feihong9487/WRO2026/簡報/簡報圖片/DSC02916-scaled-e1593505494115.jpg

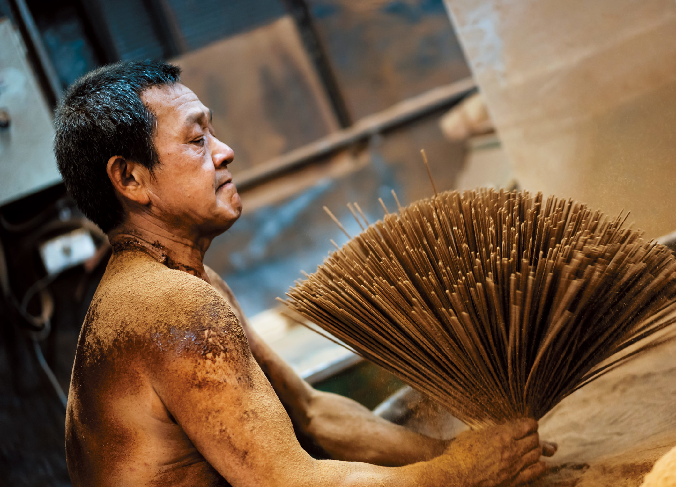
簡報/簡報圖片/DSC02916-scaled-e1593505494115.jpg
