feihong9487/WRO2026/簡報/Manus包_三張A1海報/圖表_情境照/86CD72FB487520FEE5B68408F628E1033E8C307C_size99_w1080_h721.jpeg

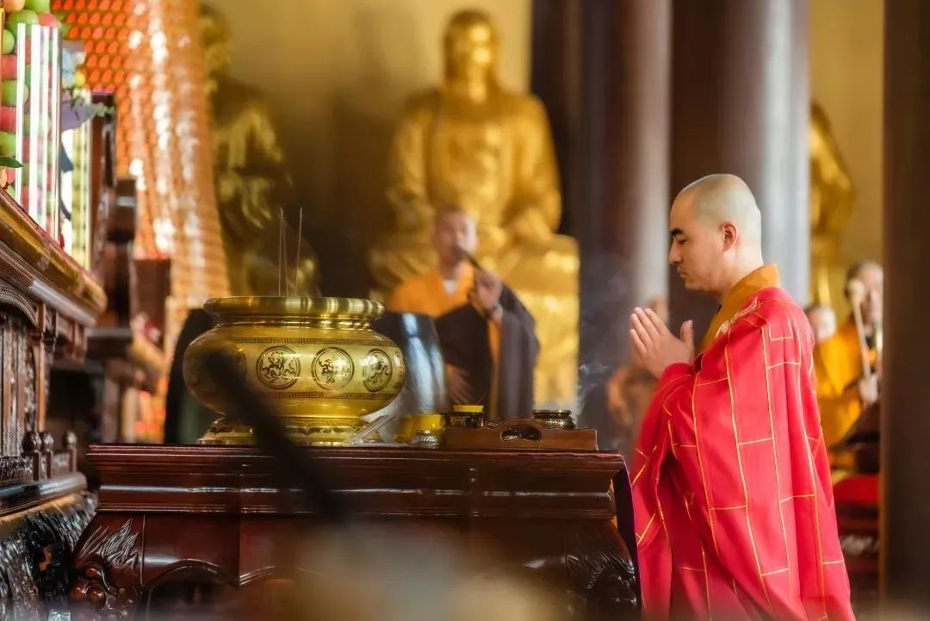
簡報/Manus包_三張A1海報/圖表_情境照/86CD72FB487520FEE5B68408F628E1033E8C307C_size99_w1080_h721.jpeg
