feihong9487/WRO2026/AI訓練/README.md

# AI訓練 — 模擬反應環境

> ★本目錄所有輸出皆為**模擬**，依 CLAUDE.md §7 誠實一致性，任何數字
> 不得寫成實測結果，展示與報告必須標示「模擬環境」。★

實作研究日誌第 17 週「四層解耦」架構的 **L3（0-D 質量平衡＋煙羽擴散）
＋ L4（訓練介面）**。CFD 屬 L1、離線做罩體幾何比選，**不進訓練迴路**
（D15：CFD-in-the-loop 需 913 年；F7：BFS 環境梯度為零已被否決）。

## 檔案

| 檔案 | 內容 |
|---|---|
| `sim_config.py` | 全部參數（單一真相來源；EST＝未實測估計，附域隨機化範圍） |
| `plume.py` | **線香煙霧擴散模型**：煙羽上升 w∝N^⅓（第 17 週 Zukoski）、擴張錐 db/dz=0.14（第 20 週）、橫流偏移＋側裙衰減（B8）→ 幾何×速度推導捕集率 η |
| `visitors.py` | 日曆驅動香客負載（初一/十五、週末、節慶、進香團；近似農曆） |
| `plant.py` | 近場/遠場雙區質量平衡＋CO2＋爐溫＋安全聯鎖（同 R4 韌體行為） |
| `incense_env.py` | gym 風格 `reset()/step()`＋感測器模型＋第 15 週損失函數＋`DualAscent` 對偶上升 |
| `baselines.py` | 基線：定速／實機 FSM 忠實移植／PID（**無基線則無法宣稱 AI 有貢獻**，§5.2 第 8 項） |
| `run_demo.py` | 四種基線跑 7 天的對照表 |
| `驗證環境.py` | 自檢：解析錨點、煙羽對表、跨層常數一致、F7 梯度檢驗、資源限制、誠實檢查 |
| `文獻參數.md` | **文獻校正對照表**（Jetter 2002 排放因子、Persily 2017 CO₂、沉降率、MTT 擴張率、PMS 偏差——各附出處與證據等級） |
| `模型方案.md` | 三案模型方案＋**凍結評估協定**（2026-08-16） |
| `policies.py` | 部署級推論（純 stdlib）：A 線性、C MLP、B 預測+DP、強基線日曆規則 |
| `訓練A.py` / `訓練B.py` / `訓練C.py` | 三案訓練器（筆電端可用 numpy；產物一律 JSON 到 `models/`） |
| `評比.py` | 凍結協定的執行檔（10 驗證 seed × 3 天 × 域隨機化） |
| `驗證線上學習.py` | 線上學習服務自檢：特徵同構（vs Pi 端 ShadowAdvisor）、守門條款、異常偵測單元檢查 |
| `外部資料驗證.py` | UCI 864 公開資料集對兩 AI 核心機制之獨立驗證（V1 pass／V2 inconclusive／V3 pass） |
| `加速實驗.py` | 真實資料模型擴充四實驗：E2 部署版 ridge 勝挑戰者、E3 模擬先驗幫倒忙、E4 故障注入靈敏度、粒度 A/B（30 分鐘粒度 −7.7% MAE，已升級進服務） |
| `ACH反演.py` | 真實 CO₂ 衰減段反演換氣率：8 段中位 1.21/h（居家資料推估非實測；同數學已進線上服務 v5 的通風追蹤） |
| `訓練C_v4.py` / `訓練C_v4b.py` | C 案算力實驗：×24 算力塌縮（v4）→ 熱啟動修正僅雜訊級改善（v4b）→ 維持 v3；結論見《優化實驗_C案算力.md》 |

## 快速開始

```bash
python 驗證環境.py     # 先自檢（任何修改後都要重跑）
python run_demo.py     # 基線對照
python run_demo.py --dr  # 域隨機化版
```

訓練迴圈骨架（純介面示意；RL 套件自選，環境本身零相依）：

```python
from incense_env import IncenseEnv, DualAscent

env = IncenseEnv(randomize=True)          # 域隨機化＝第 19 週 sim-to-real 對策
dual = DualAscent(["noise", "h_vis"], alpha=0.5)
for episode in range(n_episodes):
    obs, done = env.reset(seed=episode), False
    g_sum = {"noise": 0.0, "h_vis": 0.0}; steps = 0
    while not done:
        a = policy(env.obs_vector(obs))          # 只准看 obs（感測值）
        obs, r, done, info = env.step(a)
        loss = -r + dual.penalty(info["g"])      # 硬約束走對偶罰項
        for k in g_sum: g_sum[k] += info["g"][k]
        steps += 1
        # ...存 (obs, a, -loss) 進 replay buffer...
    dual.update({k: v / steps for k, v in g_sum.items()})   # λ ← max(0, λ+αḡ)
```

## 風扇規格（2026-08-16 使用者指定）

訓練調控風扇＝**建準 SUNON 4020**（40×40×20 mm、DC12V、PWM、磁浮軸承），
**安裝於罩口**。未指定型號檔位——`sim_config.py` 以家族典型中值建模
（工作點風量 12 m³/h、全速約 30 dBA、約 1 W、最低啟轉 duty ≈10%），
全部標 EST，拿到 datasheet 與 P–Q 實測（§5.2 實驗 1）後回填。
4 線 PWM 直控順帶解掉兩個舊待辦：490 Hz 嘯叫（PWM 走控制線非電源線）
與轉速回授（FG/tach 線）。

**此規格帶來的政權變更**（模擬已反映）：磁浮扇全速 ~30 dBA « 45 dBA 上限、
最大面風速 0.13 m/s < 單支煙羽速度 0.40 m/s → **噪音與文化兩條硬約束
天然滿足、不再是主動約束**；「有香就全速」成為合法邊界解，
學習的價值轉移到**時間軸排程**：沒香該關（能耗/濾材/平滑）、
香要來該先開（初一十五與 CO2 前饋的預測性啟動）。

### ★設計張力（誠實記錄，非本目錄能解，需人決策）★

1. **風量缺口**：4020 工作點約 6–22 m³/h，D26 規格為 43.3 m³/h——
   模擬顯示單顆全速常開僅將超標時率 54.6%→48.7%（模擬值）。
   選項：接受較低 η／多顆並聯／保留 5015 鼓風機於濾箱、4020 只做罩口助抽。
2. **靜壓不足**：濾鏈初始壓損約 165 Pa（紗網 5＋HEPA 120＋活性碳 40），
   4020 軸流靜壓僅數十 Pa——**單靠 4020 推不動濾鏈**，若它是唯一風扇，
   過濾段需另行驅動或重新設計。
3. **D13 被推翻**：原決策「風扇置於過濾鏈之後（扇葉不吃香灰油煙）」；
   罩口安裝＝扇葉直接暴露於煙流與火星。磁浮軸承耐汙較佳但扇葉積垢
   仍在，且**金屬紗網（火星前濾）應前移到風扇之前**——FILTER_CHAIN
   順序紅線不動，但「紗網相對風扇的位置」需要重新拍板。
4. **面風速均勻性**：40 mm 扇盤對 180 mm 罩口，流場集中於中心——
   本模型的均勻面風速假設對此配置不確定度最大（§5.2 實驗 7 的量測項）。

## 設計要點（皆有日誌出處）

1. **損失函數＝第 15 週定義**：暴露線性（扣 C_bg、無閾值）＋超標二次；
   能耗 u³（風扇相似定律）；濾材 u（壽命∝總風量）；平滑 Δu²（變動噪音
   比穩定噪音更干擾）。
2. **文化與噪音是硬約束**（D11）：h_vis ≥ h_spec 與 SPL ≤ 45 不進權重，
   違反量走 `info["g"]`，由 `DualAscent` 處理——把它們改成固定權重
   ＝重犯日誌已否決的錯誤。
3. **策略只看感測值**：`obs` 含雜訊、5 s 更新、延遲與失聯；真值在 `info`
   只准診斷。近場濃度**沒有感測器**——跟實機一樣。
4. **安全聯鎖屬於環境**：CO2>1500→全速、超溫→停機（同韌體），策略蓋不過；
   訓練出的策略必須在聯鎖存在下仍表現好。
5. **域隨機化**（第 19 週）：η、排放因子（7–100 log-uniform）、ACH、C_bg、
   感測延遲，加上煙羽（db/dz、源徑）與橫流／側裙（SKIRT_ATTEN 下探 1.0
   ＝側裙完全失效的 B8 惡夢情境）。**策略不得依賴任一估計值的精確度。**

## 有限資源訓練（2026-08-16 使用者裁示）

AI 在**有限電量與算力**下訓練反應策略：

- **電量**：`ENERGY_WH_DAY`（預設 4 Wh/日）——4020 全速 1 W，預算只夠
  全速 4 小時；耗盡則風扇物理斷電（CO₂ 警報也吹不動），午夜重置。
  電量剩餘比例在 obs（`battery`）。這使「有香就全速」不再可行，
  策略必須把 Wh 分配到暴露削減報酬最高的時段（尖峰排程問題）。
  市電情境設 `ENERGY_WH_DAY = None` 即回到無限電量。
- **算力**：屬訓練紀律而非物理模型——策略必須能在 Pi 5 以 1 Hz 推論
  （查表／線性／小型網路，參數量 <10⁴），obs 維持 11 維精簡向量；
  R4 本地 FSM 的降級路線不受 AI 影響（Pi 失聯照樣接手）。

## 誠實承諾（第 19 週，預先寫下）

> 若 RL 未優於 PID／FSM 基線，**接受此結果並如實報告**。
> 「證明簡單方法已足夠」是有效的工程結論，勝於勉強宣稱。

## 實測後要回填的參數（對照 §5.2 實驗清單）

| 實驗（§5.2） | 回填 `sim_config.py` |
|---|---|
| 0 側裙橫流衰減 | `SKIRT_ATTEN`、`U_CROSS_MEAN` |
| 1 風扇 P–Q（4020 實測） | `Q_MAX_M3H`、`FAN_MIN_DUTY`、`FAN_P_MAX_W`（現為家族典型值） |
| 2 煙羽擴張率 | `DB_DZ` |
| 3 爐盆有效源徑 | `DS_M` |
| 4 特性曲線 η/h/SPL | `ETA_GEO`、`ETA_A`、`SPL_*`、`plume.h_visible` |
| 6 排放因子 | `EF_MG_PER_STICK` |

回填實測值時同步收窄 `RAND_RANGES`（量過的參數不確定度變小），
並在本 README 記錄日期與出處——這是 `*_MEASURED` 紀律在模擬端的對應。
