feihong9487/WRO2026/待辦_DS18B20部署.md

# DS18B20 上線進度與待辦（2026-08-12）

> DS18B20 接在 R4 的 **A2 埠**，正式韌體已燒錄、實機確認有值。
> 剩下 Pi 端與雲端兩步沒做完，資料還上不了儀表板。

---

## 背景：08-12 的 R4 卡死事件

- telemetry 自 **08-11 21:40** 中斷，Pi 的 `pi_fsm.py` 之後每秒回報 `SENSOR_STALE`
- USB 枚舉還活著（`/dev/ttyACM0` 仍在），所以 `usb-watchdog` 沒觸發——
  它只檢查裝置存在，判不出「枚舉在但主迴圈死了」
- OLED 凍結＝整個主迴圈卡死（顯示、感測、telemetry 同一個 loop）
- 已由使用者手動修復並重燒韌體

## 已完成

| 項目 | 狀態 |
|---|---|
| 韌體 `R4/matrix_mini_r4/matrix_mini_r4.ino` 加 DS18B20（A2 埠、1 Hz 非同步、JSON 欄位 `t_ds`、OLED 顯示） | ✅ 已燒錄、實機有值 |
| 筆電端 `PI5/pi_fsm.py` 轉發白名單加 `t_ds` | ✅ 改好（僅筆電副本） |
| `cloud_dash/dashboard_aroma01_public.json`＋`grafana_dashboard_fleet.json`：爐面溫度 stat＋timeseries 改查 `sensor`/`t_ds`，標題改「爐面溫度（DS18B20）」 | ✅ 改好（僅本機檔案） |
| `驗證韌體.py`／`驗證資料流.py`／arduino-cli 編譯 | ✅ 全過 |

接線註記：DS18B20 **不能插 D1**——D1 左（腳 3）是風扇 PWM、右（腳 2）是
MAX6675 CS；函式庫 `MXOnewireDT` 用埠的左腳。A1/A2 是僅存空埠。
aroma02 是模擬機、沒有 `t_ds`，儀表板未動。

## ★待辦（照順序）★

### 1. ✅ 更新 Pi 上的 `pi_fsm.py`（2026-08-18 確認完成）

- 筆電公鑰已裝進 Pi，`ssh root@100.88.179.95` 金鑰登入可用
  （feihong@＋密碼其實也通，之前寫的「denied」已過時）
- Pi 上 `/opt/incense/pi_fsm.py` 與筆電版 MD5 一致（`92e42269…`），
  不需再 scp——先前某次已部署過
- 實測 MQTT `incense/sensor` 每秒有 `t_ds`（約 31°C），InfluxDB 查得到

### 2. 雲端 Grafana 重新匯入兩份 JSON（**未完成：家裡 PC 連不上**）

- 位置：家裡 PC 的 Grafana `http://100.73.36.75:3000`（WSL 容器）
- 2026-08-18 嘗試時整台逾時——PC 沒開機或 Tailscale 掉了，開機後再做
- `admin` 登入 → Dashboards → Import → 上傳
  `cloud_dash/dashboard_aroma01_public.json` 與 `grafana_dashboard_fleet.json`
  → 勾「覆蓋既有」（uid 相同，公開連結不會失效）
- 密碼由使用者保管

### 3. ✅ Pi 本地 Grafana（2026-08-18 完成）

- `PI5/grafana_dashboard_incense.json` 已把「爐面溫度」stat＋timeseries
  改查 `sensor`/`t_ds`（比照雲端版），經 API 匯入 Pi Grafana 覆蓋 `incense-main`
- 用面板同款 Flux 查詢驗證：`t_ds` 最新值 31.12°C ✓
- 面板實際顯示畫面需由人開 `100.88.179.95:3000` 目視確認

---

_只剩待辦 2：家裡 PC 開機後匯入兩份雲端 JSON，公開面板的「爐面溫度（DS18B20）」就會有資料。_
