feihong9487/WRO2026/軟硬體優化報告書.md

# 軟硬體優化報告書

> 2026-08-16。與《後續研究與優化方向建議書》分工：那一本管**研究與量測**
> （做什麼實驗、怎麼發表），本書管**工程優化**——現有軟硬體哪裡可以改、
> 怎麼改、代價與效益。每項標註出處（B 編號＝日誌 §5.1 阻塞表）。
> 標【拍板】者屬設計取捨，需人決定，本書只列選項。

---

## 第一章｜硬體優化

### 1.1 抽排與風扇（最高優先，對應 B10）

**現況**：SUNON 4020 磁浮 PWM 已定為罩口調控風扇；但工作點約 12 m³/h
對規格 43.3 m³/h 有缺口、靜壓推不動 165 Pa 濾鏈、且與 D13「風扇置濾後」
矛盾（扇葉暴露於煙流火星）。

| 優化項 | 做法 | 效益 | 代價 |
|---|---|---|---|
| **雙級抽排架構**【拍板】 | 4020 於罩口做「捕集助抽」＋既有 5015 鼓風機於濾箱做「主抽過濾」——4020 負責把煙送進罩、5015 負責推過濾鏈 | 同時解決風量缺口與靜壓不足；AI 控 4020、5015 隨動或定速 | BOM +1 風扇、兩路控制（韌體現僅 1 路 PWM，見 2.1） |
| 金屬紗網前移至 4020 之前 | 罩口即裝紗網（FILTER_CHAIN 順序不變，僅位置前移） | 火星不進扇葉；4020 積垢減緩 | 罩口開口阻力略增；紗網清潔頻率提高 |
| 4020 型號檔位選定 | 取 datasheet 的 P–Q 曲線與啟轉 duty，回填 `sim_config.py` 並收窄隨機化 | 模擬與訓練精度直接提升 | 零成本，只差型號資訊 |
| 面風速均勻化導流 | 40 mm 扇盤對 180 mm 罩口，於罩內加十字導流肋或擴壓錐（3D 列印件） | 提高有效捕集面積（目前模型最大不確定處） | 需一輪列印迭代＋發煙目視 |

### 1.2 罩體與側裙

- **罩口 200→215 mm**【拍板，B9】：橫流餘裕 +23%＋ACGIH 合規；
  代價整機 +15 mm、阻力 +38 Pa。建議等側裙 mockup 數據一起定。
- **側裙迭代**（B8，全案最高風險）：紙板 mockup 先行；若衰減不足依序
  試（a）加高／改角（b）罩口放大（c）可拆擋風簾。
- **可製造性**：34° 自撐倒錐已驗證；下一步把側裙也收斂到免支撐角度。

### 1.3 濾鏈

- 壓損實測（初期／壽末）→ 定換濾週期與雙級架構的 5015 工作點。
- 活性碳突破曲線實驗 → 「按狀態換」訂閱的科學依據（詳建議書第 2 項）。
- 濾箱氣密檢查制度化（D13 抽拉式的前提）。

### 1.4 感測

- **Grove 2.0 mm 轉接線**（B1）：到貨即解 SCD41——所有真實資料的閘門。
- **PMS5003 到貨後**：與重量法共檢建立校正斜率（模擬已依文獻改為
  雙向 0.5–1.5×，實測後收窄）。
- **近場感測缺口**：獎勵主項（爐邊暴露）目前不可觀測。可評估在罩緣
  加第二顆低成本 PM 感測器——sim-to-real 最脆的一環直接補上。
- **電流計量（INA219 一顆 ~50 元）**：讓「電量預算」從軟體推估變實測
  ——AI 的 battery 觀測落地成真值，且順帶得到風扇健康監測（堵轉電流）。

### 1.5 電源與能源

- 官方 27W 電源採購（F18 根治）。
- **能源預算的情境定義**【拍板】：4 Wh/日是訓練用假設。實務是
  （a）市電＋自主節能目標，或（b）電池/太陽能離網（遶境場景）？
  決定後回填 `ENERGY_WH_DAY` 並重訓。

### 1.6 電控

- **PCF8574 → 方案 B**（B4）：2 顆 D4184 接 Analog 1/2，少一塊板、
  少一條 I²C 匯流排風險。拍板前不採購。
- **4020 的 4 線 PWM 直控**：PWM 走控制線（25 kHz 規格內建）——
  嘯叫問題自然消失；FG 轉速線接回 R4 得真實轉速回授（風扇失效偵測
  從電流推斷升級為直接量測）。若採雙級架構，5015 仍走 D4184。
- 警報線維持主動低態開集極（D14）不動。

### 1.7 熱與安全

- 熱電偶實測近爐溫度 → 回填 `T_LOCK/T_RELEASE`（現為臨時值 150/130）。
- DS18B20 已上線：加入「感測器艙過溫告警」門檻（現況只記錄不判斷）。

---

## 第二章｜軟體優化

### 2.1 韌體（R4）

| 優化項 | 內容 | 出處 |
|---|---|---|
| **門檻重調** | 模擬證實殿堂尺度 CO₂ 斜率上限約 18 ppm/min，θ_ff=120 永不觸發、T1=+300 也偏鈍——桌面展示值與實場脫節。依燃燒艙／實場資料重定（θ_ff 量級應降至 5–15） | AI訓練 模擬發現 |
| 第二路 PWM | 雙級架構需要（4020＋5015 分控）；腳位盤點注意 D2/D3 不可用 | 1.1 |
| S1 啟轉下限 | 4020 啟轉 duty 實測後定 S1 值（模擬取 ~10%，家族規格 0–20%） | §5.5 |
| MQTT 帳密參數位 | `pi_fsm.py` 與韌體補上參數化位置（值由人保管不入檔） | §5.5 |
| 燒錄 | 板上仍是舊韌體（B3）——一切軟體優化的前提 | B3 |

### 2.2 Pi 軟體（pi_fsm.py）

- **模型載入接口**：讀 `models/*.json` 做推論（純 Python 前向已備於
  `AI訓練/policies.py`），三層安全鏈不動：模型異常→退 FSM 規則→
  Pi 失聯→R4 本地 FSM。
- **能源預算管理器**：battery 狀態（軟體推估或 INA219 實測）納入
  上報 JSON 與決策輸入。
- **版本上報**：韌體/模型版本進每秒 JSON → 儀表板可見機隊版本分布。
- **夜間重訓排程**：Pi 5（16GB）離峰時段以當日真實資料重訓 B 案
  預測器——資料飛輪的第一個實作。

### 2.3 AI 堆疊（本輪訓練的直接教訓）

1. **B 案特徵工程還有空間**：峰形基底＋交互項已把 MAE 從 9.71 降到
   6.38 支（常數基線 12.17）；下一步是「前一小時實際 CO₂」的
   自迴歸特徵（滾動修正從 heuristic 變成模型的一部分）。
2. **真實資料重訓管線**：aroma01 CO₂ 歷史 → 小時負載代理值 →
   重訓 predictor 並回報真實 MAE（合成→真實的遷移是宣稱的必要條件）。
3. **C 案（DQN）已知弱點**：γ=0.9995 信用視野 ~2 小時，對跨日預算
   規劃吃虧。若要補強：n-step return（n=64+）或把「今日已耗電量」
   直接做成 reward shaping。投入前先看評比——若 B 已贏，照第 19 週
   承諾收手。
4. **A 案（CEM）方法學修正已落地**：各代配置難度不同，分數跨代不可比
   ——已改存分布中心並以獨立 seed 評分；後續若擴參數量，改用固定
   配置集評分（common random numbers 全程共用）。
5. **評估協定維持凍結**：任何演算法改動都回到同一份 `評比.py` 對打，
   不得為結果調協定。

### 2.4 模擬環境

- **香客模型隨機化補洞**：日形狀（雙峰時刻/寬度）與初一十五倍率
  目前寫死——加入域隨機化，防策略學到模擬器怪癖。
- **真實 CO₂ 校正**：以 aroma01 歷史反推負載曲線形狀取代合成假設。
- **面風速非均勻模型**：導流設計（1.1）定案後，把「扇盤/罩口面積比」
  引入捕集模型。

### 2.5 雲端

- 儀表板明確標註模擬/實測分段（2026-08-08 01:15 分界寫進面板說明）。
- 新增欄位：battery/能耗、模型版本、濾材累積負載估計。
- 公開面板維持免登入唯讀（評審可掃 QR）。

---

## 第三章｜優先序（投入 × 效益）

| # | 項目 | 投入 | 解鎖 |
|---|---|---|---|
| 1 | Grove 轉接線＋重燒韌體＋部署 pi_fsm（B1/B2/B3） | <1 天 | 所有真實資料 |
| 2 | 4020 datasheet＋P–Q 實測 | 1 晚 | 模擬精度、雙級拍板依據 |
| 3 | 側裙紙板 mockup（B8） | 1 週末 | 罩口 200/215、整機外形 |
| 4 | 門檻重調（θ_ff、T1） | 半天（需 1 的資料） | FSM 從展示值變實用值 |
| 5 | 雙級抽排架構拍板＋第二路 PWM | 2–3 天 | 風量缺口＋靜壓問題一次解 |
| 6 | INA219 電流計量 | 半天 | 電量真值＋風扇健康監測 |
| 7 | B 案自迴歸特徵＋真實資料重訓 | 1–2 天（需 1） | AI 貢獻的實證敘事 |
| 8 | 近場第二顆 PM 感測 | 1 天（待採購） | sim-to-real 最脆環節 |

**依賴關係**：1 → 4 → 7；2 → 5；3 → 罩體定案。第 1 項仍是一切的閘門。

---

## 附錄｜與其他文件的對照

| 主題 | 本書 | 其他文件 |
|---|---|---|
| 量測實驗清單 | 只引用 | 《後續研究與優化方向建議書》第一章、日誌 §5.2 |
| 4020 四張力 | 1.1 展開為方案 | 日誌 B10、`AI訓練/README.md` |
| AI 模型三案與評比 | 2.3 引用結論 | `AI訓練/模型方案.md`（含凍結協定） |
| 拍板清單 | 標【拍板】處 | 建議書第九章（D-1〜D-7）＋本書新增雙級架構、能源情境 |

> 本書所有「模擬顯示」的數字皆為模擬值；所有效益描述在實測前
> 均為設計預期，不得寫成已驗證成效。
