feihong9487/WRO2026/P0接線與驗證指南.md

# 智慧香爐 P0 桌面點亮 — 接線與驗證指南

對應《實作交接文件》§7 里程碑 P0（三板通訊打通）＋ 半個 P1（FSM 雛形在真實 CO₂ 數據下閉環）。

本次元件：SCD41、GY-SHT31-D、MAX6675＋K 型熱電偶、5015 渦輪風扇 12V 0.2A（2P XH2.54）、MATRIX Mini R4、Raspberry Pi 5。

> ## 🔄 2026-08-02 架構變更：三板 → 兩板
>
> 控制器實際為 **MATRIX Mini R4**（基於 Arduino UNO R4 WiFi，內建 I²C 埠）。
> 感測改由控制器直接讀取，**取消獨立的 ESP32-S3 開發板與整條警報線**。
>
> | 項目 | 三板版（本文多數章節） | 兩板版（現行） |
> |---|---|---|
> | 感測器 | 接 ESP32-S3 的 GPIO8/9，3.3 V | Grove 線直插 I²C1／I²C2 埠，**5 V** |
> | 警報線 | S3 GPIO4 → R4 A0（類比判位） | **取消**——感測與安全同在一顆 MCU |
> | 熱電偶 | R4 D7/D5/D6 | **D4 埠(13,10) ＋ D1 埠(2)** |
> | 風扇 PWM | R4 D9 | **D1 埠(3)** |
> | 麵包板 | 需要 | **不需要**（只剩兩個模組跳線） |
> | 韌體 | `ESP32/s3_sensor_node/` ＋ `R4/r4_actuator_node/`（2026-08-07 已刪，見 git 歷史） | `R4/matrix_mini_r4/` |
>
> **★ 不可使用 D2、D3 埠 ★**：`MiniR4.begin()` 內執行
> `PS2.config_gamepad(11, 4, 12, 5)`，把腳 11／4／12／5 配給手把介面。
>
> **現行接線請看**《電路設計/接線圖.html》與《電路設計/麵包板接線圖.html》。
> 本文以下章節的 §2 接線、§5 第 1／3 關屬三板版，保留作為設計歷程；
> §5 第 2／4／5／6 關的驗證邏輯兩版通用。

---

## 0. 今天要達成什麼

1. 三條通訊全通：S3 →(WiFi/MQTT)→ Pi →(USB 序列)→ R4，外加 S3 →(GPIO 警報線)→ R4 的直達旁路。
2. 所有感測器讀值正常（CO₂、雙溫濕度、爐溫）。
3. FSM（S0 待機 / S1 常態 / S2 高峰 / S3 異常）用真實 CO₂ 數據跑起來，風扇隨狀態變速。
4. 降級階梯實測：Pi 失效 → S3 維持基本抽排；S3 失效 → R4 聯鎖仍保安全。
5. 每秒一筆可重演的 JSON Lines 決策紀錄。

## 1. 備料檢查（先看這裡）

| 項目 | 狀態 | 說明 |
|---|---|---|
| D4184 MOSFET 模組 | ⚠️ 你的清單沒列 | 2P 風扇必須經它做 PWM，BOM 有編列。沒有 → 跳過 §2.3 與驗證第 2 關的風扇部分 |
| 12V 電源（12V2A） | ⚠️ 你的清單沒列 | 只給 MOSFET/風扇用，BOM 有編列 |
| ~~10kΩ 電阻 ×1~~ | 兩板版不需要 | 警報線取消，下拉電阻一併取消 |
| Grove 線 ×2 | 隨 MATRIX 套件 | 接 I²C1／I²C2 埠，一條含 5V/GND/SDA/SCL |
| SCD41 取代 MH-Z19B | ✅ 可行且更好 | I²C 介面、±(40ppm+5%)、附送溫濕度。依「誠實一致性」原則，記得更新報告 BOM 與 3-10 |

> 🔴 **2026-07-31 設計更正（三板版歷史紀錄）**：原設計把警報線接到 R4 的**數位腳 D2**，經規格書驗證**行不通**。
> UNO **R4** Minima 用 Renesas RA4M1，數位輸入高位門檻 V<sub>IH</sub> = 0.8 × V<sub>CC</sub> = **4.0V**，
> S3 只輸出 3.3V，不足 0.7V。（舊款 UNO **R3** 的 ATmega328P 門檻是 3.0V，所以網路上
> 「3.3V 直接接 Arduino 沒問題」的經驗不適用於 R4。）
>
> **當時的解法：改接類比腳 A0**——類比輸入量測範圍 0–5V，3.3V ≈ 675/1023，可靠分辨。
>
> **2026-08-02 後此問題已不存在**：兩板架構取消了整條警報線。
> 但 **RA4M1 數位輸入 V<sub>IH</sub> = 4.0V** 這個結論仍然重要——
> 日後若有任何 3.3V 訊號要接進這塊板子的數位腳，都會遇到同樣問題。

SCD41 更新週期是 **5 秒一筆**（硬體特性），所以「感測取樣 1 Hz」在 CO₂ 這一路實際是 0.2 Hz；SHT31 與系統心跳仍為 1 Hz。這點寫報告時照實標註即可（PM 感測到貨後 1 Hz 沒問題）。

## 2. 接線

### 2.0 拓撲

```
          WiFi / MQTT                USB 序列
ESP32-S3 ─────────────→  Pi 5  ─────────────→  R4 Minima
   │                                              ↑
   └── GPIO4 ─────────────────► A0 ────────────────┘
       3.3V  警報線（直達，不經 Pi）  類比判位
 (SCD41 + SHT31)                        (MAX6675 + 風扇MOSFET)
```

### 2.1 ESP32-S3（感測層）

SCD41 與 SHT31 掛同一條 I²C 匯流排。位址 SCD41=0x62、SHT31=0x44，不衝突。GY 系列模組板上已有上拉電阻，不必外加。

| 模組腳位 | ESP32-S3 |
|---|---|
| SCD41 VDD | 3V3 |
| SCD41 GND | GND |
| SCD41 SDA | GPIO 8 |
| SCD41 SCL | GPIO 9 |
| SHT31 VIN | 3V3 |
| SHT31 GND | GND |
| SHT31 SDA | GPIO 8（與 SCD41 並聯） |
| SHT31 SCL | GPIO 9（與 SCD41 並聯） |
| GPIO 4 | 警報線 → **R4 的 A0**（類比腳，不是 D2；原因見 §2.2） |

兩顆感測器都吃 3V3，不要接 5V。

### 2.2 Arduino R4 Minima（機構／安全層）

| 模組腳位 | R4 |
|---|---|
| MAX6675 VCC | 5V |
| MAX6675 GND | GND |
| MAX6675 SCK | D7 |
| MAX6675 CS | D5 |
| MAX6675 SO | D6 |
| MAX6675 K+ / K− | 熱電偶兩線鎖進端子 |
| **A0** | ← S3 GPIO4（警報輸入，**類比判位**） |
| **A0** | 另接 10kΩ 電阻到 GND（下拉） |
| D9 | → D4184 PWM/TRIG |
| USB | → Pi 5 的 USB 埠 |

**為什麼警報線接類比腳 A0 而不是數位腳 D2**

R4（RA4M1）數位輸入判定 HIGH 需要 V<sub>IH</sub> = 0.8 × V<sub>CC</sub> = **4.0V**，
S3 只輸出 3.3V，規格上讀不到。改用類比腳就沒有這個門檻問題：

```
S3 拉高 3.3V  →  analogRead(A0) ≈ 675 / 1023
S3 放開 0V    →  analogRead(A0) = 0
韌體門檻       →  > 500 判警報、< 300 才解除（軟體遲滯，防雜訊抖動）
```

兩側餘量都很大，而且**不需要買任何額外元件**。

**S3 斷電時**：GPIO4 高阻抗 → 10kΩ 下拉把 A0 拉到 0V → 判定無警報 → R4 回 FALLBACK，
與 §5 第 6 關要求的降級行為一致。

**重要：絕不可對 A0 啟用內部上拉（`INPUT_PULLUP`）。** 5V 會經上拉倒灌進不耐 5V 的 S3 腳位，
且讀值完全失真。韌體用 `pinMode(A0, INPUT)`。

熱電偶極性：加熱時讀值反而「下降」＝ K+/K− 接反，兩線對調即可。

### 2.3 12V／風扇（有 D4184 才接）

| 連線 | 說明 |
|---|---|
| 12V 變壓器 + / − | → D4184 VIN+ / VIN− |
| 風扇紅線（XH2.54） | → D4184 OUT+ |
| 風扇黑線 | → D4184 OUT− |
| D4184 訊號排針 PWM(TRIG) | ← R4 D9 |
| D4184 訊號排針 GND | ← R4 GND |

風扇是無刷含內部電路，直接功率端 PWM 可行；低轉速有嘯叫聲屬正常（見疑難排解）。保險起見可在風扇兩端反向並一顆 1N4007/1N5819（負極環朝 +）。

### 2.4 電源與共地（最常翻車的一條）

- S3、R4 各用一條 USB 供電；正式跑時 R4 的 USB 插 Pi（燒錄時插電腦即可）。
- Pi 5 用官方 27W 供電器，餵 S3＋R4 綽綽有餘。
- 12V 只進 MOSFET 模組，**不可**碰到 3V3/5V 排。
- 麵包板拉一條「地線母排」：12V 負極、R4 GND、S3 GND 全部接上（Pi 經 USB 已共地）。**警報線沒共地就完全不會動作。**

上電順序：① 目視確認 12V 排沒短到低壓排 → ② 先只上 USB 測感測與通訊 → ③ 最後上 12V 測風扇。

## 3. 軟體安裝

### 3.1 Arduino IDE（電腦端）

開發板管理員安裝兩個板包：

- `esp32` by Espressif Systems → 板子選 **ESP32S3 Dev Module**，Tools → **USB CDC On Boot: Enabled**（沒開就看不到序列輸出）
- `Arduino UNO R4 Boards` → 板子選 **Arduino UNO R4 Minima**

程式庫管理員安裝四個：

| 程式庫 | 用於 |
|---|---|
| SparkFun SCD4x Arduino Library | SCD41 |
| Adafruit SHT31 Library（會自動帶 Adafruit BusIO） | SHT31 |
| PubSubClient（Nick O'Leary） | MQTT |
| MAX6675 library（Adafruit） | 熱電偶 |

### 3.2 Raspberry Pi 5

```bash
sudo apt update
sudo apt install -y mosquitto mosquitto-clients python3-paho-mqtt python3-serial
# mosquitto 2.x 預設只聽 localhost，必須開區網監聽，否則 S3 連不上：
sudo tee /etc/mosquitto/conf.d/local.conf >/dev/null <<'EOF'
listener 1883 0.0.0.0
allow_anonymous true
EOF
sudo systemctl enable --now mosquitto
sudo systemctl restart mosquitto
hostname -I    # 記下第一個 IP，填進 S3 程式的 MQTT_HOST
```

（`allow_anonymous true` 僅限自家區網實驗；到廟裡實測前再加帳密。）

### 3.3 要改的參數

| 檔案 | 參數 | 改成 |
|---|---|---|
| s3_sensor_node.ino | WIFI_SSID / WIFI_PASS | 你的 WiFi（Pi 同一網段） |
| s3_sensor_node.ino | MQTT_HOST | Pi 的 IP |
| pi_fsm.py | SERIAL_PORT | 通常 `/dev/ttyACM0`，用 `ls /dev/ttyACM*` 確認 |

門檻類參數（CO2_ALARM_PPM、T1、SLOPE_TH、T_LOCK…）都集中在各檔案開頭，之後燃燒艙實驗再調。

## 4. 啟動順序

1. Pi：mosquitto 已在跑（§3.2）。
2. 燒錄 S3 → 開序列監控確認有輸出 → 之後隨便找個 USB 電源供電即可。
3. 燒錄 R4 → 先在電腦上做單板驗證（第 2 關）→ USB 改插 Pi。
4. 接好警報線與共地。
5. Pi 上執行 `python3 pi_fsm.py`。

注意：Arduino IDE 的序列監控和 pi_fsm.py 不能同時佔用同一個埠。

## 5. 驗證關卡（一切正常應該長這樣）

### 第 1 關：S3 單板

序列監控 115200，每秒一行 JSON：

```json
{"ts":123456,"co2":815,"slope":3.2,"t_scd":26.1,"rh_scd":58.2,"t_sht":25.6,"rh_sht":57.9,"conf":1.0,"alarm":0}
```

| 操作 | 預期 |
|---|---|
| 靜置 1 分鐘 | co2 = 室內基線 500–1200 ppm（戶外約 420）；co2 每 ~5 秒才更新一次是正常的 |
| 對 SCD41 呼一口氣 | 5–15 秒內 co2 飆到 2000+，slope 轉為大正值 |
| 比對 t_scd vs t_sht | 差 <2°C → conf=1.0（雙感測交叉驗證雛形）；兩者都可能比真室溫略高 0.5–1.5°C（自熱），屬正常 |
| 用手包住 SHT31 | t_sht 緩升、rh_sht 上升 |
| 沒接 Pi 的狀態下 | 開機約 10 秒後 alarm 變 1（判定 Pi 失效）— 這是設計行為，不是 bug |

### 第 2 關：R4 單板（USB 接電腦）

每秒一行狀態：

```json
{"t_furnace":26.50,"fan":80,"alarm":0,"interlock":0,"tc_fault":0,"mode":"FALLBACK"}
```

| 操作 | 預期 |
|---|---|
| 靜置 | t_furnace ≈ 室溫 ±3°C（MAX6675 冷端補償誤差），解析度 0.25°C |
| 指尖捏住熱電偶尖端 | 升 2–5°C |
| 熱電偶尖端加熱到 >150°C | interlock:1、fan 強制 0、板上 LED 快閃 |
| 自然冷卻到 <130°C | interlock 自動解除（遲滯正確） |

> ⚠️ **2026-08-02 起熱水測試法失效**：門檻由 80/60 提高為 150/130（見下方說明），
> 沸水只有 100°C 已無法觸發。改用下列任一方式：
> - **熱風槍**低溫檔對著熱電偶尖端（最方便，溫度好控制）
> - **烙鐵**尖端輕觸（升溫快，注意別燙壞熱電偶接點）
> - **暫時把 `T_LOCK` 改回 90°C 燒錄一次**做遲滯邏輯驗證，測完改回——
>   這只驗證「邏輯對不對」，不驗證「門檻值對不對」

**為什麼門檻從 80/60 改成 150/130**

交接文件 §7 把熱電偶懸於爐面上方 2–3 cm，該處**預估** 120°C。原本 80°C 的聯鎖門檻
低於正常工作溫度，一點香就會持續觸發聯鎖、風扇被鎖死在 0（聯鎖優先權高於一切）。

**這 150/130 是臨時值，沒有實測依據**——只是「先讓系統跑起來」。
`mech_params.py` 的 `T_LOCK_PROVISIONAL = True` 追蹤這件事，
實測熱電偶位置的真實溫度後必須重定，報告在那之前不得將此門檻描述為已驗證的安全設定。
| 鬆開端子拔掉熱電偶 | tc_fault:1、fan 強制 0（感測失效 → 安全態） |
| 序列監控手動輸入 `FAN 200` | mode 變 PI、風扇轉快；`FAN 60` 慢轉或不轉（記下最低啟動 duty）；`FAN 0` 停 |
| 停止輸入 5 秒 | mode 回 FALLBACK、duty 80（看門狗正確） |

### 第 3 關：警報線（不經 Pi 的直達旁路）〔三板版・兩板版不適用〕

> ⚠️ **兩板版請跳過本關**——警報線已取消，CO₂ 硬警報改由控制器內部直接處理
> （韌體 `co2Alarm` 旗標，優先權高於 Pi 指令）。驗證方式：對 SCD41 呼氣把 co2 吹破 1500，
> 序列輸出的 `alarm` 應變 1 且風扇跳 255，全程不需要第二塊板子。

以下為三板版做法：S3、R4 都上電、共地接好。對 SCD41 呼氣把 co2 吹破 1500：

- S3 端 alarm 變 1（GPIO4 輸出 3.3V）
- 用三用電表量 R4 的 A0 對地應約 3.3V
- **1 秒內** R4 端 alarm:1、fan 跳 255 全速——即使 Pi 完全不在場

> 🔴 **本關的接法已更正**：舊版寫「S3 GPIO4 直接接 R4 **D2**，3.3V 是邊界值但實務上幾乎都過」，
> 該說法源自 UNO **R3**（ATmega328P，V<sub>IH</sub> = 3.0V）。UNO **R4** 的 RA4M1 門檻是 **4.0V**，
> 3.3V 規格上就不夠，**數位腳讀不到**。現改接**類比腳 A0**，零元件解決
> （詳見《電路設計/電氣驗證計算.md》§1）。
>
> ⚠️ 也**不要**改用 BSS138 雙向電平模組：它的 HV 側 10kΩ 上拉會讓「S3 斷電」時 R4 誤讀成
> 警報中、風扇鎖在 255，直接破壞第 6 關要驗證的降級行為。原因分析見同份文件 §1.4。

### 第 4 關：Pi 通訊

```bash
mosquitto_sub -t 'incense/#' -v    # 應每秒跳出 S3 的 JSON
ls /dev/ttyACM*                    # 應看到 R4（通常 ttyACM0）
python3 pi_fsm.py
```

終端每秒一行：

```
[S1] CO2= 812ppm 斜率=  +3.2/min 爐溫=26.5°C fan= 70 R4=PI
```

同目錄出現 `incense_log_YYYYMMDD_HHMMSS.jsonl` 且持續長大。

### 第 5 關：閉環演練（S0/S1/S2 + 前饋 + 遲滯）

| 操作 | 預期 |
|---|---|
| 靜置 | [S1]、fan 70 |
| 對 SCD41 連續呼氣 | slope > 120 ppm/min 或 co2 > 900 → [S2]、fan 220（CO₂ 前饋削峰雛形；因 SCD41 5 秒更新，反應約 ≤7 秒） |
| 通風靜置 | co2 < 800 且斜率回落 → 退回 [S1]（遲滯 T1'=800 < T1=900，不會抖動） |
| co2 < 600 持續 60 秒 | [S0]、fan 0（待機低耗） |
| 熱水觸發 R4 聯鎖 | Pi 顯示 [S3] 異常，聯鎖解除後自動回 [S1] |

用 log 時間戳可以直接量兩條規格：決策週期 1 s（相鄰紀錄間隔）、風扇響應 <2 s（狀態改變那筆 → fan_actual 跟上的那筆）。

### 第 6 關：降級階梯實兵演練（答詢招牌）

| 操作 | 預期 | 對應文件 |
|---|---|---|
| Pi 上 `sudo systemctl stop mosquitto`（或直接 kill pi_fsm.py＋斷 R4 序列） | ≤5 秒 R4 進 FALLBACK（duty 80）；≤10 秒 S3 判定 Pi 失效拉警報 → R4 fan 255 | 「Pi 失效 → S3 維持基本抽排」 |
| `sudo systemctl start mosquitto` 恢復 | S3 警報解除、R4 回 PI 模式 | 系統可自癒 |
| 直接拔掉 S3 電源 | 警報線被 10k 下拉歸零 → R4 回 FALLBACK，聯鎖與熱電偶保護照常運作 | 「S3 失效 → R4 聯鎖仍保安全」 |

六關全過 ＝ P0 完成、P1 過半。

## 6. 疑難排解

| 症狀 | 原因與解法 |
|---|---|
| S3 開機顯示 SCD41 或 SHT31 FAIL | 接線／位址問題。跑 Arduino 內建 I²C 掃描（File→Examples→Wire→WireScan，記得先 `Wire.begin(8,9)`），應同時看到 0x62 與 0x44 |
| 序列監控一片空白（S3） | Tools → USB CDC On Boot 沒設 Enabled |
| t_furnace 顯示 -99.9 / tc_fault:1 | 熱電偶沒鎖緊或斷線（-99.9 是 NaN 哨兵值） |
| 加熱時爐溫反而下降 | 熱電偶極性反了，K+/K− 對調 |
| 警報線吹不動 R4 | 依序查：① 沒共地（最常見）② **警報線接到 D2 而不是 A0**（數位腳門檻 4.0V，讀不到 3.3V）③ 下拉電阻沒接 ④ 韌體 `PIN_ALARM_IN` 沒改成 `A0`。可在序列監控印 `analogRead(A0)` 值：拉高應約 675、放開應為 0 |
| 拔掉 S3 電源後 R4 反而全速不停 | 你八成用了 BSS138 模組——它的 HV 側上拉會讓斷電時 A0 讀到 5V。本設計不需要任何電平轉換模組，直接接 A0 即可（見 §2.2） |
| mosquitto_sub 看得到、S3 卻連不上 | §3.2 的 listener 設定沒做，或 S3 與 Pi 不同網段 |
| 風扇低速嘯叫 | analogWrite 預設 PWM 頻率在可聽範圍，屬正常；介意再改用 R4 核心的 `pwm.h`（PwmOut）拉到 25 kHz |
| 風扇低 duty 不轉 | 無刷風扇有最低啟動占空比（常見 ~30–40%）；量產程式可先 255 kickstart 150 ms 再降速 |
| pi_fsm.py 開埠失敗 | 埠名不對（ls /dev/ttyACM*）、IDE 序列監控還開著、或權限：`sudo usermod -aG dialout $USER` 後重新登入 |
| CO₂ 基線怪異（如 400 以下） | SCD41 自動校正（ASC）需要每週見到新鮮空氣；燃燒艙實驗前依 §6「每輪前後校正」做強制校正（FRC，戶外 420 ppm 基準） |

## 7. 決策紀錄格式（可重演）

`pi_fsm.py` 每秒寫一筆，對齊交接文件 §3 的欄位精神：

```json
{"ts":"2026-07-30T14:03:21","co2":1420,"slope":260.0,"t_sht":26.2,"rh_sht":61.0,"conf":1.0,"s3_alarm":0,"t_furnace":27.25,"fan_actual":220,"r4_mode":"PI","interlock":0,"state":"S2","fan_duty":220,"action":"S1->S2"}
```

PMS5003 到貨後在同一筆追加 `pm_in / pm_out / pm_breath / co` 欄位即與 §3 完全一致（`post_readings` 原本預留給理香處置紀錄，該機構已於 2026-08-16 自設計移除，不再需要）。

## 8. 今天就能拍的證據（回饋報告 Technical +0.75）

1. 麵包板全景＋三板接線特寫（補 3-9／3-10 原型照）
2. S3 序列監控：呼氣後 co2 飆升那幾行（實機程式截圖）
3. R4 熱水觸發 interlock:1 的截圖（安全聯鎖證據）
4. pi_fsm.py 終端 [S1]→[S2] 切換畫面 ＋ jsonl 檔案內容截圖（3-12 可用實機截圖換掉虛擬碼圖七）
5. 有 12V 時：呼氣 → 風扇全速的短影片（前饋閉環動態證據）

依 §8 原則：這些是 P0/P1 通訊與控制鏈證據；H1–H3 的成效數字仍須等燃燒艙實測，之前一律稱「設計目標」。
