feihong9487/WRO2026/交接任務_筆電接手.md

# 交接任務:筆電接手(2026-08-11)

設備(Pi5+Pironman+R4)已關機帶往外地,桌機留在家。本檔給筆電上的下一個
工作階段,快速接上現況。細節都在《部署紀錄.md》的三個附錄(08-09〜10),
本檔只列「接手要知道的」和「還沒做完的」。

---

## 1. 設備現況(一句話版)

aroma01 已從壞掉的 SD 卡遷到 NVMe(Pironman 5 + WD SN750 SE 500G),
冷開機全自動就緒實測通過,比賽現場模式(手機熱點上雲)演練通過。

## 2. 外地開機 SOP

1. 插電(有官方 27W 最好;沒有就先湊合,但別跑重載)
2. 開手機熱點「我叫小phone今年9歲」——Pi 每 60 秒巡檢,看到熱點就自動跳上去
3. 等約 90 秒
4. **按 R4 的電源鍵**(內建電池設計,斷電後不會自己開——這是唯一手動步驟)

## 3. 筆電怎麼連上 Pi

筆電**還沒有** Pi 的 SSH 金鑰。兩條路:

- **A(建議)**:瀏覽器開 Raspberry Pi Connect(connect.raspberrypi.com,
  裝置名 `feihongPi5`)→ 開終端機 → 把筆電的公鑰塞進
  `/root/.ssh/authorized_keys`(桌機當時就是這樣做的)
- **B**:筆電裝 Tailscale(帳號 feihong9487)後 `ssh root@100.88.179.95`
  ——前提是金鑰已用 A 加好

Pi 的位址:Tailscale `100.88.179.95`(不隨網路變);熱點下區網 IP 是
`172.20.10.x`(會變,別依賴)。

## 4. 儀表板

| 用途 | 網址 |
|---|---|
| 評審看的雲端公開版(不用裝任何東西) | 見《部署紀錄.md》§2 的 Funnel 連結 |
| Pi 本地版(斷網備援) | `http://100.88.179.95:3000`,帳號 `admin`,密碼由使用者保管 |

**雲端版的前提:家裡桌機要開著**(WSL 容器+Tailscale)。桌機關機 → 雲端
儀表板停更,只剩本地版。橋接有 QoS1 佇列,斷線期間資料不丟,回線自動補傳
(補傳資料的時間戳是到達時間,見部署紀錄 N6 註記)。

## 5. ★未決事項:PCF8574 存廢(等使用者拍板)★

**2026-08-16 情勢更新:理香機構已整組自設計移除**(電磁鐵 ×4 連同插孔板、
套筒全拆,見 專案進度.md §3C)。PCF8574 上只剩 2 路負載(OUT5 霧化、
OUT6 罩內 LED),八路板過度設計的問題比 2026-08-10 分析時更明顯:

- **方案 B**(建議,理由更強了):改用 2 顆 D4184 接 Analog 1/2 孔,
  驅動霧化+罩內LED——零新零件種類(D4184 已在 BOM)、韌體更簡單、
  省掉 I2C3 一整條匯流排。
- **方案 A**:維持 PCF8574(現行電路圖/韌體照此畫,但只用 2/8 路)。

拍板後要動的檔案:`R4/matrix_mini_r4/matrix_mini_r4.ino`(致動段)、
`電路設計/kicad/佈線定義.py` + 重跑產生器、`電路設計/接線圖.html`。
**在拍板前,不要採購 PCF8574 板。**

## 6. 待辦(依優先序)

1. **官方 27W 電源**(採購)——低壓重置是 SD 卡的死因,根治靠這顆
2. §5 的方案拍板
3. 感測器接線(SCD41/SHT31/MAX6675)——照 `電路設計/接線圖.html` rev F
   的「無腦對照表」;接完 `-99.9` 會變真實讀值
   **▶ 2026-08-11 進行中,卡住:** SCD41 用杜邦線跳 I²C1 後,I²C 掃描
   在所有匯流排(Wire、Wire1 直通、mux ch0-7)都掃不到 0x62——電氣層
   根本沒接通。頭號嫌疑:**R4 的 Grove 座是 2.0mm 間距,杜邦頭是
   2.54mm,直插插不緊**。待使用者確認模組型式與逐腳對絲印,建議改用
   Grove 轉杜邦轉接線。掃描器結果:多工器 0x70 與板載 OLED 0x3D 正常,
   板子本身沒問題。
   **★注意:R4 上現在跑的是 `R4/i2c_scanner_temp/` 臨時掃描器★**
   (每 3 秒掃一輪,接對線立刻能驗)——接線解決後必須重燒
   `R4/matrix_mini_r4/`,別忘了。
4. ~~**R4 韌體重燒**~~ ✅ 2026-08-11 筆電完成(COM12 燒錄+序列實測通過)。
   筆電環境與桌機不同:草稿本在 `Documents\Arduino`(非 OneDrive)、
   BusIO 讓位補丁已重加在該副本、arduino-cli 在
   `C:\Users\feihong\Arduino IDE\resources\app\lib\backend\resources\`
5. R4 換一條 USB 線+帶備用(CDC 軟卡死兩次,線材頭號嫌疑;
   就算不換,Pi 端看門狗 v2 也會在一分鐘內自動救)

## 7. 驗證指令(筆電 clone 後就能跑,不用硬體)

```bash
python3 run_tests.py                      # 機構全部規則
python3 R4/matrix_mini_r4/驗證韌體.py      # 韌體靜態檢查
python3 PI5/驗證資料流.py                  # 欄位契約
cd 電路設計/kicad && python3 產生電路圖.py && python3 驗證電路圖.py
```
