feihong9487/WRO2026/專案進度.md

# 智慧香爐 — 專案進度紀錄

**最後更新**：2026-08-16
**用途**：跨會話的進度存檔。新會話接手時先讀這份，再看各章指向的細節文件。

---

## 0. 一句話現況

雲端中心站**已部署完成並上線**（12 項驗收全過、公開連結可用）；
**真爐 aroma01 已上線**（2026-08-08：R4 韌體燒錄完成、Pi5 佈建完成、
R4→Pi→雲端資料鏈全通，每秒 telemetry 入庫；感測器未接線故值為故障值；
aroma02 仍為模擬爐）。兩板合併架構已實機驗證。
下一步：感測器接線讓 `sensor_fault` 歸零，人工確認 Grafana 面板。

---

## 1. 資料夾結構

```
D:\WRO2026\
├─ cloud_dash\          雲端中心站（原名「雲端平台」）
│    cloud-docker-compose.yml / cloud-mosquitto.conf / cloud-telegraf.conf
│    grafana_dashboard_fleet.json / dashboard_aroma01_public.json / dashboard_aroma02_public.json
│    sim_burner.py / 多爐平台指南.md
├─ PI5\                 Raspberry Pi 5：決策層程式 ＋ Pi 本機監測層
│    pi_fsm.py / 驗證資料流.py / incense-fsm.service / provision.sh
│    docker-compose.yml / telegraf.conf / grafana_dashboard_incense.json
│    雲端監測平台指南.md
├─ R4\                  控制器韌體（Arduino 要求資料夾名 = .ino 檔名）
│    matrix_mini_r4\      ★現行★ 合併版：感測＋安全＋致動
│        matrix_mini_r4.ino / 驗證韌體.py
├─ 電路設計\            通電前驗證（2026-07-31 新增）
│    電氣驗證計算.md / 接線圖.html / 麵包板接線圖.html / README.md
│    kicad\            KiCad 電路圖＋產生器＋驗證腳本
├─ P0接線與驗證指南.md   跨三板通用文件
├─ 任務書_雲端中心站部署.md（原始委派紀錄，不修改）
├─ 部署紀錄.md          雲端部署的完整紀錄與 SOP
└─ 專案進度.md（本檔）
```

---

## 2. 已完成 ✅

### 2.1 雲端中心站（Windows 11 / WSL2）

12 項驗收（C1–C12）全數通過，詳見《部署紀錄.md》。

| 項目 | 狀態 |
|---|---|
| WSL2 Ubuntu 24.04 + systemd | ✅ |
| Docker Engine 29.6.2 / Compose v5.3.1 | ✅ |
| mosquitto + InfluxDB 2.7 + Telegraf 1.30 + Grafana 11.2 | ✅ 四容器 running |
| MQTT 帳號 `burner` / `telegraf`，認證生效 | ✅ |
| Grafana 資料來源 `InfluxDB-incense`（uid `dftmtpkivyadcb`） | ✅ |
| 儀表板 `incense-fleet` ＋ 兩份單爐版 | ✅ |
| 模擬爐 aroma01 / aroma02 資料入庫 | ✅ |
| Tailscale IP `100.73.36.75`、Funnel 公開網址 | ✅ |
| 3 個免帳密公開唯讀連結 | ✅ |

**存取網址**（完整清單見《部署紀錄.md》§2）：
- 本機 `http://localhost:3000`
- 內網 `http://100.73.36.75:3000`
- 公開總覽 `https://desktop-c8l8ri6-1.tail7920c6.ts.net/public-dashboards/cc49db3ec819404e84744cfd416cb043`

> ⚠️ 儀表板 JSON **正本在 `cloud_dash/`**，WSL 的 `~/incense-cloud/` 是工作副本。
> 在 Grafana 改了面板要記得匯出存回，否則 WSL 重灌就遺失。

### 2.2 Grafana 面板調校

踩到兩個 Public Dashboard 的平台限制並繞過：

1. **模板變數不生效** — `$device` 不會被代入，查詢直接失敗。
   解法：改用 `|> group(columns:["device"])` 依 tag 分組，或把爐號寫死進 Flux。
2. **文字型欄位在 stat 卡片顯示不出來** — `state`、`r4_mode` 永遠 No data。
   解法：Flux 用 `map()` 把文字轉數字（S0~S3 → 0~3、PI/FALLBACK → 1/0），
   再用數字鍵的 value mapping 顯示文字；`action` 改用 table 面板。

另依使用者要求：移除「目前狀態」卡片、拿掉「艦隊」用詞、圖例改繁體中文、
新增「R4 模式」與「事件/動作紀錄」面板。

### 2.3 檔案稽核修正（3 個真 bug）

| # | 檔案 | 問題 | 修正 |
|---|---|---|---|
| 1 | `cloud_dash/*.json` | 昨日所有儀表板修復只存在 WSL 家目錄，repo 內是壞的舊版 | 複製 3 份修復版回 repo |
| 2 | `R4/r4_actuator_node.ino` | `lastPiCmd=0` 導致開機頭 5 秒誤報 `mode:"PI"`、fan 0 | 新增 `piSeen` 旗標 |
| 3 | `PI5/雲端監測平台指南.md` §2 | 叫使用者手動加的 publish 行已內建，照做會產生重複資料 | 改寫為「已內建，勿重複加」 |

### 2.4 pi_fsm.py 補上 decision 發布

原本每秒的決策紀錄**只寫本機 JSONL，沒有發布到 MQTT**，導致真爐接上後
雲端只會收到 `sensor` 資料，`decision` 那整批（爐溫、聯鎖、風扇、狀態機、事件）
永遠不會出現。已補上：

```python
logf.write(json.dumps(rec, ensure_ascii=False) + "\n")
client.publish("incense/decision", json.dumps(rec, ensure_ascii=False))
```

（此行與《雲端監測平台指南》§2 原本要求的一字不差，證實修法正確。）

### 2.5 電路設計與電氣驗證

**發現並修正一個會讓安全旁路完全失效的設計缺陷**：

```
原設計：S3 GPIO4 (3.3V) ──直接接──> R4 D2（數位腳）
R4 (RA4M1) 數位輸入 VIH = 0.8 × VCC = 4.0V
餘量 = 3.3 − 4.0 = −0.7V   ✗ 規格上讀不到 HIGH
```

原指南寫「3.3V 是邊界值、實務上幾乎都過」——那是 UNO **R3**（ATmega328P，VIH = 3.0V）
的經驗，UNO **R4** 換 RA4M1 後門檻升到 4.0V，同一條線不再成立。
**這條線正是「Pi 當機時保命」的硬體旁路，平常完全測不出來。**

**採用解法：改接類比腳 A0**（零元件）

```
S3 拉高 3.3V → ADC ≈ 675/1023 ；放開 0V → ADC = 0
韌體門檻 > 500 判警報、< 300 才解除（軟體遲滯，取代數位腳的施密特輸入）
兩側餘量 175 / 500 counts
```

也擋掉一個陷阱：**不可用 BSS138 雙向模組**——S3 斷電時其 HV 側 10kΩ 上拉會讓
R4 誤讀成警報中、風扇鎖死全速，反而破壞降級行為。

**產出**（皆在 `電路設計/`）：

| 檔案 | 內容 |
|---|---|
| `電氣驗證計算.md` | 9 項介面逐項「規格值 → 計算 → 餘量 → 判定」，8 項合格、1 項需調參 |
| `kicad/incense_p0.kicad_sch` | KiCad 電路圖，訊號實際畫導線（非網路標籤）+ 接點 + 網路標籤 |
| `kicad/電路圖.pdf` / `.svg` | 報告可直接用 |
| `kicad/產生電路圖.py` 等 3 支 | 產生器 / 結構驗證 / 網表輸出，皆可重跑 |
| `接線圖.html` | 視覺化拓撲與驗算總表 |
| `麵包板接線圖.html` | Fritzing 風格寫實圖 |

**KiCad 驗證結果（KiCad 10.0.5 實機跑過）**：

```
ERC       0 errors 0 warnings
網表      17 條網路，自動命名 0 條
ALARM     3 點 → U1.GPIO4、A1.A0、R1（10k 下拉）
```

過程中 ERC 抓出 44 項再修到 0，兩類問題值得記住：
- `power_pin_not_driven` — 所有電源腳都標 `power_in`，等於沒有元件在供電。
  解法：真正的供電端改 `power_out`，GND 放 `PWR_FLAG`。
- `lib_symbol_issues` — 符號雖內嵌可顯示但沒註冊符號庫。
  解法：另存 `incense.kicad_sym` ＋ `sym-lib-table`。

後續改成實際導線後又抓出 `endpoint_off_grid`（座標沒對齊 1.27mm 格點），
已把格點檢查寫進產生器的 `self_check()`，連同「不出圖紙／不重疊／不穿過元件／
每支腳都有連上」一起，日後改版面會直接擋下。

---

## 3. ✅ 已拍板：改採合併架構（兩板）

### 3.1 觸發原因

使用者的控制器**不是 Arduino UNO R4 Minima，而是 MATRIX Mini R4 Controller**
（matrixrobotics.com），基於 **Arduino UNO R4 WiFi**，腳位全部包裝成專用埠。

### 3.2 已查證的硬體事實

從官方函式庫 `Matrix-Robotics/MatrixMiniR4` 原始碼確認：

| 埠 | Arduino 腳位 | 備註 |
|---|---|---|
| D1 | 3, 2 | 3 支援 PWM |
| D2 | 5, 4 | 5 支援 PWM |
| D3 | 12, 11 | 11 支援 PWM |
| D4 | 13, 10 | 10 支援 PWM |
| A1 | A1, A0 | A0 支援 DAC |
| A2 | A3, A2 | |
| A3 | A4, A5 | 同時是 I2C0（走 `Wire`） |
| I2C1–I2C4 | `Wire1` ＋ PCA9548A 多工器（位址 `0x70`） | 切換 = 寫 `(1 << 通道)` |
| M1–M4 | DC 馬達，**5V** | API 為 `SetDCMotorPower(id, 0-100)` 百分比制 |
| RC1–RC4 | 伺服，5V | |

**使用者已確認：I²C 埠供電為 5V。**

感測器 5V 相容性查證結果：

| 感測器 | 供電範圍 | 5V 直接接 |
|---|---|---|
| SCD41 | 2.4 – 5.5 V | ✅ |
| GY-SHT31-D | 2.4 – 5.5 V，SDA/SCL 有 10kΩ 上拉到 VIN | ✅ 不需電平轉換 |

> 《P0接線與驗證指南》寫的「感測器不要接 5V」**是為了保護 ESP32-S3**
> （其 GPIO 不耐 5V），感測器本身不怕。拿掉 S3 後此限制自動消失。

### 3.3 合併方案接線（★實作後的最終版★）

| 元件 | MATRIX 埠 | Arduino 腳 |
|---|---|---|
| SCD41 | I²C1 埠（Grove，5V 直插） | `Wire1` mux ch0 |
| SHT31 | I²C2 埠（Grove，5V 直插） | `Wire1` mux ch1 |
| MAX6675 SCK | D4 埠左 | 13 |
| MAX6675 SO | D4 埠右 | 10 |
| MAX6675 CS | D1 埠右 | 2 |
| 風扇 PWM | D1 埠左 | 3（PWM）→ D4184 → 12V |
| Pi ↔ MATRIX | USB-C | 序列 115200 |
| 警報線 | **不需要**（感測與安全同板） | — |

> ⚠️ **不可用 D2、D3 埠**——`MiniR4.begin()` 把腳 11/4/12/5 配給 PS2 手把介面。
> 詳見 §3.6。

麵包板可整個拿掉，只剩 MAX6675 與 D4184 兩條跳線。
未用資源：D2、D3、A1、A2、A3、I²C3、I²C4、4 馬達、4 伺服、1 組 UART
（PMS5003 到貨後直接插 UART 埠）。

**⚠️ 修正先前的錯誤建議**：馬達埠是 **5V**（`Port M1 DC 5V Motor`），
推不動 12V 風扇，**D4184 ＋ 獨立 12V 電源仍須保留**。

### 3.4 取捨分析

**會失去**
1. **感測器擺位自由**（最實際的問題）——I²C 線長受限：
   ```
   單顆上拉 10kΩ → 可容忍 118 pF → 約 1 公尺
   雙上拉並聯 5kΩ → 可容忍 235 pF → 約 2 公尺
   ```
   超過 1–2 公尺就得回頭用 WiFi。原設計讓感測頭可裝在排煙口/呼吸帶。
2. **「S3 失效 → R4 仍保安全」這層降級消失**——單板故障即感測與安全同時陣亡。
   （但要誠實：R4 本來就已是致動的單點故障，風扇由它驅動。）
3. 報告的「三層獨立」論述要重寫。

**不會失去、甚至更好**
1. **降級階梯不消失，只是換形狀**，且 Pi 失效那層**變強**：
   原本 R4 只能吐固定 `FALLBACK duty 80`（不知 CO₂ 多少）；
   合併後 MATRIX 有 CO₂ 讀值，可在本地跑簡化 FSM 做真正的回饋控制。
2. 少掉整類失效模式（S3↔Pi 的 WiFi 連線、「MQTT 斷線判定」的誤判風險）。
3. 反應變快（少三跳）。

### 3.5 決策結果（2026-08-02 拍板）

**採用合併架構**：Pi 5（決策＋審計＋雲端）＋ MATRIX Mini R4（感測＋安全＋致動）。

> 前提：感測頭離控制盒在 1–2 公尺內（I²C 線長限制）。
> 2026-08-07 使用者確認只走兩板：三板原型（`ESP32/s3_sensor_node/`、
> `R4/r4_actuator_node/`、兩個 wokwi 模擬、pi_fsm 的 SENSOR_SOURCE 開關）
> 已全部刪除。若日後佈置超出線長限制要回頭用三板，從 git 歷史取回
> （刪除前最後版本：commit 2f5ab86 之後的工作區）。

### 3.6 ⚠️ 實作時查到的關鍵事實（差點踩雷）

**1. MiniR4.begin() 會佔用 D2、D3 埠**

`MatrixMiniR4.cpp` 的 `begin()` 內有：

```cpp
/* CLK: D3R(11) , CMD: D2R(4) , SET: D3L(12) , DAT: D2L(5) */
PS2.config_gamepad(11, 4, 12, 5, false, false);
```

原本規劃 MAX6675 走 D3 埠（腳 12、11）會直接衝突。**已改用 D1 ＋ D4**。

**2. UNO R4 的 snprintf 不保證支援 %f**

原 `r4_actuator_node.ino` 刻意用 `Serial.print(x, 2)` 而非 snprintf 組 JSON，
就是為了迴避這點。合併版韌體沿用同樣做法。

**3. 馬達埠是 5V，推不動 12V 風扇**

`MatrixMiniR4.h` 寫明 `Port M1 DC 5V Motor`。**D4184 ＋ 12V 電源必須保留**，
但 MATRIX 板子本身吃 6–24V，所以一顆 12V 2A 可同時餵板子與風扇，共地自動成立。

**4. UNO R4 WiFi 內建的 ESP32-S3 不能替代獨立開發板**

它是**網路協處理器**，GPIO 一支都沒拉到排針，不能讀感測器、不能控風扇
（PWM 屬於 RA4M1）。所以它不提供安全層冗餘，只能做網路。

**5. 風扇為何不走馬達埠（2026-08-02 確認維持 D4184）**

官方電氣規格：`DC Motor Output Voltage 典型 5V`、電流 1.5–2A，是**穩壓輸出**
而非 6–24V 直通，因此推不動 12V 風扇。

曾考慮是否有 MATRIX 的「12V 馬達轉接板」可代替 D4184，但查遍官網產品頁、
Mini 系列頁、全產品列表與 KKITC 中文資料都找不到此產品
（找到的 Modern Robotics MATRIX 12VDC Motor 屬**舊 FTC 世代系統**，非 Mini R4 生態）。

**即使該板存在，仍決定維持 D4184**，理由是安全性：

| | D4184（採用） | 馬達埠＋轉接板 |
|---|---|---|
| 控制路徑 | RA4M1 → PWM 腳 → MOSFET | RA4M1 → **STM32 副處理器** → 馬達驅動 → 轉接板 |
| 聯鎖停機方式 | 直接拉低 PWM 腳，無軟體介入 | 需 STM32 正確執行命令 |

風扇是**安全致動器**，超溫聯鎖必須能確實停機。控制鏈多一顆 MCU 就多一個
「它當掉時風扇維持原轉速」的失效模式。另外馬達驅動是 H 橋（雙向），
2 線無刷風扇只需單向，H 橋高側自舉常做不到 100% duty，反向驅動還可能
傷及風扇內部換相電路。四個馬達埠目前全部空著，也不缺資源。

---

## 3B. ✅ 已拍板：產品定位（2026-08-07；2026-08-16 更新）

**商業主打＝既有香爐的空品監測＋抽排過濾改裝模組（retrofit）**——不換爐、
不要求信眾改變行為，買方是廟方管委會。

**2026-08-16 使用者決定：理香機構整組自設計移除**（原本 2026-08-07 是降為
競賽 PoC）。插孔板／導正套筒／磁力矩陣（電磁鐵 ×4）／磁座全數拆除，
香直接插進爐盆。原始理由不變且更徹底：插孔板與「隨手插進香灰」的真實
信眾行為不相容，尖峰香量遠超任何可行格數。閉環展示改由
「CO2 分級 → 風扇抽排 ＋ 霧化煙源」承擔。舊設計見 git 歷史。

---

## 3C. ✅ 2026-08-16：理香機構移除 ＋ 集煙罩漏斗化

同日兩項設計變更，全鏈路已落地並驗證全綠：

- **理香機構移除**（使用者決定）：
  - `CAD自檢/mech_params.py`：套筒／插孔板／磁力矩陣三段參數、電磁鐵
    電源預算與互鎖約束全部移除；`PARTS` 只剩感測器外殼。
  - 規則面：L1 相關測試移除，另新增兩條「殘留守門」規則——
    電路圖不得再有 MAGn 網路、韌體不得再有電磁鐵控制碼。
  - `外觀CAD`：`socket_plate.scad`／`magnet_deck.scad`／`tidy_parts.scad`
    刪檔；列印件回到 5 件。
  - 電路：`佈線定義.py` 刪 MAG1-4 與 Solenoid-Array，PCF8574 只剩
    OUT5 霧化＋OUT6 罩內 LED（實體接線不動）；電路圖／網表重產，
    結構與連通性檢查通過（12 元件、20 網路）。
  - 韌體：`matrix_mini_r4.ino` 移除電磁鐵互鎖與脈衝控制，`ioWrite()`
    保留給霧化／LED。★板上還是舊韌體，需重新燒錄★
- **集煙罩漏斗化**（使用者需求：上窄下寬不好插香）：
  - 改為「下段直筒 44mm（煙道開口與風扇座法蘭靠垂直後壁）＋
    上段外擴喇叭口」，罩頂開口外寬 96 → 180mm（內開口 ≈175）。
  - 喇叭斜面 34°，倒印自支撐；`驗證CAD.py` 的 F 檢查改驗
    「煙道開口整個落在直筒段」與喇叭角度。
  - 外觀 CAD 全套驗證通過（含 OpenSCAD 實際算繪、干涉、貫通探針）。

---

## 4. 待辦事項

### 4.1 合併架構實作進度

- [x] `R4/matrix_mini_r4/matrix_mini_r4.ino` — 合併版韌體（I²C 感測 ＋ 本地簡化 FSM）
- [x] `PI5/pi_fsm.py` — 感測來源改讀序列，並轉發 `incense/sensor` 上雲；
      加 `SENSOR_SOURCE` 開關，可切回 `"MQTT"` 用原三板架構
- [x] 舊韌體加註「原型階段方案」，並修正 Arduino 資料夾命名慣例
- [x] 靜態驗證：`R4/matrix_mini_r4/驗證韌體.py`、`PI5/驗證資料流.py`
- [x] **實機編譯燒錄**（2026-08-11 筆電完成：arduino-cli 1.4.1 編譯過
      （flash 36%／RAM 44%）、COM12 燒錄成功、序列 115200 實測每秒 telemetry
      正常，`-99.9` 誠實故障值與 FALLBACK S1 fan 80 皆符合預期。
      注意：MAX6675 模組整個未接時 SPI 讀全零，`tc_fault=0`、`t_furnace=0.00`
      ——韌體只能偵測熱電偶開路，判不出模組缺席，接線日勿誤判）
- [x] KiCad 電路圖重畫為兩板版（rev E，ERC 0 違規，9 元件／16 網路）
- [x] `接線圖.html`、`麵包板接線圖.html` 重畫為兩板版
- [x] `P0接線與驗證指南.md`、`電路設計/電氣驗證計算.md` 加註架構變更與新章節
- [ ] Phase 2：MATRIX 經內建 WiFi 直送雲端（Pi 失效時的備援路徑，
      韌體末尾已標好掛載點）

### 4.1.1 合併版的兩支驗證腳本

```bash
python3 R4/matrix_mini_r4/驗證韌體.py    # 門檻與 pi_fsm.py 一致性、腳位衝突、JSON 合法性
python3 PI5/驗證資料流.py                # 韌體→pi_fsm→Grafana 的欄位契約
```

前者會抓「本地 FSM 門檻與 pi_fsm.py 不一致」——降級瞬間風扇轉速跳變，實機極難察覺。
後者會抓「欄位名對不上」——畫面 No data，同樣極難查。兩支都做過負面測試，確認抓得到錯。

### 4.1.2 外觀 CAD（2026-08-02）

桌上型展示機，180×180×196 mm，FDM 分件列印（5 件）。
`外觀CAD/incense_burner.scad` 為參數化原始碼，開頭是完整參數區。

**核心設計約束是熱**：熱電偶聯鎖 150/130°C（2026-08-02 由 80/60 調高，臨時值），
而 PLA 的 HDT 只有 55–60°C。設計對策：

1. 燃燒由**金屬爐盆**（自備不鏽鋼碗 ⌀110×45）承接，塑膠不碰火源
2. 爐盆與塑膠之間留 **8mm 空氣間隙**（最好的絕熱材）
3. 燃燒艙↔電子艙之間 **14mm 隔熱層 ＋ 對流通風縫**
4. **燃燒艙與集煙罩必須用 ABS/ASA/PETG，不可用 PLA**

感測器艙裝在**前方朝外**而非煙道內，理由有二：FSM 用 CO₂ 斜率偵測人潮，
要量的是「參拜者呼吸到的空氣」；且 SCD41 工作溫度上限約 60°C，放煙道會壞。

**待實測後修改的參數**（都在檔案頂端）：
`MATRIX_W/D`（官方未公佈尺寸，現為估值 90×70）、`SCD41_*`、`SHT31_*`、
`D4184_*`、`BOWL_D/H`、`FAN_SCREW_S`。

**尚未驗證**：本機無 OpenSCAD，只做了參數化檢查（元件裝得下、
零件放得進列印床、熱間隙存在、煙道三處一致），**幾何未實際算繪**。

- [ ] 開 OpenSCAD 按 F6 算繪，確認布林運算與無破面
- [ ] 實測元件尺寸後更新參數
- [ ] 匯出 STL 試印

### 4.2 不論如何都要處理

- [ ] **MQTT 帳密缺口（真爐上線前必處理）**
  `P0接線與驗證指南.md` §3.2 把 Pi 本機 mosquitto 設為 `allow_anonymous true`，
  註明「到廟裡實測前再加帳密」。但 `pi_fsm.py`（`client.connect()`）與
  `s3_sensor_node.ino`（`mqtt.connect(cid)`）**都沒有帳密參數的位置**——
  屆時只改 broker 設定，這兩支會直接連不上。
- [ ] **風扇 PWM 頻率**：預設 490 Hz 會嘯叫，建議改用 R4 核心 `pwm.h` 拉到 25 kHz
- [ ] **S1 duty = 70 可能低於無刷風扇最低啟動占空比**（常見 30–40%，即 77–102）。
  照《P0接線與驗證指南》§5 第 2 關用 `FAN 60/70/80` 逐級實測記下真實門檻
- [ ] **燒錄前填佔位值**：`s3_sensor_node.ino` 的 `WIFI_SSID`、`WIFI_PASS`、`MQTT_HOST`
- [ ] **補購**：D4184 MOSFET 模組、12V 2A 電源（BOM 有編列但清單漏了）
- [ ] 真爐 `provision.sh` 銜接：`CLOUD_MQTT=100.73.36.75`、`MQTT_USER=burner`，
  該 Pi 也需 `tailscale up` 加入同一 tailnet（`feihong9487.github`）

---

## 5. 環境與工具

| 項目 | 值 |
|---|---|
| 雲端部署目錄 | `~/incense-cloud`（WSL2 Ubuntu 24.04 家目錄） |
| KiCad | 10.0.5，安裝於 Windows `C:\Program Files\KiCad\10.0\bin\kicad-cli.exe` |
| WSL 呼叫 KiCad | 可直接執行該 .exe，參數用 Windows 路徑（`D:\WRO2026\...`） |
| Tailscale IP | `100.73.36.75`，tailnet `feihong9487.github` |
| 密碼 | 一律由使用者保管，**任何文件都不記明文** |

**重跑電路圖全套驗證**：

```bash
cd /mnt/d/WRO2026/電路設計/kicad
python3 產生電路圖.py      # 含版面/佈線/格點自我檢查
python3 驗證電路圖.py      # 結構與連通性
python3 輸出網表.py        # 人可讀網表
KC="/mnt/c/Program Files/KiCad/10.0/bin/kicad-cli.exe"
"$KC" sch erc --severity-all 'D:\WRO2026\電路設計\kicad\incense_p0.kicad_sch'
"$KC" sch export pdf --output 'D:\WRO2026\電路設計\kicad\電路圖.pdf' 'D:\WRO2026\電路設計\kicad\incense_p0.kicad_sch'
```

> KiCad 開著檔案時重跑產生器，KiCad 不會自動重載且會留下 `.lck`，請關閉專案再重開。

---

## 6. 給下一個會話的提醒

1. **先確認架構決策**（§3）有沒有拍板，再動任何硬體端的檔案。
2. 模擬爐 `aroma01`／`aroma02` **是模擬機**，任何展示、報告、簡報都必須標明。
3. 《任務書_雲端中心站部署.md》是**原始委派紀錄，不修改**；檔名/路徑變更已在其頂部加補註對照表。
4. 電路圖改版面只要動 `kicad/佈線定義.py`，產生邏輯不用碰。
5. 驗證分兩層且互補：`驗證電路圖.py` 驗「檔案結構與座標連通性」（沒 KiCad 也能跑），
   KiCad ERC 驗「電氣語意」（非得有真工具）。兩層都要跑。
