feihong9487/WRO2026/智慧香爐_硬體設計交接.md

# 智慧香爐・硬體設計交接文件（Hardware Design Handoff）

> 用途：新對話進行硬體實作時上傳此檔。本檔聚焦硬體：腳位、供電、通訊、機構、安全。
> 軟體/實驗/報告整合請搭配《智慧香爐_實作交接文件.md》。標注【建議】者＝實接時依板面絲印確認。
> 日期：2026-07-15（§0 定位定案：2026-08-07）

---

## 0. 產品定位（2026-08-07 拍板）

**商業主打：既有香爐的空品監測＋抽排過濾改裝模組（retrofit）。**
集煙罩、過濾鏈、感測陣列、雲端儀表板加裝在任何現役香爐上就開始工作——
不換爐、不要求信眾改變任何行為。買方是廟方管委會（B2B 單一決策者），
買點是工安、環保陳情壓力與廟方公關（空品即時公開本身就是文宣）。

> **★2026-08-16 設計變更★ 理香機構已整組自設計移除**（使用者決定）：
> 插孔板／導正套筒／磁力矩陣（電磁鐵）／磁座全數拆除，香直接插進爐盆，
> 集煙罩改為漏斗大口。本檔所有理香相關段落（§0 定位、零件說明、
> 腳位表 D7/D8、機構規格 §7 等）自此僅為歷史紀錄，勿再據以採購或實作。
> 現況以 `專案進度.md` §3C 與 `CAD自檢/mech_params.py` 為準。

**理香機構定位為競賽 PoC 展示與未來選配，不是商業主打。**
理由（2026-08-07 檢討定案）：

- 插孔板要求信眾「對準孔、把香放進套筒」，與真實香爐「隨手插進香灰」
  的行為不相容——人不會為機構改變行為，孔滿之後香只會插在孔外。
- 尖峰時段一人三炷、一小時數百炷，遠超任何可行的格數；理香只作用於
  套筒內的香，套筒外的一根也管不了。
- 在插孔板真正成立的減香情境（一人一炷、定格插香），悶燒擠香問題
  本身大幅消失——機構解決的問題被自己的前提消滅。

競賽展示不受影響：理香仍是「偵測→分類→主動致動」完整閉環的主秀，
誠實定位為主動控制的 PoC 示範即可。

本檔其餘章節多寫於定位定案前，個別段落以獨創性/商模視角描述理香機構
——其工程內容仍然有效，但**商業敘事一律以本節為準**。

---

## 1. 系統架構總覽（方案 A：三控制器一層一顆）

```
┌─ 感測層 ESP32-S3 ──────────────┐   WiFi/MQTT（主）
│ PMS5003×2・MH-Z19B・ZE07-CO    │ ─────────────────► ┌─ 決策層 Pi 5 16GB ─┐
│ (SHT31)・microSD               │   USB-CDC（備援）   │ FSM・前饋・紀錄     │
│ 融合估測＋TFLite悶燒推論       │                     │ Grafana/Flask・訓練 │
└───────┬────────────────────────┘                     └─────────┬──────────┘
        │ 警報線（主動低態，經電晶體）                            │ USB 序列 115200
        ▼                                                        ▼
┌─ 機構層 Arduino R4 Mini（5V 邏輯）────────────────────────────────────────┐
│ MAX6675 熱電偶・MOSFET 風扇×2(PWM)・WS2812・電磁鐵×2・IR 近接（聯鎖）      │
│ 安全聯鎖優先於一切；Pi 指令逾時 5s → 自主安全模式                          │
└──────────────────────────────────────────────────────────────────────────┘
```

故障安全階梯：雲斷→Pi 本地續跑｜Pi 失效→S3 經警報線維持基本抽排｜S3 失效→R4 聯鎖保爐，香爐回復傳統使用。

---

## 1A. 元件功能、用處與設計原因（詳解版）

> 原則：本系統沒有「順便加的零件」——每個元件都對應一項系統能力、一個 KPI 或一條報告主張。以下每項皆分「功能／用處／設計原因」三段，答詢與交接皆可直接引用。

### A. 控制器

**ESP32-S3｜感測中樞＋邊緣 AI**
- 功能：讀取全部感測器→中值濾波→溫濕度補償→互補濾波融合→TFLite Micro 悶燒推論→WiFi/MQTT 上傳＋microSD 落地。
- 用處：系統一切環境感知的匯集點。它輸出的不是單一數字，而是「濃度＋信賴度」配對——兩顆 PMS 讀值一致時信賴度高、分歧時信賴度降，下游決策自動轉保守（提早增強抽排、提早告警）。這讓低成本感測器的不確定性被系統「知道並回應」，而不是被假裝不存在。悶燒推論在感測端毫秒級完成，只把結論與特徵送出，不需把原始資料流灌向 Pi；斷網時資料寫 microSD，恢復後補傳——「邊緣優先、斷網續跑」因此不是口號而是電路。
- 設計原因：三個候選被比較過。純 ESP32：跑不動 TFLite Micro 的向量運算，S3 是 MCU 級裡唯一能做邊緣推論的。全交給 Pi：感測取樣是硬即時工作，放在跑完整 OS 的 Pi 上會受排程抖動影響取樣節奏；且 Pi 一當機感知全滅。S3 的 3.3V 原生邏輯讓 PMS/MH-Z19B/ZE07 的 TTL 全部直連，省掉每顆感測器一片電平轉換板——省錢，更少三個潛在故障點。

**Raspberry Pi 5 16GB｜可解釋的決策大腦**
- 功能：FSM 狀態機、CO₂ 前饋、每秒一筆決策全紀錄、Grafana/Flask 三方面板、悶燒模型就地訓練、機隊 OTA。
- 用處：報告 3-3 歸納的最大信任缺口是「裝了沒用」，Pi 就是解方的實體——每筆決策記錄「讀值→判斷→動作→事後讀值」，任何人可重演系統為什麼那樣做；面板讓香客看空品、廟方看狀態、主管機關看紀錄。16GB 的意義在訓練：燃燒艙白天蒐的悶燒資料，晚上就地訓練、隔天部署回 S3——資料飛輪在邊緣端就轉得起來，不依賴雲端算力，這在答詢是罕見亮點。
- 設計原因：FSM 本身很輕，S3 也跑得動，為何仍分層？因為決策紀錄、資料庫、Web 服務、訓練是 OS 級工作；更關鍵的是解耦——把「複雜但非即時」的決策層與「簡單但攸關安全」的即時層分開，Pi 的任何 bug 都不可能波及聯鎖。全塞一顆板子省的是錢，賠的是整個故障安全論述。

**Arduino R4 Mini｜安全底線＋致動執行**
- 功能：安全聯鎖（MAX6675 溫度＋IR 近接）、風扇 PWM、WS2812 圖樣、電磁鐵時序、對 Pi 的 5 秒看門狗。
- 用處：它是「香爐永遠安全」的結構性保證——聯鎖只依賴它自己直讀的兩個感測器，不依賴任何上游板子的健康。Pi 掛了、S3 掛了、網路全斷，R4 仍然：過熱即停、有人即停、逾時進自主安全模式。所有物理動作也由它出手，因為致動時序需要 MCU 級的穩定。
- 設計原因：為什麼把最重要的安全交給最「弱」的板子？正因為它最簡單——沒有 OS、沒有網路協定棧、沒有動態記憶體的複雜性，當機面最小、行為最可預測。安全工程的鐵律是「安全功能放在最不會壞的地方」。附帶紅利：R4 是 5V 邏輯，WS2812 的 5V 訊號直推免轉換。

### B. 感測器（每顆綁定一個假說或安全功能）

**PMS5003 ×2｜可驗證性的硬體基礎（H1）**
- 功能：雷射散射式 PM2.5，秒級輸出。A 顆＝呼吸高度、B 顆＝出風口。
- 用處：A 顆量的是「人實際吸進去什麼」——健康保護的最終指標，H1 檢定的主角。B 顆與環境值相減得濃度差、乘風量＝即時淨化量，這個數字上面板後，系統好壞一翻兩瞪眼——「可驗證」從形容詞變成一條算式。兩顆同型還兼冗餘：讀值長期偏離即發「需維護」告警，杜絕「感測器壞了還顯示乾淨」。
- 設計原因：雷射散射式是唯一同時滿足秒級、低價（標準儀器 1/100）、可陣列化的選項；絕對精度不足以「相對量測」策略化解——控制與驗證看變化量與差值，不看絕對值，報告已誠實聲明。不放爐口正上方：>1000 µg/m³ 會飽和爆表，爐口交給熱電偶＋趨勢。

**MH-Z19B CO₂｜前饋的眼睛（本案招牌）**
- 功能：NDIR 紅外量 CO₂，讀取走 UART 指令。
- 用處：人呼出 CO₂——人潮聚集時 CO₂ 斜率比插香高峰早數分鐘上升，是免費、可靠、零隱私疑慮的人流先行指標。斜率越過 θ_ff，系統預先升速抽排、提前點亮 LED 分流，污染尖峰被「削」而非事後追趕。前饋＋回饋雙迴路是本系統相對固定運轉設備最本質的智慧差異，也是方法專利的主張核心。
- 設計原因：為何不用便宜十倍的 MQ 系半導體式？半導體式會被酒精與煙氣嚴重干擾，在香煙環境形同失明；NDIR 量的是 CO₂ 分子的真實紅外吸收，穩定、不中毒、壽命長。為何不用攝影機數人頭？廟宇場域隱私敏感＋光線多變＋算力成本，一顆 490 元的 CO₂ 感測器優雅得多。

**ZE07-CO｜悶燒的化學指紋（H3 關鍵）**
- 功能：電化學式 CO，本設計走 DAC 類比輸出。
- 用處：悶燒＝低溫缺氧的不完全燃燒→CO 產率暴增而 CO₂ 大致持平，因此「CO/CO₂ 比異常上升＋爐面溫度偏低」＝悶燒特徵成立→分類器標記→觸發 S3 理香疏通。H3（60 秒偵測）的成敗一半押在這顆。
- 設計原因：電化學式對低濃度靈敏且選擇性好；更重要的是報告寫明「電化學式」——原型與宣稱一致是誠實問題，不是規格問題。改走 DAC 是為了解 S3 的 UART 短缺（§2），犧牲些許解析度換架構簡潔；CO 在此是「特徵訊號」而非精密計量，足夠。

**MAX6675＋K 型熱電偶｜一顆兩職**
- 功能：爐面溫度，耐上千度，SPI 唯讀。
- 用處：職一＝悶燒特徵的溫度端；職二＝安全聯鎖的直接輸入（過熱→R4 即刻斷致動）。它接在 R4 而非 S3，正是因為**聯鎖不能依賴跨板通訊**——安全訊號的路徑越短越好。
- 設計原因：K 型熱電偶是唯一能懸在爐面上方存活的溫度感測；220ms 轉換限制輪詢 ≤4Hz，對付分鐘級的悶燒現象綽綽有餘。

**IR 近接模組｜「人優先於機器」的實體化**
- 功能：偵測人手接近爐面，數位輸出直入 R4 中斷腳。
- 用處：信眾伸手插香的瞬間，一切機構動作立即中止。這不只是安全規格，更是文化規格——儀式中的人永遠優先於機器，這句報告裡的話由這顆 40 元的模組兌現。
- 設計原因：聯鎖必須毫秒級且不依賴 Pi，攝影機方案（慢、需算力、依賴上游）直接出局；IR 模組→R4 中斷腳是最短路徑。

**USB 攝影機｜研究儀器，不是控制元件**
- 功能：拍攝爐面插香分布。
- 用處：H2 檢定的量測工具（LED 引導開/關的均勻度對照）＋悶燒影像資料集的起點。
- 設計原因：影像僅拍爐面（研究倫理承諾）；刻意不進控制迴路——視覺的不可靠因素多，安全與控制決策不依賴它。

**SHT31（升級 U2）｜讓數據從「參考」變「可信」**
- 用處：雷射散射式 PM 在高濕下因顆粒吸濕而系統性高估；溫濕度補償是校正故事（報告 3-10）的必要一環，沒有它，H1 的數字會被質疑。

### C. 致動與機構

**5015 風扇 ×2＋MOSFET｜削峰的手**
- 用處：變頻承載雙重權衡——平時低速＝省電且安靜（殿內莊嚴是寫進控制目標的文化規格），高峰全速＝捕集效率。兩顆並聯提供冗餘與風量彈性。
- 設計原因：鼓風式（5015）靜壓遠高於同價軸流扇，推得動 HEPA 的壓損；軸流扇會在濾網前「空轉」。

**WS2812 燈條｜整套系統的人機介面**
- 用處：綠＝建議孔位、紅＝已滿/高溫區——把「請分散插香」從沒人聽的廣播變成一眼看懂的燈號，高峰時把人流導向低密度區，直接服務 H2。柔和、不閃爍、不出聲＝文化敏感設計的三原則。
- 設計原因：可定址＝一條訊號線控整排、逐孔獨立；亮度 ≤25%＋同亮 ≤20 顆是 5V 軌供電預算（§5）反推出來的紀律。

**電磁鐵 ×2＋鐵墊圈鋁套筒｜全案最獨創的機構（源頭治理的實體）**
- 用處：悶燒的根因是插香過密與傾倒交疊遮蔽氣流。這組機構直接「管理燃燒的幾何」：電磁鐵吸引套筒底部鐵墊圈，傾斜的套筒連同香枝就地回正，通風通道恢復——污染在生成之前被抑制。「磁作用於套筒、不作用於香枝」一句話有三層意義：信眾可用任何市售香（可普及性前提）、無需特殊耗材（商模前提）、結構專利主張核心。
- 設計原因：機械手臂夾香被否決——爐面高溫、香灰侵蝕、成本、視覺突兀且嚇人；磁力隔著陣列板作用，無外露移動件，故障模式天然安全（斷電＝不動＝香爐照常用）。最終備援＝純機械錐形套筒（無磁、靠重力自回正）。
- **定位註記（2026-08-07）**：本機構定位為**競賽 PoC 展示與未來選配**——插孔板與傳統香灰爐的自由插香行為不相容（詳見 §0），上兩行的可普及性/商模/專利主張僅在減香定格插香的情境成立，商業敘事以 §0 為準。

**鋁套筒｜一個材質解兩個需求**
- 設計原因：近火區 PLA 必軟、PETG 勉強、鋁最穩；同時它就是磁力的受力載體——耐熱與受力由同一根 8mm 鋁管解決，這是省錢也是減少零件數。

**PVC 集煙罩｜點源捕集的流體力學**
- 設計原因：污染物在源頭濃度最高、佔據體積最小——罩口越貼近爐口，同樣風量的捕集效率越高。全室換氣要處理整座殿的空氣體積，是數十倍的風量需求；點源捕集讓兩顆 70 元的風扇做出大型空調做不到的局部效果。

**過濾鏈：金屬紗網 → HEPA → 活性碳（順序不可對調）**
- 設計原因：風扇抽香煙＝把未熄火星往濾網吸，而 HEPA 是可燃物——紗網是安全件，必在最前。HEPA 攔顆粒（主力）、活性碳吸 VOCs（苯、甲醛）；若活性碳在前會先被灰堵死。風扇置於最末＝抽拉式，理由見設計決策 2。

**大整理箱燃燒艙｜H1 數據的產地**
- 用處：受控＝可重複＝科學。固定艙體、香枝數、擺位，跑「系統開/關 × 密集/引導插香」的 2×2 對照——報告 3-11 全部假說的實驗場。

### D. 電氣安全與可靠性小件（十幾塊錢，缺一出事）

- **1N4007 飛輪二極體**：電磁鐵斷電瞬間線圈反電動勢可達數十伏，無二極體第一次斷磁就可能擊穿 MOSFET——十元保六十元，還保實驗當天不中斷。
- **2A 保險絲**：這是要放在香火旁的裝置，12V 軌短路時斷電不起火是底線，不是選配。
- **2N2222 警報線電路**：跨 3.3V/5V 板的可靠傳訊＋斷線方向天然 failsafe（詳見設計決策 3）。
- **microSD 模組**：斷網不丟數據；「邊緣優先」四個字的最後一塊拼圖。

### E. 設計決策詳解（含被否決的替代方案）

1. **三顆控制器一層一顆，而不是一顆 Pi 全包。** 被否決方案：「Pi 5 什麼都跑得動，一顆就好」。否決理由有三：單點故障——Pi 一當機，感知、決策、安全同時消失；即時性——OS 排程抖動影響取樣節奏與致動時序；安全隔離——聯鎖和複雜軟體同居一板，等於把保險絲焊在炸藥上。三顆的真正回報是「逐級降級」有實體：每降一級都有一顆活著的晶片接手（雲斷→Pi、Pi 斷→S3、S3 斷→R4）。答詢口袋：「原型以三顆分別驗證三種角色，量產會整合精簡」。
2. **風扇置於過濾鏈之後（抽拉式），而不是之前（推吹式）。** 推吹式讓扇葉first吃滿香灰油煙——葉形改變、動平衡跑掉、風量衰減、清潔困難；抽拉式扇葉只碰濾後乾淨空氣，壽命與維護性大勝。代價：濾箱必須氣密（負壓下漏氣＝髒空氣旁通繞過濾網），組裝時接縫打膠。
3. **警報線採主動低態開集極，而不是主動高態。** 關鍵在「壞的方向」：線材脫落、接觸不良、S3 斷電時，線路被 R4 的上拉電阻拉高＝讀到「正常」——不會半夜誤觸發安全停機嚇壞廟方。反過來設計成主動高態，斷線＝永久誤報警，系統喊狼來了三次就沒人信了。這裡敢選「不誤報」是因為 R4 自己還有本地聯鎖（溫度＋IR）兜底——雙保險下，對外的警報線可以優先顧「不誤報」。
4. **電磁鐵脈衝驅動（單次 ≤2 秒、佔空比 ≤30%），而不是持續通電。** 線圈連續通電的 I²R 發熱會讓 20N 小磁鐵幾分鐘內燙手、線圈壽命驟減；而理香本質是「事件驅動的偶發矯正」不是連續運轉——需求型態與熱限制指向同一答案。限制同時做在軟體（R4 韌體計時）與使用規範兩層。
5. **三點佈點，每一點刪掉都失去一種能力。** 刪爐口（溫度/趨勢）→控制迴路對源頭失明；刪呼吸高度→「保護人的健康」失去量測依據，H1 無從檢定；刪出風口→濃度差算不出來，「可驗證性」整條論述歸零。三點不是冗餘堆疊，是三條獨立的功能線。
6. **Pi 5 必須用官方 27W 電源，嚴禁掛 LM2596 的 5V。** Pi 5 峰值電流大，5V 掉到 4.6V 就觸發降頻或無預警重啟——決策層一消失：面板中斷、決策紀錄斷檔、「每筆可重演」的可解釋性承諾直接毀約。LM2596 標稱 3A、實際穩定輸出約 2A 且紋波大，物理上就不夠。省一顆電源的錢，賠的是全系統最貴的論述。

---

## 2. ESP32-S3 腳位分配【建議，DevKitC-1 為例】

**關鍵解法：UART 只有 3 組，但 UART 感測器有 4 顆** → ZE07-CO 改用其 **DAC 類比輸出模式**（0.4–2.0 V），釋出一組 UART。

| 裝置 | 介面 | 腳位【建議】 | 備註 |
|---|---|---|---|
| PMS5003 A（呼吸高度） | UART1 RX | GPIO4 ← 感測器TX | 主動模式 9600，僅收；感測器 RX 腳懸空(NC) |
| PMS5003 B（出風口） | UART2 RX | GPIO5 ← 感測器TX | 同上；兩顆分開 UART 避免資料互撞 |
| MH-Z19B CO₂ | UART0 | TX=GPIO6→感測器RX、RX=GPIO7 | 需雙向（0x86 讀值指令）；**console 改走原生 USB-CDC，UART0 因此空出** |
| ZE07-CO | ADC | GPIO1（ADC1_CH0） | DAC 模式：ppm = (V−0.4)/1.6×500；勿用 ADC2（與 WiFi 衝突） |
| SHT31（升級 U2） | I²C | SDA=GPIO8、SCL=GPIO9 | 位址 0x44 |
| microSD | SPI(FSPI) | CS=10、MOSI=11、SCK=12、MISO=13 | 斷網續存 |
| 警報輸出 → R4 | GPIO | GPIO38 → 電晶體 | 見 §4 電平轉換 |
| 避免使用 | — | GPIO0/3/45/46（strapping）、GPIO19/20（USB） | 開機腳位，接了會開不了機 |

供電：S3 由 USB 5V 或 5V 軌供電；**感測器 VCC 一律 5V、邏輯腳 3.3V 直連 S3**（PMS5003/MH-Z19B/ZE07 皆 5V 供電・3.3V TTL，免電平轉換——此為 S3 掌感測層的核心理由）。

---

## 3. Arduino R4 Mini 腳位分配【建議】

| 裝置 | 介面 | 腳位 | 備註 |
|---|---|---|---|
| MAX6675 | SPI | CS=D10、SCK=D13、SO=D12 | 唯讀；轉換 ~220ms → 輪詢 ≤4Hz 即可 |
| 風扇 MOSFET A/B | PWM | D5、D6 | D4184 模組；PWM 25kHz 內建頻率即可 |
| WS2812B | 單線 | D4 | R4 為 5V 邏輯，直推無壓差問題 |
| 電磁鐵 MOSFET ×2 | 數位 | D7、D8 | **每顆電磁鐵並聯 1N4007 飛輪二極體（陰極接+12V）**——感性負載必備，D4184 模組未必內建 |
| IR 近接模組（聯鎖） | 數位 | D3 | 人手接近偵測；約 NT$40，零件包內補購 |
| S3 警報輸入 | 數位 | D2（INPUT_PULLUP，中斷腳） | 主動低態，見 §4 |
| Pi 通訊 | USB | — | 115200；**看門狗：5 秒無有效指令 → 進自主安全模式（風扇中速、磁鐵斷電）** |

---

## 4. 跨板電平與警報線設計（實接必讀）

R4（RA4M1）為 5V 邏輯，S3 的 3.3V HIGH 對 R4 的 VIH **不保證**可靠判 HIGH。警報線採**主動低態開集極**：

```
S3 GPIO38 ──1kΩ── 2N2222 基極；集極 → R4 D2（INPUT_PULLUP 到 5V）；射極 → GND
```
- 平時 S3 輸出 LOW → 電晶體截止 → D2 被拉高＝正常
- 警報時 S3 輸出 HIGH → 電晶體導通 → D2 拉低＝觸發（斷線/S3 當機時線路浮高＝不誤觸發，failsafe 正確方向）
- **三板共地（GND 全部連通）為一切通訊前提**，最常見的「怎麼都收不到資料」九成是沒共地。

---

## 5. 供電樹

```
市電 → 12V 2A 變壓器 ──┬─ 保險絲 2A（+20 元，必加）
                        ├─ 12V 軌：風扇×2（~0.4A）＋電磁鐵×2（峰值 0.6–1A，脈衝驅動）
                        └─ LM2596 → 5V 軌：R4（VIN 或 5V 腳）、WS2812、感測器 VCC、S3
Pi 5 → 專用官方 5V/5A USB-C 電源（27W）——**不可**吃 LM2596 的 5V，會欠壓重啟
```
- 電磁鐵採**脈衝驅動**（單次 ≤2 秒、佔空比 ≤30%）防過熱，軟體端限制。
- WS2812 60 顆全白 ≈ 3.6A——引導用途限亮度 ≤25% 且同亮 ≤20 顆，5V 軌才撐得住。

---

## 6. 通訊協定規格

**S3 → Pi（MQTT，主通道；Pi 跑 mosquitto broker）**
- Topic：`incense/telemetry`，1 Hz，JSON：
  `{"ts":..,"pm_a":..,"pm_b":..,"co2":..,"co":..,"rh":..,"conc":..,"conf":..,"smolder_p":..}`
- 備援：USB-CDC 序列同格式（斷網自動切換，microSD 同步落地）。

**Pi → R4（USB 序列 115200，行協定，`\n` 結尾，R4 回 `ACK` / `NAK`）**
```
CMD,STATE,S2        # 設定狀態（R4 據此套用預設致動組合）
CMD,FAN,0-255       # 風扇 PWM
CMD,LED,GUIDE,r,c   # 點亮建議孔位（列,行）
CMD,MAG,PULSE,n     # 觸發第 n 格電磁鐵單脈衝
TLM 回報：TLM,temp,63.2,intlk,0,fan,180
```

---

## 7. 機構設計規格【建議起點，依實際借得的香爐調整】

- **插孔陣列板**：5×5 起步；孔徑 9 mm（容 8 mm 鋁套筒＋餘隙）；孔距 35–40 mm（通風通道）；材質 **PETG**（列印 240°C/床 80°C）或木板；以金屬柱**墊高於爐口 ≥40 mm** 隔熱。**爐口 80 mm 半徑內禁 PLA。**
- **導正套筒**：鋁管外徑 8 mm、長 35 mm；底部套**鐵墊圈**（鐵磁受力件——磁力作用於套筒非香枝，市售任何香可用）；套筒在孔內留 0.5 mm 徑向餘隙供回正擺動。
- **磁力單元**：電磁鐵置於陣列板下方、對準孔位正下方 5–8 mm；吸引鐵墊圈使傾斜套筒回正。
- **集煙與過濾鏈（抽拉式，風扇在最後）**：爐口上方 PVC 集煙罩 → 軟管 → 濾箱依序【金屬紗網（火星前濾）→ HEPA → 活性碳】→ 5015 風扇×2 → 排出。風扇置後端＝濾後氣流，扇葉不積灰油。
- **燃燒艙**：大整理箱；開孔：集煙管、線纜（矽膠塞）、觀察窗；PMS_A 置呼吸高度模擬點、PMS_B 置出風口、熱電偶懸於爐面上方 2–3 cm。**PMS 勿置爐口正上方（>1000 µg/m³ 飽和）。**

---

## 8. 硬體版 BOM 增補（相對主料表）

| 增項 | 價 | 理由 |
|---|---|---|
| IR 近接模組 | 40 | 聯鎖「人手接近」的實體輸入（原料表缺漏，本檔補上） |
| 1N4007 ×4 | 10 | 電磁鐵/風扇飛輪二極體 |
| 保險絲座＋2A 保險絲 | 20 | 12V 軌保護 |
| 2N2222＋1kΩ | 10 | 警報線電平轉換 |
| microSD 模組 | 60 | S3 斷網續存 |

（主料表 NT$3,980 與升級選單 U1–U11 見《實作交接文件》§4；以上增補約 +140，總計仍 <4,200。）

---

## 9. 組裝與點亮順序（P0 檢核表）

1. 三板共地 → S3 USB-CDC console 確認開機
2. 逐顆感測器單獨接上驗證讀值（PMS 主動模式幀頭 0x42 0x4D；MH-Z19B 先預熱 3 分鐘；ZE07 DAC 以萬用表對 ADC 讀值互驗）
3. R4：MAX6675 讀室溫 → PWM 吹風扇 → WS2812 點燈 → 電磁鐵脈衝（先接飛輪二極體再上電）
4. 警報線：S3 手動拉 HIGH → R4 D2 讀 LOW → 觸發安全模式
5. Pi：mosquitto 起服務 → 收到 S3 telemetry → 對 R4 下 `CMD,FAN,120` 收 `ACK`
6. 看門狗測試：拔 Pi–R4 線 5 秒 → R4 進自主安全模式

---

## 10. 已知風險與備援

| 風險 | 備援 |
|---|---|
| ZE07 缺貨/超價 | 退 MQ-7（半導體式），報告誠實標註「原型暫代，量產採電化學」 |
| 磁力回正力不足 | 加大鐵墊圈/縮短磁隙；最終備援＝純機械錐形套筒（無磁） |
| PMS 兩顆個體差 | 佈署前同位共置 24h，記錄偏移量作軟體校正 |
| 電磁鐵過熱 | 脈衝驅動＋佔空比限制已內建；殼體留散熱孔 |
| 學校只有 PLA | U3 買 PETG；或插孔板改木板、僅套筒用鋁 |

---

## 11. 留給下一個對話的開放問題

1. 借到的香爐實際口徑/深度 → 定案集煙罩尺寸（理香陣列格數僅競賽 PoC，見 §0）
2. 5015 風扇實測風量 vs 艙體換氣需求 → 是否需第三顆
3. TFLite 悶燒模型輸入特徵定案（溫度、PM 斜率、CO/CO₂ 比的視窗長度）
4. 慈祐宮若回覆 → 實地佈點方案（Phase 2）
