feihong9487/WRO2026/簡報/Manus指令包_三張A1海報.md

# Manus 指令包 — 三張 A1 海報生成

> **使用方式**：把「═══ 以下全部貼給 Manus ═══」之後整段複製貼給 Manus，
> 並依 §D 的清單一併上傳現有圖檔。產出拿回來放進 `簡報/`，交給 Claude 做事實校對。

## ⚠ 貼之前你要先拍板三件事

1. **信眾人數用 17 億還是 22 億**——與《Manus指令包_3分鐘簡報.md》同一個問題。
   事實庫只敢寫「印度教＋佛教 逾 17 億」；22 億需備妥道教／華人民間信仰來源。
   本包內標為〔待確認〕，Manus 會照你填的用。**兩份文件必須用同一個數字。**
2. **實機照片有沒有拍**——現行三張海報**一張照片都沒有**（已逐張目視確認）。
   Demonstration 15 分＋Team Spirit 15 分共 30 分靠這個。沒拍就先拍。
3. **要不要放 AI 三案對照**——素材齊全（`AI訓練/圖表/`），但全部是模擬。
   放了要標★模擬★，不放則表 14 那格要改寫。

## 為什麼要重做（給你自己看的，不用貼給 Manus）

實測 `學術海報_三張A1_3.pdf`：

| 指標 | 你們規劃書 §3.7／§3.3 的自訂標準 | v3 實際 | v2 實際 |
|---|---|---|---|
| 每張中文字 | 正文 700–900 | 3,005／2,817／**4,023** | 3,005／2,602／2,911 |
| 三張合計 | ≈2,400 | **9,845** | 8,361 |
| 最小內文字級 | 24 pt（可讀 1.7 m） | **12.5 pt**（可讀 0.9 m） | 15.3 pt |
| 圖表數量 | — | **15 圖＋17 表** | 12 圖＋14 表 |

v3 比 v2 **又多了 18% 的字**，字級再降一階。這份指令包的核心目標就是把它壓回可讀範圍。

---

═══════════════════ 以下全部貼給 Manus ═══════════════════

# 任務

為台灣高中生團隊製作 **三張 A1 直式學術海報**（594 × 841 mm，一組三張並排展示）。
賽事：WRO 2026 Future Innovators — Robots Meet Culture（主題：機器人與文化）
與「未來新創家」高中職組。團隊：有拜有包庇（曾翊軒、李承鴻；指導教練 倪瑞鴻、高若瑋）。
專案：**智慧香爐——爐口點源捕集，不改變焚香行為的廟宇空品介入**。

交付：可編輯原始檔（Figma／Illustrator／InDesign 或 HTML+CSS 印刷版）＋ PDF（出血 3 mm、CMYK）。

---

# A. 硬性規格（★違反即需重做★）

現行版本的失敗原因是「內容超載後往字級要空間」，以下限制是為了防止重蹈覆轍。

## A-1 字數上限（不可協商）

| 範圍 | 上限 |
|---|---|
| 每張海報正文總字數 | **≤ 800 個中文字**（不含標題、圖說、表格內文字） |
| 每個模組（一個小節） | **≤ 90 字** |
| 連續段落 | **≤ 4 行** |
| 三張合計正文 | **≤ 2,400 字** |

> 若某個模組寫超過 90 字，代表那件事應該變成一張圖或一個表，不是一段文字。

## A-2 字級下限（不可協商）

| 層級 | 字級 | 字高 | 用途 |
|---|---|---|---|
| 主張句 | 100 pt | 35 mm | **每張只有一句** |
| 海報大標 | 66 pt | 23 mm | I／II／III ＋ 中英文標題 |
| 重點數字 hero | 72 pt | 25 mm | 每張 3–4 個 |
| 區段標題 | 40 pt | 14 mm | 模組標題 |
| 內文 | **24 pt** | 8.5 mm | 段落與條列 |
| 圖說／表格 | 20 pt | 7 mm | |
| 註腳／出處 | **16 pt（絕對下限）** | 5.6 mm | |

**禁止使用上表以外的字級。** 不得為了塞字而使用 22.7 / 20.7 / 19.3 / 16.7 / 15.3 / 12.5 pt
這類中間值——現行版本正是這樣壞掉的。塞不下就刪內容，不准縮字。

## A-3 版面

- 完成尺寸 594 × 841 mm，出血各邊 +3 mm，安全邊界內縮 10 mm，版心 534 × 761 mm
- 6 欄網格：欄寬 79 mm、欄間距 12 mm
- **圖表佔版面 55–65%**（現行版本文字過多，必須反轉比例）
- 每張最多 **6 個模組**、**5 張圖表**（現行 15 圖 17 表必須大幅刪減）
- 三張左上角放三格導引條（●○○／○●○／○○●）

## A-4 字體與配色

- 字體：思源黑體／Noto Sans TC（Regular / Medium / Bold）。公式用 STIX Two Math。
- **禁止楷體、隸書、書法體**——文化題材最容易踩的坑，會讓海報像廟會文宣而非研究成果。
  文化性由內容與配色承擔，不由字體。
- 資料色（最多三系列）：主系列 `#2a78d6` 藍｜對照組 `#eb6834` 橘｜第三對照 `#1baf7a` 綠松
- 狀態色：達標 `#0ca30c`｜⚠ 設計目標 `#fab219`｜不通過／已否決 `#d03b3b`
- 版面色：主文字 `#0b0b0b`｜次文字 `#52514e`｜註腳 `#898781`｜格線 `#e1e0d9`｜紙面 `#ffffff`
- **文化強調色深香色 `#7a3b2e` 只能用在標題帶底線、區段標題前短色條、頁尾細線；
  嚴禁用在任何資料圖表裡。**

## A-5 圖表規範

1. 每張圖最多 3 個系列
2. **絕不使用雙 Y 軸**
3. **直接標註取代圖例**（不要色塊圖例，讀者不必來回對照）
4. 格線 0.25 pt `#e1e0d9`，資料線 2 pt
5. **每張圖的標題是一句結論，不是一個名詞**
   ✗「捕集效率 vs 轉速」→ ✓「轉速已被文化與噪音約束封頂，效率只能靠幾何」
6. 每張圖右下角標資料來源（文獻編號或腳本檔名）
7. **禁止 3D 圖表、圓餅圖、雷達圖、陰影漸層、圖片背景**

---

# B. 三張的敘事分工

一條紅線貫穿三張，**與團隊 3 分鐘口頭簡報同一骨架**：

> 問題嚴重且過去無解 →（I）→ 我們用工程把它解掉 →（II）→ 而且它已經在跑、可以被賣 →（III）

| | I 問題 | II 解法 | III 證據與影響 |
|---|---|---|---|
| 英文標 | THE PROBLEM | THE SOLUTION | EVIDENCE & IMPACT |
| 中文標 | 問題與代價 | 解法與工程 | 證據與影響 |
| 對應口頭簡報 | 第 2–4 頁 | 第 5–8 頁 | 第 9–10 頁 |
| 要讓評審相信 | 有讀文獻、會算、知道哪些不算數 | 東西真的做出來了、每層都有驗證 | 不是科展作品，是有買方、有下一步的產品 |

## 每張的主張句（100 pt 置頂，每張只有一句）

- **I**：`焚香不是「空氣髒」，而是一個邊界可界定的室內點源——因此它可以被工程解掉。`
- **II**：`捕集是「接」的問題，不是「吸」的問題——所以我們先改罩體幾何，才改控制演算法。`
- **III**：`抗議減香政策的同一群人，自願為技術方案付費——需求是被揭示的，不是假設的。`

每張主張句下方放一行英文，給國際評審：

- I: *Incense is not "dirty air" — it is a bounded indoor point source, and therefore an engineering problem.*
- II: *Capture is a matter of interception, not suction; hood geometry outranks airflow rate.*
- III: *The same actors who protested incense-reduction policy voluntarily paid for a technological remedy.*

---

# C. 逐張模組規劃

**格式說明**：`模組名（欄寬 × 高度）｜字數上限｜圖表`

## 第 I 張 — 問題與代價

| # | 模組 | 佔位 | 字數 | 圖表 |
|---|---|---|---|---|
| 1.1 | 文化命題：保存的是**活的儀式** | 6 欄 × 60 mm | 80 | — |
| 1.2 | 問題的量級 | 3 欄 × 150 mm | 70 | 圖 A（新增） |
| 1.3 | ★決定性對照：爐位差三倍 | 3 欄 × 150 mm | 70 | 圖 B（新增） |
| 1.4 | 誰在承受 | 6 欄 × 140 mm | 90 | 圖 C（新增） |
| 1.5 | ★禁香的代價：三個口徑 | 6 欄 × 150 mm | 100 | 圖 D（新增） |
| 1.6 | 誠實邊界 | 6 欄 × 50 mm | 60 | — |
| 1.F | 頁尾（含誠實標示圖例、QR） | 6 欄 × 40 mm | — | — |

**正文合計 ≤ 470 字。** 1.1 必須寫進賽題扣合句：
> 本案保存的不是一件文物，而是一個仍在被數億人每天執行的儀式。
> 技術目標不是減少焚香，而是讓焚香得以在都市化與環保法規下繼續存在。

## 第 II 張 — 解法與工程

| # | 模組 | 佔位 | 字數 | 圖表 |
|---|---|---|---|---|
| 2.1 | 第一性原理：濃度 = 產生 − 移除 | 6 欄 × 70 mm | 60 | — |
| 2.2 | retrofit 定位：不換爐，加裝模組 | 3 欄 × 130 mm | 80 | 已有：`圖_5_retrofit組裝.png` |
| 2.3 | ★反直覺結論：捕集是「接」不是「吸」 | 3 欄 × 130 mm | 90 | 圖 E（新增） |
| 2.4 | ★自我否證：175 → 215 mm | 6 欄 × 130 mm | 90 | 圖 F（新增）＋`_view_集煙罩剖面.png` |
| 2.5 | 系統架構：雙控制器 | 3 欄 × 130 mm | 80 | 已有：`圖_7_系統架構.png` |
| 2.6 | 故障安全階梯（五級） | 3 欄 × 130 mm | 80 | 已有：`圖_8_故障安全階梯.png` |
| 2.F | 頁尾 | 6 欄 × 40 mm | — | — |

**正文合計 ≤ 480 字。**

2.4 是全案最稀有的內容，**必須顯眼**：三項獨立判準同時否證了團隊自己原訂的罩口尺寸。
一般海報只寫成功，這張寫「我們被自己的判準推翻過」——這是最像 IEEE 的地方。

## 第 III 張 — 證據與影響

| # | 模組 | 佔位 | 字數 | 圖表 |
|---|---|---|---|---|
| 3.1 | ★已在真實場域跑起來 | 6 欄 × 150 mm | 90 | 已有：`圖_資料鏈實測_aroma01_CO2.svg`＋`圖_9_儀表板.png`＋`圖_9_QR.png` |
| 3.2 | 驗證體系 L1–L6 | 3 欄 × 120 mm | 70 | 表 G（新增） |
| 3.3 | 單位風量效益：37 倍 | 3 欄 × 120 mm | 80 | 圖 H（新增） |
| 3.4 | 已揭示的付費意願 | 6 欄 × 120 mm | 90 | 圖 I（新增） |
| 3.5 | 商業模式與可複製性 | 6 欄 × 130 mm | 80 | 已有：`圖_商業模式九宮格.svg` |
| 3.6 | 下一步：三件事會讓 ⚠ 變成 ✓ | 6 欄 × 90 mm | 70 | 表 J（新增） |
| 3.F | 頁尾＋團隊照 | 6 欄 × 60 mm | — | 照片（待補） |

**正文合計 ≤ 480 字。**

---

# D. 圖表清單

## D-1 ✅ 已有素材（會一併提供檔案，請直接使用或重繪為印刷向量版）

| 檔案 | 內容 | 用於 | 備註 |
|---|---|---|---|
| `簡報/圖_5_retrofit組裝.png` | retrofit 加裝示意 | 2.2 | |
| `簡報/圖_6_集煙罩剖面.png` | 集煙罩剖面 | 2.4 輔助 | |
| `簡報/圖_7_系統架構.png` | 雙控制器架構 | 2.5 | 另有向量版 `fig_arch.html` |
| `簡報/圖_8_故障安全階梯.png` | 五級故障安全 | 2.6 | 另有向量版 `fig_failsafe.html` |
| `簡報/圖_9_儀表板.png` | Grafana 即時儀表板截圖 | 3.1 | |
| `簡報/圖_9_QR.png` | 公開儀表板 QR | 3.1／頁尾 | |
| `簡報/圖_資料鏈實測_aroma01_CO2.svg` | 真機 CO₂ 實測曲線 | 3.1 | ★圖內「居家環境，非廟宇負載」標示不得移除★ |
| `簡報/圖_商業模式九宮格.svg` | 商業模式九宮格 | 3.5 | ⚠ 標記為未驗證假設的欄位不得移除 |
| `外觀CAD/_view_組裝.png` | CAD 組裝算繪 | 2.2／2.4 | |
| `外觀CAD/_view_剖面.png` | CAD 剖面 | 2.4 | |
| `外觀CAD/_view_集煙罩剖面.png` | 集煙罩剖面算繪 | 2.4 | |
| `簡報/簡報圖片/*.jpg` | 廟宇焚香情境照 9 張 | 1.1 背景 | 僅可當低透明度背景，不得壓過文字 |
| `AI訓練/圖表/B_*.png` | AI B 案訓練圖 | 選用 | ★全部為模擬，用了必須標示★ |

## D-2 🆕 需新增的圖表（資料在 §E，請依 A-5 規範製作）

| 代號 | 標題（用結論句，不用名詞） | 型式 | 資料 |
|---|---|---|---|
| **圖 A** | 殿內常態濃度已超標，峰值只是極端 | 水平長條＋標準線（對數） | E-1 |
| **圖 B** | 爐位差異造成 2.66 倍濃度差——被動關係已如此，主動控制空間更大 | 兩組帶誤差長條 | E-2 |
| **圖 C** | 傷害集中在少數人身上，差距達三個數量級 | 對數水平長條 | E-3 |
| **圖 D** | 禁香的帳單，由最沒有能力付的人承擔 | 三欄圖示統計 | E-4 |
| **圖 E** | ★煙羽不是被「吸」進罩內，是靠自身浮力上升到罩口被「承接」 | 折線（兩條速度曲線） | E-5 |
| **圖 F** | ★三項獨立判準同時否證了我們自己原訂的罩口 | 折線＋門檻線＋前後對照 | E-6 |
| **圖 G** | 四層靜態驗證全綠，兩層待實測 | 檢查表卡片（表格） | E-7 |
| **圖 H** | 以 1/11.5 的風量達成 3.22 倍減量 | 三情境長條 | E-8 |
| **圖 I** | 抗議減香的同一群人，自費五百萬買碳權 | 時間軸＋對比數字 | E-9 |
| **圖 J** | 下一步：三件事會讓所有 ⚠ 變成 ✓ | 里程碑表 | E-10 |

## D-3 ❌ 現行版本中請「不要」搬過來的內容

以下在 v3 存在，但為了達成字數目標必須刪除或大幅壓縮：

- 燃燒化學計量式 (1)–(3)（海報自己說「不描述實際發生的事」）
- 主要反應物與產物之莫耳質量表（教科書數據）
- PAH 生成路徑的詳細機制段落（壓成一句結論）
- 線香質量組成表＋成分化學組成（壓成一張圖或直接刪）
- 文獻報告之線香燃燒產物類別表
- 損失函數完整式與對偶上升前後對照表（壓成一句：文化約束寫成硬約束）
- 單因子敏感度圖（改成一句話：橫流是全案最脆弱單點）
- 四維雷達圖（與四維比較表重複，且四軸單位不可加、面積無意義）
- 治理拓撲對照表、感測器選型與化學依據表（壓成 2.5 模組的一行）

---

# E. 數據庫（★所有數字必須照這裡，不得自行推算或美化★）

**誠實標示分類**（每個數字都要屬於其中一類，並在海報上以圖示標明）：

| 圖示 | 類別 | 定義 | 顏色 |
|---|---|---|---|
| ◆ | **文獻** | 同儕審查研究或官方統計，附編號 | `#0b0b0b` |
| ✓ | **實測** | 本團隊實機量測所得 | `#0ca30c` |
| ⚠ | **設計目標** | 由未實測參數推算，**不得表述為實測結果或已達成成效** | `#fab219` |
| ○ | **示範性估算** | 以假設情境說明量級，非預測 | `#898781` |

## E-1 問題的量級（圖 A）

| 項目 | 數值 | 標示 |
|---|---|---|
| 廟宇殿內 PM₂.₅ 常態均值 | 97.0 ± 65.4 µg/m³ | ◆ |
| 我國年平均標準 | 35 µg/m³ | ◆ |
| WHO 指引值 | 15 µg/m³ | ◆ |
| 插香近場瞬時峰值 | 1,360 µg/m³ | ◆ **必須標註「單日攜帶式觀測，非同儕審查，僅取量級指示意義」** |
| 全台年焚香量 | 約 2.1 萬公噸 | ◆ |
| 超標倍率 | 常態即為我國標準 2.8 倍、WHO 指引 6.5 倍 | ◆ |

## E-2 決定性對照（圖 B）

同一研究同時量測香品與焚香行為相近、僅爐位不同的兩座廟宇：

| 爐位 | 殿內 PM₂.₅ | 標示 |
|---|---|---|
| 爐設於室外 | 36.5 µg/m³ | ◆ |
| 爐設於室內 | 97.0 µg/m³ | ◆ |
| 差異 | **× 2.66** | ◆ |

結論句：被動的空間關係已造成 2.66 倍差異——主動氣流控制的效益空間因而確立。

## E-3 誰在承受（圖 C）

年累積暴露量 E（µg·h·m⁻³，對數縱軸）。**工時與參拜頻率為示範性假設，非實地調查值。**

| 族群 | 年累積暴露量 | 標示 |
|---|---|---|
| 偶訪香客 | 2.1 × 10² | ○ |
| 常態信眾 | 7.4 × 10³ | ○ |
| 駐廟人員 | 1.9 × 10⁵ | ○ |

雙區模型：`E = C_NF · t_NF + C_FF · t_FF`
兩類保護對象暴露來自不同機制：香客承受插香瞬間之近場尖峰，駐廟人員承受長時間之遠場累積。

## E-4 禁香的代價（圖 D）

| 口徑 | 承受者 | 可追溯之量級 | 標示 |
|---|---|---|---|
| 需求端轉型損失 | 宮廟營運 | 龍山寺推動減香期間，香客一度減少約 **三成**，歷時約 **4 年**才回升 | ◆ |
| 供給端合規成本 | 廟方資本支出 | 北港武德宮環保金爐歷時 **6 年**建成；另斥資約 **NT$5,000,000** 購入碳權 | ◆ |
| 產業端生計衝擊 | 手工捲香從業者 | 印度 agarbatti 產業從業人數各方估計 **40–200 萬人**，各來源一致指出其中約 **八成為女性** | ◆ |
| 健康外部性 | 全社會 | **本研究未予貨幣化**（見下方說明） | — |

**必須寫上的誠實聲明**（≤ 45 字）：
> 本研究不將健康成本貨幣化——需要大型世代研究確立劑量–反應關係並套用在地統計生命價值，
> 兩者皆超出本團隊能力，勉強估算只會產生看似精確、實則無法辯護的數字。

## E-5 捕集是「接」不是「吸」（圖 E）

依吸氣點源之勢流解，罩口前距離 x 處之誘導風速：`v(x) = Q / [4π x² + A_hood]`，隨 x⁻² 衰減。

| 距罩口 | 誘導風速 : 煙羽上升速度 | 標示 |
|---|---|---|
| 100 mm | **1 : 8** | ⚠ |
| 200 mm | **1 : 22** | ⚠ |

熱浮力煙羽上升速度 ≈ **1.04 m/s**（⚠）。罩口內徑 **215 mm**、半徑 107 mm。

結論句：煙羽並非被「吸」入罩內，而是靠自身浮力上升至罩口被「承接」。
既然誘導風速在 100 mm 外已不足以改變煙羽軌跡，提高風量對捕集率的邊際效益極低；
決定成敗的是罩口是否座落在煙羽必經之路上。**此判準把工程資源的第一優先指向罩體幾何。**

## E-6 自我否證（圖 F）

三項獨立判準——煙羽幾何、橫流漂移、ACGIH 面風速建議——**同時指出原訂 175 mm 罩口無法承接煙羽**。

| 項目 | 原設計 | 定案 | 標示 |
|---|---|---|---|
| 罩口內徑 | 175 mm ✗ | **215 mm** ✓ | ⚠ |
| 規格攔截高度 | — | h_spec = 0.18 m | ⚠ |
| 側裙 | 選配 | **升格為必要件（三面）** | ⚠ |

橫流 0.25 m/s 下煙羽於攔截高度處之橫向漂移（⚠ 設計值）：

| 同時燃燒支數 N | 1 | 2 | 5 | 9 | 20 |
|---|---|---|---|---|---|
| 橫向漂移（mm） | **169** | 134 | 119 | 108 | 82 |

**最不利工況為 N = 1 而非尖峰負載**：單支香之煙羽動量最小，漂移達 169 mm，接近罩口半徑
（107 mm）之兩倍。此與「以尖峰負載為設計點」之直覺相反。

**必須併寫的一句話**（避免與下段矛盾）：
> N = 1 是**幾何失效**（接不到），N = 20 是**容量失效**（接到了但效率不足）——
> 側裙解前者，罩口尺寸與風道解後者。

**這一節的核心訊息**：此否證由本研究自身的判準產生，而非由外部審查指出。

## E-7 驗證體系（表 G）

| 層級 | 項目 | 狀態 | 標示 |
|---|---|---|---|
| L1 | 韌體靜態檢查 | 通過（flash 36%／RAM 44%） | ✓ |
| L2 | 資料流欄位契約 | 通過 | ✓ |
| L3 | 電路 ERC（17 網路） | 0 錯誤 | ✓ |
| L4 | 雲端驗收 C1–C12 | 12／12 | ✓ |
| L5 | 氣流特性曲線 η(u)、h(u)、SPL(u) 實測 | **未執行** | ⚠ |
| L6 | ASHRAE 110 示蹤圍阻測試 | **未執行** | ⚠ |

**必須寫上**：L5–L6 尚未執行，因此所有以 η、h、SPL 為輸入之數值均為**設計值**，
不得表述為實測結果。

## E-8 單位風量效益（圖 H）

穩態質量平衡：`dC/dt = [N·g·(1−η(u)) − (Q + CADR(u))·(C − C_bg)] / V`
令 dC/dt = 0 並代入 C = 35 µg/m³，得所需捕集效率 **η ≈ 0.80**，
對應系統風量僅 **56.5 m³/h**——不足家用空氣清淨機典型 CADR 的 1/8。

| 情境 | 殿內 PM₂.₅ 穩態濃度 | 標示 |
|---|---|---|
| 無系統 | 97.0 µg/m³ | ◆ |
| 商用清淨機 CADR 500 | 77.8 µg/m³ | ⚠ |
| **本系統 56.5 m³/h** | **35.0 µg/m³** | ⚠ |

風量比 **1/11.5**、減量倍率 **3.22×**、單位風量效益比約 **37 倍**。

**★圖說必須標註 N 值，並加上這句★**（否則與下段自相矛盾）：
> 本系統情境對應 η = 0.80；依約束分析，該效率在 N ≥ 9 時已超出轉速上限 η_max = 0.597，
> 缺口須由罩體幾何補足。

**約束封頂（可放在同一模組的小字）**：在儀式與噪音約束下，最大可用轉速 u_max = 0.58
對應 η = 0.597；反推尖峰負載達標所需效率 N=9 需 0.756、N=14 需 0.843、N=20 需 0.890，
**缺口最大 +0.293**。提升轉速之路徑已被約束封頂，唯一出路是提升罩體幾何。

## E-9 已揭示的付費意願（圖 I）

| 時間 | 事件 | 標示 |
|---|---|---|
| 2017-01 | 環保署長受訪呼籲「減香」，經媒體誤植為「滅香」後擴散 | ◆ |
| 2017-07-23 | 北港武德宮發起、上百間宮廟組成「捍衛信仰守護香火大聯盟」上凱達格蘭大道遊行 | ◆ |
| — | 該聯盟訴求內容：接受「一爐一香」為環保底線，主張政府應**「鼓勵並輔導寺廟添購設備」** | ◆ |
| 2024-09 | **同一個北港武德宮**自費啟用歷時六年建成之環保金爐，並斥資約 **五百萬元**購入國際碳權 | ◆ |

結論句：**信仰社群反對的不是環保本身，而是強制與剝奪**；他們主動要求的，
正是可安裝於廟宇現場的減污設備。抗議減香政策的同一群人，自願為技術方案付費。

## E-10 下一步（表 J）

| 階段 | 工作 | 完成判準 | 標示 |
|---|---|---|---|
| M1 | 實測 η(u)、h(u)、SPL(u) 三條特性曲線；以廟方人員與香客訪談取得可接受之煙柱高度下限 h_min | L5 通過；損失函數三個函數改為量測值，**h_min 由使用者認定而非團隊自訂** | ⚠ |
| M2 | ASHRAE 110 示蹤圍阻測試（2×2 因子設計）；殿內橫流速度實測 | L6 通過；側裙設計所依賴的橫流假設轉為實測值 | ⚠ |
| M3 | 廟宇實地佈點與長期資料蒐集；定價三項假設之訪談驗證 | 取得外部效度；商業模式三項可檢驗命題獲得訪談支持或修正 | ⚠ |

**必須寫上**：M2 完成後，海報中所有標示「設計值」之數字即可改列為實測值；
在此之前一律維持標示，不表述為成果。

## E-11 系統規格（散落於 II、III 兩張）

| 項目 | 內容 | 標示 |
|---|---|---|
| 架構 | 雙控制器：Raspberry Pi 5（決策層）＋ MATRIX Mini R4（即時／安全層），I²C，1 Hz 上雲 | ✓ |
| 感測 | CO₂ NDIR 紅外吸收（SCD41）／溫濕度 SHT31／爐面溫度 K 型熱電偶 MAX6675 | ✓ |
| 感測選型理由 | 半導體式氣體感測器對酒精與煙氣干擾嚴重，在線香環境近乎失明；NDIR 量測 CO₂ 分子真實紅外吸收，穩定、不中毒、壽命長。**選型是化學推導的結果，不是價格比較的結果。** | — |
| 過濾鏈 | 金屬紗網（火星前濾）→ HEPA → 活性碳，風扇置於濾鏈之後（抽拉式） | ✓ |
| 致動 | 5015 鼓風機 × 2，PWM 經 D4184 | ✓ |
| 資料鏈 | MQTT → Telegraf → InfluxDB → Grafana，3 個公開唯讀儀表板（免帳密） | ✓ |
| 原型成本 | BOM < NT$4,200（**單機物料成本，非量產售價**） | ✓ |
| 對照 | 現行最佳方案（碳中和金爐）資本支出約 NT$5,000,000（僅碳權），建置週期 6 年；本案數週 | ◆ |
| 上線時間 | 2026 年 8 月原型於真實場域上線，資料每秒進雲端 | ✓ |

## E-12 〔待你確認〕市場規模

信眾人數：**〔填 17 億 或 22 億〕**
- 17 億＝印度教＋佛教，有可靠統計
- 22 億＝含道教與華人民間信仰，**需備妥來源才能用**

跨國效度：東亞與南亞季風帶——越南、中國東南沿海、印度、東南亞諸國——
同時具備高密度焚香實踐與相同的季風擴散機制；印度十座廟宇實測 PM₂.₅ 達 658.3 µg/m³（◆）。

---

# F. 誠實標示規範（★這是本團隊的簽名，不可省略★）

1. 三張海報**頁尾帶必須有一致的誠實標示圖例**（見 §E 的四類）。
2. 三張頁首必須有橫幅：`數值分三類：文獻值附參考編號｜實測值文中明示｜設計值未經實測，不得表述為成果`
3. **η ≈ 0.80、減量 3.22×、效益比 37 倍、35.0 µg/m³ 一律標 ⚠ 設計目標，
   絕不可寫成「達成」「實現」「已降低」。**
4. 峰值 1,360 µg/m³ 必須標「單日攜帶式觀測，非同儕審查，僅取量級指示意義」。
5. 不宣稱焚香為一級致癌物，只陳述其成分含已被 IARC 分級之物質。
6. 任何模擬資料（AI 訓練圖、模擬爐 aroma02）必須標「模擬」。
7. `圖_資料鏈實測_aroma01_CO2.svg` 內的「居家環境 CO₂，非廟宇負載」標示**不得移除**。

> 這一節不是自我設限，是**得分項**。評分表的 Research 項裡「知道自己不知道什麼」
> 是最難假裝的一項；多數隊伍會把設計目標寫成成果，而我們在海報上就把界線畫出來。

---

# G. 交付檢查表（請 Manus 自行核對後再交付）

- [ ] 每張正文 ≤ 800 中文字，三張合計 ≤ 2,400
- [ ] 沒有任何文字小於 16 pt，內文一律 24 pt
- [ ] 只使用 §A-2 表列的 7 種字級，無中間值
- [ ] 每張 ≤ 6 模組、≤ 5 圖表
- [ ] 圖表佔版面 55–65%
- [ ] 每張圖標題是結論句，右下角有資料來源
- [ ] 無 3D／圓餅／雷達／漸層／書法體
- [ ] 深香色未出現在任何資料圖表中
- [ ] 所有 ⚠ 設計目標數字皆已標示，無一被寫成已達成
- [ ] 頁尾有誠實標示圖例與 QR

═══════════════════ 貼給 Manus 的內容到此結束 ═══════════════════

---

## 附：要一併上傳給 Manus 的檔案清單

```
簡報/圖_5_retrofit組裝.png
簡報/圖_6_集煙罩剖面.png
簡報/圖_7_系統架構.png
簡報/圖_8_故障安全階梯.png
簡報/圖_9_儀表板.png
簡報/圖_9_QR.png
簡報/圖_資料鏈實測_aroma01_CO2.svg
簡報/圖_商業模式九宮格.svg
外觀CAD/_view_組裝.png
外觀CAD/_view_剖面.png
外觀CAD/_view_集煙罩剖面.png
簡報/簡報圖片/（挑 2–3 張廟宇焚香情境照即可，不用全上）
＋ 實機照片與團隊照（★待你補拍★）
```

## 拿回產出後的 QA 重點

1. 跑字數與字級量測，確認真的壓到 ≤ 800 字／張、無小於 16 pt 的字。
2. 逐一核對 §E 的每個數字，特別是 ⚠ 類有沒有被寫成成果。
3. 確認圖 H 的圖說有標 N 值——這是 v2／v3 都存在的內部矛盾。
4. 確認實機照片與團隊照有放進去。
