feihong9487/WRO2026/簡報/海報規劃書_三張A1.md

# WRO 2026 智慧香爐｜三張 A1 直式海報 規劃書

**版本** v1.0（2026-08-16）　**組別** Future Innovators – Senior　**語言** 全繁體中文
**賽事** WRO 2026 European Open Championship（Robots Meet Culture）
**產出定位** 版面規劃書＋低保真版型預覽；本書定稿後才進排版

> **狀態（2026-08-18）**：實際海報 `學術海報_三張A1_2.pdf` 已改採 I–XVII 章節結構與
> SENIOR I/II/III 命名，圖表 12 張——與本書 §4 的 1.1–3.8 模組編號、§5 的 21 張圖表清單
> 已不對應。**§4、§5 僅供追溯**；**§1.3 展位方案、§3 版面系統（印刷規格／字級–觀看距離
> 驗算／配色驗證）、§6 誠實標示規範仍為現行有效規範。**
> 對現行 PDF 的逐條修正見《海報修正清單_v2.md》。

---

## 0. 三句話總結

1. **三張海報＝三種專業身分**：P1 你是研究者、P2 你是工程師、P3 你是創業者。裁判在 10 分鐘內要能從任一張切入，都看到「這隊有能力，而且誠實」。
2. **學術專業性不靠字多，靠三件事**：**可重現的數字**（每個關鍵值都指得出來源腳本或文獻）、**顯式的誠實邊界**（哪些是實測、哪些是設計目標）、**被自己推翻過的結論**（3-8 推翻了自己的罩體尺寸）。第三項最稀有，也最像 IEEE。
3. **每張海報只有一個主張句**，其餘所有圖表都是它的證據。主張句用 100 pt 印在最上面，站在 3 公尺外就能讀完三張海報的論證鏈。

---

## 1. 對齊依據（已查證規則）

### 1.1 賽題落點：Robots Meet Culture — Area 1

WRO 2026 Future Innovators 的三個方向中，本案精準落在 **Area 1「保護與保存文化資產」**，且是其中少見的「保存**活的**文化實踐」而非「保存文物」。

> **必須寫上海報的一句話**：本案保存的不是一件文物，而是一個**仍在被數百萬人每天執行的儀式**。技術目標不是減少焚香，而是讓焚香得以在都市化與環保法規下**繼續存在**。

賽題文件同時要求「尊重文化真實性、與社群及專家共同工作」——這正好對應本專案已有的兩項設計決定，**必須顯眼呈現**：

- **$h_{min}$ 由廟方認定，不由團隊設定**（3-8.13 的術語拆分）。
- **文化約束寫成硬約束（拉格朗日乘子），不是可加權交易項**（3-7 §3）。

這兩點是本案對「文化真實性」最強的技術性回應，且是其他隊伍幾乎不可能有的東西。

### 1.2 Senior 評分表（200 分）與三張海報的覆蓋

| 大項 | 子項 | 分數 | 主要承載海報 |
|---|---|---:|---|
| Project & Innovation (75) | Idea / Creativity | 20 | **P1** ＋ P3 |
| | Research | 15 | **P1** |
| | Social Impact | 10 | P1 ＋ **P3** |
| | Innovation | 10 | **P2** ＋ P1 |
| | Entrepreneurship | 10 | **P3** |
| | Next Steps | 10 | **P3** |
| Robotic Solution (70) | Engineering | 15 | **P2** |
| | Code | 10 | **P2** |
| | Demonstration | 15 | **P2**（＋實機） |
| Presentation & Team (55) | Technical Understanding | 15 | 三張皆是提詞卡 |
| | Team Spirit | 15 | P3 頁尾 |

評分方式為每項 0–10 分後按比例換算。**推論：沒有任何一項超過 20 分，所以海報不能把 80% 版面給最喜歡的技術細節。** 版面配額應大致對齊分數配額——這是本規劃書分區字數的依據。

### 1.3 展位規範與 A1 的尺寸警訊 ⚠

規則載明展位為 **2m × 2m × 2m，含三個垂直展示面**；資訊以海報、顯示器或其他材料呈現；桌子 120×60 cm 選配。

**問題**：A1 直式為 594 × 841 mm。一張 A1 掛在 2000 mm 寬的立面上，**只覆蓋 30% 寬度、42% 高度**，遠看會顯得單薄，且三面之間缺乏連續感。

**三個處理方案（請擇一）**：

| 方案 | 做法 | 成本 | 建議 |
|---|---|---|---|
| **A**（建議） | 維持 A1×3，每面上方加一條 **1900×250 mm 橫幅**（隊名／專案名／一句主張），A1 置中掛於橫幅下方，左右留白處貼 **A3 補充卡**（實機照、QR、獎狀／訪談紀錄） | 低 | 保留 A1 的可攜性與印刷成本，同時填滿立面 |
| **B** | 改印 A0 直式（841×1189）×3 | 中 | 視覺最完整，但單張資訊量易失控、運輸不便 |
| **C** | 維持 A1×3 不動 | 最低 | 內容仍完整，但展位氣勢弱於同級隊伍 |

**本規劃書以方案 A 撰寫**，橫幅內容已列入 §3.6。若你選 B 或 C 告訴我，分區配額我再調。

---

## 2. 三張海報的敘事分工

一條紅線貫穿三張：**問題是可界定的物理問題 →（P1）→ 我們用工程把它解掉 →（P2）→ 而且它可以被賣、被複製、被延續 →（P3）。**

每張海報**左上角**印一個小小的三格導引條（●○○／○●○／○○●），讓裁判無論從哪張切入都知道自己在論證鏈的哪一段。

### P1 — SCIENCE｜科學：問題界定與物理路線

**主張句（100 pt，置頂）**
> 焚香不是「空氣髒」，而是一個**邊界可界定的室內點源**——因此它可以被工程解掉。

**這張要讓裁判相信**：這隊有讀文獻、會算、而且知道自己算的哪些不算數。
**承載分數**：Research 15、Idea/Creativity 20（前半）、Social Impact 10（前半）。

### P2 — ENGINEERING｜工程：系統實作與驗證

**主張句**
> 捕集是「**接**」的問題，不是「吸」的問題——所以我們先改罩體幾何，才改控制演算法。

**這張要讓裁判相信**：東西真的做出來了、真的通電了、而且每一層都有驗證腳本。
**承載分數**：Engineering 15、Code 10、Demonstration 15、Innovation 10、Technical Understanding 15。

### P3 — ENTERPRISE｜企業：影響力、商業模式與下一步

**主張句**
> 我們賣的不是乾淨的空氣，而是**可被證明的乾淨**。

**這張要讓裁判相信**：這不是科展作品，是有買方、有單位經濟、有下一步的產品。
**承載分數**：Entrepreneurship 10、Next Steps 10、Social Impact 10（後半）、Team Spirit 15。

---

## 3. 版面系統（三張共用）

### 3.1 印刷規格

| 項目 | 值 |
|---|---|
| 完成尺寸 | 594 × 841 mm（A1 直式） |
| 出血 | 各邊 +3 mm → 工作檔 600 × 847 mm |
| 安全邊界 | 距裁切線內縮 10 mm，**所有文字與關鍵圖形不得越界** |
| 版心（可用範圍） | 534 × 761 mm（上下左右各 30 mm 邊界） |
| 解析度 | 點陣圖 ≥ 150 dpi＠原尺寸；**圖表一律向量**（SVG／PDF） |
| 色彩模式 | 送印前轉 CMYK；本規劃書色票為 sRGB，需請印廠做 profile 轉換 |
| 紙材建議 | 200 g 霧面合成紙或霧面相紙（**避免亮面**——展場燈光反光會讓裁判讀不到內文） |

### 3.2 網格

**6 欄 × 模組列**：欄寬 79 mm、欄間距 12 mm（6×79 + 5×12 = 534 ✓）。
垂直方向以 12 mm 為基準單位，所有區塊高度取其整數倍。

固定的垂直分區（三張一致，這是「一整套」的視覺基礎）：

| 帶 | 高度 | 內容 |
|---|---:|---|
| 標題帶 | 120 mm | 導引條、海報編號、大標題、主張句 |
| 內容帶 | 601 mm | 8–9 個模組（見 §4 逐張分區） |
| 頁尾帶 | 40 mm | 隊名／學校、QR、誠實標示圖例、頁碼 |

### 3.3 字級階層（含 A1 觀看距離驗算）

裁判閱讀距離：主張句約 3 m、內文約 0.8–1.2 m。經驗判準為**字高 ≥ 觀看距離 / 200**。

| 層級 | 字級 | 字高 | 可讀距離 | 用途 |
|---|---:|---:|---:|---|
| 主張句 | 100 pt | 35 mm | 7.0 m ✓ | 每張一句，只有一句 |
| 海報大標 | 66 pt | 23 mm | 4.6 m | SCIENCE／ENGINEERING／ENTERPRISE ＋中文 |
| 區段標題 | 40 pt | 14 mm | 2.8 m | 各模組標題 |
| 重點數字（hero） | 72 pt | 25 mm | 5.0 m | 每張 3–4 個關鍵數字 |
| 內文 | 24 pt | 8.5 mm | 1.7 m ✓ | 段落與條列 |
| 圖說／表格 | 20 pt | 7 mm | 1.4 m | 圖表標題與軸標 |
| 註腳／出處 | 16 pt | 5.6 mm | 1.1 m | 文獻編號、⚠ 標示、腳本檔名 |

**字體**：思源黑體／Noto Sans TC（Regular / Medium / Bold 三重量足夠）。
公式用 Latin Modern Math 或 STIX Two Math（**不要用 Word 的 Cambria Math 轉圖**，會糊）。
**禁止**：楷體、隸書、書法體。文化題材最容易踩的坑就是用書法體標題——那會讓海報看起來像廟會文宣而不是研究成果。文化性由**內容與配色**承擔，不由字體。

**行長控制**：內文單行不超過 **32 個中文字**（≈ 兩欄寬 170 mm）。超過就分欄。

### 3.4 配色（已跑過驗證）

**資料色（三系列上限，已通過全對驗證）**

| 角色 | 色票 | 用途 |
|---|---|---|
| 系列 1 | `#2a78d6` 藍 | 主系列／本系統 |
| 系列 2 | `#eb6834` 橘 | 對照組／無系統 |
| 系列 3 | `#1baf7a` 綠松 | 第三對照（如商用清淨機） |

> 驗證結果（`validate_palette.js`，light 模式、白紙面）：色盲分離度最差對 ΔE 9.2、正常視覺最差對 ΔE 24.0，**全數通過**。綠松色對白紙對比 2.82:1 未達 3:1 → **強制規定：所有圖表使用直接標註（direct label），不使用需來回對照的圖例色塊。** 這在海報上本來就是正確做法。

**狀態色（保留，不得當第四系列用）**

| 角色 | 色票 | 用途 |
|---|---|---|
| 達標／通過 | `#0ca30c` | ✓ 驗收通過、達標 |
| 警示 | `#fab219` | ⚠ 設計目標（未實測） |
| 不通過 | `#d03b3b` | ✗ 溢流、未達標、已被推翻的設計 |

**版面色（非資料）**

| 角色 | 色票 |
|---|---|
| 主文字 | `#0b0b0b` |
| 次文字 | `#52514e` |
| 註腳／軸標 | `#898781` |
| 格線 | `#e1e0d9` |
| 紙面 | `#ffffff` |
| **文化強調色（僅用於標題帶與分隔線，嚴禁用於資料）** | 深香色 `#7a3b2e` |

> 深香色是全案唯一的「文化訊號」，只出現在標題帶底線、區段標題前的短色條、頁尾細線。**一旦它出現在長條圖裡，整張海報的資訊層級就崩了。**

### 3.5 圖表規範（不可違反）

1. **每張圖最多 3 個系列。** 第 4 個一律併為「其他」或改做小倍數圖。
2. **絕不使用雙 Y 軸。** 兩個尺度不同的量→兩張圖或指數化到同一基準。
3. **直接標註取代圖例**（見 §3.4）。
4. **格線與座標軸是背景**：格線 0.25 pt `#e1e0d9`，資料線 2 pt。
5. **每張圖的標題是一句結論，不是一個名詞。** ✗「捕集效率 vs 轉速」→ ✓「轉速已被文化與噪音約束封頂，效率只能靠幾何」。
6. **每張圖右下角標資料來源**：`flow_analysis.py §4` 或 `Hien et al. 2022`。這是本海報學術感的最大來源。
7. 3D 圖表、圓餅圖、陰影漸層、圖片背景 — **全部禁止**。

### 3.6 共用元素

**頁首橫幅（方案 A，1900 × 250 mm ×3，每面立面一條）**
左：隊名／學校／國家旗　中：**智慧香爐 Intelligent Incense Censer**　右：WRO 2026 Robots Meet Culture 標記與組別。三條橫幅底色使用深香色，是三面立面的視覺縫合線。

**頁尾帶（每張 A1 底部 40 mm）**
- 左：隊名、學校、指導老師
- 中：**誠實標示圖例**（見 §6）——這一小塊圖例是本案的簽名
- 右：QR（① 完整報告 PDF ② 即時空品公開儀表板 ③ GitHub）

> QR 一定要放**即時儀表板的公開連結**（Grafana Public Dashboard）。裁判當場掃出一個活的、每秒更新的資料看板，比任何一張截圖都有說服力。**掃描前務必確認 Tailscale Funnel 在賽場網路可達，並準備離線截圖備援。**

### 3.7 圖文比與字數配額

| 指標 | 目標 |
|---|---|
| 圖表／示意圖佔版面 | **55–65%** |
| 內文（正文段落）總字數 | **每張 700–900 個中文字**（含條列，不含標題與圖說） |
| 每個模組內文 | ≤ 120 字 |
| 連續段落最長 | 4 行 |

> 若某模組寫超過 120 字，代表那件事應該變成一張圖。

---

## 4. 逐張分區規劃

「佔位」＝欄數 × 模組高度（mm）。模組間垂直間距 12 mm。**三張的模組高度總和已核算，皆落在內容帶 601 mm 之內**（P1 592、P2 600、P3 592，含間距與上緣留白），可直接照抄進排版軟體。

> **全寬（6 欄）模組的文字必須分兩欄排。** 6 欄寬 534 mm ÷ 24 pt 字寬 ≈ 62 字／行，遠超 §3.3 的 32 字上限，單欄滿版排會讓眼睛跳行。半寬（3 欄，261 mm）模組約 30 字／行，可單欄。

### P1 — SCIENCE｜科學

| # | 模組 | 佔位 | 內容要點 | 字數 | 圖 |
|---|---|---|---|---:|---|
| 1.0 | 標題帶 | 6 欄 × 120 mm | 導引條 ●○○／`SCIENCE 科學`／主張句 | — | — |
| 1.1 | 文化命題 | 6 欄 × 48 mm | 賽題扣合：保存的是**活的儀式**；不禁香、不封爐是設計前提，不是妥協 | 90 | — |
| 1.2 | 問題的量級 | 3 欄 × 88 mm | 三個 hero 數字：殿內均值 **97 µg/m³**、我國標準 **35**、峰值 **1,360**（標註非同儕審查）；全台年焚香 2.1 萬公噸 | 60 | 圖 1-1 |
| 1.3 | 決定性對照 | 3 欄 × 88 mm | Hien 2022 同時量測室內外爐：**36.5 vs 97.0**——同樣的香、同樣的行為，只因爐位差三倍 → **主動氣流控制的效益空間存在** | 80 | 圖 1-2 |
| 1.4 | 治理拓撲 | 6 欄 × 76 mm | 線香 vs 二手菸 vs 車輛廢氣的六維對照表；洞見：線香是**固定點源**，適合源頭捕集而非稀釋 | 60 | 表 1-3 |
| 1.5 | 誰在受害 | 3 欄 × 96 mm | 雙區暴露模型 $E = C_{NF}t_{NF} + C_{FF}t_{FF}$；三類人群年累積暴露量差 **兩個數量級**（209 / 7,401 / 194,000） | 90 | 圖 1-4 |
| 1.6 | 時空耦合 | 3 欄 × 96 mm | 農曆尖峰（事件日 ×2 倍）×東北季風擴散低谷 → **被動策略在最需要時失效** | 90 | 圖 1-5 |
| 1.7 | ★ 反直覺結論 | 6 欄 × 100 mm | **捕集是「接」不是「吸」**：罩前誘導風速隨 $x^{-2}$ 衰減，100 mm 處僅 0.13 m/s，是煙羽速度的 1/8。煙羽靠**自身浮力**送到罩口 → 罩口幾何 ≫ 風量 | 110 | 圖 1-6 |
| 1.8 | 量化目標 | 6 欄 × 60 mm | 穩態質量平衡 → $\eta \approx 80\%$ 可將 97 降至 35；系統風量僅 **56.5 m³/h**（不到家用清淨機 1/8） | 70 | 圖 1-7 |
| 1.9 | 誠實邊界 | 6 欄 × 40 mm | 本研究**不宣稱因果**，採預防原則；⚠ 標示之參數為設計目標 | 70 | — |
| 1.F | 頁尾 | 6 欄 × 40 mm | 見 §3.6 ／文獻清單 6–8 筆 | — | — |

**P1 內文合計 ≈ 720 字。**

### P2 — ENGINEERING｜工程

| # | 模組 | 佔位 | 內容要點 | 字數 | 圖 |
|---|---|---|---|---:|---|
| 2.0 | 標題帶 | 6 欄 × 120 mm | ○●○／`ENGINEERING 工程`／主張句 | — | — |
| 2.1 | 系統架構 | 6 欄 × 108 mm | 兩板架構方塊圖：**Pi 5**（決策＋審計＋雲端）↔ **MATRIX Mini R4**（感測＋安全＋致動）；感測 SCD41／SHT31／MAX6675；致動 5015 鼓風機×2 → D4184；雲端 MQTT→Telegraf→InfluxDB→Grafana | 100 | 圖 2-1 |
| 2.2 | 故障安全階梯 | 3 欄 × 92 mm | 雲斷 → Pi 本地續跑｜Pi 失效 → R4 本地簡化 FSM（**仍有 CO₂ 讀值，可做真回饋控制**）｜R4 溫度聯鎖為最後底線 | 90 | 圖 2-2 |
| 2.3 | ★ 自我推翻 | 3 欄 × 92 mm | 三項獨立判準（煙羽幾何／橫流漂移／ACGIH）**同時指出原罩口 175 mm 接不住煙羽** → 175 → 215 mm、$h_{spec}$ 定 0.18 m、新增三面側裙 | 100 | 圖 2-3 |
| 2.4 | 最脆弱工況 | 3 欄 × 80 mm | $w \propto N^{1/3}$ → **最惡劣是 1 支香，不是尖峰**；橫流 0.25 m/s 下漂移 169 mm ≈ 罩口半徑兩倍 → 側裙自「選配」升格「必要件」 | 90 | 圖 2-4 |
| 2.5 | 控制策略 | 3 欄 × 80 mm | 時間尺度分離 **7,013 倍**（罩內 0.17 s／殿堂 19.4 min）→ 串級控制；CO₂ 斜率先行數分鐘 → **前饋是必要件不是加分項** | 90 | 圖 2-5 |
| 2.6 | ★ 損失函數 | 6 欄 × 92 mm | $\mathcal{L}$ 四項＋拉格朗日約束；**文化約束寫成硬約束而非加權項**：固定權重下四種負載全數違反噪音／煙柱；對偶上升後 $u^*$ 收斂 0.58–0.59，**約束全數滿足** | 110 | 表 2-6 |
| 2.7 | 驗證體系 | 6 欄 × 54 mm | 四層驗證全綠：韌體靜態檢查／資料流欄位契約／KiCad ERC **0 錯誤 17 網路**／雲端 12 項驗收 C1–C12；燒錄實測 flash 36%・RAM 44% | 90 | 圖 2-7 |
| 2.8 | 實機證據 | 6 欄 × 50 mm | 實機照片 ×3（控制盒內部／集煙罩＋爐盆／Grafana 螢幕）＋ 每秒 telemetry 截圖 | 40 | 照片 |
| 2.9 | 誠實邊界 | 6 欄 × 40 mm | ⚠ 感測器尚未接線故 `sensor_fault` 未歸零；aroma02 為**模擬爐**；風扇 $P$–$Q$ 曲線未實測 | 70 | — |
| 2.F | 頁尾 | 6 欄 × 40 mm | 見 §3.6 | — | — |

**P2 內文合計 ≈ 780 字。**

### P3 — ENTERPRISE｜企業

| # | 模組 | 佔位 | 內容要點 | 字數 | 圖 |
|---|---|---|---|---:|---|
| 3.0 | 標題帶 | 6 欄 × 120 mm | ○○●／`ENTERPRISE 企業`／主張句 | — | — |
| 3.1 | 禁香的社會總成本 | 3 欄 × 96 mm | 心理慰藉不可替代（2017 上凱道）＋產業鏈崩塌（印度手工捲香 **70 萬人、8 成女性**）→ 全面禁香是**社會總成本最高**的選項 | 100 | 圖 3-1 |
| 3.2 | 四維競品定位 | 3 欄 × 96 mm | 儀式完整性／成本可負擔性／減污有效性／運作可驗證性；封爐犧牲儀式、碳權犧牲成本、清淨機犧牲有效性、IoT 監測犧牲致動 → **第四象限無人進入** | 90 | 圖 3-2 |
| 3.3 | ★ 單位風量效益 | 6 欄 × 96 mm | 以 **1/11.5 的風量達成 3.22 倍減量 → 效益比 37 倍**。這是「為什麼不直接買空氣清淨機」的量化回答 | 80 | 圖 3-3 |
| 3.4 | 買方與商業模式 | 3 欄 × 100 mm | B2B 單一決策者＝廟方管委會；三層營收：**設備銷售＋濾材訂閱＋空品數據服務**；濾材更換週期與**農曆**天然耦合 | 100 | 圖 3-4 |
| 3.5 | 可複製性即市場區隔 | 3 欄 × 100 mm | 對標北港武德宮碳中和廟宇約 **500 萬元**資本支出；本案目標壓進中小型廟宇價格帶（原型 BOM < NT$4,200）→ **95% 以上廟宇被現行最佳方案排除在外** | 100 | 圖 3-5 |
| 3.6 | 護城河＝數據 | 6 欄 × 70 mm | 歸一化 KPI 產出**可歸因**的減量數據 → 支援 ESG 揭露／碳盤查／地方補助核銷，形成轉換成本 | 70 | — |
| 3.7 | Next Steps | 6 欄 × 96 mm | 三階段：① 實測三條特性曲線（$\eta(u)$、$h(u)$、SPL$(u)$）＋廟方訪談定 $h_{min}$ ② ASHRAE 110 示蹤圍阻測試 2×2 因子設計 ③ 慈祐宮實地佈點；**風險登錄**：側裙橫流假設為全案最脆弱單點 | 110 | 圖 3-6 |
| 3.8 | 團隊與分工 | 6 欄 × 62 mm | 成員照片＋各自負責模組＋研究日誌節錄（顯示迭代痕跡） | 50 | 照片 |
| 3.F | 頁尾 | 6 欄 × 40 mm | 見 §3.6 | — | — |

**P3 內文合計 ≈ 700 字。**

---

## 5. 圖表清單（總表）

| 編號 | 標題（一句結論） | 型式 | 資料來源 | 狀態 |
|---|---|---|---|---|
| 1-1 | 殿內常態濃度已超標，峰值只是極端 | 水平長條＋標準線 | Hien 2022；蘇大成 2015 | 需製作 |
| 1-2 | 爐位差異造成三倍濃度差——被動空間關係已如此，主動控制的空間更大 | 兩組帶誤差長條 | Hien 2022 | 需製作 |
| 1-3 | 線香更像二手菸，而不像車輛廢氣 | 六維對照表 | 問題報告 3-2 | 需製作 |
| 1-4 | 傷害集中在少數人身上，差距達兩個數量級 | 對數水平長條（堆疊近／遠場） | 問題報告 3-3 | 需製作 |
| 1-5 | 排放最強時，環境自淨最弱 | 雙折線（同軸，指數化） | 問題報告 3-4 | 需製作 |
| 1-6 | ★ 捕集是「接」的問題，不是「吸」的問題 | 折線（誘導風速 vs 煙羽速度） | `flow_analysis.py` §3 | **已有 HTML 圖，需轉印刷版** |
| 1-7 | 以 1/11.5 的風量達成 3.22 倍減量 | 四情境長條 | 3-8.10 表 3-8-7 | 需製作 |
| 2-1 | 兩板架構：決策與安全物理隔離 | 方塊圖 | 專案進度 §3.3 | 需製作 |
| 2-2 | 每降一級，都有一顆活著的晶片接手 | 階梯圖 | 硬體交接 §1 | 需製作 |
| 2-3 | ★ 三項獨立判準同時指出：原罩口接不住煙羽 | 折線＋門檻線 | `flow_analysis.py` §5 | **已有 HTML 圖，需轉印刷版** |
| 2-4 | 最脆弱的不是尖峰，是一支香 | 折線（漂移 vs N） | 3-8.5 表 3-8-4 | 需製作 |
| 2-5 | 前饋買到的提前量，回饋在物理上給不了 | 時間軸示意 | 3-8.9 | 需製作 |
| 2-6 | 把文化約束寫成硬約束，四種負載才全數合規 | 前後對照表 | 損失函數 §3 | 需製作 |
| 2-7 | 四層驗證，全綠 | 檢查表卡片 | 專案進度 §2、§4.1 | 需製作 |
| 3-1 | 禁香的帳單由最沒有能力付的人承擔 | 圖示統計 | 3-6 | 需製作 |
| 3-2 | 四維座標上，第四象限無人進入 | 四維雷達或矩陣 | 表 3-1 | 需製作 |
| 3-3 | 效益比 37 倍 | Hero 數字＋小長條 | 3-8.10 | 需製作 |
| 3-4 | 三層營收，且與農曆天然耦合 | 分層示意 | 3-5 | 需製作 |
| 3-5 | 500 萬 vs 我們的目標價格帶 | 對數尺長條 | 3-7 | 需製作 |
| 3-6 | 下一步：三件事會讓現在的 ⚠ 變成 ✓ | 甘特／里程碑 | 3-8.12 待測清單 | 需製作 |

> **★ 標記者為三張海報的視覺主圖**，各佔該張最大版面。圖 1-6 與 2-3 已有互動 HTML 版（`氣流分析圖表.html`），轉印刷版時**移除互動元素、加上直接標註**。

---

## 6. 誠實標示規範（本案的簽名）

海報上每一個數字都必須屬於下列四類之一，並以圖示標明。**頁尾圖例三張一致。**

| 圖示 | 類別 | 定義 | 顏色 |
|---|---|---|---|
| ✓ | **實測** | 本團隊實機量測所得 | `#0ca30c` |
| ◆ | **文獻** | 同儕審查研究或官方統計，附編號 | `#0b0b0b` |
| ⚠ | **設計目標** | 由未實測參數推算，**不得表述為實測結果** | `#fab219` |
| ○ | **示範性估算** | 以假設情境說明量級，非預測 | `#898781` |

**強制規則**

1. 模擬爐 `aroma01` / `aroma02` 的任何畫面**必須標「模擬資料」**。
2. 峰值 1,360 µg/m³ 必須標「單日攜帶式觀測，非同儕審查，僅取量級指示」。
3. $\eta \approx 80\%$ 一律寫「**設計目標**」，不寫「達成」。
4. 不宣稱焚香為一級致癌物，只陳述其成分含已被 IARC 分級之物質。

> 這一節不是自我設限，是**得分項**。Senior 評分表的 Research 15 分裡，「知道自己不知道什麼」是最難假裝的一項；多數隊伍會把設計目標寫成成果，而你們在海報上就把界線畫出來。

---

## 7. 待決事項

| # | 事項 | 為何要現在決 | 建議 |
|---|---|---|---|
| 1 | 展位方案 A／B／C（§1.3） | 決定橫幅與 A3 補充卡是否要做 | **A** |
| 2 | 罩口 200 vs 215 mm | 圖 2-3 與 CAD 圖都要標定案值 | **215**（3-8.13 已建議） |
| 3 | 3-8.13 定案值與 §3C 的 CAD 現況尚未同步 | 海報不能同時出現 175／180／200／215 四個數字 | 排版前先統一，以 3-8.13 為準 |
| 4 | 實機照片是否已拍 | 圖 2-8 是 Demonstration 15 分的憑據 | 儘早拍白底照 |
| 5 | Grafana 公開連結在賽場網路可達性 | QR 掃不出來比沒放更糟 | 備離線截圖 |
| 6 | 團隊照與分工（3-8） | Team Spirit 15 分 | — |
| 7 | 隊名英文與學校英文全名 | 三條橫幅要用 | — |

---

## 8. 製作流程與建議時程

| 階段 | 產出 | 誰做 | 建議工期 |
|---|---|---|---|
| ① 規劃定稿 | 本規劃書 ＋ 版型預覽（**本次已完成**） | — | ✓ |
| ② 文案定稿 | 三張各 700–900 字的最終文案（逐模組） | 我可代擬 | 2 天 |
| ③ 圖表製作 | 21 張向量圖（Python/matplotlib → SVG，或 D3 → PDF） | 我可代做 | 3 天 |
| ④ 排版 | Affinity Publisher／Illustrator／InDesign；或全 HTML+CSS 印刷排版 | 你或我 | 3 天 |
| ⑤ 校對 | 數字對帳（每個數字回溯來源）＋誠實標示稽核＋錯字 | 雙人 | 1 天 |
| ⑥ 打樣 | 先印 **A4 縮圖**檢查字級與對比，再印 A1 | 你 | 1 天 |
| ⑦ 送印 | 出血、CMYK、字型外框化 | 印廠 | 依廠商 |

> ⑥ 的 A4 縮圖打樣**不可省**。A1 上看起來剛好的 24 pt，在螢幕上永遠是「太大了吧」——所以每個人都會忍不住縮小，然後在展場上沒人讀得到。

---

## 附錄：三張海報的口頭提詞（5 分鐘簡報骨架）

| 時間 | 講什麼 | 指哪張 |
|---|---|---|
| 0:00–0:40 | 我們保存的是一個活的儀式，不是一件文物 | P1 標題 |
| 0:40–1:30 | 爐位差三倍——所以這是可被氣流控制解掉的問題 | P1 圖 1-2 |
| 1:30–2:10 | 傷害集中在駐廟人員，差兩個數量級 | P1 圖 1-4 |
| 2:10–3:00 | 我們算出來「捕集是接不是吸」，於是推翻了自己的罩體 | P2 圖 2-3 |
| 3:00–3:40 | 文化約束是硬約束——這是數學上的一致表達 | P2 表 2-6 |
| 3:40–4:20 | 效益比 37 倍，這就是為什麼不能只買清淨機 | P3 圖 3-3 |
| 4:20–5:00 | 下一步：三件事會讓所有 ⚠ 變成 ✓ | P3 圖 3-6 |

**預期提問與備答**：① 為什麼不封爐？→ P3 §3.1 ② 你們的 80% 測到了嗎？→ 誠實回答「是設計目標，量測協定已設計為 2×2 因子」 ③ 這跟空氣清淨機差在哪？→ 圖 3-3 ④ AI 在哪裡？→ 損失函數＋三階段導入（規則式基線 → MPC → 模擬環境 RL），且**已有基線對照組**。
