feihong9487/WRO2026/簡報/FGC工程筆記精讀.md

# FGC 2024 中國隊工程筆記精讀（2026-08-16）

> 來源：`簡報/Team People's Republic of China Engineering Notebook 2024.pdf`（18 頁）。
> 供我方 WRO 工程文件／構想書取經。逐頁 PNG 已由代理渲染備查。

## A. 章節結構（18 頁）

封面（酒紅漸層＋CAD 線稿浮水印＋中國結）→ Team Summary（合照＋生活照拼貼）→
目錄 → Season Analysis（白板決策樹照片佐證）→ Planning（白板草圖紅線連到 CAD 成品）→
Robot Overview（全機渲染＋四子系統標籤，當視覺目錄）→ Chassis（2 頁：兩個否決方案＋定案）→
Superstructure（3 頁：四個 Iteration 逐版演進）→ Intake（2 頁：三個 Iteration）→
Programming（2 頁：狀態機／Rate Limiter／AprilTag+Kalman，坦承精度不足）→
Publicity & Outreach → 贊助牆 → 封底。

## B. 版面語言（可模仿規格）

- **配色只有三色**：深酒紅（#A61C2B–#C0242F，只用於章標／節標色塊／頁碼／裝飾線）＋黑＋白＋照片。
- **四級字階嚴格一致**：章標題 40pt 紅（跨頁也每頁重複）→ 節標題白字壓「紅→白漸層橫幅」→
  小節黑粗體 → 內文 12pt 行距 1.5，關鍵詞粗體。
- 頁首：全大寫隊名（左）＋大號紅色頁碼（右）；頁尾：紅細線＋三圓點裝飾，固定重複成節奏。
- 圖文比 55:45，無純文字頁；CAD 渲染＋現場照＋白板照＋截圖刻意混搭；
  紅圈紅箭頭直接壓在照片上指認零件（含放大特寫框）。

## C. 內容手法亮點

1. **失敗方案給正式版面**：否決理由精確到可觀測物理現象與零件層級（「上坡道兩輪懸空打轉」「塑膠齒輪跳齒」）。
2. **Iteration 三問格式**：改了什麼→為什麼→實測又暴露什麼（下一版動機）——因果鏈完整。
3. **白板照片當一手證據**：證明分析真的發生過，不是賽後補寫。
4. **草圖→CAD 紅線連結**：潦草想法連到成品，一眼看懂（全書最聰明的版面動作）。
5. **Robot Overview 當視覺目錄**：全機圖＋子系統標籤，各章一一對應。
6. **定量細節錨定可信度**：數字不多但都出現在決策點（15:1 減速比、420mm 鋁擠…）。
7. **坦承未解問題**：定位精度不足仍在優化——主動揭露反而加分。
8. **開源與交流當工程成果寫**：全部附截圖／地圖佐證，不是口號。

它沒做好的（引以為戒）：無時程表、無分工表、無測試數據表格、無 BOM／預算。

## D. 對我方的取捨

**抄這 5 件**：
1. Iteration 敘事——CLAUDE.md §4 的坑（D2/D3 埠、BusIO 衝突、D4184 保留理由）＋理香移除＋漏斗迭代就是現成素材。
2. 系統總覽頁：香爐全圖＋標籤（投香口／集煙罩／過濾鏈／感測／雲端），兼當各章目錄。★構想書 v4 候選改動★
3. 三色紀律＋章標每頁重複＋大號頁碼（v3 已採用同精神）。
4. 白板／手繪當證據（例：FILTER_CHAIN 火星防護的決策樹手繪）。
5. 坦承未完成：`*_MEASURED` 待實測清單、模擬機標示——我們有更制度化的版本，直接展示。

**不抄這 3 件**：
1. 零表格純敘事的測試紀錄——我們有 InfluxDB 連續實測，用表格與曲線遠更有力。
2. 「賽季拆解→得分策略」開篇——我們是解決方案題，開篇應為問題場景→使用者→需求推導＋文化適切性。
3. 國家隊級 Publicity（奧運選手、大廠贊助牆）——寫我們真的做過的：廟方訪談、開源 repo、社群分享，一小節即可。
