feihong9487/WRO2026/簡報/專案總交接_WRO2026智慧香爐.md

# WRO 2026 智慧香爐 — 專案總交接文件（Master Handover）

> **用途**：把整個專案打包成一份可獨立閱讀的交接文件，供**另一個帳號／另一個對話**從零接手。
> **產出日期**：2026-08-16（台北）
> **對應 repo**：`https://github.com/feihong9487/WRO2026.git`（本機 `C:\Users\feihong\Downloads\WRO2026-master\WRO2026-master\`，桌機歷史路徑為 `D:\WRO2026\`）
> **最後 commit**：`f553ca4 auto-sync 2026-08-16 13:09`
> **賽事**：WRO 2026 Future Innovators（European Open Championship）
>
> ⚠️ 本檔為**彙整摘要 ＋ 索引**。任何細節以 repo 內各原始文件為準（每節都標明對應檔案）。
> 若彙整內容與原始檔衝突，**以原始檔為準**，並回頭修正本檔。

---

## 目錄

1. [三十秒版現況](#1-三十秒版現況)
2. [專案定位與商業敘事](#2-專案定位與商業敘事)
3. [系統架構（現行兩板架構）](#3-系統架構現行兩板架構)
4. [硬體：腳位、供電、接線](#4-硬體腳位供電接線)
5. [韌體與決策層軟體](#5-韌體與決策層軟體)
6. [雲端與監測平台](#6-雲端與監測平台)
7. [機構與外觀 CAD](#7-機構與外觀-cad)
8. [電路設計與電氣驗證](#8-電路設計與電氣驗證)
9. [自動化驗證體系（三層迴路）](#9-自動化驗證體系三層迴路)
10. [工作規則與★紅線★](#10-工作規則與紅線)
11. [誠實邊界（對外可以說什麼、不可以說什麼）](#11-誠實邊界對外可以說什麼不可以說什麼)
12. [簡報／構想書現況](#12-簡報構想書現況)
13. [重大決策時間軸](#13-重大決策時間軸)
14. [★專案特有的坑★（踩過的，不要再踩）](#14-專案特有的坑踩過的不要再踩)
15. [待辦清單（依優先序）](#15-待辦清單依優先序)
16. [環境、帳號、網址、金鑰](#16-環境帳號網址金鑰)
17. [檔案索引（repo 全貌）](#17-檔案索引repo-全貌)
18. [接手第一天怎麼做](#18-接手第一天怎麼做)

---

## 1. 三十秒版現況

**做什麼**：智慧香爐 —— 在既有香爐上加裝「空品監測＋主動抽排過濾」模組。
偵測 CO₂（人潮先行指標）→ 前饋升速抽排 → 濾除 PM2.5 與 VOCs → 全程資料上雲可公開查核。

**現在跑到哪**：

| 子系統 | 狀態 |
|---|---|
| 雲端中心站（WSL2 Docker：mosquitto／InfluxDB／Telegraf／Grafana） | ✅ **已上線**，12 項驗收（C1–C12）全過，3 個免帳密公開連結可用 |
| 真爐節點 aroma01（Pi 5 + MATRIX Mini R4） | ✅ **已上線**（2026-08-08 起真實資料），NVMe 遷移完成，比賽現場模式（手機熱點上雲）演練通過 |
| R4 韌體 | ✅ 已燒錄並實機驗證（含 DS18B20）；★理香移除後的新版尚未重燒★ |
| 感測器接線（SCD41／SHT31／MAX6675） | ⚠️ **未完成** — I²C 掃不到 0x62，卡在 Grove 2.0mm vs 杜邦 2.54mm 的機械接觸 |
| 電路設計（KiCad） | ✅ ERC 0 錯 0 警，12 元件／20 網路，PDF/SVG/網表齊備 |
| 外觀 CAD（OpenSCAD → STEP） | ✅ 全套驗證綠（A–M 13 類），5 件列印件；⚠️ `STEP/` 需重匯 |
| 構想書／簡報 | ✅ v2（完整論述）＋ v3（視覺重排 25 頁）＋ 現場簡報 3 分鐘 ＋ 一分鐘講稿定稿 |
| 燃燒艙實驗（H1–H3 效能數據） | ❌ **完全未做** — 所有成效數字目前只能稱「設計目標」 |

**下一步三件事**：① 感測器接線讓 `-99.9` 變真值 → ② PCF8574 存廢拍板 → ③ 外部訪談 ≥3 人（評分硬性要求）。

---

## 2. 專案定位與商業敘事

> 對應檔案：`智慧香爐_硬體設計交接.md` §0、`專案進度.md` §3B、`簡報/一分鐘講稿.md`

### 2.1 商業主打（2026-08-07 拍板）

**既有香爐的空品監測＋抽排過濾「改裝模組」（retrofit）。**

- 不換爐、不要求信眾改變任何行為
- 買方＝**廟方管委會**（B2B 單一決策者）
- 買點＝工安、環保陳情壓力、廟方公關（空品即時公開本身就是文宣）
- 商模＝硬體進場 ＋ 雲端多爐監測訂閱（**報表比風扇值錢**）
- 出海順序：新加坡／馬來西亞（法規推力）→ 香港（付費意願已證實）→ 日本／泰越 → 印度（最大量級）→ 歐洲教堂乳香

### 2.2 核心論述（第一性原理）

```
空汙濃度 = 產生速率 − 移除速率
產生端是信仰，動不得  →  所以只放大「移除端」
```

一句話結論：**「我們讓香繼續燒，但煙不再害人。」**

### 2.3 ★理香機構已整組移除★（2026-08-16 使用者決定）

原本最獨創的機構（插孔板／導正套筒／磁力矩陣電磁鐵 ×4／磁座）**全數自設計移除**。

**移除理由**（這是答詢時「你們遇過什麼挫折」的最佳答案，務必保留敘事）：

1. 插孔板要求信眾「對準孔、把香放進套筒」，與真實香爐「隨手插進香灰」的行為不相容 —— 人不會為機構改變行為，孔滿之後香只會插在孔外。
2. 尖峰時段一人三炷、一小時數百炷，遠超任何可行格數；理香只作用於套筒內的香。
3. 在插孔板真正成立的減香情境（一人一炷、定格插香），悶燒擠香問題本身大幅消失 —— **機構解決的問題被自己的前提消滅**。

閉環展示改由「**CO₂ 分級 → 風扇抽排 ＋ 超音波霧化煙源**」承擔。
舊設計見 git 歷史（`e8171aa`、`54eb8fe` 等）。

**⚠️ 交接注意**：`智慧香爐_硬體設計交接.md` 中所有理香相關段落（§0 部分、§1A-C 電磁鐵、腳位表 D7/D8、§7 機構規格）**僅為歷史紀錄，勿再據以採購或實作**。

### 2.4 另一個「敢改」的故事：集煙罩漏斗化（2026-08-16）

原設計上窄下寬縮口（罩頂 96mm）→ 使用者反映不好插香 → 改為
**下段直筒 44mm（煙道開口與風扇座法蘭靠垂直後壁）＋ 上段外擴喇叭口至 180mm**（內開口 ≈175）。
喇叭斜面 34°，倒印自支撐。「為使用者行為改設計」是加分敘事。

---

## 3. 系統架構（現行兩板架構）

> 對應檔案：`專案進度.md` §3、`P0接線與驗證指南.md`（頂部架構變更框）

### 3.1 現行架構

```
┌─ MATRIX Mini R4（感測 ＋ 安全 ＋ 致動）────────────────┐
│ SCD41(I²C1) · SHT31(I²C2) · MAX6675 K型熱電偶(SPI)     │
│ DS18B20(A2) · OLED · 本地簡化 FSM · 超溫聯鎖           │
│ 風扇 PWM → D4184 → 12V 5015 鼓風機                     │
└──────────────┬─────────────────────────────────────────┘
               │ USB-C 序列 115200（udev 固定名 /dev/r4）
               ▼
┌─ Raspberry Pi 5 16GB（決策 ＋ 審計 ＋ 上雲）───────────┐
│ pi_fsm.py：S0/S1/S2/S3 狀態機、CO₂ 前饋、每秒 JSONL    │
│ 本機 mosquitto → 橋接（QoS1 佇列）→ 雲端               │
│ 本機 Docker 監測棧（InfluxDB:8087 / Telegraf / Grafana）│
└──────────────┬─────────────────────────────────────────┘
               │ MQTT（Tailscale）
               ▼
┌─ 雲端中心站（家裡桌機 WSL2 Ubuntu 24.04）──────────────┐
│ mosquitto + InfluxDB 2.7 + Telegraf 1.30 + Grafana 11.2│
│ Tailscale Funnel → 3 個免帳密公開唯讀儀表板             │
└─────────────────────────────────────────────────────────┘
```

### 3.2 為什麼是兩板（2026-08-02 拍板，2026-08-07 三板殘留全刪）

原設計是三板（ESP32-S3 感測 ／ R4 安全致動 ／ Pi 5 決策）。
發現使用者的控制器是 **MATRIX Mini R4**（基於 Arduino UNO R4 WiFi，內建 I²C 埠、5V 供電）後改為兩板。

**失去**：
1. **感測器擺位自由**（最實際）— I²C 線長受限：單顆上拉 10kΩ → 約 1m；雙上拉並聯 5kΩ → 約 2m。超過就得回頭用 WiFi。
2. 「S3 失效 → R4 仍保安全」這層降級消失（但誠實地說：R4 本來就已是致動的單點故障）。
3. 報告的「三層獨立」論述要重寫。

**得到**：
1. **降級階梯不消失，只是換形狀，且 Pi 失效那層變強** —— 原本 R4 只能吐固定 `FALLBACK duty 80`（不知 CO₂ 多少）；合併後 MATRIX 有 CO₂ 讀值，可在本地跑簡化 FSM 做真正的回饋控制。
2. 少掉整類失效模式（S3↔Pi 的 WiFi、MQTT 斷線誤判）。
3. 反應變快（少三跳）。

**前提**：感測頭離控制盒在 1–2 公尺內。若日後佈置超出線長限制要回頭用三板，從 git 歷史取回（刪除前最後版本：commit `2f5ab86` 之後的工作區）。

### 3.3 故障安全階梯（現行）

| 失效點 | 系統行為 |
|---|---|
| 雲端／網路斷 | Pi 本地續跑，本地 Grafana 照常；橋接 QoS1 佇列積壓，回線自動補傳 |
| Pi 失效／序列逾時 5s | R4 進 **FALLBACK**，用自己的 CO₂ 讀值跑本地簡化 FSM |
| 感測失效 | 回傳 `-99.9` 誠實故障值，`sensor_fault` 旗標；安全態優先 |
| 超溫 / 熱電偶開路 | R4 就地聯鎖，**直接拉低 PWM 腳**，風扇強制 0，無軟體介入路徑 |
| 全系統斷電 | 香爐回復傳統使用（無任何機構阻礙插香） |

---

## 4. 硬體：腳位、供電、接線

> 對應檔案：`電路設計/接線圖.html`（rev F，★實接時看這份★）、`電路設計/麵包板接線圖.html`、`電路設計/kicad/網表.md`

### 4.1 MATRIX Mini R4 埠位對照（官方函式庫原始碼查證）

| 埠 | Arduino 腳位 | 備註 |
|---|---|---|
| D1 | 3, 2 | 3 支援 PWM |
| D2 | 5, 4 | ★**不可用**★ |
| D3 | 12, 11 | ★**不可用**★ |
| D4 | 13, 10 | 10 支援 PWM |
| A1 | A1, A0 | A0 支援 DAC |
| A2 | A3, A2 | |
| A3 | A4, A5 | 同時是 I2C0（走 `Wire`） |
| I2C1–I2C4 | `Wire1` ＋ PCA9548A 多工器（位址 `0x70`），切換＝寫 `(1 << 通道)` | |
| M1–M4 | DC 馬達，**5V**（不是 12V！） | |
| RC1–RC4 | 伺服，5V | |

> ★**不可使用 D2、D3 埠**★：`MiniR4.begin()` 內執行 `PS2.config_gamepad(11, 4, 12, 5, false, false)`，把腳 11／4／12／5 佔為 PS2 手把介面。

### 4.2 現行接線表（★最終版★）

| 元件 | MATRIX 埠 | Arduino 腳 | 備註 |
|---|---|---|---|
| SCD41 CO₂ (0x62) | I²C1（Grove，5V 直插） | `Wire1` mux ch0 | 5s 更新一次（硬體特性） |
| GY-SHT31-D (0x44) | I²C2（Grove，5V 直插） | `Wire1` mux ch1 | 板載 10kΩ 上拉到 VIN |
| MAX6675 SCK | D4 埠左 | 13 | |
| MAX6675 SO | D4 埠右 | 10 | |
| MAX6675 CS | D1 埠右 | 2 | |
| 風扇 PWM | D1 埠左 | 3（PWM） | → D4184 → 12V 5015 |
| DS18B20 | **A2 埠** | — | 1 Hz 非同步，JSON 欄位 `t_ds`；函式庫 `MXOnewireDT` 用埠左腳 |
| PCF8574 I²C 8路 MOSFET 板 | I²C3 | — | ★存廢未拍板★（只用 OUT5 霧化、OUT6 罩內 LED） |
| Pi ↔ MATRIX | USB-C | — | 序列 115200 |
| 警報線 | **不需要** | — | 感測與安全同板 |

**未用資源**：D2、D3、A1、I²C4、4 馬達、4 伺服、1 組 UART（PMS5003 到貨後直插 UART 埠）。

### 4.3 感測器 5V 相容性（已查證）

| 感測器 | 供電範圍 | 5V 直接接 |
|---|---|---|
| SCD41 | 2.4 – 5.5 V | ✅ |
| GY-SHT31-D | 2.4 – 5.5 V | ✅ 不需電平轉換 |

> 舊文件寫「感測器不要接 5V」**是為了保護 ESP32-S3**（其 GPIO 不耐 5V），感測器本身不怕。拿掉 S3 後此限制自動消失。

### 4.4 供電樹

```
市電 → 12V 3A 變壓器 ──┬─ 保險絲 2A（必加）
                        ├─ A1 MATRIX VIN（板子吃 6–24V）
                        ├─ U6 D4184 → M1 5015 風扇（0.2A）
                        └─ U7 PCF8574板 → M2 霧化模組 ＋ LED1 罩內LED
Pi 5 → ★官方 27W USB-C 專用電源★（不可共用；低壓重置正是 SD 卡的死因）
```

- **一顆 12V 同時餵板子與風扇，共地自動成立。**
- **12V 絕不可碰到 3V3／5V 排。**
- **★馬達埠推不動 12V 風扇★**：`MatrixMiniR4.h` 寫明 `Port M1 DC 5V Motor`，是穩壓 5V 輸出不是 6–24V 直通。**D4184 ＋ 獨立 12V 必須保留。**

### 4.5 為什麼風扇不走馬達埠（即使有 12V 轉接板也不走）

風扇是**安全致動器**，超溫聯鎖必須能確實停機：

| | D4184（採用） | 馬達埠＋轉接板 |
|---|---|---|
| 控制路徑 | RA4M1 → PWM 腳 → MOSFET | RA4M1 → **STM32 副處理器** → 馬達驅動 → 轉接板 |
| 聯鎖停機方式 | **直接拉低 PWM 腳，無軟體介入** | 需 STM32 正確執行命令 |

控制鏈多一顆 MCU 就多一個「它當掉時風扇維持原轉速」的失效模式。另外馬達驅動是 H 橋（雙向），2 線無刷風扇只需單向，H 橋高側自舉常做不到 100% duty，反向驅動還可能傷及風扇內部換相電路。

### 4.6 元件清單（KiCad 網表，12 元件／20 網路）

| 參考 | 品名 |
|---|---|
| `A1` | MATRIX Mini R4 控制器 |
| `A2` | Raspberry Pi 5 決策層 |
| `J1` | K 型熱電偶 |
| `J2` | 12V 3A 變壓器 |
| `LED1` | 罩內 LED 側光 12V |
| `M1` | 5015 渦輪風扇 12V 0.2A |
| `M2` | 超音波霧化模組 12V（冷霧，無明火） |
| `U2` | SCD41 CO₂ (0x62) — I2C1 埠 |
| `U3` | GY-SHT31-D (0x44) — I2C2 埠 |
| `U5` | MAX6675 熱電偶介面 |
| `U6` | D4184 MOSFET 模組 |
| `U7` | I²C 8 路 MOSFET 驅動板（PCF8574，★存廢未拍板★） |

---

## 5. 韌體與決策層軟體

> 對應檔案：`R4/matrix_mini_r4/matrix_mini_r4.ino`、`PI5/pi_fsm.py`

### 5.1 R4 韌體（合併版）

- 感測：SCD41（I²C1／mux ch0）、SHT31（I²C2／mux ch1）、MAX6675（SPI）、DS18B20（A2）
- 安全：超溫聯鎖 `T_LOCK 150 / T_RELEASE 130`（**★臨時值★**，見 §11）、熱電偶開路偵測、CO₂ 硬警報
- 致動：風扇 PWM（D1 左）、`ioWrite()` 保留給霧化／LED
- 通訊：每秒一行 JSON telemetry 到序列 115200
- 降級：Pi 指令逾時 5 秒 → FALLBACK，用本地簡化 FSM
- **已移除**：電磁鐵互鎖與脈衝控制（2026-08-16）

**JSON telemetry 範例**：
```json
{"t_furnace":26.50,"fan":80,"alarm":0,"interlock":0,"tc_fault":0,"mode":"FALLBACK"}
```

> ★**板上還是舊韌體，理香移除後的新版需重新燒錄**★

**編譯燒錄實績（2026-08-11 筆電）**：arduino-cli 1.4.1 編譯過（flash 36%／RAM 44%）、COM12 燒錄成功、序列 115200 實測每秒 telemetry 正常。

### 5.2 Pi 決策層 FSM（`pi_fsm.py`）

**狀態**：S0 待機 ／ S1 常態 ／ S2 高峰 ／ S3 異常

**★門檻相對於背景基線，不是絕對值★**（2026-08-07 改，與 R4 韌體同步）：

```python
CO2_IDLE_DELTA = 50      # 高於基線 <50 且持續 → S0
T1_DELTA       = 300     # 高於基線 300 → 進 S2（呼氣即可達到）
T1_EXIT_DELTA  = 200     # 退 S2（遲滯）
BASELINE_WINDOW_MIN = 10
CO2_BASELINE_INIT   = 450
SLOPE_TH       = 120.0   # ppm/min，CO2 前饋門檻 θ_ff
IDLE_HOLD_S    = 60
SENSOR_STALE_S = 10
DUTY = {"S0": 0, "S1": 70, "S2": 220, "S3": 0}   # 0-255
```

**為什麼改成相對基線**：絕對門檻只在背景穩定時成立。安靜的廟宇清晨約 450ppm，人多的展場大廳 1000–2000ppm —— **用絕對值在展場會永遠卡在 S2、S0 永遠到不了，分級響應完全看不出來**。

**基線演算法**：過去 10 分鐘內「每分鐘最小值」的最小值。
★取最小不取平均★ —— 要的是「沒人時的底」；用平均會被人潮拉高，變成「人越多門檻越高」的正回饋，方向剛好相反。

**其他**：
- `SERIAL_PORT = "/dev/r4"`（udev 固定名 `99-r4.rules`，重列舉不再跳 ACM0/ACM1）
- 每秒寫一筆 JSON Lines 決策紀錄（可重演）＋ publish 到 `incense/decision`
- 轉發白名單已加 `t_ds`（★僅筆電副本，Pi 上尚未更新★）

**決策紀錄格式**：
```json
{"ts":"2026-07-30T14:03:21","co2":1420,"slope":260.0,"t_sht":26.2,"rh_sht":61.0,
 "conf":1.0,"s3_alarm":0,"t_furnace":27.25,"fan_actual":220,"r4_mode":"PI",
 "interlock":0,"state":"S2","fan_duty":220,"action":"S1->S2"}
```

### 5.3 兩支靜態驗證腳本（不需硬體）

```bash
python3 R4/matrix_mini_r4/驗證韌體.py   # 門檻與 pi_fsm.py 一致性、腳位衝突、JSON 合法性
python3 PI5/驗證資料流.py               # 韌體→pi_fsm→Grafana 的欄位契約
```

- 前者抓「本地 FSM 門檻與 pi_fsm.py 不一致」—— 降級瞬間風扇轉速跳變，實機極難察覺
- 後者抓「欄位名對不上」—— 畫面 No data，同樣極難查
- **兩支都做過負面測試，確認抓得到錯**

---

## 6. 雲端與監測平台

> 對應檔案：`部署紀錄.md`（含三個附錄）、`cloud_dash/多爐平台指南.md`、`PI5/雲端監測平台指南.md`、`任務書_雲端中心站部署.md`（原始委派紀錄，**不修改**）

### 6.1 雲端中心站（家裡桌機 Windows 11 / WSL2）

| 項目 | 值 |
|---|---|
| 部署目錄 | `~/incense-cloud`（WSL2 Ubuntu 24.04 家目錄，ext4，非 `/mnt/d`） |
| Docker Engine | 29.6.2（WSL 內原生，非 Docker Desktop） |
| Compose | v5.3.1（plugin） |
| 容器 | `eclipse-mosquitto:2` / `influxdb:2.7` / `telegraf:1.30` / `grafana/grafana-oss:11.2.0` |
| restart policy | `unless-stopped`，WSL 開機後 systemd 帶起 docker 即自動復活 |
| Tailscale | IP `100.73.36.75`，tailnet `feihong9487.github`，Funnel 已啟用 |

**★單點依賴★：雲端儀表板的前提是家裡桌機開著**（WSL 容器 ＋ Tailscale）。桌機關機 → 雲端儀表板停更，只剩 Pi 本地版。

### 6.2 網址

| 用途 | 網址 |
|---|---|
| 本機 | `http://localhost:3000` |
| Tailscale 內網 | `http://100.73.36.75:3000` |
| 公開 HTTPS | `https://desktop-c8l8ri6-1.tail7920c6.ts.net` |
| **公開唯讀・總覽** | `.../public-dashboards/cc49db3ec819404e84744cfd416cb043` |
| **公開唯讀・aroma01** | `.../public-dashboards/cc9acc908b144cc98e9563b09e089e34` |
| **公開唯讀・aroma02** | `.../public-dashboards/99d887ecab2641e0b0ebbc47a6f9f273` |
| Pi 本地 Grafana（斷網備援） | `http://100.88.179.95:3000` |
| InfluxDB API（雲端） | `http://localhost:8086` |
| MQTT broker（雲端） | `localhost:1883` |

> 公開連結等同於「免密碼的檢視權杖」，只給預期對象；外流需刪除後重建 public dashboard。

### 6.3 Grafana Public Dashboard 的兩個平台限制（★踩過的坑★）

1. **模板變數不生效** — `$device` 不會被代入，Flux 報 `undefined identifier device`。
   **解法**：改用 `|> group(columns:["device"])` 依 tag 分組（總覽），或把爐號寫死進 Flux 字串（單爐版）。
2. **文字型欄位在 stat 卡片顯示不出來** — `state`、`r4_mode` 永遠 No data，但換 `state-timeline` 或 `table` 面板就正常。
   **解法**：Flux 用 `map()` 把文字轉數字（S0~S3 → 0~3、PI/FALLBACK → 1/0），再用數字鍵的 value mapping 顯示文字；`action` 改用 table 面板。

> ⚠️ **儀表板 JSON 正本在 `cloud_dash/`**，WSL 的 `~/incense-cloud/` 只是工作副本。在 Grafana 改了面板要記得匯出存回，否則 WSL 重灌就遺失。

### 6.4 真爐節點 aroma01（Raspberry Pi 5 16GB，Debian 13 trixie）

| 項目 | 值 |
|---|---|
| 裝置代號 | `aroma01`（真實資料；模擬器已停） |
| 主機名 | `feihongPi5`（NVMe 遷移後）；Tailscale `100.88.179.95` |
| 開機媒體 | **NVMe**（Pironman 5 機殼 + WD_BLACK SN750 SE 500GB），EEPROM `BOOT_ORDER=0xf416` |
| PCIe | `dtparam=pciex1`（外接埠預設關閉，必須手動加；漏加症狀＝link down） |
| 程式 | `/opt/incense/pi_fsm.py` ＋ `incense-fsm.service`（開機自啟） |
| 單機監測棧 | `/opt/incense/docker-compose.yml`：InfluxDB(**8087**，8086 被原生 influxd 佔用)＋Telegraf＋Grafana(3000) |
| 本地 mosquitto | 僅綁 localhost ＋ 172.17.0.1（docker 橋），**不對區網開放** |
| 雲端橋接 | `/etc/mosquitto/conf.d/bridge.conf`（chmod 600），主題改寫 `incense/#` → `incense/aroma01/#`，QoS1、cleansession false、離線佇列 100k |
| 看門狗 | `usb-watchdog.timer` 每 60s：裝置消失 **＋** `incense/sensor` 15 秒無訊息（CDC 軟卡死）→ `uhubctl` 重置埠＋重啟 FSM |
| udev | `/dev/r4` 固定名（99-r4.rules） |
| 塔扇 | 35°C 滿轉曲線；GPIO 側風扇 Always On |
| 熱點 | NetworkManager `hotspot-phone`，autoconnect priority -10（在家讓位家用 WiFi，現場自動連熱點），每 60s 巡檢跳槽 |

### 6.5 比賽現場 SOP（實測通過）

```
1. 插電（官方 27W 最好）
2. 開手機熱點「我叫小phone今年9歲」（注意是數字 9）
3. 等約 90 秒（Pi 每 60 秒巡檢，看到熱點自動跳上去）
4. ★按 R4 的電源鍵★ ← 唯一手動步驟
```

> ★**關鍵發現**★：**MATRIX Mini R4 斷電後不會自動開機**（內建電池設計），必須手動按電源鍵。先前多次「R4 從 USB 消失」全是此因，不是線材或卡死。看門狗救不了這個。

**比賽日檢查表**：
1. 家裡 PC：開機、停用睡眠、WSL 起、四容器跑、Tailscale 在線
2. 手機：熱點開啟並保持喚醒（iPhone 熱點閒置數分鐘會休眠）；手機 Tailscale App 連線
3. 現場：Pi 上電即自動連熱點上雲
4. 評審看雲端公開 Funnel 連結（任何裝置免安裝）
5. 備援：手機開 `http://100.88.179.95:3000`（Pi 本地 Grafana，經 tailnet），**誠實標示為本地版**
6. 帶官方 27W 電源、備用 USB 線

### 6.6 已知環境陷阱

- 面板全空白 → 先查右上時間範圍，再查 `sudo docker compose logs telegraf --tail 20`（通常是 telegraf 密碼未改對）
- mosquitto 起不來 → 檢查 `passwd` 檔存在、conf 檔名對上 compose 掛載路徑
- 手機／其他裝置連不上 → WSL NAT 預期行為，一律走 Tailscale，**不要改 Windows 防火牆或 portproxy**
- Windows 睡眠 → 容器與 Tailscale 全部暫停
- 補傳資料的 InfluxDB 時間戳是**到達時間**非量測時間，雲端圖上呈現為補傳瞬間的密集帶

---

## 7. 機構與外觀 CAD

> 對應檔案：`外觀CAD/檔案結構與匯出.md`、`外觀CAD/params.scad`（★唯一真相來源★）、`外觀CAD/設計說明.html`、`CAD自檢/mech_params.py`

### 7.1 檔案結構

```
外觀CAD/
├─ params.scad              ★所有尺寸的唯一真相來源★（只有變數，沒有幾何）
├─ common.scad              共用輔助模組（圓角方柱、倒角、柵格、螺柱、定位榫）
├─ parts/                   列印件，一零件一檔（5 件）
│  ├─ base.scad             電子艙底座
│  ├─ chamber.scad          燃燒艙
│  ├─ hood.scad             集煙罩（漏斗：直筒段＋喇叭口）
│  ├─ fan_mount.scad        風扇座
│  └─ sensor_pod.scad       感測器艙
├─ components/              ★外購件★（非列印件，尺寸多為估值）
│  ├─ bowl / matrix_r4 / pi5 / d4184 / blower_5015
│  ├─ sensors（SCD41+SHT31）/ max6675 / mist_led
├─ incense_burner.scad      組裝定位 place()、組合件、驗證模組、輸出分派
├─ 驗證CAD.py               自檢（A–M 共 13 類，會實際呼叫 OpenSCAD 算繪，約 2 分鐘）
├─ export_step.py           STEP 匯出（給 Onshape）
└─ STEP/                    匯出結果（⚠️ 仍是 08-16 之前的舊版，需重跑）
```

**相依方向**：`params.scad ← common.scad ← parts/` ；`params.scad ← components/` ；兩者 → `incense_burner.scad`

零件檔用 **`use <>`** 而非 `include <>`：`use` 只帶模組不執行頂層敘述，零件檔可自帶預覽呼叫又不污染組合件。
**但 `use` 也不帶變數** —— 參數一律寫在 `params.scad`，零件檔裡不要定義數字，否則引用處算成 `undef`，幾何是空的時交集永遠 0，**檢查會靜默通過**（`驗證CAD.py` 現在會擋這種情況）。

### 7.2 關鍵尺寸（節錄自 `params.scad`）

```
整機         180 × 180 × 196 mm（桌上型展示機）
列印         NOZZLE 0.4 / WALL 2.4 / FLOOR 2.0 / FIT 0.3 / CHAMFER 1.2 / BED 220
電子艙底座   BASE 180×180×62
燃燒艙       CHMB 156×156×72（比底座小，階梯造型）
集煙罩       HOOD_H 62；HOOD_TOP_W 180（內開口≈175）；HOOD_COLLAR_H 44（直筒段）
外型圓角     CORNER_R 10
金屬爐盆     BOWL_D 110 × BOWL_H 45（外購，⌀110×45 為假設值）
★空氣間隙★  AIR_GAP 8（爐盆與塑膠之間，絕熱關鍵）
隔熱層       ISO_GAP 14 ＋ ISO_VENT_W 5 對流通風縫
煙道         DUCT_W 46 × DUCT_H 30
風扇         5015：FAN 51×51×16，FAN_SCREW_S 42（★請實測★）
熱電偶       TC_TIP_ABOVE_BOWL 25（爐面上方 2–3cm 懸空）
```

### 7.3 核心設計約束是「熱」

熱電偶聯鎖 150/130°C（臨時值），而 **PLA 的 HDT 只有 55–60°C**。四道設計對策：

1. 燃燒由**金屬爐盆**（外購不鏽鋼碗）承接，塑膠不碰火源
2. 爐盆與塑膠之間留 **8mm 空氣間隙**（最好的絕熱材）
3. 燃燒艙↔電子艙之間 **14mm 隔熱層 ＋ 對流通風縫**
4. **燃燒艙與集煙罩必須用 ABS/ASA/PETG，不可用 PLA**

**感測器艙裝在前方朝外而非煙道內**，理由有二：
- FSM 用 CO₂ 斜率偵測人潮，要量的是「參拜者呼吸到的空氣」
- SCD41 工作溫度上限約 60°C，放煙道會壞

### 7.4 過濾鏈（★順序即安全★）

```python
FILTER_CHAIN = ["金屬紗網", "HEPA", "活性碳濾棉"]   # 順序不可調換
FILTER_PRESSURE_DROP_PA = {"金屬紗網": 5.0, "HEPA": 120.0, "活性碳濾棉": 40.0}
FAN_STATIC_PRESSURE_PA  = 250.0   # ★估值，未實測★
```

- **金屬紗網必須在 HEPA 之前** —— 風扇抽香煙＝把未熄火星往濾網吸，而 HEPA 是可燃物。紗網是安全件，必在最前。
- 活性碳在 HEPA 之後，否則會先被灰堵死。
- **風扇置於最末＝抽拉式**：推吹式讓扇葉先吃滿香灰油煙（葉形改變、動平衡跑掉、風量衰減、清潔困難）；抽拉式扇葉只碰濾後乾淨空氣。代價：濾箱必須氣密（負壓下漏氣＝髒空氣旁通），組裝時接縫打膠。
- 鼓風式（5015）靜壓遠高於同價軸流扇，推得動 HEPA 壓損；軸流扇會在濾網前「空轉」。

### 7.5 無明火展示機（2026-08-07）

大會禁明火。關鍵事實：**整條決策鏈根本不靠煙** —— FSM 只看 CO₂ 濃度與斜率，而 CO₂ 來自人的呼吸。**會場圍在攤位前的評審與觀眾本身就是訊號源。**

| 原本靠火 | 無火替代 |
|---|---|
| 看得見的煙 | 超音波霧化（冷霧，不放 CO₂）＋ 罩內 LED 側光 |

**★乾冰不能用★**：它是 CO₂ 源，會頂穿 1500ppm 硬警報讓風扇整場全速、分級一次都展示不出來；論述會被自己汙染（量到的是乾冰不是人潮）；冷霧又下沉，集煙罩抓不到。

**兩種建置組態**（`mech_params.py` 的 `BUILD_CONFIGS`）：

| 組態 | open_flame | 近爐溫度 | 說明 |
|---|---|---|---|
| **展示機**（`CURRENT_BUILD`） | False | 35°C（＝感測器艙） | 香不點燃 → **根本沒有熱區** |
| 廟宇爐 | True | 120°C | 實地佈署，真的燒香 |

> ★廟宇爐的耐熱衝突沒有被藏起來★：它會進 `pending_build_conflicts()`，每次跑測試都印出來。

**兩個只有實體才知道的未知**：
- 冷霧不像熱煙會自然上升，靠鼓風機抽吸拉進集煙罩 —— 集煙罩對非浮升煙源抓不抓得到，**只有實體吹過才知道**
- **任何霧都可能觸發場地的煙霧偵測器**（水霧也不例外，光電式偵測器靠散射光判定）—— 只有問主辦單位才知道

### 7.6 STEP 匯出（給 Onshape）

OpenSCAD **匯不出 STEP**（網格／CSG，不是 B-rep），走 OCCT 轉檔。

```bash
cd 外觀CAD
python3 -m venv --without-pip .venv
curl -sS https://bootstrap.pypa.io/get-pip.py | .venv/bin/python
.venv/bin/python -m pip install cadquery-ocp     # 約 300MB
.venv/bin/python export_step.py                  # 零件＋元件＋組合件
```

流程：OpenSCAD 算繪 STL → 用共用頂點／邊建 B-rep 拓樸 → `ShapeFix_Shape` → `ShapeUpgrade_UnifySameDomain` 合併共面三角形 → `STEPCAFControl_Writer`（AP214，mm）→ ★讀回來驗一次★（體積、實體有效性、零件數）。
匯出時還用**散度定理直接從 STL 算一次體積**跟 OCCT 對照，差超過 0.01% 就不輸出。

**★界線★**：

| 能 | 不能 |
|---|---|
| 匯進 Onshape 組裝、量測、做工程圖 | **參數化編輯尺寸** |
| 平面是真正的平面（已合併） | 圓孔／圓柱是**多邊形近似** |
| 零件有中文名稱、組合件有 product 結構 | 沒有特徵樹、沒有草圖 |

**要改尺寸請回頭改 `params.scad` 再重匯。** 在 Onshape 改不會回流，而 `params.scad` 才是驗證讀的來源 —— 兩邊分岔的話，驗證仍會說「通過」。

### 7.7 ★外購元件的尺寸全部是估值★

`components/` 底下**沒有任何一個尺寸實測過**。用途是干涉檢查與目視確認「裝得下、鎖得到」，**不可當成實際尺寸寫進報告或簡報**。

| 元件 | 可信度 |
|---|---|
| Raspberry Pi 5 | 板外形 85×56 與孔位是官方公開值 |
| 金屬爐盆 | 使用者自備，⌀110×45 是假設值 |
| 5015 鼓風機 | 標稱值放餘量 |
| **MATRIX Mini R4** | **官方未公佈外形，整組推估**（現為 90×70） |
| D4184 / SCD41 / SHT31 / MAX6675 | 常見規格，未實測 |

### 7.8 機構已知待處理

- **熱電偶沒有支架** —— 交接文件要求探頭懸於爐面上方 2–3cm，但目前沒有任何零件提供這個固定方式。`components/max6675.scad` 的探頭只是把「應該在哪」畫出來讓缺少的支架顯眼（明確排除在檢查 M 之外）。
- **外殼層與層之間只有摩擦榫，沒有螺絲**。底座↔燃燒艙可加 M4；燃燒艙↔集煙罩改漏斗後起子可及性需重新確認。
- **近爐區實際溫度未實測**，聯鎖門檻 150/130 仍是臨時值。
- **`STEP/` 需重匯**（仍含已移除的理香零件與舊縮口罩）。

### 7.9 螺絲規格

鎖固一律 **M4**（`M4_SHANK_MM = 4.0`）。唯一例外類別是**板卡鎖到殼上** —— 孔徑是外購板自己的孔，M4 桿徑物理上穿不過去；擴孔會削掉板邊銅箔與接地層，不做。

```python
SCREW_BOARD_EXEMPT = {
    "Raspberry Pi 5":    ("M2.5", 2.7),   # 官方機構圖
    "MATRIX Mini R4":    ("M3",   3.2),   # UNO 相容孔位
    "D4184 MOSFET 模組": ("M3",   3.0),   # ★請實測★
}
```
`test_integration` 會逐一驗證「例外是被孔徑逼出來的」，而不是因為 M3 比較好買。

---

## 8. 電路設計與電氣驗證

> 對應檔案：`電路設計/README.md`、`電路設計/電氣驗證計算.md`、`電路設計/kicad/`

### 8.1 檔案

```
電路設計/kicad/
├─ incense_p0.kicad_sch   電路圖本體（訊號實際畫導線，非網路標籤）
├─ 佈線定義.py             元件位置與佈線通道（★改版面只動這個檔★）
├─ 產生電路圖.py           產生器（含版面/佈線/格點自我檢查）
├─ 驗證電路圖.py           結構與連通性檢查（沒 KiCad 也能跑）
├─ 輸出網表.py             人可讀網表
├─ 電路圖.pdf / incense_p0.svg   ★報告可直接用★
├─ incense.kicad_sym + sym-lib-table
└─ 網表.md                 人可讀網表，供與接線表交叉核對
電路設計/接線圖.html         視覺化拓撲＋逐腳位對照＋驗算總表（rev F）
電路設計/麵包板接線圖.html   Fritzing 風格寫實圖
電路設計/電氣驗證計算.md     9 項介面逐項「規格值→計算→餘量→判定」
```

### 8.2 驗證結果

```
KiCad 10.0.5 ERC   0 errors 0 warnings
網表               20 條網路、12 元件，自動命名 0 條
電氣驗證計算       9 項中 8 項合格、1 項需調參（PWM 頻率）
```

**重跑全套**：
```bash
cd 電路設計/kicad
python3 產生電路圖.py && python3 驗證電路圖.py && python3 輸出網表.py
KC="/mnt/c/Program Files/KiCad/10.0/bin/kicad-cli.exe"
"$KC" sch erc --severity-all 'D:\WRO2026\電路設計\kicad\incense_p0.kicad_sch'
"$KC" sch export pdf --output '...\電路圖.pdf' '...\incense_p0.kicad_sch'
```
> KiCad 開著檔案時重跑產生器，KiCad 不會自動重載且會留下 `.lck`，請關閉專案再重開。

### 8.3 ★最有價值的發現★：3.3V 訊號接不進 R4 的數位腳

（三板時期的歷史紀錄，但**結論仍然重要**）

```
原設計：S3 GPIO4 (3.3V) ──直接接──> R4 D2（數位腳）
R4 (RA4M1) 數位輸入 VIH = 0.8 × VCC = 4.0V
餘量 = 3.3 − 4.0 = −0.7V   ✗ 規格上讀不到 HIGH
```

原指南寫「3.3V 是邊界值、實務上幾乎都過」—— 那是 UNO **R3**（ATmega328P，VIH = 3.0V）的經驗。UNO **R4** 換 RA4M1 後門檻升到 4.0V，同一條線不再成立。

**這條線正是「Pi 當機時保命」的硬體旁路，平常完全測不出來。**

**採用解法：改接類比腳 A0（零元件）**
```
S3 拉高 3.3V → ADC ≈ 675/1023 ；放開 0V → ADC = 0
韌體門檻 > 500 判警報、< 300 才解除（軟體遲滯，取代數位腳的施密特輸入）
兩側餘量 175 / 500 counts
```

**★不可用 BSS138 雙向模組★**：S3 斷電時其 HV 側 10kΩ 上拉會讓 R4 誤讀成警報中、風扇鎖死全速，反而破壞降級行為。加下拉去壓制又會與上拉分壓成 2.5V，正常運作時反而失效 —— **兩種情況無法兼顧**。

**其他方案**：74**HCT**125／14 可行（HCT 是 TTL 準位 VIH=2.0V）；74**HC**125 與 CD4050B **不行**（VIH = 0.7×VCC = 3.5V，一樣不夠，而且 HC/HCT 外觀腳位相同極易買錯）。

> 兩板架構後警報線整條取消，但 **RA4M1 VIH = 4.0V 這個結論仍然重要** —— 日後任何 3.3V 訊號要接進這塊板子的數位腳都會遇到同樣問題。

### 8.4 其他電氣驗算重點

| 項目 | 結果 |
|---|---|
| R4 PWM → D4184 閘極 | ✅ 5V 推挽驅動綽綽有餘；模組通常已含閘極下拉（未初始化時風扇不誤啟動） |
| 風扇電流 vs D4184 | ✅ 0.2A vs 15A，約 75 倍餘量；啟動突波 ≈0.6A 仍在範圍內 |
| I²C 匯流排 | ✅ tr ≈ 210ns vs 上限 1000ns，約 4.7 倍餘量；`Wire.setClock(100000)` |
| MAX6675 ↔ R4 | ✅ 兩端同 5V 直接相接；轉換 220ms，輪詢 ≤4Hz |
| 12V 電源預算 | ✅ 3A 電源，展示機實際負載遠低 |
| **風扇 PWM 頻率** | ⚠️ **需調參** —— 預設 490 Hz 落在可聽範圍會嘯叫，建議用 R4 核心 `pwm.h`(PwmOut) 拉到 **25 kHz** |
| **S1 duty = 70** | ⚠️ 可能低於無刷風扇最低啟動占空比（常見 30–40%，即 77–102），需實測 |

**2 線無刷風扇的取捨**：只能低側斬波供電，內部換相電路跟著斷電。頻率太低（數百 Hz）→ 反覆重啟、轉速不穩；太高（25kHz）→ 內部電容濾波後接近直流，較穩且無嘯叫。若實測仍不穩，正規解法是換 **4 線 PWM 風扇**（獨立 PWM 腳，不斬斷主電源，資料中心標準做法）。

### 8.5 ERC 修正史（值得記住的兩類問題）

| 問題 | 原因 | 修法 |
|---|---|---|
| `power_pin_not_driven` | 所有電源腳都標 `power_in`，等於沒有元件在供電 | 真正供電端改 `power_out`；GND 放 `PWR_FLAG` |
| `lib_symbol_issues` | 符號雖內嵌可顯示但沒註冊符號庫 | 另存 `incense.kicad_sym` ＋ `sym-lib-table` |
| `endpoint_off_grid` | 座標沒對齊 1.27mm 格點 | 把格點檢查寫進產生器的 `self_check()` |

第一版 44 項違規 → 修到 0。**兩層驗證互補**：`驗證電路圖.py` 驗「檔案結構與座標連通性」（沒 KiCad 也能跑），KiCad ERC 驗「電氣語意」（非得有真工具）。**兩層都要跑。**

---

## 9. 自動化驗證體系（三層迴路）

> 對應檔案：`.claude/commands/verify.md`、`run_tests.py`、`CAD自檢/`

### 9.1 為什麼長這樣：★AI 看不到的東西★

這是整套流程的設計前提：

- **看不到 3D 模型** → 機構驗證拆成「參數規則」與「STL 幾何」兩層自動判定，外觀與人因只能靠人
- **看不到實體硬體** → 所有「量測值」在有人實際量過之前都是估計值
- **看不到 Grafana 畫面** → 面板是否正常必須由人確認

因此：**永遠不要宣稱需要實體或目視才能確認的事情「已驗證」。**

### 9.2 三層

| 層 | 驗證器 | 速度 | 抓得到 | 抓不到 |
|---|---|---|---|---|
| **L1 參數規則** | `run_tests.py` / `test_mech_design.py` | 毫秒 | 尺寸衝突、材料誤用、間隙不足、預算超支、過濾鏈順序 | 任何形狀相關的事 |
| **L2 幾何檢查** | `verify_stl.py` / `驗證CAD.py` | 秒～分 | 破面、外框超尺寸、通孔數不符、體積異常、法向量錯亂 | 是否好用、應力、外觀 |
| **L3 實體行為** | **人** | 天 | 熱變形、氣流、插香手感、耐久 | — |

> L1 是最被低估的一層：**多數機構錯誤其實是參數之間的算術**。「孔距 − 孔徑 ≥ 最小壁厚」不需要幾何就能驗證，而它正是最常出錯的地方。建模之前先把 L1 跑綠。

### 9.3 全部驗證指令

```bash
# 機構規則（純標準函式庫，不需 pytest）
python3 run_tests.py
python3 run_tests.py -k PLA           # 只跑名稱含 PLA 的規則
python3 run_tests.py --scope core     # 只跑核心里程碑範圍
python3 -m pytest -q                  # 若環境有 pytest，行為等價

# 外觀 CAD（會實際呼叫 OpenSCAD 算繪，約 2 分鐘）
python3 外觀CAD/驗證CAD.py

# 幾何層（CAD 匯出 STL 後）
python3 CAD自檢/verify_stl.py <檔案>.stl

# 電控韌體
python3 R4/matrix_mini_r4/驗證韌體.py
python3 PI5/驗證資料流.py

# 電路
cd 電路設計/kicad && python3 產生電路圖.py && python3 驗證電路圖.py

# 查看還有哪些數值沒實測
python3 -c "import sys; sys.path.insert(0,'CAD自檢'); import mech_params as P; print(P.unmeasured_items())"
```

> `run_tests.py` 是純標準函式庫實作。本機系統 Python 受 PEP 668 保護裝不了 pytest，**不要為了跑測試而用 `--break-system-packages` 動系統環境**（需要套件請開 venv）。

### 9.4 外觀 CAD 的 13 類檢查（A–M）

| 代號 | 檢查 |
|---|---|
| A | 語法、模組定義與呼叫 |
| B | 列印規則（壁厚為噴嘴徑整數倍等）＋ 必要參數缺漏 |
| C | 元件裝得下嗎（含感測器艙走線深度） |
| D | 零件放得進列印床 |
| E | 熱設計（空氣間隙、材料） |
| F | 煙道介面一致性（含「煙道開口整個落在直筒段」＋喇叭角度） |
| G | 實際算繪：manifold、浮空塊、算繪警告 |
| H | 組裝干涉 ＋ 落座檢查 |
| I | 列印性（懸空面積、橋接跨距） |
| J | 開口外側有沒有被別的零件擋住 |
| K | 與上次的幾何基準比對（`.baseline.json`） |
| L | 開口本身有沒有真的通（探針貫穿；含「探針自己不能是空的」的前置檢查） |
| M | 外購元件 vs 外殼干涉 |

### 9.5 跨層規則（`CAD自檢/test_integration.py`）

存在理由：機構、韌體、電控三者各有參數檔，**彼此矛盾時沒有任何單一領域的檢查抓得到**。核心範圍（`SCOPE_CORE`，21 條）包含：

- 熱電偶聯鎖門檻必須高於該位置的預估工作溫度
- 聯鎖解除門檻需低於觸發門檻且有足夠遲滯
- SCD41 安裝位置溫度不可超過其工作上限
- 感測器不可裝在煙道或近爐區
- 韌體驅動路數需涵蓋機構規劃的風扇數量
- S2 高峰 duty 需明顯高於 S1 常態
- 安全狀態必須停止致動
- CO₂ 硬警報必須維持絕對門檻
- 韌體聯鎖門檻需與參數檔同步
- 臨時安全門檻必須被標記
- 鎖固一律使用 M4 且例外必須有物理理由
- 現行配置的 12V 電流須在電源餘裕內／現行風扇數需與電路圖一致
- **★殘留守門★**：電路圖不得再有 `MAGn` 網路、韌體不得再有電磁鐵控制碼
- 列出尚未實測的項目／列出其他建置組態的已知衝突

`SCOPE_LATER`（P3 廟宇爐＋過濾鏈）：禁 PLA 區、金屬紗網在 HEPA 之前、活性碳在 HEPA 之後、風扇靜壓 > 過濾鏈壓損、完整設計 12V 峰值等。

### 9.6 唯一真相來源表（★改東西前先確認你改的是來源而不是副本★）

| 領域 | 唯一真相來源 |
|---|---|
| 機構尺寸 | `CAD自檢/mech_params.py` |
| 外觀尺寸 | `外觀CAD/params.scad`（零件檔不得寫死數字） |
| 外觀幾何 | `外觀CAD/parts/*.scad` ＋ `incense_burner.scad`（組裝定位） |
| 電路 | `電路設計/kicad/佈線定義.py` → 產生器產出 `.kicad_sch` |
| 韌體常數 | `R4/matrix_mini_r4/matrix_mini_r4.ino` |
| 雲端儀表板 | `cloud_dash/*.json`（WSL 的 `~/incense-cloud/` 只是工作副本） |

**產生器產出的檔案不要手改** —— 改來源再重跑產生器，否則下次重跑會被覆蓋。

### 9.7 無人值守迴圈

`auto_loop.sh` 會在無人看管時反覆「驗證 → 修正 → 再驗證」。
`.claude/stop_gate.sh` 有 3 次上限，用完會強制放行並要求回報卡關 —— 這個上限是防止無限迴圈燒額度用的，**不要移除**。

---

## 10. 工作規則與★紅線★

> 對應檔案：`CLAUDE.md`（每次工作前必讀）、`.claude/commands/verify.md`

### 10.1 ★紅線★（違反即視為任務失敗）

1. **修改測試斷言**或放寬驗證器容差，以讓輸出變綠
2. **放寬安全與可製造性下限**：壁厚、氣隙、耐熱溫度、列印最小特徵等下限
3. **規避禁 PLA 區**：把近爐零件改用 PLA，或把零件標成 `near_censer=False`
4. **調換 `FILTER_CHAIN` 順序** —— 金屬紗網必須在 HEPA 之前（火星防護）
5. **把 `*_MEASURED` 旗標改成 `True`** —— 只有人實際量過才能改
6. 用 `skip` / `try-except-pass` / 註解掉測試來消除失敗
7. **宣稱需要實體硬體或目視才能確認的事項「已驗證」**

參數之間衝突到無解時，正確反應是**回報衝突並提出取捨方案**，讓人決定 —— 那是設計決策，不是 agent 該自己選的。

### 10.2 一般原則

- 動任何設計參數前，先跑一次驗證看現況；改完再跑一次，比較差異
- 失敗時**修設計，不修測試**
- 不確定該怎麼取捨時，依 §10.4 回報卡關，不要猜

### 10.3 硬體邊界：永遠人在迴路

以下**無法**由任何自動檢查取代：
熱變形實測｜氣流與抽排效能｜插香手感與人因｜列印件強度與耐久｜外觀與文化適切性（廟方觀感）｜韌體實機燒錄行為

### 10.4 卡關回報格式

```
## 卡關：<一句話標題>

**現況**       <跑了什麼、得到什麼輸出>
**衝突點**     <哪兩個以上的要求互相矛盾，各自出處>
**為什麼我不自己決定**  <安全紅線／需實測／需採購／設計取捨>
**選項**       A. <做法> → <代價>  B. ...  C. ...
**我的建議**（可選）  <說明理由，並明確標示這是建議不是決定>
```
一次回報一個卡關點。多個卡關時依嚴重度排序，先講會讓系統完全失效的。

### 10.5 密碼與機密

- MQTT、Grafana、Tailscale 的密碼**一律不寫進任何檔案**，包含註解與文件
- 需要密碼時開口問人，用完不要留在腳本裡
- 文件只列帳號名，密碼欄一律寫「由使用者保管」

---

## 11. 誠實邊界（對外可以說什麼、不可以說什麼）

> 這是本專案的核心價值主張之一，也是評審加分項。**接手者務必嚴格遵守。**

### 11.1 「設計目標」vs「實測值」

`mech_params.py` 中所有 `*_MEASURED = False` 的項目都是**估計值**。基於它們的任何數字，在報告中**只能稱「設計目標」**，不能寫成實測結果。

**目前未實測清單**（`unmeasured_items()`）：
1. 香爐內徑／深度
2. 近爐區實際溫度
3. 風扇靜壓（含過濾壓損下的實際風量）
4. 風扇啟動突波倍率
5. 感測器艙實際溫度
6. 超音波霧化模組實際電流

**優先量測順序**（`.claude/commands/verify.md` §6）：
1. **香爐內徑與深度** —— retrofit 模組要架在真爐上，量錯整個外形重來
2. **近爐區實際溫度** —— 用 MAX6675 直接量，同時驗證禁 PLA 區範圍與聯鎖門檻
3. **風扇靜壓與啟動突波** —— 決定過濾鏈選型與電源餘裕的真實性
4. **霧化模組實際電流**
5. **感測器艙實際溫度** —— SCD41 上限 60°C 的安全餘裕

### 11.2 ★聯鎖門檻 150/130 是臨時值★

原本 80/60 低於熱電偶位置的預估工作溫度（120°C），正常燃燒就會鎖死風扇（聯鎖優先權高於一切）。2026-08-02 提高為 150/130，但這**沒有實測依據**，只是「先讓系統跑起來」。

`T_LOCK_PROVISIONAL = True` 追蹤這件事。**實測熱電偶位置的真實溫度後必須重定，報告在那之前不得將此門檻描述為已驗證的安全設定。**

### 11.3 ★資料真偽邊界★

- **`aroma02` 是 `sim_burner.py` 產生的模擬資料** —— 任何展示、報告、簡報都必須明確標示為模擬機
- **`aroma01`** 自 **2026-08-08 01:15（台北）** 起是真實 Pi5＋R4 的實測資料
  - 但 InfluxDB 裡該時間點**之前**的 aroma01 歷史（2026-07-30 起）是當時模擬器發的
  - aroma01 實測資料在兩處：雲端（08-08 01:15 ～ 08-09 Pi 斷線）與 Pi 本地新棧（08-10 起），**中間有斷層**（SD 故障停擺期）
  - 引用任何連續區間都必須註明
  - 補傳資料的 InfluxDB 時間戳是**到達時間**非量測時間

### 11.4 講稿可以說 / 不可以說

| 可以說 | 不可以說 |
|---|---|
| 「原型已實機上線，感測資料每秒進雲端面板」（指感測—決策—雲端**資料鏈**） | 抽排降污的**成效數字**（H1–H3 全未實測） |
| 「設計目標是…」 | 「實測改善 XX%」 |
| 「29 條自動化設計規則自檢通過」 | 「過濾效率 XX%」 |
| 「aroma02 為模擬機」 | 把模擬資料當實測展示 |

---

## 12. 簡報／構想書現況

> 對應資料夾：`簡報/`

| 檔案 | 內容 |
|---|---|
| `未來新創家＿高中職組.pptx` | 原稿（未動） |
| `未來新創家＿高中職組_v2.pptx` | 完整論述版（換圖 ×5、文字改寫 ×12 頁） |
| `未來新創家＿高中職組_v3.pptx` | **視覺重排 25 頁**：每頁蒸餾為重點條列＋大數字卡＋圖解 |
| `現場簡報_3分鐘.pptx` | 同套色票同步更新 |
| `一分鐘講稿.md` | 定稿 ＋ v2 建議稿（加 traction 句與買方視角） |
| `計畫書優化研究筆記.md` | 三路研究代理彙整（競賽／商業／大企業說服術）＋ v2/v3 改動清單 |
| `FGC工程筆記精讀.md` | FGC 2024 中國隊工程筆記 18 頁精讀，v4 候選改進 |
| `未來新創家＿高中職組範例版型 (1).pptx` | 主辦方範例版型 |
| `得獎計劃構想書照片.eml` | 參考資料 |
| `Team People's Republic of China Engineering Notebook 2024.pdf` | 標竿工程筆記（19MB） |

### 12.1 ★WRO 2026 Future Innovators 硬規格（照抄會出局）★

- 報告全文 **≤20 頁單面**、超頁 **0 分**、PDF **≤15MB**
- **AI 使用必須揭露**（用了什麼、用在哪、程度）—— 已寫在參考來源頁 ✅
- 攤位 2×2×2 m、**禁明火、不禁霧氣**（2026-08-16 使用者查證定案）
- 評分表（Senior 200 分）：
  - Project & Innovation **75**（Idea 20／Research 15／Social 10／Slogan 10／創業元素 10／Next Steps 10）
  - Robotic Solution **70**
  - Presentation **55**
- **要求訪談 ≥3 位非教練非家長的外部人士並寫進報告** —— ★目前缺★

### 12.2 六項驗收標準現況

| # | 標準 | 狀態 |
|---|---|---|
| 1 | 真實且可量化的痛點 | ✅（1,360 μg/m³、年 3 千件陳情、來源齊備） |
| 2 | 算得出來的市場（SOM 由下而上） | ✅ v2 已補（約 200 座 × 三年轉換 15% ≈ 30 座） |
| 3 | 已發生的 traction 而非預測 | ✅ v2 已補（實機上線、每秒入庫、29 條自檢規則） |
| 4 | 單位經濟與資金用途綁里程碑 | ⚠️ 部分 —— **缺單台 BOM→售價→毛利一頁表**（待 BOM 定價） |
| 5 | 團隊執行紀錄 | ✅（traction 句 + 機構迭代／敢刪故事） |
| 6 | 誠實揭露風險 | ✅（原稿即強項；v2 加 AI 揭露更新） |

### 12.3 視覺設計 tokens（v3 與現場簡報共用）

- 色票「**硃砂鎏金**」：硃砂 `#9E3B2F` ／鎏金 `#C9A227`（面積 <5%）／墨 `#33302B`（深底 `#2E2A26`）／宣紙米白 `#F8F4EC`
- 60-30-10 面積律，單頁最多兩種有彩色
- 版心邊距＝頁寬 8%；字級三層制（標題:內文 ≥2.5:1）
- 卡片圓角無框線米白底；大數字卡：數字 25pt+ 主色、說明 9.5pt 灰
- 結論框＝主色 tint 底 ＋ 左緣 3pt 粗線
- 頁腳固定「專案名（左）＋頁碼（右）」；內文一律左對齊
- QA 流程：PowerPoint COM 逐頁轉 PNG 目視檢查

### 12.4 ⚠️ 頁數提醒（需人決定）

範例版型規定「方案 ≤12 頁、社會創新 ≤6 頁」，本書沿用原稿結構為 **13**（含 3-3B）＋**7**（含 4-5B）。
**若主辦方嚴格執行頁限，需把 3-3B 併入 3-3、4-5B 併入 4-5。** v2/v3 結構相同，改起來都容易。

### 12.5 FGC 標竿：抄 5 件 / 不抄 3 件

**抄**：① Iteration 三問敘事（改了什麼→為什麼→實測又暴露什麼）② 系統總覽頁當視覺目錄 ③ 三色紀律＋章標每頁重複＋大號頁碼 ④ 白板／手繪當一手證據 ⑤ 坦承未完成（我們有更制度化的 `*_MEASURED` 清單）

**不抄**：① 零表格純敘事的測試紀錄（我們有 InfluxDB 連續實測，用表格與曲線更有力）② 「賽季拆解→得分策略」開篇（我們是解決方案題，開篇應為問題場景→使用者→需求推導＋文化適切性）③ 國家隊級 Publicity 贊助牆

---

## 13. 重大決策時間軸

| 日期 | 決策／事件 |
|---|---|
| 2026-07-15 | 硬體設計交接文件初版（三板架構：ESP32-S3／R4／Pi5） |
| 2026-07-30 | 雲端中心站部署完成，12 項驗收（C1–C12）全過 |
| 2026-07-31 | 電路設計與電氣驗證新增；**發現 RA4M1 VIH=4.0V 缺陷**，改接 A0 |
| 2026-08-02 | **拍板兩板架構**（Pi5 ＋ MATRIX Mini R4）；聯鎖門檻 80/60 → **150/130**（臨時值）；螺絲統一 M4；外觀 CAD 首版 |
| 2026-08-06 | 外觀 CAD 拆成一零件一檔，加入外購元件模型，新增 STEP 匯出 |
| 2026-08-07 | **產品定位拍板：retrofit 改裝模組**；三板殘留全部刪除；**無明火展示機**組態化；CO₂ 門檻改**相對背景基線** |
| 2026-08-08 | **真爐 aroma01 上線**（R4 燒錄、Pi5 佈建、資料鏈全通）；aroma03 清除 |
| 2026-08-09〜10 | SD 卡故障 → **NVMe 遷移**（Pironman 5 + WD SN750 SE）；單機監測棧；**比賽現場模式演練通過**；發現「R4 斷電不自動開機」 |
| 2026-08-11 | 筆電接手；R4 韌體重燒（COM12）；一分鐘講稿定稿；**設備帶往外地** |
| 2026-08-12 | DS18B20 上線（A2 埠）；R4 卡死事件（08-11 21:40 telemetry 中斷） |
| **2026-08-16** | **① 理香機構整組移除**（插孔板／套筒／磁力矩陣全拆）**② 集煙罩漏斗化**（96→180mm）**③ 構想書 v2/v3 ＋ 現場簡報產出** **④ 查證 WRO 不禁霧氣** |

---

## 14. ★專案特有的坑★（踩過的，不要再踩）

> 這是 `CLAUDE.md` §4 的完整清單，接手第一天就該讀。

1. **MATRIX Mini R4 的 D2、D3 埠不能用**。`MiniR4.begin()` 內執行 `PS2.config_gamepad(11, 4, 12, 5)`，把腳 11/4/12/5 佔為手把介面。**只用 D1、D4**。

2. **MatrixMiniR4 函式庫（≤1.2.5）與 Adafruit BusIO 連結衝突**。該庫把 `Adafruit_I2CDevice` 整個類別抄進 `src/Modules/MiniR4_I2CDevice.cpp`，與 Adafruit_SHT31 相依的正牌 BusIO **十個符號全數重複定義**（multiple definition）。
   已在使用者函式庫以 `#if !__has_include(<Adafruit_I2CDevice.h>)` 包住整檔讓位 ——
   ★**函式庫一更新補丁就消失**★，連結錯誤重現時照 2026-08-08 的做法重加。

3. **Arduino 草稿本位置因機而異**：
   - 桌機：`C:\Users\feihong\OneDrive\文件\Arduino`（**不是** `Documents\Arduino`）
   - 筆電：`C:\Users\feihong\Documents\Arduino`（BusIO 讓位補丁已重加在該副本）
   - arduino-cli 在 `C:\Users\feihong\Arduino IDE\resources\app\lib\backend\resources\`

4. **UNO R4 的 `snprintf` 不保證支援 `%f`**。組 JSON 用 `Serial.print(x, 2)`。

5. **馬達埠是 5V**（`Port M1 DC 5V Motor`），推不動 12V 風扇，**D4184 必須保留**。

6. **UNO R4 WiFi 內建的 ESP32-S3 不能替代獨立開發板** —— 它是網路協處理器，GPIO 一支都沒拉到排針，不能讀感測器、不能控風扇（PWM 屬於 RA4M1）。只能做網路。

7. **Grafana Public Dashboard 不代入模板變數**，且**文字型欄位在 stat 卡片顯示不出來**（解法見 §6.3）。

8. **KiCad 的 `power_pin_not_driven`**：每條電源網路要有 `power_out` 或 `PWR_FLAG`。

9. **OpenSCAD 的 `Volumes` 不是 2 代表有浮空塊** —— 參數檢查看不出來，只有算繪才知道。

10. **Windows 的 .exe 看不到 WSL 的 `/tmp`**，暫存檔要放在 `/mnt/` 底下。

11. **OpenSCAD 的 `include`／`use` 路徑不吃非 ASCII**。中文檔名或中文目錄一律回報 `Can't open include file`，錯誤訊息本身是 CP950，`text=True` 的 subprocess 會直接丟 `UnicodeDecodeError`。註解裡的中文沒問題，**只有路徑不行** —— 所以 `外觀CAD/` 底下被 include 的 `.scad` 與其目錄一律用 ASCII。

12. **`use <>` 不帶變數** —— 零件檔裡定義數字會讓 `incense_burner.scad` 算成 `undef`，幾何空掉時交集永遠 0，**檢查會靜默通過**。

13. **`part` 名稱打錯要 assert 失敗，不能靜默退回 `assembly()`** —— 否則匯出 STEP 時每個元件都在算整台機器，一個爐盆跑十幾分鐘才發現。

14. **爐面的條紋是 F5 預覽假影**（OpenCSG 對半透明物件不做深度排序），按 F6 就沒了。

15. **MAX6675 模組整個未接時 SPI 讀全零**，`tc_fault=0`、`t_furnace=0.00` —— 韌體只能偵測熱電偶開路，**判不出模組缺席**，接線日勿誤判。

16. **DS18B20 不能插 D1** —— D1 左（腳 3）是風扇 PWM、右（腳 2）是 MAX6675 CS；函式庫 `MXOnewireDT` 用埠的左腳。A1/A2 是僅存空埠。

17. **usb-watchdog v1 判不出「枚舉在但主迴圈死了」** —— 08-12 R4 卡死事件（OLED 凍結＝整個主迴圈卡死，顯示／感測／telemetry 同一個 loop）。v2 已加測「`incense/sensor` 15 秒無訊息」。

18. **Pi5 的 `uhubctl` 埠「斷電」實際上不切 VBUS**（R4 uptime 不歸零），只做重新協商 —— 可救 CDC 軟卡死，救不了完全消失。

19. **R4 斷電後不會自動開機**，必須手動按電源鍵（看門狗無法軟體代按）。

20. **KiCad 開著檔案時重跑產生器**：不會自動重載且會留下 `.lck`，請關閉專案再重開。

21. **系統 Python 受 PEP 668 保護** —— 不要用 `--break-system-packages`，需要套件請開 venv。

---

## 15. 待辦清單（依優先序）

### 15.1 🔴 P0 — 硬體上線關鍵路徑

- [ ] **感測器接線（SCD41／SHT31／MAX6675）** —— ★卡住★
      SCD41 用杜邦線跳 I²C1 後，I²C 掃描在所有匯流排（Wire、Wire1 直通、mux ch0-7）都掃不到 `0x62`，電氣層根本沒接通。
      **頭號嫌疑：R4 的 Grove 座是 2.0mm 間距，杜邦頭是 2.54mm，直插插不緊。**
      建議改用 **Grove 轉杜邦轉接線**。掃描器結果：多工器 `0x70` 與板載 OLED `0x3D` 正常，板子本身沒問題。
      照 `電路設計/接線圖.html` rev F 的「無腦對照表」接。接完 `-99.9` 會變真實讀值。
      ★**R4 上目前跑的是 `R4/i2c_scanner_temp/` 臨時掃描器**★（每 3 秒掃一輪）—— 接線解決後**必須重燒 `R4/matrix_mini_r4/`**。

- [ ] **R4 韌體重燒**（理香移除版）—— 板上仍是舊韌體

- [ ] **★PCF8574 存廢拍板★**（等使用者決定）
      理香移除後 PCF8574 上只剩 2 路負載（OUT5 霧化、OUT6 罩內 LED），八路板過度設計：
      - **方案 B（建議）**：改用 2 顆 D4184 接 Analog 1/2 孔 —— 零新零件種類（D4184 已在 BOM）、韌體更簡單、省掉 I²C3 一整條匯流排
      - **方案 A**：維持 PCF8574（現行電路圖／韌體照此畫，但只用 2/8 路）
      拍板後要動：`R4/matrix_mini_r4/matrix_mini_r4.ino`（致動段）、`電路設計/kicad/佈線定義.py`＋重跑產生器、`電路設計/接線圖.html`
      ★**在拍板前，不要採購 PCF8574 板**★

- [ ] **DS18B20 資料上雲（3 步）**
      1. 筆電 SSH 公鑰塞進 Pi（`connect.raspberrypi.com` → `feihongPi5` → Remote shell → 貼 `裝公鑰指令.txt` 那行）→ 之後 `ssh root@100.88.179.95`
      2. 把筆電版 `PI5/pi_fsm.py` scp 到 Pi，`systemctl restart incense-fsm`（不做這步 `t_ds` 會被白名單濾掉）
      3. 雲端 Grafana（`http://100.73.36.75:3000`）Import 覆蓋 `cloud_dash/dashboard_aroma01_public.json` 與 `grafana_dashboard_fleet.json`（uid 相同，公開連結不會失效）
      4.（選配）Pi 本地 Grafana 也匯入

- [ ] **採購官方 27W 電源** —— 低壓重置是 SD 卡的死因，根治靠這顆
- [ ] **補購**：D4184 MOSFET 模組、12V 電源（BOM 有編列但清單漏了）
- [ ] **R4 換一條 USB 線 ＋ 帶備用**（CDC 軟卡死兩次，線材頭號嫌疑）

### 15.2 🟡 P1 — 系統完善

- [ ] **MQTT 帳密缺口（真爐上線前必處理）**
      `P0接線與驗證指南.md` §3.2 把 Pi 本機 mosquitto 設 `allow_anonymous true`，但 `pi_fsm.py` 的 `client.connect()` **沒有帳密參數的位置** —— 屆時只改 broker 設定會直接連不上
- [ ] **風扇 PWM 頻率**：預設 490 Hz 會嘯叫，改用 R4 核心 `pwm.h` 拉到 25 kHz
- [ ] **S1 duty = 70 實測** —— 可能低於無刷風扇最低啟動占空比，用 `FAN 60/70/80` 逐級測記下真實門檻
- [ ] **Phase 2**：MATRIX 經內建 WiFi 直送雲端（Pi 失效時的備援路徑，韌體末尾已標好掛載點）
- [ ] 重跑 `export_step.py` 更新 `STEP/`
- [ ] 熱電偶支架設計（目前沒有任何零件提供固定方式）

### 15.3 🟢 P2 — 實測與資料

- [ ] **燃燒艙實驗**（H1–H3 假說檢定）—— 所有成效數字的來源，目前完全未做
- [ ] 依 §11.1 優先序把 6 項估值換成實測值
- [ ] 實測元件尺寸後更新 `params.scad`（MATRIX_W/D、SCD41_*、SHT31_*、D4184_*、BOWL_D/H、FAN_SCREW_S）
- [ ] 匯出 STL 試印

### 15.4 📄 競賽文件

- [ ] **外部訪談 ≥3 人**（廟方管理者、信眾、消防/環工）附紀錄 —— **評分硬性要求**
- [ ] **單位經濟一頁表**（BOM 成本→售價→毛利，等 BOM 定價）
- [ ] **產品名 ＋ slogan**（Key Innovation & Slogan 佔 10 分）
- [ ] **Grafana 面板實截圖**放進 3-12（需人截，AI 看不到畫面）
- [ ] v2/v3 逐頁目視：文字改寫處是否溢出文字框
- [ ] 頁數決定：3-3B 是否併入 3-3、4-5B 是否併入 4-5
- [ ] v4 候選：系統總覽頁（香爐全圖＋標籤，兼當各章目錄）、白板／手繪決策樹當證據

---

## 16. 環境、帳號、網址、金鑰

### 16.1 環境

| 項目 | 值 |
|---|---|
| repo | `https://github.com/feihong9487/WRO2026.git`（分支 `master`） |
| 本機路徑（筆電） | `C:\Users\feihong\Downloads\WRO2026-master\WRO2026-master\` |
| 桌機歷史路徑 | `D:\WRO2026\` |
| 雲端部署目錄 | `~/incense-cloud`（WSL2 Ubuntu 24.04 家目錄） |
| KiCad | 10.0.5，`C:\Program Files\KiCad\10.0\bin\kicad-cli.exe`（WSL 可直接執行，參數用 Windows 路徑） |
| arduino-cli | 1.4.1，筆電路徑見 §14.3 |
| Tailscale tailnet | `feihong9487.github`（帳號 `feihong9487`） |

### 16.2 網路位址

| 節點 | Tailscale IP | 備註 |
|---|---|---|
| 家裡桌機（雲端中心站） | `100.73.36.75` | Funnel 對外 |
| Pi 5 aroma01 | `100.88.179.95` | NVMe 遷移後的新 IP（舊：`100.113.207.110`） |
| 熱點下區網 IP | `172.20.10.x` | **會變，別依賴** |

### 16.3 帳號（★密碼一律由使用者保管，不記錄明文★）

| 系統 | 帳號 |
|---|---|
| Grafana 管理員（雲端 & Pi 本地） | `admin` |
| MQTT 橋接帳號（爐子用） | `burner` |
| MQTT Telegraf 帳號 | `telegraf` |
| Raspberry Pi SSH | **只認 `root`**（`feihong@`／`pi@` 都 denied） |
| Raspberry Pi Connect | 裝置名 `feihongPi5` |

InfluxDB 資料來源（Grafana 內）：`InfluxDB-incense`，org=`incense`，bucket=`incense`（本地固定 token，非帳密登入）。雲端 datasource uid `dftmtpkivyadcb`；Pi 本地 uid `incense-influx`。

### 16.4 SSH 公鑰安裝（`裝公鑰指令.txt`）

在 Raspberry Pi Connect（`connect.raspberrypi.com` → `feihongPi5` → Remote shell）貼：

```bash
sudo mkdir -p /root/.ssh && echo 'ssh-ed25519 AAAAC3NzaC1lZDI1NTE5AAAAIKTW78HuANYZFpGwx3kSD8dop3X7GM27BA90+MoXbu/J feihong-laptop' | sudo tee -a /root/.ssh/authorized_keys && sudo chmod 700 /root/.ssh && sudo chmod 600 /root/.ssh/authorized_keys
```

### 16.5 真爐 provision 參數

```
CLOUD_MQTT=100.73.36.75
MQTT_USER=burner
MQTT_PASSWORD=<向管理者索取>
```
該 Pi 也需 `tailscale up` 加入同一 tailnet 才能透過 100.x 位址連上雲端中心站。

### 16.6 模擬爐管理

```bash
cd ~/incense-cloud
nohup python3 sim_burner.py aroma02 --host localhost --user burner --password '<密碼>' > /tmp/sim_aroma02.log 2>&1 &
pkill -f sim_burner   # 停止
```
> `nohup` 背景程序**不會隨開機自動恢復**，展示前需手動重跑。

---

## 17. 檔案索引（repo 全貌）

```
WRO2026-master/
├─ CLAUDE.md                    ★每次工作前必讀的共同規則★
├─ .claude/
│   ├─ commands/verify.md       機構 Loop Engineering（三層迴路）
│   ├─ settings.json
│   └─ stop_gate.sh             無人值守迴圈的 3 次上限（不要移除）
├─ auto_loop.sh                 無人值守「驗證→修正→再驗證」
├─ run_tests.py                 L1 機構規則 ＋ L1b 跨層（純標準函式庫）
│
├─ 專案進度.md                  ★跨會話進度存檔，新會話先讀這份★
├─ 交接任務_筆電接手.md          2026-08-11 筆電接手指引
├─ 智慧香爐_硬體設計交接.md      硬體詳解（★理香段落已成歷史紀錄★）
├─ P0接線與驗證指南.md           六關驗證關卡（部分為三板版歷史）
├─ 部署紀錄.md                  雲端部署完整紀錄與 SOP ＋ 三個附錄
├─ 任務書_雲端中心站部署.md      原始委派紀錄（★不修改★）
├─ 待辦_DS18B20部署.md           DS18B20 上線的 3 步待辦
├─ 裝公鑰指令.txt                Pi SSH 公鑰安裝指令
│
├─ R4/
│   ├─ matrix_mini_r4/          ★現行★ 合併版韌體（感測＋安全＋致動）
│   │   ├─ matrix_mini_r4.ino
│   │   └─ 驗證韌體.py
│   └─ i2c_scanner_temp/        臨時 I²C 掃描器（★目前燒在板上★）
│
├─ PI5/
│   ├─ pi_fsm.py                決策層 FSM（S0/S1/S2/S3）
│   ├─ 驗證資料流.py             欄位契約檢查
│   ├─ incense-fsm.service      systemd 服務
│   ├─ provision.sh             真爐佈建腳本
│   ├─ docker-compose.yml / telegraf.conf / grafana_dashboard_incense.json
│   └─ 雲端監測平台指南.md
│
├─ cloud_dash/                  ★雲端儀表板 JSON 正本★
│   ├─ cloud-docker-compose.yml / cloud-mosquitto.conf / cloud-telegraf.conf
│   ├─ grafana_dashboard_fleet.json
│   ├─ dashboard_aroma01_public.json / dashboard_aroma02_public.json
│   ├─ sim_burner.py            模擬爐產生器
│   └─ 多爐平台指南.md
│
├─ 電路設計/
│   ├─ README.md / 電氣驗證計算.md
│   ├─ 接線圖.html（rev F，★實接看這份★）/ 麵包板接線圖.html
│   └─ kicad/                   電路圖＋產生器＋驗證＋網表＋PDF/SVG
│
├─ 外觀CAD/
│   ├─ params.scad              ★唯一真相來源★
│   ├─ common.scad / parts/（5 件）/ components/（8 檔）
│   ├─ incense_burner.scad      組裝定位
│   ├─ 驗證CAD.py（A–M 13 類）/ export_step.py
│   ├─ 設計說明.html / 檔案結構與匯出.md
│   ├─ _view_*.png              組裝／剖面／集煙罩剖面／列印排版
│   └─ STEP/（⚠️ 需重匯）+ STEP.zip
│
├─ CAD自檢/
│   ├─ mech_params.py           ★機構唯一真相來源★
│   ├─ test_mech_design.py      L1 參數規則
│   ├─ test_integration.py      L1b 跨層規則
│   └─ verify_stl.py            L2 幾何檢查
│
└─ 簡報/                        構想書 v1/v2/v3、現場簡報、講稿、研究筆記
```

### 17.1 git 狀態提醒（2026-08-16 13:09 時點）

未提交的修改：`cloud_dash/*.json`（DS18B20 面板）、`簡報/*_v3.pptx`、`簡報/現場簡報_3分鐘.pptx`、`簡報/計畫書優化研究筆記.md`、`電路設計/kicad/`（erc 報告、svg、netlist）。
未追蹤：`簡報/FGC工程筆記精讀.md`。
接手後建議先 `git status` 確認並提交，再開始工作。

---

## 18. 接手第一天怎麼做

### 步驟 1：讀（約 40 分鐘）

順序：
1. **本檔**（你正在讀）
2. `CLAUDE.md` —— 工作規則與紅線，★每次工作前都要看★
3. `專案進度.md` —— 跨會話進度存檔
4. `交接任務_筆電接手.md` —— 最近一次接手的現況
5. `待辦_DS18B20部署.md` —— 最近的未完成工作

### 步驟 2：跑（不需要任何硬體）

```bash
git clone https://github.com/feihong9487/WRO2026.git
cd WRO2026

python3 run_tests.py                       # 機構全部規則
python3 R4/matrix_mini_r4/驗證韌體.py       # 韌體靜態檢查
python3 PI5/驗證資料流.py                   # 欄位契約
cd 電路設計/kicad && python3 產生電路圖.py && python3 驗證電路圖.py && cd ../..
python3 -c "import sys; sys.path.insert(0,'CAD自檢'); import mech_params as P; print(P.unmeasured_items())"
```

有 OpenSCAD 的話再跑：
```bash
python3 外觀CAD/驗證CAD.py                  # A–M 全套，約 2 分鐘
```

全綠＝你的環境對了，可以開始改東西。

### 步驟 3：看

- 開 `電路設計/kicad/電路圖.pdf` 與 `電路設計/接線圖.html`
- 開 `外觀CAD/設計說明.html` 與 `外觀CAD/_view_組裝.png`
- 開公開儀表板連結（§6.2），確認雲端是否在跑（★取決於家裡桌機有沒有開★）

### 步驟 4：確認三件需要人拍板／人動手的事

1. **PCF8574 存廢**（§15.1）—— 拍板前不要採購
2. **感測器接線**（§15.1）—— 需要 Grove 轉杜邦轉接線
3. **外部訪談 ≥3 人**（§15.4）—— 評分硬性要求，只能人去做

### 步驟 5：動手前的檢查清單

- [ ] 我改的是**唯一真相來源**還是產生器的產物？（§9.6）
- [ ] 我有沒有先跑一次驗證看現況？
- [ ] 我要宣稱的東西是**實測**還是**設計目標**？（§11）
- [ ] 我有沒有碰到任何一條**紅線**？（§10.1）
- [ ] 這是不是一個**需要人決策**的取捨？如果是，用 §10.4 的格式回報，不要猜。

---

## 附錄 A：一分鐘講稿（定稿）

> 約 150 字，35–40 秒。口語提示：結論那句放慢講重；「燒香是信仰欸」用平常聊天的語氣；最後一句慢慢收。

先講結論：**我們讓香繼續燒，但煙不再害人。**

全球有二十二億人拜拜要燒香——佛教、道教、印度教都是。但香的煙就是 PM2.5，就是致癌物，而且每天都在廟裡累積。

這問題為什麼一直解決不了？因為以前的做法都在叫人少燒——減香、禁香、電子香。但燒香是信仰欸，怎麼禁都會讓信眾覺得被冒犯、心裡不舒服，所以每次都推不動。

我們反過來想：燒多少不是重點，重點是煙留在那裡多久。所以我們做了智慧香爐——濃度一高，風扇自己轉、自己過濾，過熱還會自動斷電。

香照燒，神明照拜，煙不見了。健康跟信仰，不用二選一。

**v2 建議稿的兩處改動**（未定稿，用哪版由使用者決定）：
- 第四段末加：「**而且這不是概念——原型已經實機上線，感測資料每一秒都進雲端面板。**」
- 收尾前加：「它是加裝在既有香爐上的模組，廟方不用換爐；買單的是被陳情、被稽查壓著的管委會。」

---

## 附錄 B：答詢口袋（Q&A 素材）

| 評審可能問 | 回答骨幹 |
|---|---|
| 你們遇過什麼挫折？ | **理香機構整組移除** —— 曾投入開發磁力理香，檢討後確認與信眾自由插香行為不相容而整組刪掉（§2.3） |
| 為什麼改設計？ | **集煙罩漏斗化** —— 原為上窄下寬縮口不好插香，改為漏斗大口＋下段直筒接風扇法蘭（§2.4） |
| 為什麼不用攝影機數人頭？ | 廟宇場域隱私敏感＋光線多變＋算力成本；一顆 CO₂ 感測器優雅得多，且人呼出的 CO₂ 比插香高峰**早數分鐘**上升 |
| 為什麼不用便宜的 MQ 系感測器？ | 半導體式會被酒精與煙氣嚴重干擾，在香煙環境形同失明；NDIR 量的是 CO₂ 分子真實紅外吸收，穩定不中毒 |
| 為什麼把最重要的安全交給最弱的板子？ | 正因為它最簡單 —— 沒有 OS、沒有網路協定棧、沒有動態記憶體，當機面最小、行為最可預測。**安全工程的鐵律是「安全功能放在最不會壞的地方」** |
| 風扇為什麼放在濾網後面？ | 抽拉式扇葉只碰濾後乾淨空氣（推吹式會吃滿香灰油煙導致葉形改變、動平衡跑掉）。代價是濾箱必須氣密 |
| 為什麼金屬紗網一定在最前？ | 風扇抽香煙＝把未熄火星往濾網吸，**而 HEPA 是可燃物**。紗網是安全件 |
| 你們的數字有多可靠？ | 我們有制度化的 `*_MEASURED` 待實測清單，未實測的一律稱「設計目標」；模擬機資料明確標示。**主動揭露不確定性比假裝精確可信** |
| 系統壞了會怎樣？ | 逐級降級（§3.3）；最終狀態是「香爐回復傳統使用」—— 斷電＝不動＝香爐照常用 |
| 為什麼是現在？ | 環保陳情壓力、廟方公關需求、低成本感測器與邊緣算力成熟三者同時到位 |

---

## 附錄 C：本檔的維護方式

本檔是**彙整**，不是真相來源。維護原則：

1. **不要把本檔當成唯一參考** —— 每節都標了對應原始檔，細節以原始檔為準
2. 專案有重大變更時（架構、定位、拍板決策），更新本檔的 §1、§13、§15
3. 若彙整內容與原始檔衝突，**以原始檔為準**，並回頭修正本檔
4. 本檔應與 `專案進度.md` 保持一致 —— 後者是滾動更新的進度存檔，本檔是階段性的完整快照

**下次重新產生本檔時的來源清單**：
`CLAUDE.md`、`.claude/commands/verify.md`、`專案進度.md`、`交接任務_筆電接手.md`、`智慧香爐_硬體設計交接.md`、`P0接線與驗證指南.md`、`部署紀錄.md`、`待辦_DS18B20部署.md`、`電路設計/README.md`、`電路設計/電氣驗證計算.md`、`電路設計/kicad/網表.md`、`外觀CAD/檔案結構與匯出.md`、`外觀CAD/params.scad`、`CAD自檢/mech_params.py`、`PI5/pi_fsm.py`、`簡報/一分鐘講稿.md`、`簡報/計畫書優化研究筆記.md`、`簡報/FGC工程筆記精讀.md`、`裝公鑰指令.txt`、`git log`

---

_本文件由 Claude（Cowork）於 2026-08-16 依 repo 全部文件與 git 歷史彙整產出。_
_★所有標示為估計值、臨時值、未實測的項目，在對外任何場合都只能稱「設計目標」。★_
