feihong9487/WRO2026/電路設計/kicad/網表.md

# 智慧香爐 P0 — 網表（由 incense_p0.kicad_sch 反推）

本檔由 `輸出網表.py` 自動產生（兩板合併架構），用途是與接線表交叉核對。
**若兩邊對不上，代表電路圖或接線表其中一份錯了。**

元件 12 個、網路 20 條。

## 元件清單

| 參考編號 | 品名 |
|---|---|
| `A1` | MATRIX Mini R4 控制器 |
| `A2` | Raspberry Pi 5 決策層 |
| `J1` | K型熱電偶 |
| `J2` | 12V 3A 變壓器 |
| `LED1` | 罩內 LED 側光 12V |
| `M1` | 5015 渦輪風扇 12V 0.2A |
| `M2` | 超音波霧化模組 12V（冷霧，無明火） |
| `U2` | SCD41 CO2 (0x62) - I2C1 埠 |
| `U3` | GY-SHT31-D (0x44) - I2C2 埠 |
| `U5` | MAX6675 熱電偶介面 |
| `U6` | D4184 MOSFET 模組 |
| `U7` | I2C 8路 MOSFET 驅動板 |

## 網路連線

| 網路 | 連接點數 | 連到哪些腳位 |
|---|---|---|
| **GND** | 11 | `A1` GND(pin 2)、`A2` GND(pin 1)、`J2` 0V(pin 2)、`LED1` GND(pin 2)、`M2` GND(pin 2)、`U2` GND(pin 2)、`U3` GND(pin 2)、`U5` GND(pin 2)、`U6` 訊號 GND(pin 2)、`U6` VIN-(pin 4)、`U7` GND(pin 2) |
| **+5V** | 5 | `A1` 5V OUT(pin 7)、`U2` VDD 5V(pin 1)、`U3` VIN 5V(pin 1)、`U5` VCC 5V(pin 1)、`U7` VCC 5V(pin 1) |
| **+12V** | 4 | `A1` VIN 6-24V(pin 1)、`J2` +12V(pin 1)、`U6` VIN+(pin 3)、`U7` VIN+ 12V(pin 5) |
| **FAN_N** | 2 | `M1` 黑線 -(pin 2)、`U6` OUT-(pin 6) |
| **FAN_P** | 2 | `M1` 紅線 +(pin 1)、`U6` OUT+(pin 5) |
| **FAN_PWM** | 2 | `A1` D1L p3 PWM(pin 11)、`U6` TRIG (PWM)(pin 1) |
| **HOODLED** | 2 | `LED1` HOODLED(pin 1)、`U7` OUT6 罩內LED(pin 7) |
| **I2C1_SCL** | 2 | `A1` I2C1 SCL(pin 4)、`U2` SCL(pin 4) |
| **I2C1_SDA** | 2 | `A1` I2C1 SDA(pin 3)、`U2` SDA(pin 3) |
| **I2C2_SCL** | 2 | `A1` I2C2 SCL(pin 6)、`U3` SCL(pin 4) |
| **I2C2_SDA** | 2 | `A1` I2C2 SDA(pin 5)、`U3` SDA(pin 3) |
| **I2C3_SCL** | 2 | `A1` I2C3 SCL(pin 14)、`U7` SCL(pin 4) |
| **I2C3_SDA** | 2 | `A1` I2C3 SDA(pin 13)、`U7` SDA(pin 3) |
| **MIST** | 2 | `M2` MIST(pin 1)、`U7` OUT5 霧化(pin 6) |
| **TC_CS** | 2 | `A1` D1R p2 CS(pin 10)、`U5` CS(pin 4) |
| **TC_KN** | 2 | `J1` K-(pin 2)、`U5` K-(pin 7) |
| **TC_KP** | 2 | `J1` K+(pin 1)、`U5` K+(pin 6) |
| **TC_SCK** | 2 | `A1` D4L p13 SCK(pin 8)、`U5` SCK(pin 3) |
| **TC_SO** | 2 | `A1` D4R p10 SO(pin 9)、`U5` SO(pin 5) |
| **USB_PI_R4** | 2 | `A1` USB - Pi 5(pin 12)、`A2` USB - 控制器(pin 2) |

## 關鍵路徑核對

合併架構（兩板）的三條主幹，路徑必須完整無斷點：

```
感測  U2 SCD41 ──I2C1──┐
      U3 SHT31 ──I2C2──┤── A1 MATRIX Mini R4（感測＋安全＋致動）
                        │
決策  A2 Pi 5 ──USB 序列┘   感測上傳 ＋ FAN 指令走同一條

致動  A1 ──D4L p13/D4R p10/D1R p2──> U5 MAX6675 ──> J1 熱電偶
      A1 ──D1L p3 PWM──> U6 D4184 ──> M1 風扇（12V）

電源  J2 12V 2A ──┬──> A1 VIN（板子吃 6-24V）
                  └──> U6 VIN+（風扇動力）      共地自動成立
```

對照上表：`+12V` 應為 **3 點**（J2、A1、U6），這是「一顆電源餵兩者」的證據；
`I2C1_*` 與 `I2C2_*` 各 2 點——兩個 I2C 埠經 PCA9548A 多工器彼此獨立，不共匯流排。

> 原三板架構的 `ALARM` 網路已不存在：感測與安全同在一顆 MCU，
> 不需要跨板警報線，連帶取消 3.3V→5V 電平轉換與 10k 下拉電阻。
