feihong9487/WRO2026/簡報/Manus包_三張A1海報/圖表_待補/放這裡.md

# 待補圖檔放這裡

- [ ] 實機照片 ×3：控制盒內部／集煙罩＋爐盆／Grafana 螢幕
- [ ] 團隊照 ×1

拍攝建議：白底或乾淨背景、正面平視、光線均勻，解析度 ≥ 150 dpi＠原尺寸
（A1 上若佔 100 mm 寬，至少要 600 px 寬；建議直接用手機最高畫質拍，不要裁切過度）。

沒有這幾張，評分表的 Demonstration 15 分與 Team Spirit 15 分會直接失分。
