feihong9487/WRO2026/部署紀錄.md

# 部署紀錄：智慧香爐雲端中心站（Windows 11 ／ WSL2）

## 1. 部署基本資訊

- **部署日期**：2026-07-30
- **部署目錄**：`~/incense-cloud`（WSL2 Ubuntu 24.04 家目錄下，ext4，非 `/mnt/d`）
- **原始檔案來源**：`/mnt/d/WRO2026/cloud_dash/`（`D:\WRO2026\cloud_dash`，原名「雲端平台」，已依整理需求改名並與 PI5/R4/ESP32 分資料夾存放）
- **主機環境**：WSL2 Ubuntu 24.04.4 LTS，PID 1 = systemd（`/etc/wsl.conf` 已啟用 systemd，或原生已啟用）
- **Docker Engine**：29.6.2（WSL 內原生安裝，非 Docker Desktop）
- **Docker Compose**：v5.3.1（plugin 形式）

### 各服務版本

| 服務 | 映像檔 |
|---|---|
| mosquitto | eclipse-mosquitto:2 |
| InfluxDB | influxdb:2.7（實際 v2.7.12） |
| Telegraf | telegraf:1.30（實際 1.30.3） |
| Grafana | grafana/grafana-oss:11.2.0 |

容器皆設定 `restart: unless-stopped`，WSL 開機後 systemd 帶起 docker 即自動復活。

### D:\WRO2026 資料夾結構（2026-07-30 整理）

```
D:\WRO2026\
├─ cloud_dash\          雲端中心站（本次部署來源；原名「雲端平台」）
│   cloud-docker-compose.yml / cloud-mosquitto.conf / cloud-telegraf.conf
│   grafana_dashboard_fleet.json / sim_burner.py / 多爐平台指南.md
├─ PI5\                 跑在 Raspberry Pi 5 上的程式與 Pi 本機監測層
│   pi_fsm.py / incense-fsm.service / provision.sh
│   docker-compose.yml / telegraf.conf / grafana_dashboard_incense.json（Pi 本機 Grafana，與雲端層互補、非取代）
│   雲端監測平台指南.md
├─ R4\                  Arduino UNO R4 Minima 韌體
│   r4_actuator_node.ino
├─ ESP32\               ESP32-S3 感測層韌體
│   s3_sensor_node.ino
├─ 電路設計\            通電前的接線圖與電氣驗證（2026-07-31 新增）
│   接線圖.html / 電氣驗證計算.md / README.md
│   wokwi_R4安全層\ · wokwi_S3感測層\（免硬體的邏輯模擬）
├─ P0接線與驗證指南.md   跨三板通用文件
├─ 任務書_雲端中心站部署.md
└─ 部署紀錄.md（本檔）
```

> 註（2026-08-07）：上列為部署當時的快照。兩板架構定案後，
> `R4/r4_actuator_node/`、`ESP32/`、兩個 wokwi 模擬資料夾已刪除
> （git 歷史可取回）；現況以《專案進度.md》§1 為準。

---

## 2. 存取方式一覽

| 用途 | 網址 |
|---|---|
| 本機瀏覽器（Windows） | `http://localhost:3000`（Grafana） |
| Tailscale 內網（手機、其他裝置、之後真爐） | `http://100.73.36.75:3000` |
| 公開 HTTPS（Tailscale Funnel，免裝 Tailscale 也能看） | `https://desktop-c8l8ri6-1.tail7920c6.ts.net` |
| **公開唯讀連結・總覽**（免帳密，兩爐所有指標一次看） | `https://desktop-c8l8ri6-1.tail7920c6.ts.net/public-dashboards/cc49db3ec819404e84744cfd416cb043` |
| **公開唯讀連結・aroma01 詳細面板**（免帳密） | `https://desktop-c8l8ri6-1.tail7920c6.ts.net/public-dashboards/cc9acc908b144cc98e9563b09e089e34` |
| **公開唯讀連結・aroma02 詳細面板**（免帳密） | `https://desktop-c8l8ri6-1.tail7920c6.ts.net/public-dashboards/99d887ecab2641e0b0ebbc47a6f9f273` |
| **公開唯讀連結・AI 狀態**（免帳密；2026-08-20 開通，16 面板經公開 API 逐一驗證有資料） | `https://desktop-c8l8ri6-1.tail7920c6.ts.net/public-dashboards/4a7a97d7f34d4b70831f4e6f10fc8fde` |
| InfluxDB API | `http://localhost:8086`（內網走 Tailscale IP + `:8086`） |
| MQTT broker | `localhost:1883`（內網走 Tailscale IP + `:1883`） |

**Tailscale 資訊**：
- 本機 Tailscale IP：`100.73.36.75`
- Tailnet：`feihong9487.github`
- Funnel 狀態：已啟用，代理 `/ -> http://127.0.0.1:3000`

---

## 3. 帳號清單（僅列帳號名，密碼由使用者保管，不記錄明文）

| 系統 | 帳號 | 密碼 |
|---|---|---|
| Grafana 管理員 | `admin` | 由使用者保管 |
| MQTT 橋接帳號（爐子用） | `burner` | 由使用者保管 |
| MQTT Telegraf 帳號 | `telegraf` | 由使用者保管 |

InfluxDB 資料來源（Grafana 內）：`InfluxDB-incense`，org=`incense`，bucket=`incense`（使用本地固定 token，非帳密登入）。

Grafana 儀表板：`incense-fleet`（顯示標題「智慧香爐監測平台」）。

**公開分享（Public Dashboard）**：共開了 3 個公開連結，皆唯讀、免登入，不涵蓋其他 Grafana 功能／資料源。連結見上方「存取方式一覽」表格。

- **總覽**（`incense-fleet`，dashboardId=1）：所有面板皆已改為「不依賴 `$device` 變數、依 `device` tag 分組」的查詢，同時顯示 aroma01／aroma02 兩爐所有指標。
- **aroma01 / aroma02 詳細面板**（`incense-aroma01-public`／`incense-aroma02-public`，dashboardId=2/3）：由總覽儀表板複製、把 `$device` 寫死成固定爐號的單爐詳細版。

  面板內容（三份連結一致，總覽版每格多顯示兩爐）：總覽狀態、總覽 CO₂、CO₂ 濃度、爐面溫度、S3 警報線、安全聯鎖、風扇 duty（實際）、R4 模式、CO₂ 濃度時序、CO₂ 斜率、溫濕度（雙感測交叉驗證）、爐面溫度時序、風扇 duty（指令 vs 實際）、狀態機時間軸、事件／動作紀錄（最近 20 筆）。曲線圖例已改為繁體中文顯示（如「CO₂ 濃度」「SCD 溫度」）。已依使用者要求移除「目前狀態」單一卡片、拿掉「艦隊」用詞。

  > **已知限制與處理方式**（記錄供日後參考）：
  > 1. **模板變數不生效**——Grafana Public Dashboard 不會代入 `$device` 這類模板變數，直接用會查詢失敗（Flux 報 `undefined identifier device`）。解法：查詢改用 `|> group(columns:["device"])` 依 tag 分組取代變數篩選（總覽），或把變數值直接寫死進 Flux 字串（單爐詳細版）。
  > 2. **文字型欄位在 stat 卡片上顯示不出來**——`state`、`r4_mode` 這類文字欄位，即使資料查詢完全正確，Public Dashboard 的 stat 卡片還是顯示 No data；同一批資料換成 `state-timeline` 或 `table` 面板類型卻能正常顯示。解法：在 Flux 查詢裡用 `map()` 把文字值轉成數字（例如 S0~S3 → 0~3、PI/FALLBACK → 1/0），再搭配數字鍵的 value mapping 顯示文字，繞過此限制；`action`（事件紀錄）欄位則改用 table 面板直接顯示文字，不受此限制影響。
  >
  > **事件／動作紀錄面板目前是空的是正常現象**：`r4_mode`、`action` 這兩個欄位模擬爐（`sim_burner.py`）固定回傳 `PI`／空字串，不會有事件產生；接上真爐（`pi_fsm.py`）後才會在狀態切換、感測失聯（`SENSOR_STALE`）、序列埠錯誤（`SERIAL_ERR`）等情況寫入紀錄。
  >
  > 三份儀表板 JSON（已修復版，含以上所有調整）**正本存放於 `D:\WRO2026\cloud_dash\`**：`grafana_dashboard_fleet.json`、`dashboard_aroma01_public.json`、`dashboard_aroma02_public.json`；WSL 部署目錄 `~/incense-cloud/` 內是同內容的工作副本。**日後在 Grafana 改了面板，記得把 JSON 匯出並存回 `cloud_dash/`**，否則 WSL 重灌就會遺失。新增爐號時用文字取代爐號字串，再 import＋開 public-dashboard 即可比照複製。

- 停用方式：Grafana 內以 `admin` 登入 → 對應儀表板 Share → Public dashboard → 關閉 Enable，該連結即失效。
- 這些連結等同於「免密碼的檢視權杖」，請只提供給預期對象（廟方、公告用途），若外流需重新產生（刪除後重建 public dashboard 設定）。

---

## 4. 真爐銜接參數

之後在真爐 Raspberry Pi 上執行 `provision.sh` 時：

```
CLOUD_MQTT=100.73.36.75
MQTT_USER=burner
MQTT_PASSWORD=<向管理者索取，即上表 burner 密碼>
```

且該 Pi 也需要安裝並 `tailscale up` 加入**同一個 tailnet**（`feihong9487.github`），才能透過 100.x 位址連上雲端中心站。完成後 Grafana 下拉選單會自動出現真爐的爐號。

---

## 5. 日常開關機 SOP

1. Windows 電腦開機／喚醒後，開一次 **Ubuntu** 應用程式視窗（不用手動下指令，讓 WSL 完成開機即可）。
2. systemd 會自動帶起 Docker 與 Tailscale；容器因 `restart: unless-stopped` 設定會自動復活。
3. 確認容器狀態：
   ```bash
   cd ~/incense-cloud && sudo docker compose ps
   ```
   應看到 mosquitto／influxdb／telegraf／grafana 四個容器皆 `running`。
4. 若需要展示模擬爐資料，需手動重跑（見下節），因為 nohup 背景程序不會隨開機自動恢復。
5. 筆電展示或長時間掛機期間，**Windows 電源設定改為「不睡眠」**，否則容器與 Tailscale 全部暫停。

---

## 6. 模擬爐管理

啟動（範例，帳密請自行代入）：
```bash
cd ~/incense-cloud
nohup python3 sim_burner.py aroma01 --host localhost --user burner --password '<burner密碼>' > /tmp/sim_aroma01.log 2>&1 &
nohup python3 sim_burner.py aroma02 --host localhost --user burner --password '<burner密碼>' > /tmp/sim_aroma02.log 2>&1 &
```

停止：
```bash
pkill -f sim_burner
```

> **重要提醒**：`aroma01`／`aroma02` 為模擬香爐，非實體硬體資料。**任何展示、報告、簡報中都必須明確標示為「模擬機」**，避免與之後真爐資料混淆。

---

## 7. 已知環境陷阱（沿用任務書 §11，供日後排查）

- 面板全空白 → 先查右上時間範圍是否為近 30 分鐘，再查 `sudo docker compose logs telegraf --tail 20`（通常是 telegraf 密碼未改對）。
- mosquitto 起不來 → 檢查 `passwd` 檔是否存在、conf 檔名是否對上 compose 掛載路徑。
- 手機／其他裝置連不上 → 這是 WSL NAT 預期行為，一律走 Tailscale，不要改 Windows 防火牆或 portproxy。
- Windows 睡眠 → 容器與 Tailscale 全部暫停，喚醒後通常自動恢復；長時間掛機請設定不睡眠。

---

## 8. 驗收總表（最終結果）

| 編號 | 內容 | 結果 |
|---|---|---|
| C1 | WSL2 Ubuntu、PID 1 = systemd | 通過 |
| C2 | 必要檔案齊全（實際位於 `cloud_dash/` 子目錄，原名「雲端平台」） | 通過 |
| C3 | Docker Engine 與 compose 可用 | 通過 |
| C4 | 四容器 running、InfluxDB health pass | 通過 |
| C5 | MQTT 帳號建立且認證生效 | 通過 |
| C6 | Telegraf 無認證／連線錯誤 | 通過 |
| C7 | Grafana 密碼更換、資料來源建立 | 通過 |
| C8 | 儀表板 incense-fleet 匯入成功 | 通過 |
| C9 | InfluxDB 查得到兩台模擬爐資料 | 通過 |
| C10 | 使用者確認瀏覽器面板正常 | 通過 |
| C11 | Tailscale IP 取得（含手機驗證、Funnel 選配） | 通過 |
| C12 | 部署紀錄.md 產出且無密碼明文 | 通過（本文件） |

**部署狀態：全部驗收項目通過，雲端中心站可投入使用。**

---

## 附錄：真爐節點佈建與 aroma01 切換（2026-08-08）

Raspberry Pi 5 16GB（Debian 13 trixie）佈建為第一台真爐節點。
先以代號 `aroma03` 佈建驗證，同日依使用者決定改名為 **`aroma01`**，
並停掉 aroma01 模擬器、清除 aroma03 痕跡：

| 項目 | 值 |
|---|---|
| 裝置代號 | `aroma01`（真實資料；模擬器已停） |
| 主機名 / Tailscale | `incense-aroma01`（100.113.207.110，Tailscale SSH） |
| 程式進駐 | `/opt/incense/pi_fsm.py`＋`incense-fsm.service`（開機自啟） |
| MQTT 橋接 | Pi 本機 mosquitto → 雲端 100.73.36.75:1883，帳號 `burner`（密碼由使用者保管；Pi 端存於 `/etc/mosquitto/conf.d/bridge.conf`，chmod 600） |
| 主題改寫 | `incense/#` → `incense/aroma01/#`（QoS1、cleansession false、離線佇列 100k） |
| R4 | UNO R4 WiFi 經 USB 接 Pi（`/dev/ttyACM0`），每秒 telemetry |

驗收：

| # | 項目 | 結果 |
|---|---|---|
| P1 | Tailscale SSH 進入（ACL 改 accept） | 通過 |
| P2 | mosquitto＋python3-serial＋paho-mqtt 安裝 | 通過 |
| P3 | provision.sh 六步驟完成 | 通過 |
| P4 | 橋接連上雲端並認證成功 | 通過 |
| P5 | 端到端實測：Pi 發布 → 雲端收到且主題改寫正確 | 通過 |
| P6 | R4 接上後真實 telemetry 流入雲端（每秒一筆） | 通過（感測器未接線，t/rh 為 -99.9 誠實故障值） |
| P7 | aroma01 模擬器停止（aroma02 模擬器保留） | 通過 |
| P8 | aroma03 清除：InfluxDB 6,587 筆刪除歸零＋MQTT 帳號刪除 | 通過 |

**★資料誠實邊界★**：InfluxDB 中 `aroma01` 在 **2026-08-08 01:15（台北）之前**
的歷史是模擬器資料（2026-07-30 起），之後為真實 Pi5＋R4 實測。
引用 aroma01 歷史區間的任何報告都必須註明這個切換點。

待辦：接上 SCD41/SHT31/MAX6675 讓 `sensor_fault` 歸零；人工確認 Grafana
面板的 aroma01 顯示正常（自動檢查看不到畫面）。

---

## 附錄：SD 卡故障與 NVMe 遷移＋單機監測棧（2026-08-09〜10）

**起因**：Pi5 曾發生「Reset due to low power event」低壓重置，SD 卡
（mmcblk0p2）ext4 目錄索引損壞（inode #152347，`/usr/lib/python3/dist-packages`
整目錄不可讀，全機 Python 癱瘓）。強制 `e2fsck -f -y` 回報無誤但 kernel
讀取仍間歇性 checksum 失敗——**讀取層級不穩定，卡體退化，已除役**。

**遷移方式**：未採整碟複製（NVMe 上已有健康系統，且會抄入損壞），改為
**角色移植**：保留 NVMe 既有系統（主機名 `feihongPi5`，Pironman 5 機殼、
WD_BLACK SN750 SE 500GB，PCIe gen2 x1），從唯讀掛載的 SD 搬入
`/opt/incense/`、`/etc/incense/device.conf`、mosquitto 橋接與佇列設定、
`incense-fsm.service`。`pi_fsm.py` 與 repo 正本 md5 相符。

| 項目 | 值 |
|---|---|
| 開機媒體 | NVMe（EEPROM `BOOT_ORDER=0xf416`，NVMe 優先；SD 卡可拔除） |
| PCIe | `dtparam=pciex1`（外接埠預設關閉，必須手動加；漏加症狀=link down） |
| 單機監測棧 | `/opt/incense/docker-compose.yml`：InfluxDB(主機埠 **8087**，8086 被既有原生 influxd 佔用)＋Telegraf＋Grafana(3000) |
| 本地 mosquitto | 僅綁 localhost＋172.17.0.1（docker 橋),**不對區網開放** |
| Grafana | `admin`（密碼由使用者保管）；datasource uid `incense-influx`；儀表板 `/d/incense-main` |
| 看門狗 | `usb-watchdog.timer` 每 30s 檢查 `/dev/ttyACM0`，消失即 `uhubctl -l 3 -p 1 -a cycle` |
| 雲端橋接 | bridge.conf 原樣保留(QoS1 佇列),**Tailscale 尚未重新認證**——回家後 `tailscale up --hostname incense-aroma01` 即恢復上雲補傳 |

**比賽現場模式**：斷電重開全自動就緒（實測通過:NVMe 開機→服務→容器→
資料入庫，無人工介入）；無外網時本地儀表板照常，橋接佇列待網補傳。

**R4 USB 韌性事項**：
- Pi5 的 `uhubctl` 埠「斷電」實際上不切 VBUS（R4 uptime 不歸零），只做
  重新協商——可救 CDC 軟卡死，救不了完全消失。
- 曾發生 Pi 溫重開後 R4 完全不列舉，xhci rebind 也無效，最後靠人工重插
  USB 線解決。**賽前必驗 USB 線材接觸可靠性**；冷開機（兩者同斷電）是
  乾淨情境，實測列舉正常。

**驗收（2026-08-10）**：

| # | 項目 | 結果 |
|---|---|---|
| N1 | NVMe 優先開機、SD 不依賴 | 通過 |
| N2 | 斷電重開全自動就緒（服務＋容器＋資料流） | 通過（唯 R4 需看門狗/重插，見上） |
| N3 | 本地端到端:R4→pi_fsm→mosquitto→Telegraf→InfluxDB→Grafana 查詢 API 回資料 | 通過 |
| N4 | 電源:本輪 `throttled=0x0` | 通過（供電規格仍待使用者確認,建議官方 27W） |
| N5 | Grafana 面板目視確認 | 通過(2026-08-10 使用者確認看得到資料) |
| N6 | Tailscale 重新認證、雲端補傳驗證 | 通過(2026-08-10;新節點 IP 100.88.179.95,積壓 3.5 萬筆補傳成功。注意:補傳資料的 InfluxDB 時間戳為**到達時間**非量測時間,雲端圖上呈現為補傳瞬間的密集帶) |

**★誠實邊界★**:aroma01 實測資料在 InfluxDB 有兩處:雲端(2026-08-08
01:15 起,至 08-09 Pi 斷線為止)與 Pi 本地新棧(2026-08-10 起)。兩者
中間有斷層(SD 故障停擺期),引用連續區間時必須註明。

---

## 附錄:比賽現場模式演練(2026-08-10)

**情境**:Pi 連 iPhone 熱點(SSID「我叫小phone今年9歲」,注意是數字 9),
經 Tailscale(DERP hkg 中繼)上雲。**實測通過**:雲端 InfluxDB 15 秒收到
126 筆 sensor 資料,公開 Funnel 儀表板照常。

- 熱點設定檔 `hotspot-phone` 已進 NetworkManager,autoconnect priority -10
  (在家讓位給家用 WiFi,現場自動連熱點)
- 看門狗升級 v2(`usb-watchdog.timer` 每 60s):除裝置消失外,**加測
  incense/sensor 15 秒無訊息的 CDC 軟卡死**(裝置在、資料停),自動重置埠＋重啟 FSM
  ——此模式 24h 內發生兩次,uhubctl 軟重置可救;USB 線材列為頭號嫌疑,賽前更換

**比賽日檢查表**:
1. 家裡 PC:開機、停用睡眠、WSL 起、四容器跑、Tailscale 在線(雲端展示的單點依賴)
2. 手機:熱點開啟並保持喚醒(iPhone 熱點閒置數分鐘會休眠);手機 Tailscale App 連線(備援看板用)
3. 現場:Pi 上電即自動連熱點→上雲,無需任何操作
4. 評審看雲端:公開 Funnel 連結,任何裝置免安裝可開
5. 備援(家裡 PC 失聯時):手機開 `http://100.88.179.95:3000`(Pi 本地 Grafana,經 tailnet),誠實標示為本地版
6. 帶官方 27W 電源、備用 USB 線

---

## 附錄:冷開機測試與 R4 電源行為(2026-08-10)

**冷開機實測**(整組拔插頭,模擬比賽現場):NVMe 開機、mosquitto(已加
After=docker 順序修正)、三容器、塔扇全速曲線、hotspot 優先巡檢——全自動就緒。
**唯一手動步驟:R4 要按一下電源鍵。**

**★關鍵發現★:MATRIX Mini R4 斷電後不會自動開機**,必須手動按電源鍵。
先前多次「R4 從 USB 消失」(Pi 溫重開後、冷開機後)全是此因——USB 供電
瞬斷讓 R4 關機待命,不是線材或卡死。看門狗救不了這個(按鍵無法軟體代按)。

**比賽現場上電 SOP(最終版)**:插電 → 等約 90 秒 → **按 R4 電源鍵** → 完成。
其餘全自動。「裝置在但資料停」的 CDC 軟卡死另計,看門狗 v2(查資料流)
會在一分鐘內自動復原。

其他本日落地:udev 固定名 `/dev/r4`(pi_fsm 與看門狗改用,ACM0/1 跳號免疫)、
塔扇 35°C 滿轉曲線、GPIO 側風扇 Always On、熱點無條件最優先(每 60s 巡檢跳槽)。

---

## 附錄:AI 線上學習服務上線(2026-08-20,桌機 Claude Code 執行)

依《任務書_桌機AI服務部署.md》在雲端中心站(桌機 WSL `~/incense-cloud/`)
啟動第五個容器 `ai-online`,兩個 AI 常駐自我學習。

**部署**
- compose 以**追加不覆蓋**方式加入 `ai-online` 服務段落與 `ai-models` volume;
  備份 `docker-compose.yml.bak-0820`。
- 額外加 `PYTHONUNBUFFERED=1`:官方 alpine 非 TTY 會緩衝 stdout,不加則
  `docker logs` 長時間空白(資料其實有寫)。★建議回寫 repo 的
  `cloud-docker-compose.yml`★。

**首輪重訓(v2)**
- AI-1 負載預測:test MAE 8.388,優於前日同時刻基線 10.482 與常數基線 11.844,
  守門條款放行、模型版本遞增;用近 132h 實測。
- AI-2 異常偵測:24 時段統計,CO₂ 基線漂移 -76.94 ppm/day,score 8.08 flag=1
  (CO₂ 硬警報期間 safety_override≈1.0 為預期)。
- `ai_status` 已落 InfluxDB,21 欄位含 `svc_heartbeat`。

**Grafana 儀表板**
- 匯入 `grafana_dashboard_ai.json` → uid `incense-ai-status`
  「智慧香爐 AI 狀態 — 負載預測與異常偵測」,19 面板。
- ★任務書寫的 datasource uid `incense-influx` 是舊值;實際為
  **`dftmtpkivyadcb`**(name `InfluxDB-incense`)。匯入腳本改為先查 API 取真實
  uid,避免重演 08-18 的全 No data 故障。★
- 面板查詢實測回傳資料(HTTP 200 無 error);**畫面呈現待人目視確認**。

**未做/待確認**
- 公開連結(Share → Public dashboard)未開,待使用者決定。
- 面板逐一目視、H1–H3 之外的顯示正確性,依 CLAUDE.md §6 由人確認。
