feihong9487/WRO2026/導師評審_IEEE與商業視角.md

# 導師評審意見 — IEEE 嚴謹度與商業化視角（2026-08-16）

> 評審範圍：全 repo ＋《研究日誌_全期完整版》（20 週，D1–D33 決策、F1–F29 失敗紀錄）。
> 評審立場：把本案當成一篇要送 IEEE 級審查的工程研究＋一個要說服投資人的早期產品。
> 結論先行：**分析與紀律已達可發表水準的骨架；全案唯一的結構性弱點是「零實測」——
> 每一條核心主張目前都停在模型層。下一階段的每一小時都該花在量測上，而不是分析上。**

---

## 一、總體評估

這份工作在三個維度上超出competition-grade、接近 publication-track：

1. **自我否證的密度**。η(u)→η(u,N) 修正（F6）、BFS 梯度失效（F7）、同日推翻同日定案的罩口
   尺寸（F23）、「三項判準全數滿足」的自我糾錯（F28）——IEEE 審查最難造假的訊號正是
   這種「作者主動削弱自己」的紀錄，而本案有一整張表。
2. **主張與證據的對齊制度**。`*_MEASURED` 旗標、三條資料誠實邊界、附錄 C 假設清單、
   「設計目標 vs 實測」術語紀律——這是多數研究生論文都沒有的 claims discipline。
3. **決策可重建性**。25+ 條 ADR 各附被否決方案與代價，任何審查者都能重演判斷條件。

**但要誠實指出級距**：以 IEEE 期刊/會議的標準，本案目前是一篇**方法與設計論文的前半**。
Introduction、Related Work、Modeling、Design 四章可以直接成稿；**Results 章是空的**。
η、排放因子、煙羽幾何、側裙效能、風扇工作點——全部是 ⚠ 假設。這不是缺陷清單的
第 N 項，這是唯一重要的一項。

---

## 二、IEEE 嚴謹度逐項審查

### 2.1 問題界定與重要性 — 強

- 雙區暴露模型、三倍爐位對照（Hien 2022）作為技術路線的物理立足點、季風×儀式的
  時空耦合——問題章的論證鏈完整且量化。
- 建議補一句 threat-to-validity：近場 1,360 µg/m³ 為非同儕審查之單次量測，
  **報告應明示「所有設計計算僅以 97 µg/m³（同儕審查值）為基準，1,360 僅作動機性引用」**
  ——這一句能把最容易被攻擊的引用直接除役。

### 2.2 相關工作與新穎性 — 強

- 專利庫檢索＋四維定位表＋「元件已知、組合首見」的誠實邊界，寫法正確。
- 理香移除後，新穎性主張已正確收斂到「儀式場域點源前饋控制方法」。
  ⚠ **注意發表順序**：若有申請專利的打算，公開發表（含競賽報告上網）會構成先前技術。
  要嘛先提出申請（台灣可用發明＋新型雙軌），要嘛有意識地選擇 defensive publication。
  這個決定要在送審**前**做，不能事後補。

### 2.3 建模方法 — 良，兩處可補強

- 三層公式（特徵化／KPI／預測）的分層動機清楚；蒙地卡羅證明歸一化必要性（F4→D8）
  是報告最好的方法學段落之一。
- **補強一：把單參數敏感度升級為聯合不確定性傳播。** F29 的教訓（裕度對橫流脆弱）
  是用 one-at-a-time 敏感度發現的；六項未實測參數其實可能**同時**偏移。建議在
  `flow_analysis.py` 上加一層簡單的蒙地卡羅：對六參數給分布（均勻或三角即可）、
  抽樣 10⁴ 次、輸出「罩口裕度 < 0 的機率」。一個下午的工作量，把「11% 裕度」
  從單點值變成風險機率，這是 IEEE 審稿人會要求的形式。
- **補強二：明確區分 verification 與 validation。** 目前的「交叉驗證通過」
  （源強 0.4% 差、η 80.0 vs 80.5）是**內部一致性檢查（verification）**——同一組
  假設用兩條路算，殊途同歸只證明沒算錯，不證明假設對。報告用語要區分，
  否則審稿人會抓。Validation 只能來自實驗。

### 2.4 實驗設計 — 有計畫、未執行；三個補強點

- ASHRAE 110 借用（D18）是聰明的方法論外部背書；配對 A/B＋源強歸一化＋
  最惡劣工況（N=1 × 橫流）的設計正確。
- **補強一：預註冊式的統計計畫。** 在做任何 η 實驗**之前**，白紙黑字寫下：
  假說、顯著水準、以先導變異數估算的重複次數、資料剔除規則。這份文件本身
  放進附錄，就是「量測不是為結果量身訂做」的最強證據（與 D18 同一精神）。
- **補強二：η 量測的感測器現實。** PM2.5 感測器（PMS5003）尚未到貨；但 SCD41 在手,
  而 ASHRAE 110 本來就是**示蹤氣體法**——用受控 CO₂ 源（呼氣袋/發酵瓶/小型鋼瓶）
  做捕集率量測，在化學上與方法上都成立，且第 20 週已量化證明微粒完全跟隨氣流
  （St ≈ 10⁻⁷），示蹤氣體外推到 PM2.5 有依據。**不必等 PMS5003 到貨才開始量 η。**
- **補強三：排放因子自量測的設計。** 文獻 7–200 mg/支不可用（已知）。最低成本方案：
  密閉箱＋質量法（精密秤量燃燒前後全香質量差）＋CO₂ 累積量交叉，一晚可做
  三種市售香各三重複。這是「自己的數據」的第一筆，性價比全清單最高。

### 2.5 可重現性 — 強（同儕少見）

- 全鏈自動驗證（L1/L1b/L2/電路/韌體/資料流）、產生器自檢、負面測試過的檢查腳本、
  開放資料承諾——這一節可以在報告裡獨立成段，它本身就是貢獻。
- 唯一缺口：`flow_analysis.py` 等分析腳本應與報告數字綁定（腳本輸出表格 = 報告表格，
  禁止手抄），否則 F27 類的抄錄錯誤還會發生。

### 2.6 報告完整性檢查（送審前硬性清單）

1. 書目補齊：化學軌 [10][12][13][16][17] 缺作者卷期 DOI（日誌 §5.3 已列）——
   **IEEE 格式審查第一輪就會退**。
2. IARC Vol. 109 逐字核對（「戶外空氣」限定詞）。
3. 「捕集 vs 循環併用」表更正 31.6→35.0（F25），全文任何引用處同步。
4. 單位風量效益比全文統一為 29 倍（放大罩口後的新值），不得殘留 37。
5. 頁數：方案 13 頁＋創新 7 頁超過 12＋6 上限——**超頁零分是行政死刑**，
   合併 3-3B 與 4-5B 的決定不能再拖。

---

## 三、技術風險排序（導師觀點）

| # | 風險 | 現況 | 導師建議 |
|---|---|---|---|
| 1 | **側裙效能（B8）**——全案押在「橫流可壓到 0.05 m/s」 | 未驗證，失效門檻 0.073 | **紙板/珍珠板 mockup 先行**：不要等 3D 列印。瓦楞紙照 D32 尺寸做罩＋側裙，發煙管＋手機慢動作量橫流衰減比，一個週末、成本 <200 元。若 3–10 倍衰減達不到，愈早知道愈好——這決定罩口 200/215 與整機外形 |
| 2 | 風扇 P–Q 曲線（B7） | 未實測 | 水柱壓差計 DIY（透明軟管＋尺）＋可變孔板，一晚量出 5–6 個工作點就夠定串/並聯 |
| 3 | 排放因子 29 倍跨度 | 未量測 | §2.4 補強三，一晚 |
| 4 | I²C 接線（B1）＋舊韌體（B3） | 卡 Grove 轉接線 | 這是純採購問題卻擋住所有真實資料——轉接線列為當週必辦 |
| 5 | h_min 訪談 | D31 後已非阻塞 | 併入利害關係人訪談（見商業節），一次出門收三樣 |

Mockup-first 是這一階段的核心方法論：**分析已經把「該量什麼」的優先序算出來了
（橫流＞擴張率＞源徑），接下來的正確姿勢是用最便宜的實體把這三個數字量出來，
而不是把模型再磨細一層。模型的邊際報酬已經耗盡了。**

---

## 四、商業化視角

### 4.1 已具備的投資級要素

- **可驗證性當賣點**：進出風口濃度差自證成效＋公開儀表板——B2B 空品市場的
  「裝了沒用」信任缺口，本案用架構解，這是真差異化。
- **單位風量效益比 29 倍**：這個數字計入了成本（風量≈電力≈噪音），比「捕集是
  循環的三倍」更接近投資人語言。放進 pitch 的第一排。
- **農曆維運節奏**：濾材訂閱綁初一十五——耗材商模與使用場域的文化週期天然耦合,
  這是外國競品進不來的 retention 設計，值得在商業章單獨講。
- **武德宮證據鏈**：「抗議減香政策的行動者自願花 500 萬買技術方案」——
  付費意願的實證，比任何問卷都硬。

### 4.2 缺口與建議

1. **單位經濟**（仍缺）：BOM→整機成本→定價→毛利→訂閱毛利一頁表。D26 之後
   風量降到 43 m³/h，風扇/濾材/電源全部可以降規——**成本結構應依新規格重算**，
   很可能比舊估計更好看，這是免費的好消息，別漏掉。
2. **訪談的商業轉化**：h_min 訪談既是工程參數也是評分硬要求（≥3 外部人士），
   建議升級成「先導廟宇 MOU」的預備動作——訪談對象選定一間有陳情壓力的中小廟,
   談的最後一題就是「若免費裝三個月、數據公開，願不願意」。把田野調查變成
   lighthouse customer 的第一步。
3. **法規/安規角色**：金屬紗網（火星前濾）不只是工程件——對廟方與保險公司,
   「加裝後火星不進濾箱」是可以寫進提案書的風險下降主張。消防背景的訪談對象
   可以順便驗證這個賣點。
4. **智財時序**（重複強調因為不可逆）：方法專利 vs 公開發表的先後，送審前定案。

### 4.3 敘事修正一則

Pitch 目前的「AI 智慧」比重可以再降。日誌第 14 週自己已經證明：**約束封頂之下,
演算法優化不出被物理封死的空間；本案的價值核心是「量對了物理、選對了拓撲」**
（點源捕集、抽拉式、串級時間尺度、前饋必要性）。對技術評審，「我們算出 AI 幫不了
的地方在哪」比「我們用了 AI」高一個段位——這個反直覺敘事是你們獨有的。

---

## 五、賽前四週行動計畫（依報酬率排序）

**第 1 週（解鎖真實資料）**：Grove 轉接線到貨→感測器接通→重燒新韌體→`-99.9` 變真值;
紙板 mockup 側裙橫流測試（風險 #1）；風扇 P–Q（風險 #2）。
**第 2 週（第一批自有數據）**：排放因子三香種×三重複；煙羽擴張率（定點攝影＋逐幀）;
N=1 最惡劣工況捕集目視測試；CO₂ 示蹤 η 預實驗（統計計畫先寫）。
**第 3 週（正式量測＋田野）**：燃燒艙 A/B η 配對量測；利害關係人訪談 ≥3
（廟方/信眾/消防或環工，含 h_min 與 MOU 探詢）。
**第 4 週（收斂與合規）**：實測值回寫 `mech_params.py`（`*_MEASURED=True` 由人確認）;
第 14/17/20 週分析用實測曲線重算；報告頁數合併；書目補齊；單位經濟表；彩排。

若四週只能做一件事：**做第 1 週。** 它解鎖其後所有事，且每一項都 <1 天工作量。

---

## 六、結語

這個專案目前的形狀是：**一流的分析紀律，站在零實測的地基上**。好消息是——
分析已經把實驗清單、優先序、最惡劣工況、量測方法全部準備好了，接下來的四週
不需要任何新的想法，只需要執行。把 F1–F29 那張表再延長十行實測記錄，
這份工作就從「精彩的設計研究」變成「完整的工程研究」。

（本評審之評分對照：日誌的出現使先前評分中 Research & Report 維度由 11/15 上修至
14/15 的潛力位——前提是訪談補齊與書目修復；Demo/Solution 維度的分數仍鎖在
實測完成度上，與本評審第五節同一結論。）
