feihong9487/WRO2026/後續研究與優化方向建議書.md

# 後續研究與優化方向建議書

> 2026-08-16。彙整自《研究日誌_全期完整版》§5 未決清單、《導師評審_IEEE與商業視角》、
> 二十週的 38 條決策（D1–D38）與 33 條失敗紀錄（F1–F33）。
>
> **使用方式**：本書按「報酬率 × 急迫度」分層——第一章是賽前四週該做的事（全部
> 可執行、不需新想法）；第二～八章是各領域的中長期方向（給賽後或有餘裕時）；
> 第九章是**需要人拍板的決策清單**（agent 不得代決）；第十章是紅線提醒。
> 每項盡量寫清楚：為什麼／怎麼做／成本／產出物。

---

## 第一章｜賽前衝刺：把「零實測」的地基補上（最高優先）

導師評審的核心結論：**一流的分析紀律，站在零實測的地基上**。分析已把「該量什麼、
先量什麼、怎麼量」全部準備好（§5.2 優先序 0–3 由敏感度分析直接導出），接下來
四週不需要任何新想法，只需要執行。**若只能做一件事，做第 1 週——它解鎖其後所有事。**

### 週 1｜解鎖真實資料（每項 < 1 天）

| 事項 | 對應卡點 | 做法 |
|---|---|---|
| Grove 2.0 mm 轉接線到貨 → SCD41 接通 | B1 | 純採購問題，卻擋住所有真實資料——列為當週必辦第一位 |
| 重燒新韌體（理香移除版） | B3 | 板上仍是舊韌體；燒錄前先跑 `驗證韌體.py` |
| SSH 公鑰裝進 Pi → 部署新 `pi_fsm.py` | B2 | `t_ds` 上儀表板；Grafana 兩份 JSON 匯入 |
| 紙板側裙 mockup 橫流測試 | **B8（全案最高風險）** | 瓦楞紙照 D32 尺寸做罩＋側裙，發煙管＋手機慢動作量側裙內外風速比。成本 < 200 元、一個週末。**若 3–10 倍衰減達不到，愈早知道愈好——這直接決定罩口 200/215 與整機外形** |
| 5015 鼓風機 P–Q 曲線 | B7 | 水柱壓差計 DIY（透明軟管＋尺）＋可變孔板，一晚量 5–6 個工作點，即可定串／並聯（B6） |

### 週 2｜第一批自有數據

- **線香排放因子自量測**（§5.2 第 6 項）：文獻 7–200 mg/支不可用。密閉箱＋精密秤
  質量法＋CO₂ 累積量交叉，三種市售香 × 三重複，一晚完成。**這是「自己的數據」的
  第一筆，性價比全清單最高，且本身就是可寫入報告的實驗。**
- **煙羽擴張率 db/dz**（優先序 2）：定點攝影＋逐幀分析。現取 0.14；若實際 0.18，
  罩口裕度從 +20.4 掉到 +1.6 mm——必須知道。
- **爐盆有效源徑 Dₛ**（優先序 3）：實際插香散佈範圍；自 70 放大到 90 mm 設計即失效。
- **CO₂ 示蹤 η 預實驗**：不必等 PMS5003。ASHRAE 110 本來就是示蹤氣體法，SCD41
  在手；受控 CO₂ 源（呼氣袋／發酵瓶）量捕集率，第 20 週已證明微粒完全跟隨氣流
  （St ≈ 10⁻⁷），示蹤外推到 PM2.5 有依據。**動手前先寫統計計畫（見第二章）。**

### 週 3｜正式量測＋田野

- 燃燒艙配對 A/B η 量測（源強歸一化、含 N=1 × 橫流最惡劣工況）。
- **利害關係人訪談 ≥ 3 人**（廟方／信眾／消防或環工）——WRO 明文要求，同時收
  h_min、煙升儀式意義、MOU 探詢三樣（見第六章）。

### 週 4｜收斂與合規

- 實測值回寫 `mech_params.py`（`*_MEASURED=True` **只能由人確認後改**）。
- 第 14／17／20 週分析用實測曲線重算；單位風量效益比全文統一為 29 倍。
- 報告頁數拍板與合併（第九章 D-1）；書目補齊（§5.3 全清單）；單位經濟表；彩排。

---

## 第二章｜建模與方法學升級（IEEE 級補強）

1. **單參數敏感度 → 聯合不確定性傳播。** F29 的教訓（裕度對橫流脆弱）是
   one-at-a-time 分析發現的，但六項未實測參數可能**同時**偏移。在 `flow_analysis.py`
   上加一層蒙地卡羅：六參數給分布（均勻或三角即可）、抽樣 10⁴ 次、輸出
   「罩口裕度 < 0 的機率」。一個下午的工作量，把「11% 裕度」從單點值變成風險
   機率——這是 IEEE 審稿人會要求的形式。
2. **區分 verification 與 validation。** 「交叉驗證通過」（源強 0.4% 差、η 80.0 vs
   80.5）是**內部一致性檢查**——同一組假設兩條路算，殊途同歸只證明沒算錯，不證明
   假設對。報告用語必須區分；validation 只能來自實驗。
3. **統計計畫預註冊。** 任何 η 實驗之前，白紙黑字寫下：假說、顯著水準、以先導
   變異數估算的重複次數、資料剔除規則，整份放附錄。這是「量測不是為結果量身訂做」
   的最強證據，與 D18（借用 ASHRAE 110）同一精神。
4. **腳本輸出與報告數字綁定。** 分析腳本直接輸出報告表格，禁止手抄——F27（抄錄
   錯誤）與 F25（31.6→35.0）這類問題的根治法。可在 `run_tests.py` 加一條
   「報告數字 = 腳本輸出」的一致性規則。
5. **1,360 µg/m³ 的引用降級聲明。** 報告明示：「所有設計計算僅以 97 µg/m³
   （同儕審查值）為基準，1,360 僅作動機性引用」——把最容易被攻擊的引用直接除役。

---

## 第三章｜機構研究方向

- **側裙迭代研究（承 B8 mockup 之後）**：若紙板實測衰減不足，候選路徑依序為
  （a）側裙加高／改角度、（b）罩口放大至 215（B9 的餘裕 +23%）、（c）加裝可拆
  擋風簾（文化上要過廟方這關，見第八章）。每一輪都先紙板再列印——**mockup-first
  是本階段核心方法論：模型的邊際報酬已經耗盡，最便宜的實體量測勝過再磨一層模型。**
- **濾材壽命實驗**：HEPA＋活性碳初期／壽末壓損（§5.2 第 5 項）→ 直接決定訂閱
  換濾週期（商業章的單位經濟輸入）。加速測試：以高源強連燒換算當量週數。
- **熱管理實測**：罩體與濾箱在連續高峰工況下的溫度分布（DS18B20 已上線可用）；
  驗證禁 PLA 區劃分與 PETG 耐溫假設。**這是 `*_MEASURED` 清單的大宗。**
- **可製造性收斂**：34° 自撐倒錐已驗證可印；下一步是列印件強度與耐久（跌落、
  長期熱循環）——人在迴路，無法自動驗證。
- **罩體幾何優化**（§5.2 第 7 項）：第 14 週已證明「約束封頂之下演算法優化不出
  空間」，幾何仍是效能第一槓桿；若實測 db/dz 偏大，優先動幾何而非控制。

## 第四章｜電控與韌體

- **規則式／PID 基線建置**（§5.2 第 8 項）：**無基線則無法宣稱前饋 FSM 有貢獻**，
  且無前置條件，應立即開始。產出「同工況下 FSM vs 定速 vs PID」的削峰對比——
  這張圖是答詢時「AI 到底幫了什麼」的標準答案。
- **風扇 PWM 頻率改 25 kHz**（預設 490 Hz 會嘯叫）；**S1 duty=70 疑低於無刷風扇
  最低啟動占空比**（常見 30–40% ≈ 77–102），實機驗證後調整。
- **MQTT 帳密缺口**：`pi_fsm.py` 與韌體目前都沒有帳密參數的位置——補上參數化
  設計（值由人保管，依規矩不寫進任何檔案）。
- **PCF8574 存廢（B4）**：理香移除後只剩 2 路負載，建議方案 B（2 顆 D4184 接
  Analog 1/2）；拍板前不採購。
- **轉速回授**：現行風扇無 tach 線。若換 4 線風扇可得轉速回授 → 風扇失效偵測
  從「電流推斷」升級為「直接量測」，安全論述更硬。屬採購決策（第九章）。
- **OTA 與機隊**：Pi 端已具雛形；下一步把「韌體版本」納入每秒 JSON 上報，
  儀表板可見全機隊版本分布——機隊營運敘事（3-12）的實證第一步。

## 第五章｜資料與雲端

- **公開資料集承諾的落地**：匿名化實驗資料＋分析程式碼打包（Zenodo 或 GitHub
  release, 附 DOI）——可重現性一節從「承諾」變「連結」。
- **aroma01 歷史資料分段標註**：InfluxDB 中 2026-08-08 01:15 之前是模擬資料——
  建議直接寫進 dashboard 的面板說明，杜絕未來任何人誤引（誠實一致性的工程化）。
- **異常偵測研究**：有了真實資料流之後，可做簡單的 drift 偵測（感測器老化、
  濾材飽和的資料特徵）——濾材訂閱「按狀態換」而非「按月換」的技術基礎。

## 第六章｜商業化方向

1. **單位經濟一頁表（最大缺口）**：BOM→整機成本→定價→毛利→訂閱毛利。D26 之後
   風量降到 43.3 m³/h，風扇／濾材／電源全可降規——**成本結構依新規格重算，
   很可能比舊估計更好看，這是免費的好消息。**
2. **訪談升級為 lighthouse MOU**：訪談對象選一間有陳情壓力的中小廟，最後一題就是
   「若免費裝三個月、數據公開，願不願意」。把田野調查變成第一個燈塔客戶的預備
   動作——「已發生的證據勝過任何承諾」。
3. **消防／安規賣點驗證**：金屬紗網（火星前濾）對廟方與保險公司是「風險下降」
   主張——找消防背景的訪談對象順便驗證這個賣點能不能寫進提案書。
4. **農曆維運節奏**：濾材訂閱綁初一十五——耗材商模與場域文化週期天然耦合，
   外國競品進不來的 retention 設計，值得在商業章獨立成段。
5. **敘事修正**：降低「AI 智慧」比重。第 14 週已自證「約束封頂之下，演算法優化
   不出被物理封死的空間」——對技術評審，「我們算出 AI 幫不了的地方在哪」比
   「我們用了 AI」高一個段位，這個反直覺敘事是本案獨有的。
6. **出海順序維持**：新加坡／馬來西亞（法規推力）→ 香港（付費意願已證實）→
   日本／泰越 → 印度（最大量級）→ 歐洲教堂乳香。每一步各需一次在地法規與
   文化適配研究。

## 第七章｜學術發表路徑

- 現況是「方法與設計論文的前半」：Introduction／Related Work／Modeling／Design
  四章可直接成稿，**Results 是空的**——第一章的量測做完即補齊。
- 候選投稿形式：室內空氣品質類期刊（如 Indoor Air、Building and Environment）
  或 IEEE Sensors／IoT 應用類會議；亦可先投國內科展／旺宏獎累積審查經驗。
- **與智財時序連動（不可逆，見第九章 D-5）**：公開發表（含競賽報告上網）構成
  先前技術——要嘛先提申請（台灣可發明＋新型雙軌），要嘛有意識選擇 defensive
  publication。**這個決定必須在送審前做。**

## 第八章｜文化與人因研究

- **h_min 訪談**（D31 後已非阻塞，但仍是唯一無法由物理決定的參數）：由廟方認定
  「煙升多高才算有到神明那裡」——同行程收三樣（h_min／儀式意義／MOU）。
- **煙升之儀式意義**：目前為推論非證據；訪談可升格為田野依據，同時支撐 D11
  「文化為硬約束」的論述。
- **插香人因**：漏斗大口（180 mm）的實際手感、不同身高使用者的插香軌跡——
  mockup 現成可測，順帶驗證 Dₛ（優先序 3）。
- **外觀與廟方觀感**：展示機的文化適切性只能由人（最好是廟方）評——安排在
  訪談同行程。

---

## 第九章｜需要人拍板的決策清單

依 CLAUDE.md §9，這些屬設計取捨／採購／不可逆決策，agent 不得代決：

| # | 決策 | 選項與代價 | 現有建議 |
|---|---|---|---|
| D-1 | **構想書頁數（超頁 0 分）** | 3-3B 併入 3-3、4-5B 併入 4-5 vs 維持現狀賭排版 | **建議合併**——行政死刑不可賭；v2/v3 結構相同，改動成本低 |
| D-2 | 罩口 200 vs 215 mm（B9） | 215：橫流餘裕 +23%＋ACGIH 合規；代價整機 +15 mm、阻力 +38 Pa、濾材壽命 −0.2× | 建議 215；**側裙 mockup 結果出來後再定更穩** |
| D-3 | 風扇串／並聯（B6） | 串聯得靜壓失冗餘；替代為單顆高靜壓鼓風機＋加大濾材面積 | 等 P–Q 實測（週 1）再拍板 |
| D-4 | PCF8574 存廢（B4） | 方案 B：2 顆 D4184 接 Analog 1/2 | 建議方案 B；拍板前不採購 |
| D-5 | **智財 vs 公開發表時序（不可逆）** | 先申請專利／defensive publication／放棄申請 | 送審**前**必須定案 |
| D-6 | 4 線風扇換裝 | 得轉速回授；代價重新選型＋接線 | 非阻塞，可賽後 |
| D-7 | 一分鐘講稿採用哪版 | 定稿（仍含「二十二億」舊宣稱）vs v2 建議稿（已改「超過十七億」＋traction 句） | **建議 v2**——定稿的 22 億無可靠出處，與其他交付物已不一致 |

## 第十章｜紅線提醒（依 CLAUDE.md §5.2／§6）

以下事項**沒有任何自動檢查可以取代人**，後續所有研究不得宣稱其「已驗證」，
除非人實際做過：

- 熱變形實測｜氣流與抽排效能｜電磁鐵吸力（已隨理香移除，僅存檔）｜插香手感
  與人因｜列印件強度耐久｜外觀與廟方觀感｜韌體實機燒錄行為
- `*_MEASURED` 旗標只有人量過才能改 True；`FILTER_CHAIN` 順序（紗網→HEPA→活性碳）
  不可調換；安全與可製造性下限不可放寬；禁 PLA 區不可規避。
- 所有基於未實測參數的數字，對外**只能稱「設計目標」**。

---

## 附錄｜本建議書與既有文件的對應

| 本書章節 | 主要出處 |
|---|---|
| 第一章 | 導師評審 §五（四週計畫）＋日誌 §5.1／§5.2 |
| 第二章 | 導師評審 §2.3–2.5 |
| 第三～五章 | 日誌 §5.2／§5.5、B1–B9、部署紀錄 |
| 第六章 | 導師評審 §四＋《計畫書優化研究筆記》六項驗收框架 |
| 第七章 | 導師評審 §2.2／§2.6 |
| 第八章 | 日誌 §5.4＋D11／D31 |
| 第九章 | 日誌 §5.1／§5.5 待拍板項全集 |
