feihong9487/WRO2026/任務書_雲端中心站部署.md

# 任務書：智慧香爐雲端中心站部署（Windows 11 ／ WSL2）

> **這份文件是寫給 Claude Code 的執行手冊。**
> 目標：在使用者每天使用的 Windows 11 電腦上，於 WSL2 Ubuntu 內部署「智慧香爐」雲端中心站
> （mosquitto ＋ InfluxDB ＋ Telegraf ＋ Grafana），完成 Grafana 設定與多爐儀表板匯入，
> 用模擬香爐點亮資料流，並建立 Tailscale 對外通道。
> 原始檔案位於 `D:\WRO2026`（WSL 內路徑：`/mnt/d/WRO2026`）。
>
> **（2026-07-31 補註）本任務書保留為原始委派紀錄，內文不修改。** 部署已完成，實際結果請看
> 《部署紀錄.md》。檔案位置與名稱後來有調整：原 `雲端平台\` 資料夾 → `cloud_dash\`，
> 其中《艦隊平台指南.md》→《多爐平台指南.md》；儀表板標題「智慧香爐艦隊監測平台」
> → 「智慧香爐監測平台」。下文提到舊名稱處，請對照此表。

---

## 0. 給 Claude Code 的總則

**執行環境**：所有指令都在 WSL2 Ubuntu 內執行。若你發現自己跑在 Windows 原生環境（PowerShell），請改以 `wsl -e bash -c "..."` 包裹指令，或請使用者改在 Ubuntu 內啟動你。

**參考文件優先序**：本任務書 ＞《艦隊平台指南.md》（§1 為背景脈絡）。兩者衝突時以本任務書為準——因為本任務書已針對 WSL 環境調整（部署目錄複製到家目錄、Tailscale 裝在 WSL 內）。

**護欄（必須遵守）**：
1. 所有密碼（MQTT 橋接、telegraf、Grafana 管理員）一律**開口問使用者**，不要自行生成後寫死；密碼不得寫入任何會被分享或版控的檔案，包含最終的部署紀錄。
2. 只操作 WSL 內部與 `/mnt/d/WRO2026`。**不修改 `D:\WRO2026` 內的原始檔案**；唯一允許新增的是最終的《部署紀錄.md》。
3. 每個 `sudo` 指令執行前，用一句話說明用途。
4. 任一驗收點失敗：停下、回報現象與你的診斷，等使用者指示，不要自行繞過或改設計。
5. 需要使用者操作的步驟（標示【需要使用者】）：明確告知該做什麼，等待完成確認後再繼續。

**回報格式**：每完成一個 Phase，輸出該階段驗收點（C 編號）的通過／失敗結果，再進入下一階段。全部完成後輸出 §10 總表。

---

## 1. Phase 0 — 使用者前置（【需要使用者】，Claude Code 不執行）

此階段應已完成，僅供核對：
- Windows 11 已安裝 WSL2 與 Ubuntu（系統管理員 PowerShell：`wsl --install -d Ubuntu` → 重開機 → 建立 Linux 帳號）。
- Claude Code 已安裝於 WSL 內並登入。
- `D:\WRO2026` 內已放置本任務書與所有專案檔案。

---

## 2. Phase 1 — 環境健檢

```bash
uname -a && cat /etc/os-release | head -2     # 確認是 WSL2 Ubuntu
ps -p 1 -o comm=                               # 必須輸出 systemd
ls /mnt/d/WRO2026
```

**必要檔案清單**（缺任一個 → 停下回報）：
- `cloud-docker-compose.yml`
- `cloud-mosquitto.conf`
- `cloud-telegraf.conf`
- `grafana_dashboard_fleet.json`
- `sim_burner.py`
- `艦隊平台指南.md`（參考用）

**若 PID 1 不是 systemd**：寫入設定後需要使用者重啟 WSL（你的會話會中斷）：
```bash
sudo tee /etc/wsl.conf >/dev/null <<'EOF'
[boot]
systemd=true
EOF
```
【需要使用者】在 Windows PowerShell 執行 `wsl --shutdown`，重開 Ubuntu，重新啟動 claude 並說「從任務書 Phase 2 繼續」。

> 驗收 **C1**：Ubuntu on WSL2 且 PID 1 = systemd。
> 驗收 **C2**：必要檔案全數存在。

---

## 3. Phase 2 — 安裝 Docker Engine（WSL 內，不用 Docker Desktop）

```bash
curl -fsSL https://get.docker.com | sh
sudo usermod -aG docker $USER
sudo systemctl enable --now docker
docker --version && docker compose version
```

注意：本次會話中群組尚未生效，後續 docker 指令一律加 `sudo`（重新登入後即可免 sudo，請在部署紀錄註明）。

> 驗收 **C3**：`docker --version` 與 `docker compose version` 正常輸出，docker 服務 active。

---

## 4. Phase 3 — 建立部署目錄並啟動服務

部署目錄放 WSL 家目錄（ext4），避開 `/mnt/d` 的權限與效能問題；`D:\WRO2026` 僅作為原始碼來源。

```bash
mkdir -p ~/incense-cloud && cd ~/incense-cloud
cp /mnt/d/WRO2026/cloud-docker-compose.yml ./docker-compose.yml
cp /mnt/d/WRO2026/cloud-mosquitto.conf ./cloud-mosquitto.conf
cp /mnt/d/WRO2026/cloud-telegraf.conf  ./cloud-telegraf.conf
cp /mnt/d/WRO2026/grafana_dashboard_fleet.json ./
cp /mnt/d/WRO2026/sim_burner.py ./
touch passwd                       # mosquitto 密碼檔，必須在 up 之前存在
sudo docker compose up -d
sleep 15 && sudo docker compose ps
curl -s http://localhost:8086/health
```

> 驗收 **C4**：mosquitto、influxdb、telegraf、grafana 四容器皆 running；InfluxDB health 回 `"status": "pass"`。

---

## 5. Phase 4 — 建立 MQTT 帳號並更新 Telegraf

【需要使用者】向使用者索取兩組密碼：**橋接帳號 burner**（之後真爐與模擬爐都用它）與 **telegraf 帳號**。

```bash
sudo docker compose exec mosquitto mosquitto_passwd -b /mosquitto/config/passwd burner   '<burner密碼>'
sudo docker compose exec mosquitto mosquitto_passwd -b /mosquitto/config/passwd telegraf '<telegraf密碼>'
sudo docker compose restart mosquitto
```

更新 `~/incense-cloud/cloud-telegraf.conf`：把**兩處** `改成你的telegraf密碼` 佔位字串換成實際密碼（密碼含特殊字元時，用 Python 讀檔替換比 sed 安全），然後：

```bash
sudo docker compose restart telegraf
sleep 5 && sudo docker compose logs telegraf --tail 20
```

驗證認證確實生效（錯誤密碼要被拒絕）：

```bash
sudo docker compose exec mosquitto mosquitto_sub -u burner -P '錯誤密碼' -t 'test' -C 1 -W 3   # 應失敗
sudo docker compose exec mosquitto mosquitto_pub -u burner -P '<burner密碼>' -t 'test' -m ok    # 應成功
```

> 驗收 **C5**：兩組帳號建立；錯誤密碼被拒、正確密碼可用。
> 驗收 **C6**：telegraf log 無 connection refused / not authorized 錯誤。

---

## 6. Phase 5 — Grafana 設定（全程用 HTTP API，不開瀏覽器）

等待就緒：`curl -s http://localhost:3000/api/health` 回 ok。

**6.1 更換管理員密碼**【需要使用者】索取新的 Grafana 管理密碼，然後（初始帳密 admin / incense12345）：
```
PUT /api/user/password
Basic Auth: admin:incense12345
Body: {"oldPassword":"incense12345","newPassword":"<新密碼>","confirmNew":"<新密碼>"}
```

**6.2 建立 InfluxDB 資料來源**（之後所有 API 呼叫改用新密碼）：
```
POST /api/datasources
Body: {
  "name": "InfluxDB-incense",
  "type": "influxdb",
  "access": "proxy",
  "url": "http://influxdb:8086",
  "jsonData":       { "version": "Flux", "organization": "incense", "defaultBucket": "incense" },
  "secureJsonData": { "token": "incense-local-token" }
}
```
記下回應中的資料來源 `uid`。

**6.3 匯入艦隊儀表板**（處理 JSON 內的 `__inputs` 對應）：
```
POST /api/dashboards/import
Body: {
  "dashboard": <grafana_dashboard_fleet.json 的完整內容>,
  "overwrite": true,
  "inputs": [ { "name": "DS_INFLUXDB", "type": "datasource",
                "pluginId": "influxdb", "value": "<6.2 取得的 uid>" } ]
}
```

驗證：`GET /api/dashboards/uid/incense-fleet` 回 200。

> 驗收 **C7**：管理密碼已更換、資料來源建立成功（記錄 uid）。
> 驗收 **C8**：dashboard `incense-fleet` 存在。

---

## 7. Phase 6 — 模擬香爐點亮資料流

```bash
sudo apt install -y python3-paho-mqtt
cd ~/incense-cloud
nohup python3 sim_burner.py aroma01 --host localhost --user burner --password '<burner密碼>' > /tmp/sim_aroma01.log 2>&1 &
nohup python3 sim_burner.py aroma02 --host localhost --user burner --password '<burner密碼>' > /tmp/sim_aroma02.log 2>&1 &
sleep 30
```

驗證資料已入庫（直接查 InfluxDB API）：
```bash
curl -s -XPOST 'http://localhost:8086/api/v2/query?org=incense' \
  -H 'Authorization: Token incense-local-token' \
  -H 'Content-Type: application/vnd.flux' \
  -d 'from(bucket:"incense") |> range(start:-2m) |> filter(fn:(r)=> r._measurement=="sensor" and r._field=="co2") |> group(columns:["device"]) |> last()'
```
應同時看到 aroma01 與 aroma02 各一筆。

【需要使用者】在 **Windows 瀏覽器**開 `http://localhost:3000` 登入，確認「智慧香爐艦隊監測平台」面板：下拉選單有兩台爐、總覽磁磚各一格、曲線在動。請使用者回覆確認。

管理提示（寫入部署紀錄）：模擬爐用 `pkill -f sim_burner` 停止；重開機後需手動重跑；展示與報告中必須標明為模擬機。

> 驗收 **C9**：InfluxDB 查得到 aroma01、aroma02 近 2 分鐘資料。
> 驗收 **C10**：使用者確認 Windows 瀏覽器面板正常顯示兩台爐。

---

## 8. Phase 7 — Tailscale 對外通道（裝在 WSL 內）

背景：WSL2 有 NAT，區網裝置（手機、之後的真爐 Pi）無法直接連入 WSL 服務。解法是把 Tailscale 裝在 WSL 內，所有外部存取（含真爐的 MQTT 橋接）都走它的 100.x IP。

```bash
curl -fsSL https://tailscale.com/install.sh | sh
sudo tailscale up
```

【需要使用者】`tailscale up` 會印出一個登入網址——把網址完整呈現給使用者，請他用瀏覽器登入 Tailscale 帳號（沒有就現場註冊，Google 登入即可），完成後你再繼續：

```bash
tailscale ip -4        # 記下 100.x.y.z，這就是之後真爐 CLOUD_MQTT 要填的位址
```

【需要使用者・選配】手機驗證：請使用者在手機裝 Tailscale App、登同一帳號，用手機瀏覽器（可關 WiFi 用行動網路）開 `http://100.x.y.z:3000`。

【選配】公開 HTTPS 網址（給沒裝 Tailscale 的人看面板）：`sudo tailscale funnel --bg 3000`，首次會印出核准網址，同樣交給使用者點擊啟用。

> 驗收 **C11**：取得 Tailscale IP；（選配）使用者確認手機以行動網路開啟面板成功。

---

## 9. Phase 8 — 產出部署紀錄並收尾

在 `/mnt/d/WRO2026/部署紀錄.md` 建立檔案，內容包含：

1. 部署日期、部署目錄（`~/incense-cloud`）、各服務版本。
2. 存取方式一覽：本機 `http://localhost:3000`；遠端 `http://<TailscaleIP>:3000`（含 funnel 網址若有）；InfluxDB `:8086`；MQTT `:1883`。
3. 帳號清單：Grafana admin、MQTT burner／telegraf——**只列帳號名，密碼註記「由使用者保管」**。
4. **真爐銜接參數**：之後在 Pi 上執行 `provision.sh` 時，`CLOUD_MQTT=<TailscaleIP>`、`MQTT_USER=burner`。
5. 日常開關機 SOP：Windows 重開機後開一次 Ubuntu 視窗（systemd 會自動帶起 docker 與 tailscale，容器因 `restart: unless-stopped` 自動復活）→ `sudo docker compose ps` 確認 → 需要展示模擬爐時重跑 sim_burner；筆電展示或掛機期間，電源設定改為「不睡眠」。
6. 模擬爐管理指令與「展示須標明模擬」提醒。
7. 驗收總表（§10）的最終結果。

> 驗收 **C12**：《部署紀錄.md》已存在於 D:\WRO2026 且內容完整、不含任何密碼明文。

---

## 10. 驗收清單總表

| 編號 | 內容 | 結果 |
|---|---|---|
| C1 | WSL2 Ubuntu、PID 1 = systemd | |
| C2 | 必要檔案齊全 | |
| C3 | Docker Engine 與 compose 可用 | |
| C4 | 四容器 running、InfluxDB health pass | |
| C5 | MQTT 帳號建立且認證生效 | |
| C6 | Telegraf 無認證／連線錯誤 | |
| C7 | Grafana 密碼更換、資料來源建立 | |
| C8 | 儀表板 incense-fleet 匯入成功 | |
| C9 | InfluxDB 查得到兩台模擬爐資料 | |
| C10 | 使用者確認瀏覽器面板正常 | |
| C11 | Tailscale IP 取得（手機驗證選配） | |
| C12 | 部署紀錄.md 產出且無密碼明文 | |

---

## 11. 已知環境陷阱（診斷時先查這裡）

- **面板全空白**：先確認右上時間範圍為近 30 分鐘；再看 `sudo docker compose logs telegraf --tail 20`（九成是 telegraf 密碼沒改到或改錯）。
- **mosquitto 起不來**：`passwd` 檔不存在就 up、或 conf 檔名沒對上 compose 的掛載路徑。
- **localhost:3000 打不開**：確認人在 Windows 瀏覽器（WSL 的 localhost 轉發通常自動生效）；`sudo docker compose ps` 看 grafana 是否 running。
- **手機／其他裝置連不上**：這是 WSL NAT 的預期行為，不要嘗試改 Windows 防火牆或 portproxy——一律走 Tailscale。
- **Windows 睡眠**：容器與 Tailscale 全部暫停，喚醒後通常自動恢復；長時間掛機請設定不睡眠。
- **WSL 重啟後**：開一次 Ubuntu 視窗讓 WSL 開機即可，容器自動復活；模擬爐（nohup 背景程序）不會自動復活，需手動重跑。

## 12. 完成之後

中心站就緒後，真爐端只剩：P0 硬體通過驗證 → 在爐上的 Pi 執行 `provision.sh`（`CLOUD_MQTT` 填本次取得的 Tailscale IP，且該 Pi 也需 `tailscale up` 加入同一帳號）→ 儀表板下拉選單自動出現真爐。屆時把模擬爐留一台對照或關閉皆可。
