feihong9487/WRO2026/簡報/講稿_5分鐘.md

# 智慧香爐 · 5 分鐘簡報講稿（逐頁）

> 由《講稿_3分鐘.md》擴充。現場簡報 14 頁（第 6 頁捕集、第 8 頁 AI 自我學習、
> 第 11 頁思維發散圖為新增）。總長約 5 分 5 秒，留緩衝。
> 全篇用「22 億」信眾；H1／H2／H3 一律講「設計目標」，不可講成已達成。
> ★誠實邊界：減污數字（效率、3.22×、37 倍）全部是設計目標，被問就照實說。

---

**第 1 頁（封面）· 約 10 秒**
> 評審好，我們是「有拜有包庇」。這是很多人心中最安穩的地方——廟。
> 但它的空氣，可能是全場最毒的。

**第 2 頁（1,360）· 約 30 秒**
> 一支香，就能讓殿內 PM2.5 逼近 1,360，大約是戶外的 50 倍；
> 殿內常態 97，本來就超標將近 3 倍。全球超過 22 億信眾，天天在這種空氣裡祈福；
> 長期暴露，呼吸道鱗癌風險高出 1.8 倍。
> 過去三十年，這個問題只有一個解法——叫大家不要燒香。
> （停一拍）我們找到了第二個。而且，它已經在跑了。

**第 3 頁（禁香犧牲信仰與生計）· 約 25 秒**
> 為什麼不能直接禁？因為禁香踩到信仰——2017 年一句「減香」被誤傳成「滅香」，
> 上萬人上凱道抗爭；也踩到生計——光印度手工捲香就有 40 到 200 萬人靠它吃飯，
> 約八成是女性。環保、信仰、生計，傳統做法逼人三選一——
> 而我們的立場是，健康跟信仰不該二選一。

**第 4 頁（retrofit）· 約 25 秒**
> 那怎麼解得便宜、又推得快？關鍵是：我們不重建香爐，而是做一個低價模組，
> 加裝在既有香爐上——retrofit。單機物料成本不到四千二；
> 十年總持有成本大約是碳中和金爐的八分之一，省約 87%——這是概念估算，不是報價。
> 廟方不用換爐，香客插香的動作完全不變，導入的儀式衝擊是零。

**第 5 頁（三層閉環）· 約 20 秒**
> 它的運作是一個閉環：偵測 → 行動 → 再偵測，而且每一筆決策都可以重演。
> 感測、決策、致動，三層各自獨立，任何一層壞了都能安全降級。

**第 6 頁（★捕集是「接」不是「吸」＋自我否證）· 約 40 秒**
> 這裡有個反直覺的工程結論：捕集是「接」的問題，不是「吸」的問題。
> 距離罩口 100 公厘，我們的誘導風速只有煙羽上升速度的八分之一，200 公厘處剩二十二分之一。
> 煙羽根本不是被吸進去的，是靠自身浮力上升、被罩口承接——
> 所以決定成敗的是罩體幾何，不是風量大小。
> （指下方）而這個判準，推翻了我們自己原本的設計：原訂 175 公厘的罩口接不住煙羽，
> 我們改成 215、加三面側裙。多數團隊只寫成功，我們把「被自己推翻」也寫出來——這才像 IEEE。

**第 7 頁（決策核心）· 約 25 秒**
> 決策的核心是兩件事：前饋削峰，和安全聯鎖優先於一切。
> 人一多，大家呼出的二氧化碳會先變高；所以在大家插香之前，系統就先知道
> 「等一下煙要變多了」，提早把風扇轉起來。它比人早一步，把煙擋在源頭。

**第 8 頁（★AI 自我學習）· 約 40 秒**
> 而這套 AI，會用真機資料不斷重訓自己。真爐每秒把資料送上雲，
> 每 6 小時用最新的實測資料重訓一次，模型版本一路遞增——這叫資料飛輪，越跑越準。
> 但最關鍵的是這個守門條款：新模型如果證明不了比舊的好，就不上線、沿用舊版。
> 這防止「越學越差」，跟多數人「調出一個好看數字就宣稱成功」完全相反。
> 我們連 AI 都是誠實的。目前是居家實測資料訓練，屬預測機制驗證，廟宇場域待實測——這點我們說清楚。

**第 9 頁（已在真實場域跑起來）· 約 25 秒**
> 最重要的是，這些不是紙上談兵。2026 年 8 月，原型已經在真實場域上線，資料每秒進雲端；
> 12 項雲端驗收全過，公開儀表板現在就能掃碼看即時數據。（指 QR）
> 至於減污效果，H1、H2、H3 三項假說會用對照實驗檢定——目前都是設計目標，不是已達成的成效。

**第 10 頁（敢刪，才是工程）· 約 20 秒**
> 工程的另一半是「敢刪」。我們刪掉過投入數週、還研議過專利的磁力理香機構，
> 因為它跟信眾「隨手插進香灰」的真實行為不相容。對真實行為讓步，比守著漂亮設計重要。

**第 11 頁（思維發散圖）· 約 20 秒**
> 這張圖是我們的否決紀錄：四條解題路徑，三條被我們親手否決，每一條都留下否決理由。
> 工程的價值不只在於選了什麼，也在於能被檢驗地說明「為什麼不選其他的」。

**第 12 頁（商業）· 約 25 秒**
> 而付費意願是被證明的：2017 年上凱道抗議減香的北港武德宮，2024 年自己花五百萬買碳權、
> 蓋碳中和金爐。抗議減香的同一群人，自願為技術方案付費。
> 我們的營收是三層：設備銷售、濾材訂閱、還有空品數據服務——而且濾材週期跟農曆天然耦合。

**第 13 頁（影響與下一步）· 約 20 秒**
> 我們每一項主張都配一個可量測指標，不做無法驗證的宣稱。
> 下一步三件事：一座合作廟宇的示範試點、聯誼會通路的口碑擴散、以及把所有設計目標
> 用實測補上——讓現在的每一個「⚠」變成「✓」。

**第 14 頁（收尾）· 約 10 秒**
> 香照燒，神明照拜，煙不見了。健康跟信仰，不用二選一。謝謝評審。

---

_總長約 5 分 5 秒。若試講超時，先砍第 10 頁或第 13 頁第一句最不痛。_
_三處誠實訊號（第 6 頁自我否證、第 8 頁守門條款、第 11 頁否決紀錄）是全場最強的差異化，_
_但主題相近；若評審已明顯認同，第 10 頁可快速帶過，避免重複。_

## 預期提問與備答
- **你們的 80% 測到了嗎？** → 誠實回答「那是設計目標，量測協定已設計成 2×2 因子對照，且量測前公開凍結」。
- **AI 真的變得更好了嗎？** → 「機制已驗證、守門條款在跑；我們甚至做過嚴格交叉驗證，
  證明短期資料上看似的改進其實是拟合漂移的伪影，所以拒絕上線——廟宇場域待實測。」（這比宣稱一個數字更有說服力）
- **跟空氣清淨機差在哪？** → 單位風量效益 37 倍；治理層級不同，清淨機是稀釋、我們是源頭捕集。
