feihong9487/WRO2026/AI訓練/優化實驗_C案算力.md

# C 案算力實驗（2026-08-20 晚）— 給挑戰者 ×24 算力的結果

> 問題意識：C（CEM-MLP）輸給 B，是「演化/RL 不適合這問題」還是
> 「算力沒給夠」？給足算力再輸，結論才硬。
>
> 結論先講：**×24 算力沒有改變排名。B 預測+DP 仍是冠軍；且 v4 的塌縮
> 證明「更多算力」不等於「更好結果」——訓練法設計才是主變數。**

## v4：算力 ×24，從零重滾 → 塌縮（`訓練C_v4.py`）

- 設定：POP 48 × ITERS 40 × 4 eval seeds × 3 天回合、鏡像抽樣、
  雙架構 HID∈{16,24}、21 進程 44 分鐘
- 結果：兩架構訓練側選拔分數**一模一樣到小數第二位**；動作分布診斷
  ＝整天恆出 duty 70。凍結評比 400,856.7 與定速 S1 完全相同
  （v3 為 397,323.5）——**塌縮成定速，比小算力的 v3 更差**
- 驗屍：固定 4 個評估配置可被記憶＋常數解附近扁平高原
  → 精英選擇被雜訊主導 → σ 在高原上收斂
- 產物留檔：`mlpC_v4_collapsed.json`、`cemC_v4_history.json`

## v4b：對症修正 → 邊際改善，未過判優門檻（`訓練C_v4b.py`）

三個修正：★v3 熱啟動★（續煉可用解）、★每代輪換評估 seed★（常數解
無法維持假優勢）、σ 下限 0.05（防高原塌縮）。

- 訓練側選拔（8 獨立 seeds × 3 天、與 v3 同場）：v4b 勝 5/8、
  平均 −6,609,379 vs v3 −6,639,384（好 0.45%）
- 判優門檻 ≥6/8 未過 → **守門條款：mlpC.json 維持 v3**。
  5/8 在擲硬幣範圍，0.45% 的平均差不足以推翻現役
- 產物留檔：`mlpC_v4b.json`

## 凍結評比終局（v3 現役，2026-08-20）

| | 日損失 | vs 日曆規則 |
|---|---|---|
| **B 預測+DP（主力）** | **394,502** | 勝 10/10 |
| C 小型MLP v3（挑戰者） | 397,323 | 勝 8/10 |
| PID | 398,690 | 勝 8/10 |
| A 線性CEM | 400,857 | 勝 9/10 |

## 給日誌的一句話

依第 19 週承諾如實記錄：給挑戰者 ×24 算力後，B 的顯式最佳化仍勝出；
且天真放大算力反而塌縮（v4）、對症修正也只得雜訊級改善（v4b）。
「**預測＋有保證的最佳化**」對此問題結構的優勢至此有了算力對照組的支撐。

★全部為模擬值；訓練側 seed 3200–3307，凍結驗證 seed 1001–1010 未參與
任何訓練與選拔★
