feihong9487/WRO2026/AI訓練/優化實驗_2026-08-20.md

# AI-1 負載預測 優化實驗（2026-08-20）

> 目標：把 AI-1（B 案 ridge 負載預測）調得更好。
> 結論：**在現有 8 天（255 列）居家資料上，沒有任何可信的改進；現役 CAL-12 是
> 合理且不過擬合的選擇。看似的改進經對照證明是拟合短期漂移的伪影。不換模型。**
>
> ★誠實邊界★ aroma01 為居家作息資料、負載為模擬換算代理量（÷26 ppm/支）；
> 所有結論限「預測機制」層次，非廟宇負載成效。

## 為什麼做這個實驗

現役 AI-1 是 12 維日曆特徵的 ridge 迴歸（`ai_online_learning.py` 的
`feats_at()` + `retrain_predictor()`），與 `PI5/pi_fsm.py` ShadowAdvisor 同構。
`ai1_pred_now = predict(w, feats_at(now))` 提供「這個時刻歷史上平常多忙」的
**日曆輪廓先驗**（用於尚無近期觀測時）；`ai1_nowcast` 則是當下**實測**高程。

問題：現役 test MAE ≈ 8 支，還有壓低空間嗎？

## 評估協定（跑前凍結，跑完不改）

- 資料：分鐘級 CO₂ 真實段 → 30 分鐘聚合(mean) → `daily_elevation` → ÷26
- 滾動起點 CV：訓練截點多組、各測其後一段（時序切分、不洗牌、防洩漏）
- 主指標：折平均 MAE(支)；判優 = 多數折勝 **且** 平均更低
- 純 stdlib，直接複用部署版 `ridge_fit`/`feats_at`/`daily_elevation`，
  保證實驗與線上完全同構

可復現腳本（repo 內直接跑，無外部相依）：
- `AI訓練/優化實驗_預測.py`   — 前瞻預測 h=1/h=2 與 naive 基線
- `AI訓練/優化實驗_日曆漂移.py` — 日曆特徵擴充與漂移對照

## 三條路徑，同一個誠實答案

### 路徑 1：前瞻預測（前饋削峰的真正目標）

預測未來 30/60 分鐘的負載，供風扇在人潮到達前啟動。用截至當下的資訊
（lag、日曆(t+h)）預測 y_{t+h}。

| 模型 | h=1 平均MAE | h=2 平均MAE |
|---|---|---|
| 現役 CAL（純日曆） | 6.81 | 6.74 |
| CAL+精簡AR | 2.68 | 4.03 |
| **naive 持平（y_{t+h}≈y_t）** | **2.47** | **4.07** |

**naive 持平最強或打平，學習模型贏不過它。** CO₂ 高程序列平滑、自相關極強，
30 分鐘內幾乎不變，複雜模型加不了價值。→「簡單方法已足夠」。

### 路徑 2：當下 nowcast

加 lag 特徵可把「預測當下」的 MAE 從 6.9 壓到 2.9——但那只是重新發現
「當下 ≈ 上一格」，而系統已有 `ai1_nowcast` 實測值，**零新資訊**。

### 路徑 3：日曆輪廓（純日曆信息集內優化）

不引入 lag（避免重複 nowcast），只擴充日曆特徵。全 255 列公平比較：

| 特徵集 | 9 折勝 | 平均MAE |
|---|---|---|
| 現役 CAL-12 | — | 7.29 |
| +二次/三次諧波(16) | — | 7.15（更差，過擬合） |
| +hour×weekend 諧波(14) | 1/9 | 7.63 |
| +農曆連續 sin/cos(14) | 7/9 | 5.34 ← 看似大贏 |

農曆連續看似判優（降 27%）。但——

## 決定性對照：農曆的勝利是伪影

懷疑點：8 天資料只走農曆周期（29.5 天）的 27%，而 anomaly 模型報過
CO₂ 基線漂移 **−73 ppm/day**。農曆 sin/cos 在這麼短的區間內，本質上就是一個
**緩慢趨勢項**——它可能只是拟合了資料漂移，不是真學到農曆效應。

加一個**純線性時間趨勢**特征做對照：

| 特徵集 | 9 折勝 | 平均MAE |
|---|---|---|
| 現役 CAL-12 | — | 7.29 |
| **+純線性趨勢（僅 +1 維）** | 7/9 | **5.63** |
| +農曆連續（+2 維） | 7/9 | 5.34 |
| 農曆 + 趨勢（+3 維） | 7/9 | 5.79 ← 反而更差 |

**一個單一線性時間特征就複現了農曆幾乎全部的「改進」。** 農曆與趨勢一起用
反而變差，證明兩者在爭同一個信號（漂移）。

→ 農曆特征的勝利**不是學到農曆效應，是拟合了這 8 天特定的下降漂移**。
外推到未來會失效。這是過擬合的教科書案例，正是守門條款
（`MIN_TRAIN_ROWS=144`、防過擬合上線）要擋的。

## 決策：不換模型

現役 CAL-12 是合理、不過擬合的選擇。在 8 天資料上換任何「更優」模型，
都是把漂移伪影當成果上線，違反守門條款精神。**維持現役。**

## 真正的改進路徑

只有一條：**等資料飛輪累積**。農曆周期 29.5 天，現在只走 27%。
等資料跨越 2–3 個完整農曆周期（約 2 個月），農曆效應才可能從漂移中分離，
屆時重跑本套實驗（腳本已凍結、可直接複現）才有意義。

## 這個負面結果的價值

本實驗是「可驗證性即護城河」的活教材：用嚴格的滾動 CV + 漂移對照，
證明短期資料上的模型改進是伪影，因此**拒絕上線**——與「調出一個更低的數字
就宣稱優化成功」相反。可寫入海報第 III 張或研究日誌。
