feihong9487/WRO2026/簡報/海報修正清單_v2.md

# 海報修正清單 — 對 `學術海報_三張A1_2.pdf`

**對象** `簡報/學術海報_三張A1_2.pdf`（3 頁 A1 直式 594×841 mm，2026-08-18 01:45）
**產出日** 2026-08-18
**用途** 逐條可直接套用的修正指示；PDF 無本機來源檔，故本書提供「原文 → 改成」的對照，
由排版者在原始編輯環境套用。

## 校閱方式

三張已用 Windows 內建 WinRT PDF API 算繪為 1500 px PNG 逐張目視
（`scratchpad/render_pdf.ps1`，不需安裝任何套件）。標記 **✅目視確認** 者為看圖核對過；
其餘為文字層分析。

仍看不到的：實際印刷尺寸下的字級可讀性（需 A4 縮圖打樣，見規劃書 §8 步驟⑥）、
送印色彩（CMYK 轉換後的表現）。

**整體評價**：版面品質高於一般高中職隊伍。三欄網格清楚，標題帶／內文／框選重點的層級
分明，圖表全部採直接標註無圖例、圖說是結論句而非名詞——規劃書 §3.5 的規範確實執行了。
以下是可再進一步的地方。

---

## A. 必改：內部一致性

這三項是評審會當場問倒的等級，優先於其他所有修改。

### A1 ★最優先★ ✅目視確認｜圖 12 缺少 N 標註，與表 7 的封頂結論互相打臉

**現況**

- 圖 12 三情境：無系統 97.0｜清淨機 CADR 500 → 77.8｜本系統 56.5 m³/h → **35.0**
- 圖說：「三情境之穩態濃度比較（設計值）。風量比 1/11.5、減量倍率 3.22×，
  單位風量效益比約 37 倍。」
- 第 IX 節：令 dC/dt = 0、代入 C = 35 µg/m³ → **所需 η ≈ 0.80**
- 第 XI 節約束封頂：u_max = 0.58 → **η = 0.597**；反推 N = 9 需 0.756、N = 14 需 0.843、
  N = 20 需 0.890

**衝突**：圖 12 畫出的 35.0 隱含 η = 0.80，而海報自己的約束分析說最高只有 0.597，
連 N = 9 都達不到。圖 12 沒標 N，讀者無從判斷這是哪個工況，看起來就是
「結論說做不到，圖表卻畫出剛好達標」。

**改成**（圖說可直接取代）

> 圖 12. 三情境之穩態濃度比較（設計值，N = ▢）。本系統情境對應 η = 0.80；
> 依表 7，該效率在 N ≥ 9 時已超出轉速上限 η_max = 0.597，缺口須由罩體幾何補足
> （見第 XII 節）。風量比 1/11.5、減量倍率 3.22×，單位風量效益比約 37 倍。

`▢` 填入該圖實際採用的 N。若圖 12 原本就沒有設定 N、只是直接用 η = 0.80 反推，
建議二擇一：

- **(a)** 明講「本圖為 η = 0.80 之目標情境，非目前可達效率」；或
- **(b)** 改畫 N = 1／N = 9／N = 20 三條，讓缺口在同一張圖上看得見。

(b) 較強——它把「我們知道自己還差多少」直接畫出來，與本海報的誠實邊界策略一致。

### A2 ✅目視確認｜表 7／表 8 交叉引用錯誤（兩處）

L1–L6 驗證層級定義在**表 8「驗證層級與現況」**；表 7 是「固定權重與對偶上升之比較」。

| 位置 | 原文 | 改成 |
|---|---|---|
| 第 II 張，約束封頂段末 | 「此結論的可驗證性，取決於**表 7** 之 L5–L6 是否執行。」 | 「…取決於**表 8** 之 L5–L6 是否執行。」 |
| 第 III 張〈XVII 後續工作與未來優化〉首句 | 「本研究已完成四層靜態驗證（**表 7** 之 L1–L4）與全部設計判準之推導。」 | 「…（**表 8** 之 L1–L4）…」 |

### A3 兩個「最不利工況」並存但沒點破

**現況**

- 圖 7 圖說：「最脆弱者為單支香，此與『以尖峰負載為設計點』之直覺相反」
- 約束封頂段：「N = 20 需 0.890，缺口最大 +0.293」

相鄰出現、又都叫「最不利」，會被讀成前後矛盾。實際上是兩種不同的失效模式。

**加一句**（置於圖 7 圖說末，或約束封頂段開頭）

> 兩者並不衝突：N = 1 是**幾何失效**（煙羽動量最小、橫向漂移最大，接不到），
> N = 20 是**容量失效**（接到了但效率不足）。側裙解前者，罩口尺寸與風道解後者。

---

## B. 該加

### B1 表 14 補註：AI 三案的模擬對照已經做完了

**現況**：表 14 把「控制策略：由規則式基線 → 模型預測控制（MPC）→ 模擬環境內強化學習
與 sim-to-real」列為**未來**優化項，讀起來像還沒動工。

**事實**：`AI訓練/` 下 A（線性）／B（預測＋DP）／C（CEM-MLP）三案已完成訓練、凍結評比與
每案三圖，B 案在同一損失函數下十戰全勝，規則式基線保留為對照組。

**改法**：在該列「為何是這一項」欄補一句——

> 已完成模擬階段三案對照（A 線性／B 預測＋DP／C CEM-MLP，共用同一損失函數評分，
> 保留規則式基線為對照組）；**實機未驗證**，故仍列為優化項而非成果。

不加，等於把一整塊已完成的工作藏起來（Code 10 分、Innovation 10 分都在這裡）；
加了又靠「實機未驗證」保住誠實邊界。**零版面成本，只改一格文字。**

### B1+ 要不要放三案對照圖？——建議放，但必須換掉圖 11，且框架要改

**放的理由（目視三張後確認）**

1. **Code 10 分目前幾乎沒有承載物**。三張看完，關於程式與演算法實作的具體內容只有
   式 (10) 的損失函數與表 7 的對偶上升結果，沒有任何一段呈現「我們寫了什麼、怎麼比較的」。
   三案對照是唯一能承載這 10 分的素材。
2. **「AI 在哪裡？」是已預期的提問**（規劃書附錄自己列為預期提問④）。目前三張的答案
   只有表 14 一格未來式。
3. **它是第二個「自我否證」實例**。A 案線性天花板三度確認、C 案兩度未過門檻才換 CEM-MLP
   ——與 175 mm 罩口否證是同一個調性，而那正是本海報最稀有的東西。

**但框架必須改**

第 II 張的主軸是「控制演算法不是瓶頸，罩體幾何才是」。若把三案做成「B 案全勝」的展示，
會與自己的主張打架。正確的用法是**讓 AI 結果去支持幾何結論**：

> 圖 ▢. 三種控制策略在同一損失函數下的凍結評比（**模擬**）。B 案（預測＋DP）最佳，
> 但三案之間的差距遠小於罩體幾何造成的效率缺口（+0.293）——**印證第 XII 節：
> 瓶頸不在控制器**。規則式基線全程保留為對照組。

這樣它就不是一個外掛的 AI 章節，而是主論證的第三個證據。

**版面從哪裡來：換掉圖 11（四維雷達）**

圖 11 與表 11 是**同一份資料的兩種呈現**（表 11 給六條路徑的 0–4 分，雷達圖畫其中四條的
同一組分數），而且圖 11 的圖說自己承認「四軸單位不可加，故面積不具意義，僅比較各軸位置」
——這等於承認雷達圖的形式不適合這份資料。刪圖 11、保留表 11，資訊零損失，
騰出的位置正好放三案對照圖。

**必須帶 ⚠ 模擬標示**，且不得出現任何「AI 使效能提升 X%」之類的敘述。

### B2 第 XI 節量測協定加一句凍結聲明

四項約束（只宣稱相對降幅／確認量程／配對量測／同步記錄 N）之後接：

> 本協定於任何量測執行前公開並凍結；事後更動須併同原始協定一併揭露。

一句話的成本，把「我們會誠實量測」的宣言變成可被檢驗的承諾。這與第 XV 節
「可驗證性即護城河」是同一個論證，放在這裡等於自我印證。

### B3 BOM 拆解表 — **卡住，見 §D1**

---

## C. 該刪／該併

A1 直式站著讀，現行密度過高。以下五項合計可釋出約一個半模組的版面，
正好給 A1(b) 的三條曲線圖與 B1 的補註。

| # | 動作 | 標的 | 理由 |
|---|---|---|---|
| C1 | **刪** | 表 4（主要反應物與產物之莫耳質量）連同其「為何無法定義平均分子量」但書段 | 教科書數據，式 (1)–(6) 已承載化學計量；還要附一段但書解釋自己的侷限，投報率最低。✅目視：位於第 I 張第三欄，約佔該欄 1/6 |
| C2 | **壓縮** | 式 (1)–(3) 理想化完全燃燒 → 一行文字 | 海報自己說它「不描述點燃線香後實際發生的事」。✅目視：實際只佔三行，**釋出的版面有限**，優先度低於 C1 |
| C3 | **去重** | 「標榜環保之線香雖 PM 總質量較低，某些 PAH∕OPAH 濃度卻反而較高 [5]」 | ✅目視確認出現**三次**：第 I 張表 3 註腳、第 I 張〈配方層級的第二條路徑〉框、第 III 張〈研究方法上的延伸〉第二點。留第 I 張的框，其餘改「（見第 I 張）」 |
| C4 | ~~合併表 11／表 12~~ **改為：刪圖 11（四維雷達）** | 圖 11 與表 11 是同一份資料的兩種呈現 | **原建議作廢**——目視後確認表 11（0–4 評分）與表 12（規格對照）結構完全不同，硬合併只會更糟。真正的重複是**圖 11 雷達圖與表 11**；且圖 11 圖說自承「四軸單位不可加，故面積不具意義」。詳見 B1+ |
| C5 | **去重** | 隊伍／成員／指導教練資訊 | ✅目視：每張出現三次（頁首橫幅、主張句下方作者列、頁尾帶）。頁尾帶是規劃書 §3.6 規定的，建議刪**主張句下方那一行** |

**C2 建議替代文字**

> 在氧氣充足且溫度足夠高時，三類燃料成分皆完全氧化為 CO₂ 與 H₂O（式 1–3）。
> 此組方程式建立能量平衡的上界，但不描述點燃線香後實際發生的事——真正主導的是式 (4)–(6)。

---

## D. 卡住／需要人決定

### D1 BOM 拆解表：缺主料表，不編數字

- 本 repo 只有《智慧香爐_硬體設計交接》§8 的**增補** 5 項（IR 近接模組 40／1N4007×4 10／
  保險絲座 20／2N2222＋1kΩ 10／microSD 模組 60，計 +140）。
- 主料表 **NT$3,980** 的逐項明細註明在《實作交接文件》§4，**該檔不在這個 repo**。
- 且 §8 的增補項仍帶三板架構殘留（microSD 模組理由寫「S3 斷網續存」，S3 已除役）。

→ 提供主料表後可做成 6–8 列小表。**在此之前不會產生任何價格數字。**

### D2 真實資料圖：原建議需修正，不能當「廟宇實測」用

`AI訓練/data/aroma01_co2_hourly.csv` 是 aroma01 真機資料（2026-08-12～08-16，59 筆小時樣本，
570–2,119 ppm），但《研究日誌》§7g 明確標注 **★居家作息 CO₂，非廟宇負載★**，
且裝置非全天開機。

**不可**當成廟宇 CO₂ 實測放上海報。它能誠實支撐的是另一件事：**資料鏈端到端是活的**
（SCD41 → R4 → Pi 5 → MQTT → InfluxDB → Grafana，近 24 h 共 34,425 筆、1 Hz）。

要放的話圖說必須是：

> 圖 ▢. 資料鏈端到端實測（2026-08-12–08-16，**居家環境 CO₂，非廟宇負載**）。
> 本圖證明感測—決策—雲端鏈路實際運作，不代表廟宇場域之濃度水準。

放不放由人決定。決定要放，可用純標準函式庫產向量 SVG（符合規劃書 §3.1
「圖表一律向量」），不需安裝任何套件。

### D3 ✅目視確認｜三張海報一張照片都沒有 — 這是最大的單點失分

算繪後逐張檢視：**三張共 12 張圖，全部是圖表與示意圖，沒有任何一張照片。**

- 規劃書模組 **2.8「實機證據」**（控制盒內部／集煙罩＋爐盆／Grafana 螢幕 ×3 張照片）— 未實作
- 規劃書模組 **3.8「團隊與分工」**（成員照片）— 未實作

影響的是評分表裡兩個大項：**Demonstration 15 分**（「東西真的做出來了」的憑據）與
**Team Spirit 15 分**，合計 30 分／200 分。而系統實際上已經在運轉
（aroma01 真機自 2026-08-08 起上線、雲端 12/12 驗收通過），有東西可拍卻沒拍，
是本次最不划算的失分。

**建議**：第 II 張〈IX 系統實作〉圖 8 雙控制器架構旁補一張實機照；第 III 張頁尾帶上方
補團隊照。若版面不足，優先犧牲 C1 的表 4。

### D4 疑似多字 17 處（判斷為抽取假象，仍請搜尋確認）

抽取時出現下列字串。座標檢查顯示這些字都與**前一個字共用同一個 x**，
而正常用字（「是否」「否決」「自我否證」）則正常前進，因此**極可能是文字抽取的假象**，
不是海報錯字。仍建議搜一次確認：

```
最大可否用轉速        指向同否一件事        取否自
反否而較高            此循環不會曾自自行打破  本團隊階自自己的初始設計
```

---

## F. 已產出的新圖檔（三張，向量 SVG）

全部以純標準函式庫產生，無外部套件；輸出為 SVG，符合規劃書 §3.1「圖表一律向量」。
三張都已算繪成 PNG 目視檢查過版面碰撞。

| 檔案 | 尺寸 | 產生器 | 建議位置 |
|---|---|---|---|
| `圖_資料鏈實測_aroma01_CO2.svg` | 165 × 95 mm（一欄） | `產生_資料鏈實測圖.py` | 第 II 張〈IX 系統實作〉圖 8 下方 |
| `圖_商業模式九宮格.svg` | 480 × 175 mm（全寬） | `產生_商業與發散圖.py` | 第 III 張〈XVI 單位經濟與商業模式〉 |
| `圖_思維發散.svg` | 480 × 270 mm（全寬） | `產生_商業與發散圖.py` | **見下方版面成本說明** |

### F1 資料鏈實測圖

三個開機區間分段繪製，**空窗不連線**（裝置未開機的時段不可假裝連續）；標出
570／2,119 ppm 極值證明感測器有反應而非卡住定值；圖內固定印有
**★居家環境 CO₂，非廟宇負載★**。

搭配圖說（見 D2）使用。**任何情況下都不得**把這張圖描述為廟宇濃度或減污成效。

### F2 商業模式九宮格

九格內容全部引自海報既有段落（XIV–XVI 節、表 11、表 12），沒有新造事實。
**未經市場驗證的欄位一律加 ⚠**：地方政府補助通路、廟宇社群口碑、量產成本結構。

**版面成本較低**——它涵蓋了現有的〈三層營收結構〉文字段、〈護城河：可驗證性〉段
與表 12 的大部分內容。若採用，這三塊可以刪掉，淨增約 80 mm。

### F3 思維發散圖 — ★版面成本很高，請先決定放哪★

內容是四條一級解題路徑（需求端 ✗／配方端 △／空間端 ✗／源頭端 ✓）加上源頭端底下
五個設計決策的「被否決前身 → 定案」對照，全部引自表 10、表 11 與研究日誌。

**但它 480 × 270 mm，佔第 II 張內容帶 601 mm 的 45%。** 直說：這個尺寸放不進
現在的海報，除非砍掉一整個章節。三個選項：

| 選項 | 做法 | 代價 |
|---|---|---|
| **A ✅已採用** | 放進 `現場簡報_3分鐘.pptx` 一張投影片＋計畫書，**不上海報** | 海報零成本；口頭簡報時這張圖非常好用（「我們否決過什麼」是最難假裝的） |
| B | 出精簡版上海報取代表 10 | 未採用 |
| C | 完整版上海報 | 未採用 |

**施作結果（2026-08-18）**

| 檔案 | 動作 | 備份 |
|---|---|---|
| `現場簡報_3分鐘.pptx` | 於第 8 張〈ITERATION 敢刪，才是工程〉之後**新增第 9 張**，滿版置中，11 → 12 張 | `現場簡報_3分鐘.pptx.bak` |
| `未來新創家＿高中職組_v3.pptx` | 於 SOLUTION 3-9 之前**新增第 14 頁**〈RESEARCH → SOLUTION 解題路徑的發散與收斂〉，25 → 26 頁 | `未來新創家＿高中職組_v3.pptx.bak` |

計畫書該頁以複製既有頁改造，完整繼承頁首／強調條／項目符號／頁尾樣式，並補三條說明；
**其後所有頁碼已重編**（第 N 頁標號 = N−1，已逐頁驗證至第 26 頁）。
兩份都已匯出圖檔目視確認版面無溢出或碰撞。

海報維持不變，`圖_思維發散.svg` 不進海報。

---

## E. 規劃書已與海報脫節（另案處理）

`簡報/海報規劃書_三張A1.md` 是 **v1.0（2026-08-16）**，使用 1.1–1.9／2.1–2.9／3.1–3.8
模組編號、P1/P2/P3 命名、21 張圖表清單。實際 PDF 已走到 **I–XVII 章節結構**、
SENIOR I/II/III 命名、圖表 12 張。兩者對不上，PDF 不是從這份規劃書排出來的。

建議在規劃書檔頭加一行狀態標註，而非整份重寫：

> **狀態（2026-08-18）**：§4 逐張分區、§5 圖表清單已被 `學術海報_三張A1_2.pdf` 取代，
> 僅供追溯。**§1.3 展位方案、§3 版面系統（印刷規格／字級驗算／配色驗證）、§6 誠實標示規範
> 仍為現行有效規範。**

§3 的字級–觀看距離驗算與配色驗證是真的做過的功課，不該被整份作廢。

---

## 建議施作順序

1. **A1**（圖 12 標 N）— 邏輯漏洞，不補會被問倒
2. **A2、A3** — 各兩分鐘
3. **C1–C5** — 先騰出版面
4. **B1、B2** — 用騰出的版面補回去
5. **D1、D2** — 待人提供資料或決定
