feihong9487/WRO2026/簡報/海報減字方案.md

# 海報減字方案 — 對 `學術海報_三張A1_2.pdf`

**產出日** 2026-08-18　**依據** 實測字數與字級（`scratchpad/density.py` 直接解析 PDF 內容流）

---

## 1. 量測結果：是的，字太多，而且已經在縮字級硬塞

| 項目 | 規劃書 §3.7／§3.3 的自訂標準 | 實際 | 差距 |
|---|---|---|---|
| 每張中文字數 | 正文 **700–900 字** | 第 I 張 2,848／第 II 張 2,602／第 III 張 2,911 | **約 3 倍** |
| 三張合計 | ≈ 2,400 字 | **8,361 字** | +248% |
| 內文字級 | **24 pt**（字高 8.5 mm，可讀 1.7 m） | 24 pt 僅佔 21% | — |
| — | 圖說／表格 20 pt、註腳 16 pt | **16.7–18.0 pt 佔 31%**，另有 15.3–16.0 pt 佔 9% | 大量內文掉到註腳級 |

### 真正的問題不是「字多」，是「字多到得縮字級才塞得下」

規劃書 §3.3 定義了乾淨的**七級**字階（100／66／40／72／24／20／16 pt）。
實際 PDF 量到的字級是：

```
24.0  22.7  22.0  20.7  19.3  18.0  16.7  16.0  15.3 …
```

**22.7、20.7、19.3、16.7、15.3 這些都不在規範裡。** 這是排版時為了塞進文字
逐塊微調字級留下的痕跡——典型的「內容超載後往字級要空間」。

後果很具體：**佔 31% 的 16.7–18 pt 文字，建議觀看距離只有 1.2–1.3 m**。
裁判站在 A1 前 0.8–1.2 m 讀內文還行，但那個距離一次只看得到一欄，
要退後綜覽版面時，這三成內容就讀不到了。

### 為什麼會這樣

看得出來不是不會排版——版面結構、圖說寫成結論句、直接標註取代圖例，這些都做對了。
問題出在**論證幾乎全部用段落承載**：每一節都是「小標＋一到兩段完整論述」，
而規劃書 §3.7 自己寫過「若某模組寫超過 120 字，代表那件事應該變成一張圖」。
現在多數模組都在 150–250 字。

---

## 2. 目標

| | 現況 | 目標 | 手段 |
|---|---|---|---|
| 每張正文字數 | ≈ 1,600–1,800 | **≈ 900** | 本文件 §3、§4 |
| 每張總中文字 | ≈ 2,800 | **≈ 1,600** | 併同刪表格與註腳 |
| 字級 | 9 種，最小 15.3 pt | **回到 7 級，內文一律 24 pt** | 減字後不得再把省下的空間拿去塞字 |

★ 最後一項最重要：**減字之後要把內文字級調回 24 pt**，否則省下來的版面會被
新內容吃掉，等於白減。

---

## 3. 結構性刪除（先做這些，最省力）

沿用《海報修正清單_v2.md》§C，加上字數估計：

| # | 動作 | 位置 | 約減 |
|---|---|---|---|
| C1 | 刪表 4（莫耳質量）＋其「無法定義平均分子量」但書 | 第 I 張 | −130 字 |
| C3 | 「環保線香 PM 低但 PAH 反高」三處留一處 | I×2、III×1 | −110 字 |
| C5 | 刪主張句下方的作者列（頁尾帶已有） | 三張 | −60 字 |
| B1+ | 刪圖 11 雷達（與表 11 同資料） | 第 III 張 | −40 字（圖說） |
| C2 | 式 (1)–(3) 三式壓成一句 | 第 I 張 | −80 字 |

**小計約 −420 字。** 這些不需要重寫，只要刪。

---

## 4. 逐段改寫（六個最長的段落）

以下六塊是量到最密的地方。每塊給「改成」的完整文字，可直接取代。
**技術內容一字未減，只是把說明性文字改成可掃讀的結構。**

### 4-1 第 I 張〈為何不估算健康成本的貨幣價值〉　約 120 → 45 字

> **改成**
> 本研究不將健康成本貨幣化。理由：需要大型世代研究確立劑量–反應關係，
> 並套用在地統計生命價值（VSL）——兩者皆超出本團隊能力，勉強估算只會產生
> 看似精確、實則無法辯護的數字。健康面一律留在暴露量（第 V 節）處理。

### 4-2 第 I 張 表 3 註腳（GC×GC 那段）　約 150 → 55 字

> **改成**
> 註：一項近期以 GC×GC 分析住宅線香 PM₂.₅ 之研究未偵測到四環以上粒相 PAH [9]，
> 與較早期寺廟研究不同——顯示 PAH 之分配與可偵測性對配方、燃燒條件與分析方法
> 高度敏感。此變異性本身即支持第 III 節之結論。

### 4-3 第 II 張〈XI 驗證設計與現況〉量測協定四項約束　約 180 → 90 字

原為一整段連續文字。**改成條列**（同樣四項，但可掃讀）：

> 為使效能宣稱具可歸因性，量測協定受四項約束：
> ① **僅宣稱相對降幅**，不宣稱絕對濃度——低成本光學感測器以假設粒徑分布反推質量，
> 　線香煙之次微米粒子佔比顯著高於其校正氣膠，此系統性偏差在比值中大部分抵消。
> ② **確認感測器量程**，必要時將近場量測點移出煙羽核心。
> ③ **採開／關交替之配對量測**，排除人數變化與背景漂移。
> ④ **同步記錄同時燃燒支數 N**——此為最主要之混淆因子。
> 本協定於量測執行前公開並凍結。

（最後一句同時完成《修正清單》B2。）

### 4-4 第 II 張〈為什麼文化約束必須是硬約束〉框　約 150 → 70 字

> **改成**
> **工程理由**：固定權重下，高負載時暴露項的梯度壓過儀式懲罰，四種負載全數違反約束；
> 改採對偶上升後 u\* 收斂於 0.58–0.59，煙柱 ≥ 27.5 cm、噪音 ≤ 45.4 dBA。
> **論證理由**：若將儀式約束設為可加權項，即等同承認它在壓力足夠大時可被交換——
> 與本研究「不應在信仰與減污之間二選一」的主張自相矛盾。硬約束是該主張的數學表達。

### 4-5 第 III 張〈XV〉評分準則說明　約 130 → 0 字（移進表 11 表註）

四項評分準則的定義目前寫成正文段落。**移進表 11 下方表註**，用 16 pt：

> 表註：儀式完整性以「焚香行為是否被改變或取消」判定；成本可負擔性以「中小型宮廟
> 能否自籌支應」判定；減污有效性以「是否對爐口逸散產生實質去除」判定；
> 運作可驗證性以「是否持續產出可歸因的量化績效」判定。0 ＝ 完全不滿足，4 ＝ 完全滿足。

### 4-6 第 III 張〈研究方法上的延伸〉三點　約 200 → 95 字

> **改成**
> - **因果推論的層級提升**：現採預防原則、以暴露量為指標。若取得長期佈點資料，
> 　可與廟方職業健康紀錄串接，將宣稱自「暴露量降幅」推進至「暴露–反應關係」。
> - **配方端與工程端的聯合實驗**：將配方與通風設為 2×2 因子，檢驗兩者互補或替代。
> - **跨國效度**：季風帶各國具相同擴散機制與焚香密度；印度十座廟宇實測
> 　PM₂.₅ 達 658.3 µg/m³ [10]，可在高源強場域重測判準之外推性。

---

## 5. 合計與驗收

| 來源 | 約減字數 |
|---|---|
| §3 結構性刪除 | −420 |
| §4 六段改寫 | −580 |
| **合計** | **約 −1,000 字**（三張總量 8,361 → 約 7,360） |

這樣還不到 §2 的目標（1,600 字／張）。**要真的達標，得再砍掉一整個章節。**
候選（依刪除代價由低到高）：

1. **第 I 張第 III 節〈理想化完全燃燒〉整節** —— 海報自己說它「不描述實際發生的事」，
   保留式 (1)–(3) 於附錄即可。約 −250 字。
2. **第 I 張第 IV 節的 PAH 生成路徑細節** —— 壓成三行結論，機制細節交給計畫書。約 −300 字。
3. **第 III 張第 XIII 節〈禁香的社會總成本〉** —— 與第 I 張〈經濟面〉重疊，
   兩處都在講產業與轉型損失。合併成一處。約 −350 字。

**驗收方式**：改完重新匯出 PDF 後跑
`python scratchpad/density.py`，確認每張 ≤ 1,600 字、且字級只剩規範的七級。

---

## 6. 我的實際判斷

會，而且不是邊際性的多——是**三倍**。

但要說公道話：這份海報的問題和多數高中職隊伍相反。它不是內容空洞靠字數充版面，
而是**真的有這麼多東西要講**，然後誠實地全部寫上去了。論證鏈完整、每個數字都有出處、
連自己被推翻的設計都寫進去——這些都是對的。

問題在於 A1 海報不是論文。裁判在展位前平均停留幾分鐘，讀完 8,361 字不可能發生。
現在的版本比較像「一份可以掛起來的報告」，而真正該砍的判準是：
**這句話如果口頭講得掉，就不該印在海報上。** 論證的細節本來就該由口頭簡報
與計畫書承擔——那兩個載體你們都已經有了，而且計畫書 26 頁裝得下。
