feihong9487/WRO2026/簡報/講稿_3分鐘.md

# 智慧香爐 · 3 分鐘簡報講稿（逐頁）

> 節奏：開場 30 秒丟「嚴重＋規模＋過去無解＋已經在跑」；背景→商業→技術壓軸。
> 全篇用「17 億」（與投影片一致）；若改 22 億，第 2、4 頁與此稿要一起改。
> H1／H2／H3 一律講「設計目標」，不可講成已達成。

---

**第 1 頁（封面）· 約 12 秒**
> 評審好,我們是「有拜有包庇」。這是很多人心中最安穩的地方——廟。
> 但它的空氣,可能是全場最毒的。接下來 30 秒,先看數字。

**第 2 頁（1,360）· 約 22 秒**
> 一支香,就能讓殿內 PM2.5 逼近 1,360,大約是戶外的 50 倍;
> 殿內常態 97,本來就超標將近 3 倍。全球超過 17 億信眾,天天在這種空氣裡祈福;
> 長期暴露,呼吸道鱗癌風險高出 1.8 倍。
> 過去三十年,這個問題只有一個解法——叫大家不要燒香。
> （停一拍）我們找到了第二個。而且,它已經在跑了。

**第 3 頁（禁香犧牲信仰與生計）· 約 22 秒**
> 為什麼不能直接禁?因為禁香不只是環保決策。
> 它踩到信仰:2017 年一句「減香」被誤傳成「滅香」,上萬人直接上凱道抗爭。
> 它也踩到生計:光印度手工捲香,就有 40 到 200 萬人靠它吃飯,約八成是女性。
> 環保、信仰、生計,傳統做法逼人三選一——而我們的立場是,健康跟信仰不該二選一。

**第 4 頁（逾 17 億人的痛點）· 約 16 秒**
> 而且這不是單一廟宇的問題。每年三千多件宮廟空污陳情、全台一年燒掉兩萬公噸的香;
> 同樣的機制,在東亞、南亞每個季風帶國家都成立。問題可複製,市場也可複製。

**第 5 頁（低價模組・retrofit）· 約 22 秒**
> 那怎麼解得便宜、又推得快?關鍵是:我們不重建香爐,而是做一個低價模組,
> 加裝在既有香爐上——retrofit。單機物料成本不到四千二;
> 十年總持有成本大約是碳中和金爐的八分之一,省約 87%——這是概念估算,不是報價。
> 同一套技術,之後還能延伸到餐飲油煙這種更大的市場。

**第 6 頁（第一性原理）· 約 14 秒**
> 原理很簡單:空污濃度等於產生減移除。產生端是信仰,我們動不得;
> 所以我們只放大移除端——讓香爐自己學會呼吸,而不是叫信眾停止呼吸。

**第 7 頁（感測・決策・機構）· 約 26 秒**
> 那它怎麼運作?其實就三件事,很簡單。
> 第一,它會一直盯著空氣的狀況。
> 第二,這是最聰明的地方——它看得出人潮。人一多,大家呼出的二氧化碳會先變高;
> 所以在大家插香之前,它就先知道「等一下煙要變多了」,提早把風扇轉起來,先把空氣清乾淨。
> 第三,它不會等煙飄滿整間廟才處理,而是煙一冒出來,就在爐口把它吸走、濾乾淨。
> 講白一點——它比人早一步,把煙擋在源頭。

**第 8 頁（故障安全階梯）· 約 14 秒**
> 那安全呢?我們的想法很單純:不管哪裡出問題——網路斷了、主機當了、感測器壞了,
> 甚至整台沒電——它都會自動退回到最安全的狀態。
> 最糟,也就是變回一台普通香爐;它絕對不會倒過來害人。

**第 9 頁（已在真實場域跑起來）· 約 20 秒**
> 最重要的是,這些不是紙上談兵。2026 年 8 月,原型已經在真實場域上線,資料每秒進雲端;
> 12 項雲端驗收全過,3 個公開儀表板現在就能掃碼看即時數據。（指 QR）
> 至於減污效果,H1、H2、H3 三項假說,我們會用對照實驗檢定——
> 目前都還是設計目標,不是已達成的成效,這點我們說清楚。

**第 10 頁（收尾）· 約 8 秒**
> 香照燒,神明照拜,煙不見了。健康跟信仰,不用二選一。謝謝評審。

---

_總長約 3 分鐘。若試講超時,先砍第 4 頁或第 5 頁的第二句最不痛。_
_開場「已經在跑了」在第 9 頁兌現,首尾呼應——這是全場最強的一擊,別趕。_
