feihong9487/WRO2026/簡報/Manus指令包_3分鐘簡報.md

# Manus 指令包 — 智慧香爐 3 分鐘簡報生成

> 使用方式：把「═══ 以下全部貼給 Manus ═══」之後整段複製貼給 Manus。
> 產出拿回來放進 `簡報/`，交給 Claude 做事實校對與逐頁 QA。
>
> ⚠️ **貼之前，你要先拍板兩個數字**（違反團隊「誠實」招牌的風險點）：
> 1. **信眾人數**：事實庫原本只敢寫「印度教＋佛教 逾 17 億（道教與民間信仰
>    另計，無可靠全球統計）」。你想用的「22 億（含道教/華人民間信仰）」在
>    概念上成立，但**必須備妥道教/民間信仰的來源**才能講；備不到就退回 17 億。
>    → 指令包內已標為〔待你確認〕，Manus 會照你填的用。
> 2. **全球總人口**：2026 年約 80–81 億（不是 76 億）；且建議別用總人口當漏斗頂，
>    直接講「逾 22 億信眾」更有力。指令包已改用信眾數為主。

═══════════════════ 以下全部貼給 Manus ═══════════════════

# 任務

為台灣高中生團隊製作 **3 分鐘競賽簡報（口頭 pitch）**：投影片 10 張以內 ＋
每頁逐字講稿（總長控制在 3 分鐘、繁體中文台灣用語、語速自然）。
用途：WRO 2026 Future Innovators（主題 Robots Meet Culture）與「未來新創家」高中職組。
交付：可編輯投影片（PPTX 或 Google Slides）＋ 講稿分頁對應。

# 敘事順序（★務必照這個順序，技術壓軸★）

先用 30 秒讓評審知道「這問題有多嚴重、而且過去無解」，再講背景、商業，技術壓軸。
一句話骨架：**廟裡的空氣毒到超標 50 倍、22 億人天天在吸、過去唯一解法是禁香 →
但禁香傷信仰又斷生計 → 這是 22 億人的市場 → 我們用一台便宜可複製的機器人，
讓香繼續燒、煙不再害人，而且已經在跑。**

## 開場鉤子（0:00–0:30）——★先讓評審倒抽一口氣★
這 30 秒的唯一任務：讓評審立刻感受到「這是個又嚴重、規模又大、而且過去無解的問題，
而這組人解掉了」。用最有殺傷力的已驗證數字，最後一句把解法當懸念丟出去。
- **視覺**：全幅香火鼎盛的廟宇、煙霧瀰漫；一個爆炸性巨數（PM2.5 峰值「50×」或「1,360」）浮現。
- **講稿（約 30 秒，逐字）**：
  > 「這是很多人心中最安穩的地方。
  > 但它的空氣——PM2.5 是戶外的 **50 倍**，殿內常態就已經超標近 **3 倍**。
  > 全球有超過 **22 億**信眾，每天在這樣的空氣裡祈福；
  > 長期暴露，呼吸道鱗癌的風險高出 **1.8 倍**。
  > 過去三十年，這個問題只有一個解法——**叫大家不要燒香**。
  > （停一拍）我們找到了第二個解法。**而且，它已經在跑了。**」
- 末句「已經在跑了」是把 Traction 當懸念先埋，讓評審撐到第三幕想看證據。

## 第一幕：製作背景（0:30–1:00）——為什麼「禁香」不是答案
（開場已丟出健康＋規模，這一幕補「信仰」與「生計」兩個維度，說明為何禁香行不通）
- SDGs 與環保永續是不可逆的趨勢，**禁香/減香的法規壓力遲早到**。
- 但焚香是數以億計信眾的**心靈寄託**，硬禁招致強烈反彈——
  台灣 2017 年「減香」誤傳「滅香」，**數萬人上凱道抗爭**。
- 禁掉的不只是香：**整條香產業鏈會消失**——印度手工捲香從業者 40–200 萬人、
  約八成女性，衝擊落在最沒有轉業能力的一端。
- **核心矛盾**：環保、信仰、生計，傳統做法逼人三選一。
  → 我們的立場：不該在「健康」與「信仰」之間二選一。

## 第二幕：商業價值（1:00–1:45）——22 億人的市場
- **受眾**：全球逾 **22 億信眾**〔印度教＋佛教＋道教及華人民間信仰；★來源待確認，
  否則改用「印度教＋佛教 逾 17 億」★〕——問題與市場都具跨國效度。
- **痛點已被驗證**：台灣廟宇殿內 PM2.5 平均 97 µg/m³（超標 2.8 倍）、
  插香近場峰值達戶外約 50 倍；環保署每年收到宮廟空污陳情 3,000+ 件。
- **我們的價值主張**：
  - **低價**：單機物料 < NT$4,200；十年總持有成本約為碳中和金爐的 **1/8（省約 87%）**
    〔概念估算，非報價〕。
  - **可快速複製**：不必六年建爐、不必五百萬——是**加裝在既有香爐上的模組（retrofit）**。
  - **可推向全球**：東亞南亞季風帶同機制、更高源強；核心技術可移植餐飲油煙等更大市場。

## 第三幕：機器人技術（1:45–3:00）——解方（壓軸，兌現開場那句「已經在跑了」）
- **一句話**：智慧香爐＝**不禁香、不封爐**，讓香爐自己學會呼吸的空品治理機器人。
- **第一性原理**：空污濃度 = 產生 − 移除；產生端是信仰動不得，我們**只放大移除端**。
- **三層閉環**（用圖，不要用文字堆）：
  1. **感測**：CO₂、溫濕度、K 型熱電偶爐溫、PM——爐口/呼吸帶/進出風口。
  2. **決策**：有限狀態機四態（待機/常態/高峰/異常）＋**CO₂ 前饋削峰**
     （人群呼出的 CO₂ 先於插香高峰上升，抽排預先加速）——這是核心智慧。
  3. **機構**：漏斗大口集煙罩 ＋ **雙級抽排（罩口捕集風扇 ＋ 濾箱主抽鼓風機）**
     ＋ 三段過濾（金屬紗網擋火星 → HEPA → 活性碳，順序即安全）。
- **安全五級階梯**（強調「每一層都往安全倒」）：雲端斷→本地續跑／決策失效→控制器接手／
  感測失效→安全態優先／超溫→就地聯鎖風扇歸零／全斷電→香爐回復傳統使用。
- **Traction（已經在跑）**：2026-08 實機上線、真實資料每秒入庫雲端；
  12 項雲端驗收全過、3 個免帳密公開儀表板（可放 QR 現場掃）。
- **收尾金句**：「香照燒，神明照拜，煙不見了。健康跟信仰，不用二選一。」

# 最重要的規則（違反等於作廢）

1. **只能用下方事實庫的數字，一個都不准自己編。** 標了證據等級就要遵守：
   - 〔文獻實測〕〔官方統計〕〔文獻統計〕：可直接講。
   - 〔設計目標〕：必須帶「設計目標／將實測檢定」，**不可講成已達成的成效**。
   - 〔概念估算〕〔假設推估〕：必須明講是估算/推估。
2. **絕對不可出現**：過濾效率%、PM2.5 改善%等未實測成效數字；「理香機構」「磁力矩陣」
   「電磁鐵」（已從設計移除）；乾冰。
3. 語氣：高中生，**自信但誠實、不浮誇**。「誠實」是招牌。
4. 每頁標題寫成**結論句**，不寫類別標籤。

# 事實庫（可用宣稱）

- 殿內 PM2.5 平均 97.0±65.4 µg/m³、峰值 1,360（約戶外 50 倍）〔文獻實測〕
- 環保署每年宮廟空污陳情 3,000+ 件；全台年焚香約 2.1 萬公噸〔官方統計〕
- 2017「減香」誤傳「滅香」，數萬人上凱道〔歷史事件〕
- 長期每日焚香與呼吸道鱗癌相關，風險比 1.8〔文獻實測〕
- 印度手工捲香從業者 40–200 萬人、約八成女性〔文獻統計〕
- 全球信眾：印度教＋佛教逾 17 億〔文獻統計〕／〔含道教及華人民間信仰的 22 億＝待來源確認〕
- 封爐：行天宮 2014 撤爐後殿內降至 15.2 µg/m³，但儀式被犧牲〔文獻實測〕
- 碳中和金爐約 500 萬元，中小廟無法複製〔新聞報導〕
- 單機物料 < NT$4,200〔物料成本，非售價〕；十年 TCO 約金爐 1/8、省約 87%〔概念估算，非報價〕
- 兩板架構（MATRIX Mini R4 ＋ Raspberry Pi 5）、感測 SCD41/SHT31/MAX6675/DS18B20〔實作〕
- FSM 四態＋CO₂ 前饋（θ_ff=120 ppm/min；風扇 duty S0/S1/S2＝0/70/220）〔實作〕
- 雙級抽排：罩口 4020 PWM 捕集風扇 ＋ 濾箱 5015 鼓風機主抽〔設計定版〕
- 三段過濾鏈：金屬紗網 → HEPA → 活性碳（順序即安全）〔設計定版〕
- Traction：2026-08 實機上線、資料每秒入庫；12 項雲端驗收全過、3 個公開唯讀儀表板〔實測〕
- H1 高峰爐區 PM2.5 較基線降 ≥50%／H2 悶燒 60 秒內偵測／H3 前饋先於尖峰＝三項假說
  〔全部設計目標，將以對照實驗檢定，★絕不可講成已達成★〕

# 團隊
- 隊名：有拜有包庇（高中職組）｜成員：李承鴻・曾翊軒｜指導：倪瑞鴻・高若瑋

# 視覺規格
- 風格：中國風 × 寺廟 × 香火，節制優雅（故宮文創/國潮質感，不要俗套藍色科技風）。
- 色票「硃砂鎏金」：硃砂磚紅 #9E3B2F／鎏金 #C9A227（點綴 <10%）／墨 #33302B／宣紙米白 #F8F4EC。
- 每頁一個視覺錨點（大數字或大圖）；投影片字要少，細節放講稿。
- 香煙裊裊的絲縷感可作為貫穿三幕的視覺母題（第一幕人文、第三幕數據現代）。
- 隊名「有拜有包庇」可做成朱文印章放頁角。

═══════════════════ 貼到這裡為止 ═══════════════════

## 拿回產出後的驗收清單（給自己/Claude，不用貼給 Manus）
- [ ] 全篇搜「%」：只允許 87%（TCO，帶「概念估算」）與 50%（H1，帶「設計目標」）
- [ ] 「22 億」有沒有配上道教/民間信仰來源；沒有就改回 17 億
- [ ] 搜「理香」「磁」：不得出現
- [ ] H1/H2/H3、悶燒偵測：後面必須帶「設計目標」
- [ ] 唸一次計時：控制在 3 分鐘內（開場鉤子 30s／背景 30s／商業 45s／技術 75s）
- [ ] 開場 30 秒內是否已丟出「嚴重＋規模＋過去無解」＋末句 Traction 懸念
- [ ] 技術確實壓軸，沒有被提前；開場那句「已經在跑了」在第三幕有兌現（Traction）
