feihong9487/WRO2026/AI訓練/文獻參數.md

# 模擬環境之文獻參數校正（2026-08-16）

> 依 D6 查證紀律：每個回填值都附可追溯出處與證據等級。
> 「文獻支持」≠「本爐實測」——文獻值縮小不確定範圍，但 §5.2 的
> 自有量測仍然必要（文獻是別人的香、別人的房間）。

## 校正結果一覽

| 參數 | 文獻值 | 採用值 | 出處 | 等級 |
|---|---|---|---|---|
| PM2.5 排放因子 | **5–56 mg/g**（23 種香實測）；排放率 **7–202 mg/h** | 預設 10 mg/支（沿附錄 C，落在文獻帶低端；隨機化 7–100） | Jetter et al. 2002, *Sci. Total Environ.* 295:51–67 | 同儕審查 |
| 人員 CO₂ 產生率 | 辦公均值 **0.0048 L/s/人**（站立輕活動略高） | 0.005 L/s（＝0.01 ppm/s @500 m³）**原值獲文獻證實** | Persily & de Jonge 2017, *Indoor Air* 27:868–879 | 同儕審查 |
| PM2.5 表面沉降 | 室內 **0.02–0.55 h⁻¹**（隨表面積/氣流/粒徑變化） | 0.1 h⁻¹（超細粒取低端；隨機化 0.02–0.55）**新增項** | Thatcher et al.、Lai & Nazaroff 系列 | 同儕審查 |
| 煙羽擴張率 db/dz | MTT 捲吸係數 α≈**0.12–0.14** → db/dz=(6/5)α≈**0.14–0.17** | 0.14 **原值落在文獻帶**（本爐仍待 §5.2 實驗 2） | Morton, Taylor & Turner 1956 及後續實驗 | 教科書級 |
| PM 感測器偏差 | PMS 系列對重量法/TEOM **雙向偏差**（高估達 1.47×、R² 0.42–0.76、規格 ±10–15 µg/m³） | 斜率預設 1.0、隨機化 **0.5–1.5**（原 0.5–1.0 單向低估已修正為雙向） | Sayahi et al. 2019 *Environ. Pollut.*；Kelly et al. 2017 | 同儕審查（場測） |
| 煙羽上升速度 | Zukoski/Heskestad 火羽流理論，w∝(NQ̇c)^⅓z^-⅓ | 已於第 17 週採用（N=1/9/20 → 0.40/0.83/1.08 m/s） | 火災工程標準理論 | 教科書級 |

## 兩項誠實註記

1. **排放因子換算**：Jetter 的 7–202 mg/h 是「每小時」，台式立香一支約燃
   30–60 分鐘、1.5–3 g——換算為每支約 5–170 mg/支。附錄 C 的「7–200 mg/支」
   與此同量級。預設 10 mg/支維持不動，因為附錄 C 的等效源強（8.7 支）是
   用它從 Hien 2022 的 97 µg/m³ 反推的——**改預設值就要同步重反推**，
   等自有量測（§5.2 實驗 6）一次到位。
2. **沉降項與錨點**：加入沉降後穩態比零沉降解析解低約 3%。自檢的解析
   錨點（A1/A2/A4）以零沉降配置驗證（與附錄 C 假設一致），沉降另以
   A5 驗方向；域隨機化涵蓋 0.02–0.55 h⁻¹ 全帶。

## 資料來源連結

- Jetter et al. 2002：<https://www.sciencedirect.com/science/article/abs/pii/S0048969702000438>
- Persily & de Jonge 2017：<https://onlinelibrary.wiley.com/doi/abs/10.1111/ina.12383>（NIST 全文：<https://tsapps.nist.gov/publication/get_pdf.cfm?pub_id=920870>）
- Plantower PMS 長期場測（Sayahi et al. 2019）：<https://www.sciencedirect.com/science/article/abs/pii/S0269749118316129>
- 室內微粒沉降（Thatcher et al.）：<https://www.sciencedirect.com/science/article/abs/pii/S1352231002001577>、<https://www.sciencedirect.com/science/article/abs/pii/S1352231003005600>
- MTT 煙羽理論回顧：<https://npg.copernicus.org/articles/21/269/2014/npg-21-269-2014.pdf>

## 尚無文獻可校、只能自量的（維持 EST）

罩體幾何捕集（ETA_GEO/ETA_A——依賴本爐幾何）｜側裙衰減 SKIRT_ATTEN（B8）｜
4020 工作點 P–Q（等型號 datasheet＋實測）｜爐盆有效源徑（本爐插香行為）｜
香客負載模型全部（合成資料，待 aroma01 真實 CO₂ 歷史校正）｜爐溫模型
