feihong9487/WRO2026/AI訓練/模型方案.md

# AI 模型方案（部署目標：Raspberry Pi 5 / 16GB）

> 2026-08-16 提案，待使用者拍板。
> 前提：11 維觀測、4 檔動作、1 Hz 決策、每日 4 Wh 能源預算——
> Pi 5 算力過剩，方案按★可解釋性與答詢價值★區分，不按算力。

## 三案並列

| | A 線性＋演化搜尋 | B 預測＋最佳化（★推薦主力★） | C 端到端 RL（挑戰者） |
|---|---|---|---|
| 模型 | 線性 11→4（44 參數） | ridge/小 GBDT 負載預測 ＋ DP 預算排程 | MLP 11→64→64→4（約 5k 參數） |
| 訓練 | CEM/ES，純 stdlib，筆電十分鐘 | 預測器擬合（可用 aroma01 真實 CO₂ 歷史校驗）；排程器免訓練（背包/DP 解析解） | DQN/PPO（筆電 venv 裝 PyTorch），域隨機化全開 |
| 部署 | 權重直讀 | 兩模組皆純 Python | 權重匯出 JSON，Pi 上手寫前向（無框架相依，<1 ms） |
| 可解釋性 | 高 | **最高**（預測 MAE 與排程 gap 各自可量化） | 低（黑箱） |
| 角色 | 學習型基線 | 主力 | 挑戰者——沒贏 B 就照第 19 週承諾如實報告 |

### 方案 B 細節（推薦理由）

1. **負載預測器**：日曆特徵（時辰 sin/cos、農曆日 sin/cos、週末）＋近期
   CO₂ → 未來每小時預期香支負載。先以模擬資料訓練，aroma01 真實歷史
   累積後換用真資料——**資料飛輪敘事的第一個實據**。
2. **預算排程器**：給定預測負載，「4 Wh 分配到哪些小時」是背包／動態
   規劃問題，**直接解出當日最優排程**，執行中每小時依實際 CO₂ 滾動修正。
3. 答詢故事：「AI 的貢獻在預測；排程是有保證的最佳化解」——與第 14 週
   「算出 AI 幫不了的地方」同一敘事段位。

## 部署安全鏈（三案通用，紅線）

```
Pi 5 ─ pi_fsm.py 主迴圈 1 Hz
  ├─ 模型推論（JSON 權重、無框架、<1 ms）
  ├─ 模型失效/輸出異常 → 退回現行 FSM 規則   ← 不准動
  └─ R4 本地 FSM（Pi 失聯的最後防線）        ← 更不准動
```

AI 輸出的 duty 一律再過 CO₂ 硬警報與超溫聯鎖；16GB 餘裕保留給
未來夜間 on-device 重訓（機隊 3-12 敘事）。

## 評估協定（2026-08-16 凍結；實作＝`評比.py`，不得因結果回頭改）

- **驗證 seed**：1001–1010（10 個）。訓練 seed 空間：A 用 3000+、
  C 用 20000+、B 用獨立 VisitorModel 合成資料——與驗證不重疊
- **情境**：域隨機化【開】、每回合 3 天、每日電量預算 4 Wh
- **主指標**：平均每日總損失（第 15 週損失函數）
- **副指標**：日人時暴露、日能耗、無電時數、超標時率
- **判贏**（對強基線・日曆規則 CalendarRule）：10 個 seed 中 **≥8 個**
  損失更低（配對符號檢定 n=10、k≥8 → p≈0.055），且平均損失更低
- **誠實條款**：全部為模擬值；A/B/C 輸給強基線就照第 19 週承諾
  如實寫進日誌——「簡單方法已足夠」是有效結論

## 已知的先天弱點（預先寫下，非事後藉口）

- C（DQN）γ=0.9995 的信用視野約 2 小時，對跨日預算規劃天生吃虧——
  這正是 B 用顯式最佳化的理由；C 輸在這裡是可預期結果
- B 的預測器以合成香客資料訓練，真實 MAE 未知——aroma01 歷史
  累積後重訓並回報
- 三案都只看得到感測值；近場暴露（獎勵主項）不可觀測，
  sim-to-real 的最終檢驗只能靠實測 A/B
