feihong9487/WRO2026/簡報/Manus指令包.md

# Manus 指令包 — 智慧香爐 A1 競賽海報生成

> 使用方式：把「═══ 以下全部貼給 Manus ═══」之後的內容整段複製貼給 Manus。
> 產出拿回來後放進 `簡報/` 資料夾，交給 Claude 做事實校對與版面 QA。
>
> ⚠️ 貼之前自行確認：本檔不含任何密碼；公開儀表板連結為免帳密唯讀連結，
> 本來就會印在海報上，貼給 Manus 沒有額外風險。

═══════════════════ 以下全部貼給 Manus ═══════════════════

# 任務

為台灣高中生團隊設計**競賽攤位海報**：**三張 A1 直式**（594×841mm）成一組三聯幅，
掛在 2×2×2 公尺攤位牆上。用途：WRO 2026 Future Innovators（主題 Robots Meet
Culture）與「未來新創家」高中職組。語言：繁體中文（台灣用語）。

觀看情境：評審與觀眾站在 1.5–3 公尺外，先被吸引、再走近細讀——
每張海報要有一個遠看就懂的視覺錨點（超大數字、大圖或大金句），
細節資訊放次層。

# 最重要的規則（違反等於整組作廢）

1. **只能使用本指令包提供的數字與事實，一個都不准自己編。**
   每個數字後面標了證據等級，呈現時必須遵守：
   - ［實測］［文獻實測］［官方統計］：可直接陳述。
   - ［設計目標］：必須帶「設計目標」「將實測檢定」字樣，不可寫成已達成的成效。
   - ［模擬］：必須標示為模擬資料。
   - ［假設推估］［概念估算］：必須標示為推估／估算。
2. **絕對不可出現**：過濾效率百分比、PM2.5 改善百分比等成效數字（全部尚未實測）；
   「理香機構」「磁力矩陣」「插孔板」「電磁鐵」（此機構已從設計移除，只能以
   「曾開發後主動移除」的迭代故事形式出現，位置在第二張海報）；乾冰（展示禁用）。
3. 團隊是高中生，語氣自信但誠實，不浮誇。「誠實」是這個團隊的招牌。
4. 標題寫成結論句，不寫類別標籤（寫「十年成本只要金爐的 1/8」，不寫「成本分析」）。

# 專案一句話

智慧香爐：加裝在既有香爐上的空品治理機器人模組（retrofit）——
在「不禁香、不封爐」的前提下，讓香爐自己學會呼吸。
金句：「我們讓香繼續燒，但煙不再害人。」
收尾金句：「香照燒，神明照拜，煙不見了。健康跟信仰，不用二選一。」

# 事實庫（宣稱清單）

## 問題面
- 台大團隊於龍山寺殿內實測 PM2.5 一度達 1,360 μg/m³，約為戶外平均 50 倍（公視 2015）［文獻實測］
- 台灣廟宇殿內 PM2.5 平均 97.0±65.4 μg/m³（AAQR 同儕審查研究 2022）［文獻實測］
- 全球印度教＋佛教信仰人口逾 17 億（道教與民間信仰另計，因無可靠全球統計不併入宣稱）［文獻統計］
- 環保署每年收到宮廟空污陳情超過 3,000 件［官方統計］
- 全台一年焚燒線香約 2.1 萬公噸（環境部 105 年統計）［官方統計］（舊稱「3 千噸香＋24 萬噸金紙≈2 萬輛汽車」經查證不可溯源，禁止使用）
- 2017 年「減香」誤傳「滅香」，數萬人上凱道抗爭［歷史事件］
- 長期每日焚香與呼吸道鱗癌相關，風險比 1.8（95% CI 1.2–2.6，新加坡 61,320 人世代研究，Friborg 2008）［文獻實測］
- 台灣登記寺廟 12,279 座（內政部 2019），其中傳統宮廟約 9 千餘座［官方統計］

## 既有方案的缺口
- 封爐/心香：行天宮 2014 撤爐後殿內 PM2.5 降至 15.2 μg/m³，但儀式被犧牲［文獻實測＋定性］
- 碳中和金爐：北港武德宮方案約 500 萬元，中小廟宇無法複製［新聞報導］
- 市售清淨機：常溫全室設計，管不到高溫爐口點源［定性］
- IoT 監測服務：只量測、不治理，沒有致動器［定性］

## 我們的方案（現行設計，2026-08-16 定版）
- 兩板架構：MATRIX Mini R4（感測＋安全＋致動）＋ Raspberry Pi 5（決策＋上雲）［實作］
- 感測：SCD41 CO₂、SHT31 溫濕、MAX6675 K 型熱電偶爐溫、DS18B20［實作］
- 決策：有限狀態機 S0 待機／S1 常態／S2 高峰／S3 異常；門檻相對背景基線
  （進高峰＝基線+300ppm、遲滯退場＝基線+200、前饋斜率門檻 θ_ff=120 ppm/min；
  風扇 duty S0/S1/S2＝0/70/220）［實作，門檻與實機韌體同步］
- 核心智慧＝CO₂ 前饋削峰：CO₂ 由人群呼出、先於插香高峰數分鐘上升，是人流先行
  指標——人潮還沒插香，抽排已預先加速［設計原理，前饋方法為方法專利主張核心］
- 機構：漏斗大口集煙罩（罩頂外擴 180mm、插香不必對準；下段直筒接風扇法蘭）＋
  三段過濾鏈（金屬紗網擋火星 → HEPA → 活性碳，順序即安全）＋ 變頻抽排［設計定版］
- 安全五級階梯：雲端斷＝本地續跑補傳／Pi 失效＝控制器 5 秒逾時接手本地 FSM／
  感測失效＝回報 -99.9 故障值＋安全態優先／超溫或熱電偶失效＝就地聯鎖直接拉低
  PWM 腳、風扇歸零／全系統斷電＝香爐回復傳統使用（故障安全）［實作］
- 悶燒偵測：CO/CO₂ 比＋爐溫特徵 → 60 秒內強化抽排＋告警［設計目標，將實測檢定］

## Traction（已發生的事實）
- 原型 2026-08-08 實機上線：真實感測資料每秒入庫雲端機隊面板［實測；
  另一台 aroma02 為模擬機，若提到必須標示］
- 雲端中心站 12 項驗收（C1–C12）全數通過；3 個免帳密公開唯讀儀表板［實測］
- 公開儀表板（做成 QR code 放海報上，文案「掃碼即看：機隊即時面板」）：
  https://desktop-c8l8ri6-1.tail7920c6.ts.net/public-dashboards/cc49db3ec819404e84744cfd416cb043
- 比賽現場模式演練通過：手機熱點自動上雲、斷線 QoS1 佇列自動補傳［實測］
- 全案 29 條自動化設計規則跨層自檢（機構/電路/韌體/雲端）［實作］
- KiCad ERC 從 44 項違規修到 0；9 項電氣介面驗算 8 項合格、1 項調參中［實作］
- H1（高峰爐區 PM2.5 較基線降 ≥50%）、H2（悶燒 60 秒內偵測處置）、
  H3（前饋先於尖峰啟動）＝三項假說［全部是設計目標，將以燃燒艙對照實驗＋
  合作廟宇 A/B 實測檢定；絕不可寫成已達成］

## 商業面
- 十年總持有成本（TCO）：本案約 88 萬 vs 碳中和金爐約 680 萬 ≈ 省 87%、約 1/8
  ［概念階段估算，須標「概念估算，非報價」］
- 商模：設備＋年度訂閱制；收入與廟宇空品綁定、誘因對齊［商模設計］
- 市場：TAM 全台寺廟 1.2 萬座；SAM 傳統宮廟 9 千餘座；SOM 由下而上試算＝
  北部聯誼會轄下約 200 座 × 三年轉換 15% ≈ 30 座［假設推估，須標示］
- 買方＝廟方管委會；買點＝陳情壓力、稽查、香火形象［定位］
- 三步路線：①一座合作廟宇示範試點（公開實測數據）→ ②聯誼會口碑擴散（首批
  付費導入）→ ③核心移植餐飲油煙、密閉空品等更大市場［規劃］
- SDGs 對應：3 健康福祉／9 產業創新／11 永續社區／12 責任消費／13 氣候行動，
  每項均配可量測指標［規劃］

## 迭代故事（第二張海報用）
- 曾投入開發磁力理香機構（自動扶正歪香），2026-08 設計檢討確認與信眾「隨手插進
  香灰」的真實行為不相容——整組主動移除，資源集中於真正有效的抽排治理。
- 集煙罩原為 96mm 縮口、插香要對準：改為 180mm 漏斗大口，插香零門檻。
- 敘事主軸：「設計為使用者行為讓步，而不是要求使用者配合設計」。

## 團隊
- 隊名：有拜有包庇（高中職組）｜成員：李承鴻・曾翊軒｜指導教練：倪瑞鴻・高若瑋
- 每張海報頁腳統一放：「智慧香爐｜有拜有包庇（高中職組）｜李承鴻・曾翊軒｜
  指導：倪瑞鴻・高若瑋」＋海報編號（1/3、2/3、3/3）

# 三聯幅內容分配

## 海報 1／3「問題篇」——標題：我們讓香繼續燒，但煙不再害人。
- 頂部：主視覺（香爐＋裊煙意象）＋「智慧香爐」大字＋標語「香火不滅・空氣常青」
- 三個巨型數字：50 倍（殿內 PM2.5 vs 戶外）／17 億+（印度教＋佛教信仰人口）／
  3,000+（年宮廟空污陳情）
- 「為什麼過去都失敗」三行對比：封爐減香→儀式被犧牲／碳中和金爐 500 萬→
  中小廟買不起／清淨機・IoT→治標不治本
- 第一性原理框：空污濃度＝產生速率−移除速率；產生端是信仰動不得→只放大移除端
- 底部宣言（大字）：「不禁香・不封爐——把治理裝進香爐，而不是把禁令加在信眾身上」

## 海報 2／3「系統篇」——標題：讓香爐自己學會呼吸
- 產品/機構區：漏斗大口集煙罩＋三段過濾鏈（紗網→HEPA→活性碳，順序即安全）＋
  變頻抽排（留一個放實機照片/CAD 圖的位置）
- 三層閉環圖：感測（爐口/呼吸高度/進出風口三點）→ 決策（FSM＋CO₂ 前饋）→
  機構（抽排過濾）；決策全紀錄可重演
- 決策核心：FSM 四態圖＋門檻數字（基線+300 進高峰、+200 遲滯退場、θ=120 ppm/min）
- 五級故障安全階梯（表列，強調「每一層都往安全的方向倒」）
- 迭代故事框：敢刪的理香機構＋漏斗改版

## 海報 3／3「成果與商業篇」——標題：不是海報做得好，是系統真的在跑
- Traction 三大卡：2026-08 實機上線（熱點自動上雲・斷線補傳）／12 項雲端驗收
  全過（公開儀表板×3）／29 條自動化設計規則
- 大 QR code 區：「掃碼即看：機隊即時面板（公開唯讀・免帳密）」
- TCO 對比：−87% 巨字＋「十年成本只要碳中和金爐的約 1/8（概念估算，非報價）」＋
  訂閱制誘因對齊一句
- 市場：TAM 1.2 萬座→SAM 9 千餘座→SOM 試算 30 座（標假設推估）
- SDGs 帶（3/9/11/12/13）＋三步路線（試點→擴散→跨域）
- 收尾金句：「香照燒，神明照拜，煙不見了。」

# 視覺規格

## 風格方向（重要）：中國風 × 寺廟 × 香火
- 整組海報的靈魂是「**廟宇香火的東方氛圍**」：香煙裊裊上升的絲縷感、
  硃紅香爐、廟埕光影——香煙是三張共同的視覺母題（可以從第一張延續到第三張，
  像一縷煙貫穿三聯幅）。
- 可用的中國風元素（挑 2–3 種節制使用，不要全部堆上去）：
  雲紋／回紋邊框、窗花格柵、匾額式標題框、朱紅樑柱色塊、燈籠剪影、
  水墨暈染、宣紙紋理底、金箔燙金質感、印章落款（可把隊名「有拜有包庇」
  做成朱文印章放頁腳）。
- 質感基準：故宮文創、誠品書店展覽海報、國潮設計的高級感——
  傳統元素做「底蘊」，現代排版做「骨架」；科技感由乾淨的資訊圖表與
  QR code 自然帶出，不要畫電路板、晶片、藍色光效那種俗套科技風。
- 三張的氛圍遞進：第一張最「香火人文」（廟宇、信眾、煙）、
  第二張居中（機構與圖表為主、東方元素退為邊框）、
  第三張最「數據現代」（但仍保留同款邊框與印章維持一組感）。
- 避免：可愛風、圖庫拼貼感、日本神社元素（鳥居、注連繩——場域是台灣廟宇）、
  春節促銷感（過度的燈籠爆竹福字）、恐怖陰森的香火表現。

## 版面與字級
- 色票「硃砂鎏金」：硃砂磚紅 #9E3B2F／鎏金 #C9A227（點綴 <10% 面積）／
  墨 #33302B（深底 #2E2A26）／宣紙米白 #F8F4EC。60-30-10 面積律，
  單張最多兩種強調色。三張必須是同一套系統、一眼看出是一組。
- 字型：微軟正黑體或 Noto Sans TC。海報級字階：主標 90pt+、區塊標 40pt+、
  內文 ≥24pt、巨型數字 110pt+（1.5–3 公尺外要能讀）。
- 圖片：無真實素材處留占位框標「放實機照片」；AI 生成示意圖須在角落小字標「示意圖」。
- QR code 實際內容用上方公開儀表板網址生成，尺寸至少 70×70mm。

# 交付

- 每張一個檔案：A1 直式（594×841mm）、印刷用 PDF（300dpi、出血 3mm）＋
  可編輯原始檔（PPTX 或 Figma/Canva 連結皆可）。
- 自檢後交付：對照「事實庫」逐數字檢查——沒有庫外數字、沒有把［設計目標］
  寫成成效、理香機構只出現在迭代故事框、QR 內容正確。

═══════════════════ 貼到這裡為止 ═══════════════════

## 拿回產出後的驗收清單（給自己/Claude 用，不用貼給 Manus）

- [ ] 全文搜「%」：只允許 87%（TCO，帶「概念估算」）與事實庫內比例
- [ ] 全文搜「理香」「磁」「插孔」「套筒」：只允許出現在海報 2 的迭代故事框
- [ ] 全文搜「效率」「降低」「改善」：後接數字必須帶「設計目標」
- [ ] QR code 用手機實掃（家裡桌機需開機、Funnel 在線）
- [ ] 尺寸確認 594×841mm＋出血；字在 2 公尺外可讀
- [ ] 丟給 Claude 跑逐頁轉圖 QA 與事實比對
