feihong9487/WRO2026/簡報/一分鐘講稿.md

# 一分鐘講稿（2026-08-11 定稿；2026-08-16 增列 v2 建議稿）

> 約 150 字，35–40 秒講完，停頓空間很夠。
> 口語提示：結論那句放慢講重；「燒香是信仰欸」用平常聊天的語氣；最後一句慢慢收。

---

先講結論：**我們讓香繼續燒，但煙不再害人。**

全球有二十二億人拜拜要燒香——佛教、道教、印度教都是。但香的煙就是 PM2.5，就是致癌物，而且每天都在廟裡累積。

這問題為什麼一直解決不了？因為以前的做法都在叫人少燒——減香、禁香、電子香。但燒香是信仰欸，怎麼禁都會讓信眾覺得被冒犯、心裡不舒服，所以每次都推不動。

我們反過來想：燒多少不是重點，重點是煙留在那裡多久。所以我們做了智慧香爐——濃度一高，風扇自己轉、自己過濾，過熱還會自動斷電。

香照燒，神明照拜，煙不見了。健康跟信仰，不用二選一。

---

## v2 建議稿（2026-08-16，套用商業說服研究後的版本；定稿未動，用哪版你決定）

> 改動三處：第四段加一句「已經在跑」的 traction（研究結論：已發生的證據勝過任何承諾）；
> 收尾前補一句買方視角（讓評審聽見「誰付錢、為什麼付」）；
> 「二十二億」改為可溯源的「超過十七億」（僅印度教＋佛教；日誌第 8 週查證，22 億含佛道印之說無可靠出處）。長度仍在 40–45 秒內。

先講結論：**我們讓香繼續燒，但煙不再害人。**

全球有超過十七億人拜拜要燒香——印度教、佛教都是，還沒算道教跟民間信仰。但香的煙就是 PM2.5，就是致癌物，而且每天都在廟裡累積。

這問題為什麼一直解決不了？因為以前的做法都在叫人少燒——減香、禁香、電子香。但燒香是信仰欸，怎麼禁都會讓信眾覺得被冒犯，所以每次都推不動。

我們反過來想：燒多少不是重點，重點是煙留在那裡多久。所以我們做了智慧香爐——濃度一高，風扇自己轉、自己過濾，過熱還會自動斷電。**而且這不是概念——原型已經實機上線，感測資料每一秒都進雲端面板。**

它是加裝在既有香爐上的模組，廟方不用換爐；買單的是被陳情、被稽查壓著的管委會。

香照燒，神明照拜，煙不見了。健康跟信仰，不用二選一。

---

## 備用素材（較長版本用）

- 宏觀開場：全球印度教＋佛教信仰人口逾 17 億，焚香是共同儀式核心（⚠ 舊稿「22 億佛道印」無可靠出處，已停用——道教與民間信仰無全球統計）
- 職業暴露：受害最深的是每天站爐邊八小時的廟方人員（注意：本句使用者曾要求從一分鐘版拿掉，長版才用）
- 第一性原理：空汙濃度＝產生速率−移除速率；產生端是信仰動不得，所以只放大移除端
- 商業定位（§3B）：既有香爐的 retrofit 模組，買方是廟方管委會（理香機構已於 2026-08-16 自設計移除，勿再提及）
- 出海順序：新加坡/馬來西亞（法規推力）→ 香港（付費意願已證實）→ 日本/泰越 → 印度（最大量級）→ 歐洲教堂乳香
- 商模：硬體進場＋雲端多爐監測訂閱（報表比風扇值錢）

- 機構迭代故事（答詢用）：集煙罩原為上窄下寬縮口（96mm），因插香要對準、不好用，
  2026-08-16 改為漏斗大口（180mm）＋下段直筒接風扇法蘭——「為使用者行為改設計」是加分敘事
- 敢刪的故事（答詢用）：曾投入開發磁力理香機構，檢討後確認與信眾自由插香不相容而整組移除
  ——評審問「你們遇過什麼挫折」時的最佳答案

## 誠實邊界（§7）

健康改善幅度、過濾效率**皆無實測數據**，對外只能講「設計目標」。
aroma02 是模擬機，展示必須標明。
「實機上線」指的是感測—決策—雲端資料鏈（aroma01，2026-08-08 起）；抽排降污成效仍是設計目標。

## 展示合規（2026-08-16 使用者查證定案）

攤位**禁明火、不禁霧氣**。超音波霧化煙源可在攤位現場實演（這正是無明火展示機的
設計前提）；需要明火的情境仍以影片呈現。液體攜帶量依大會規定準備。
