feihong9487/WRO2026/簡報/計畫書優化研究筆記.md

# 計畫書優化研究筆記（2026-08-16）

> 三路研究代理的彙整：競賽計畫書（WRO/FLL/科展/iGEM/ISEF）、商業計畫書
> （Sequoia/YC/Airbnb/SBIR/U-start/ATCC）、大企業商業化說服術（Amazon/Tesla/
> McKinsey/Forrester）。v2 構想書的改動依據都在這裡。

---

## 一、驗收框架（六項標準，未達標就繼續改）

1. **真實且可量化的痛點** — ✅ 已達標（1,360 μg/m³、年 3 千件陳情、來源齊備）
2. **算得出來的市場（SOM 由下而上）** — ✅ v2 已補：4-5 頁加入「約 200 座 × 三年
   轉換 15% ≈ 30 座」的試算（明標假設推估）
3. **已發生的 traction 而非預測** — ✅ v2 已補：3-12 頁加入「Pi5＋R4 原型 2026-08
   實機上線、每秒入庫雲端面板、29 條自動化設計規則自檢」
4. **單位經濟與資金用途綁里程碑** — ✅ 部分達標：4-5B 十年 TCO 已有；v2 在 4-6
   里程碑補「每期綁交付物（實測報告、續訂率、維運 SOP）」。**缺**：單台 BOM 成本
   →售價→毛利的一頁式單位經濟表（待 BOM 定價後補）
5. **團隊執行紀錄** — ✅ 以 traction 句 + 機構迭代/敢刪故事呈現
6. **誠實揭露風險** — ✅ 原稿即強項（反方壓力測試＋風險登錄）；v2 加 AI 揭露更新

## 二、WRO 2026 Future Innovators 硬規格（照抄會出局）

- 報告全文 ≤20 頁單面、超頁 0 分、PDF ≤15MB
- **AI 使用必須揭露**（用了什麼、用在哪、程度）——已寫在參考來源頁 ✅
- 攤位 2×2×2 m、**禁明火、不禁霧氣**（2026-08-16 使用者查證定案）
  ——超音波霧化煙源可現場實演，無明火展示機路線成立
- 評分表（Senior 200 分）：Project & Innovation 75（Idea 20/Research 15/Social 10/
  Slogan 10/創業元素 10/Next Steps 10）＋ Robotic Solution 70 ＋ Presentation 55
- 要求訪談 ≥3 位非教練非家長的外部人士並寫進報告——**目前缺，建議補廟方＋信眾＋環工**

## 三、十大可執行準則（競賽線）

1. 拿評分表當目錄寫——沒對應 rubric 的頁面就是零分頁面
2. 第一頁 executive summary 回答四問：什麼問題/怎麼解/價值多大/為何是現在
3. 問題用官方數字立論
4. 先寫「現有方案為什麼不夠」再寫自己的
5. **把失敗迭代寫成主線**（旺宏獎範式）——理香移除＋漏斗改版正是現成素材
6. 驗證獨立成章：數字＋邊界情境＋誤判案例並列
7. 訪談 ≥3 位外部利害關係人附紀錄
8. 產品要有名字和 slogan（Key Innovation & Slogan 佔 10 分）
9. 每張圖編號＋一句話說明＋來源；難懂指標先教再用
10. 結尾用「下一步＋商業模式」把作品說成起點

## 四、十大可執行準則（商業線）

1. 開場一句話定位，阿嬤也聽得懂
2. 問題先於方案，讓評審「有感」
3. 獨立一頁「Why Now」
4. TAM/SAM/SOM 三層，SOM 必須由下而上算
5. traction 頁：已發生的數字勝過任何財測（Buffer 範式）
6. 一頁一論點、最多 2–3 個數字（YC/Kawasaki）
7. 核心技術一張系統圖講完（Underlying Magic）
8. 主動開進弱點、附錄接招（LinkedIn/Hoffman 範式）
9. 錢雙向交代：怎麼賺（單位經濟）＋怎麼花（用途綁里程碑）
10. 一套說法貫穿所有場合：宣稱清單標註證據等級（實測/模擬/設計目標）

## 五、大企業說服術（十式）

1. Amazon PR/FAQ：先寫「導入一年後的假想新聞稿」當敘事骨幹
2. Minto 金字塔：結論先行，證據備查
3. SCQA：情境→衝突→問題→答案
4. Bezos 式坦誠：主動列弱點換可信度（與本專案誠實一致性同向——直接當賣點）
5. 投入指標追蹤：固定同一組領先指標（上線天數/資料點數/改善率/續訂意願）每次更新
6. Tesla Master Plan：公開三步路線圖（單爐試點→全廟多爐→區域聯網平台）
7. Forrester TEI：用廟方帳本算 TCO/ROI，假設保守化
8. 第三方背書等效物：賽事成績、教授/技師量測簽核、環保局或 NGO 合作字據
9. Lighthouse customer：集中攻下一間指標廟宇換具名案例
10. S-1 一致性：所有場合只從同一份「宣稱清單」取材

## 六、v2 構想書實際改動清單

- 換圖 ×5（版位不動）：心智發散圖（去磁力理香）、三層閉環（機構層改漏斗＋過濾鏈）、
  FSM（S3 改全速抽排＋告警）、虛擬碼→**控制主迴圈流程圖**（與實機韌體一致）、
  資料飛輪→**商業九宮格 BMC**（飛輪保留於內文）
- 文字改寫 ×12 頁：目錄、隊伍分工、概要、3-3B 創新主張（改為前饋＋悶燒偵測雙核心、
  理香改寫成「敢刪」敘事）、3-9/3-10/3-11（機構頁全面改寫為漏斗集煙罩）、3-12
  （H3 改前饋假說＋traction 句）、4-1 情境、4-4 九宮格、4-5（SOM 試算＋智財聚焦）、
  4-6（里程碑綁交付物）、AI 揭露
- 產出檔：`簡報/未來新創家＿高中職組_v2.pptx`（原稿未動）

## 七、下一步（未做，需要人）

- [x] 查證 WRO 攤位霧氣規範 → **不禁霧氣**，霧化現場實演（2026-08-16 定案）
- [ ] 外部訪談 ≥3 人（廟方管理者、信眾、消防/環工）附紀錄
- [ ] 單位經濟一頁表（等 BOM 定價）
- [ ] 給方案取產品名＋slogan（評分佔 10 分）
- [ ] Grafana 面板實截圖放進 3-12（我看不到畫面，需人截）
- [ ] v2 開啟後逐頁目視：文字改寫處是否溢出文字框（程式只能保長度近似，看不到排版）

---

## 八、視覺設計研究與 v3 改版（2026-08-16 補記）

**20+ 模板研究結論（設計 tokens，v3 與現場簡報共用）**：
- 色票「硃砂鎏金」：硃砂 #9E3B2F／鎏金 #C9A227（面積<5%）／墨 #33302B（深底 #2E2A26）／宣紙米白 #F8F4EC；60-30-10 面積律，單頁最多兩種有彩色。
- 版心邊距＝頁寬 8%；字級三層制（標題:內文 ≥2.5:1）；卡片圓角無框線米白底；
  大數字卡：數字 25pt+ 主色、說明 9.5pt 灰；結論框＝主色 tint 底＋左緣 3pt 粗線；
  頁腳固定「專案名（左）＋頁碼（右）」；內文一律左對齊。
- 完整 15 條規則與 5 種 A4 版面骨架見研究代理報告（本節僅摘要）。

**產出**：
- `未來新創家＿高中職組_v3.pptx`——25 頁全重排：每頁蒸餾為重點條列＋大數字卡＋圖解，
  沿用 12 張原資訊圖＋5 張新繪圖＋CAD 算繪；v2 保留為完整論述版。
- `現場簡報_3分鐘.pptx`——同套色票同步更新。
- QA 流程：PowerPoint COM 逐頁轉 PNG 目視檢查（scratchpad/export_pngs.py），
  已修「雙重圖說」等問題。

**⚠ 頁數提醒（需人決定）**：範例版型規定「方案 ≤12 頁、社會創新 ≤6 頁」，
本書沿用原稿結構為 13（含 3-3B）＋7（含 4-5B）——若主辦方嚴格執行頁限，
需把 3-3B 併入 3-3、4-5B 併入 4-5。v2/v3 結構相同，改起來都容易。

**FGC 工程筆記精讀**：見 `FGC工程筆記精讀.md`——「系統總覽標籤頁」與「白板草圖當證據」
為 v4 候選改進。
