feihong9487/WRO2026/簡報/香爐簡報.pptx

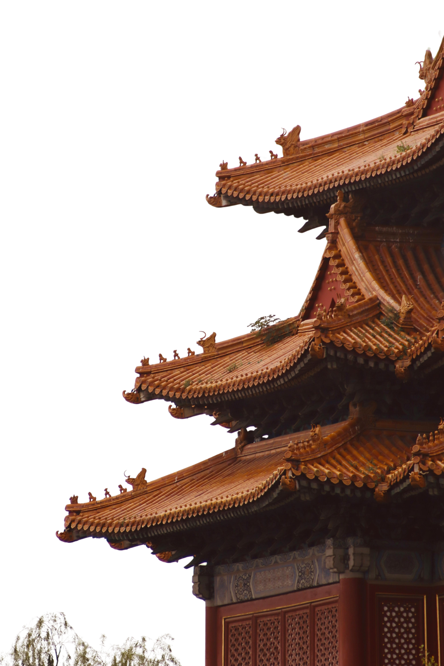
[picture p33: figure]
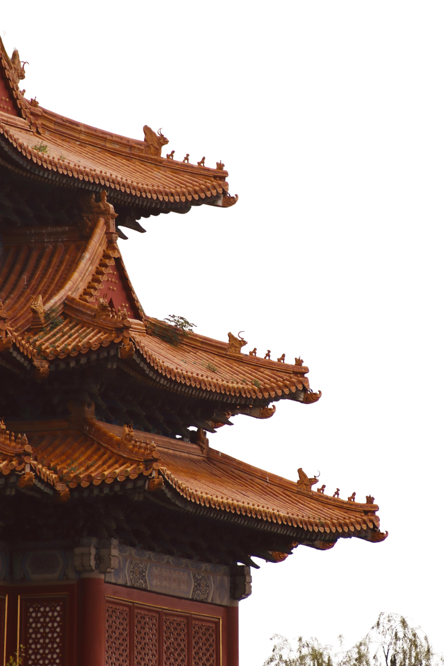
[picture p34: figure]

WRO 2026 Future Innovators
Robots Meet Culture

智慧香爐
香照燒，煙不見

有拜有包庇｜高中職組
李承鴻・曾翊軒

指導：倪瑞鴻・高若瑋

Notes: 評審好,我們是「有拜有包庇」。這是很多人心中最安穩的地方——廟。
但它的空氣,可能是全場最毒的。

## Slide 2

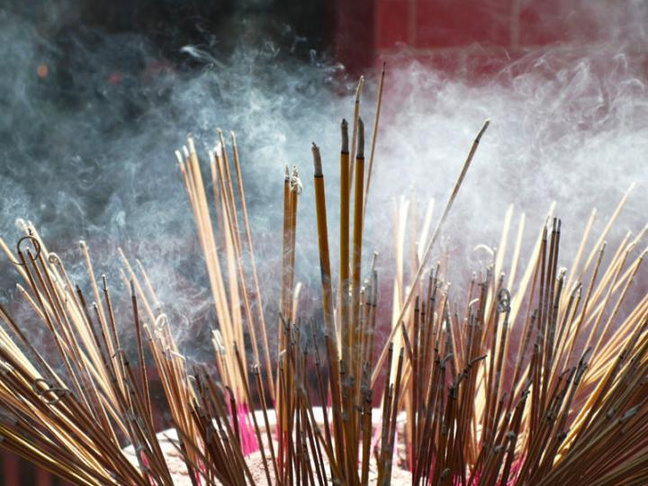
[picture p35: figure]
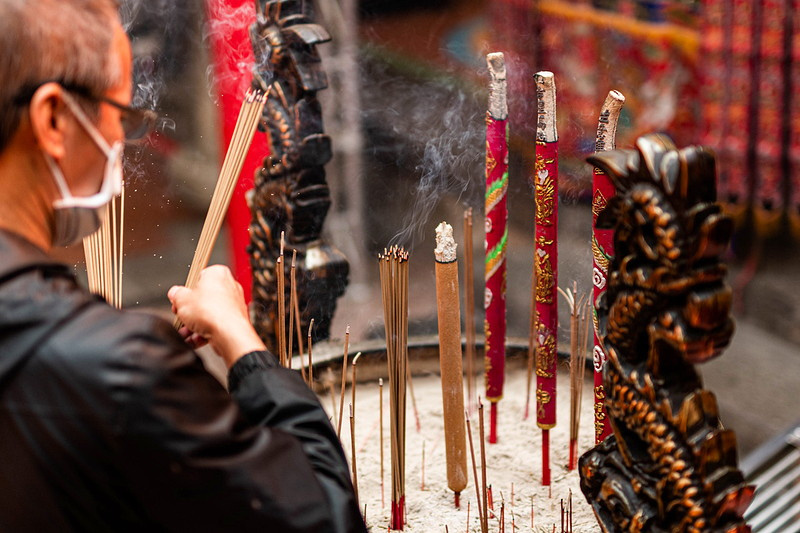
[picture p36: figure]

一支香，讓殿內 PM2.5 逼近 1,360

  - 1,360 µg/m³ 峰值｜約為戶外 50 倍
  - 97.0 ± 65.4 µg/m³ 平均
  - 呼吸道鱗狀細胞癌風險 1.8 倍
  - 印度教＋佛教信眾逾 17 億

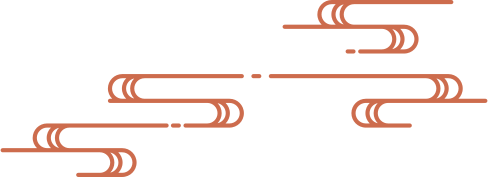
[picture p37: figure]

Notes: 一支香,就能讓殿內 PM2.5 逼近 1,360,大約是戶外的 50 倍;
全球超過 17 億信眾,天天在這種空氣裡祈福;
長期暴露,呼吸道鱗癌風險高出 1.8 倍。
過去三十年,這個問題只有一個解法——叫大家不要燒香。
（停一拍）我們找到了第二個。而且,它已經在跑了。

## Slide 3

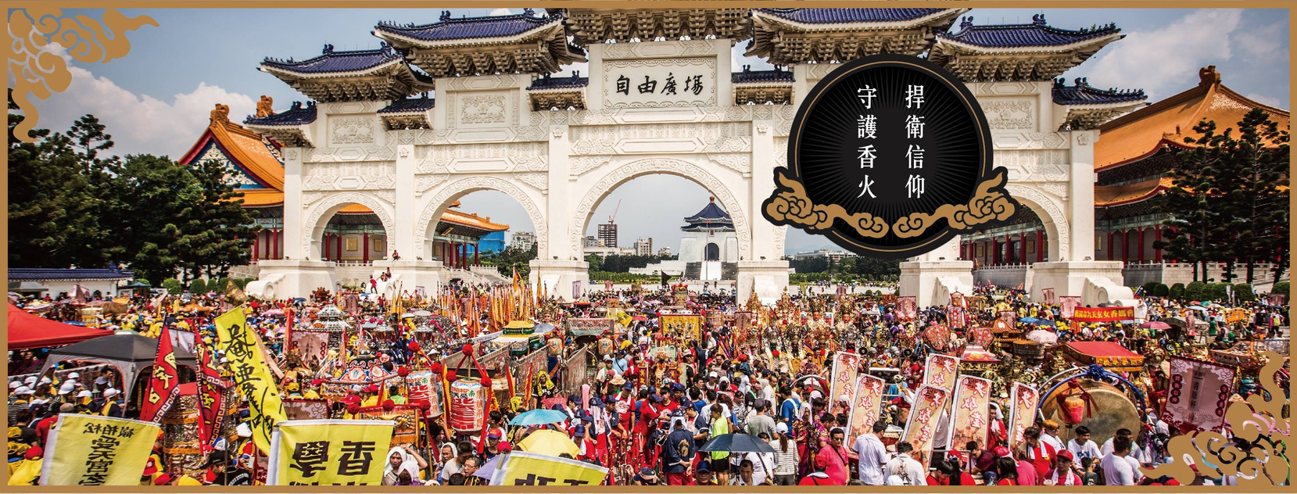
[picture p38: figure]

禁香解決污染，卻犧牲信仰與生計

禁香不只是環保決策，也會碰到文化與生計。

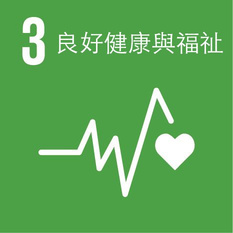
[picture p39: figure]
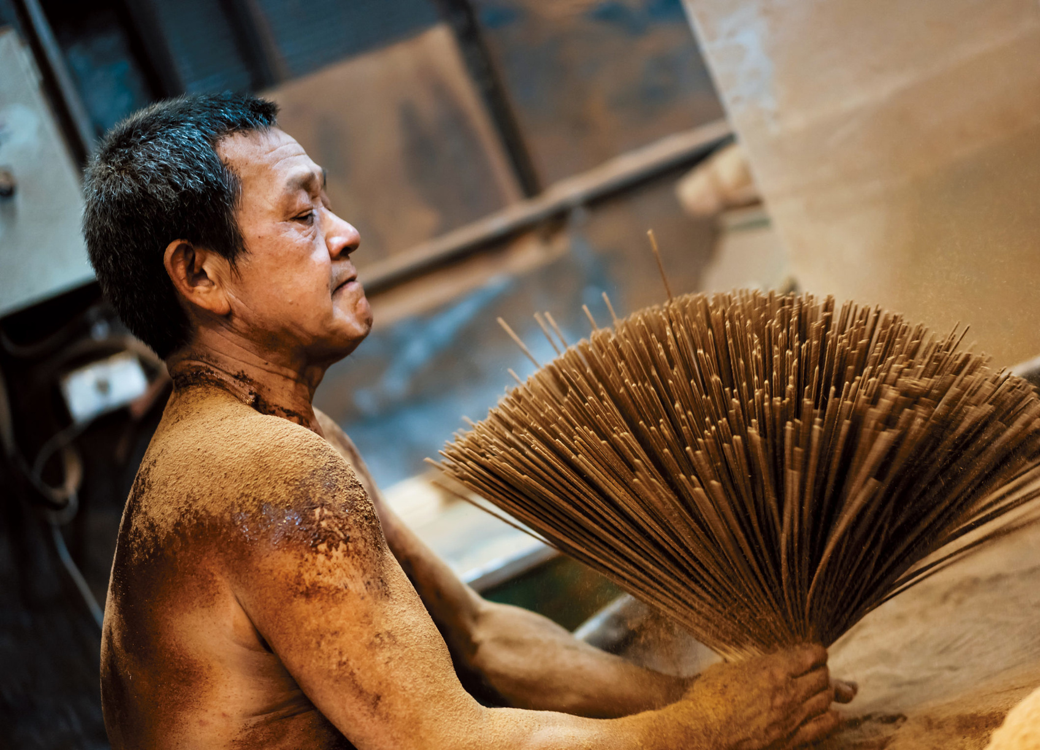
[picture p40: figure]
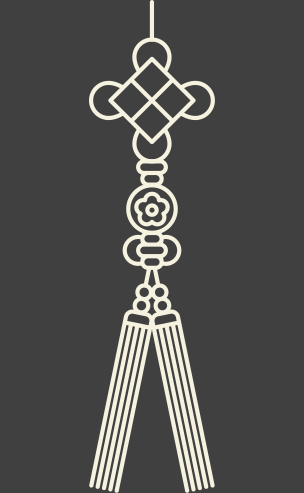
[picture p41: figure]

健康｜
SDGs 與法規壓力只增不減

信仰｜
2017 台灣逾 1 萬人上街

生計｜
印度手工捲香 40–200 萬人

結論｜
不接受健康與信仰二選一

Notes: 為什麼不能直接禁?因為禁香不只是環保決策。
它踩到信仰:2017 年一句「減香」被誤傳成「滅香」,上萬人直接上凱道抗爭。
它也踩到生計:光印度手工捲香,就有 40 到 200 萬人靠它吃飯
環保、信仰、生計,傳統做法逼人三選一——而我們的立場是,健康跟信仰不該二選一。

## Slide 4

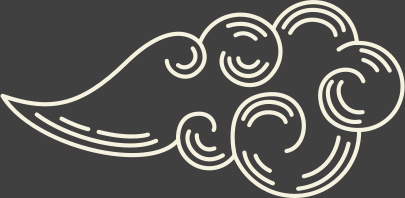
[picture p42: figure]
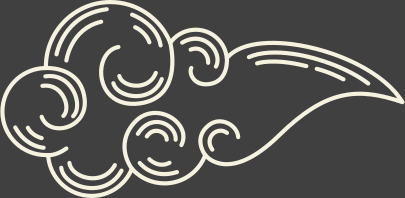
[picture p43: figure]
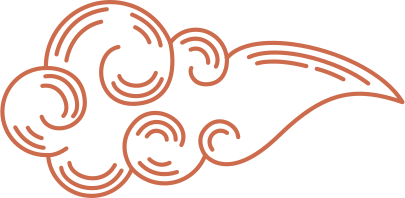
[picture p44: figure]
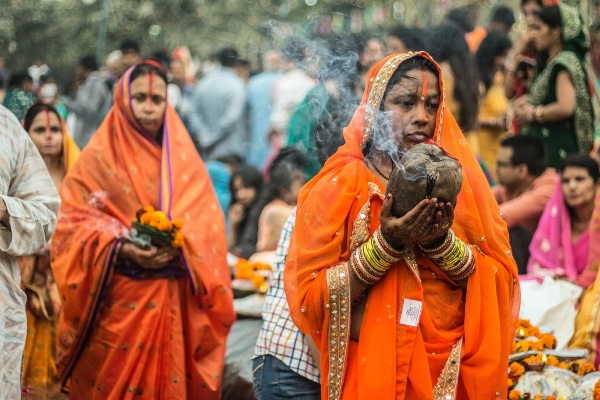
[picture p45: figure]

這不是單一廟宇問題，而是逾 17 億人的共同痛點

  - 97.0 µg/m³ 平均｜1,360 µg/m³ 峰值
  - 3,000+ 件宮廟空污陳情／年
  - 2.1 萬公噸焚香／年
  - 東南亞、印度可直接複製

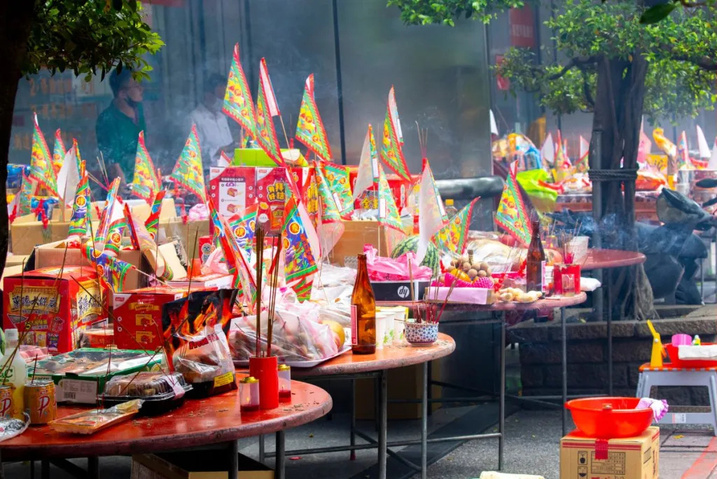
[picture p46: figure]
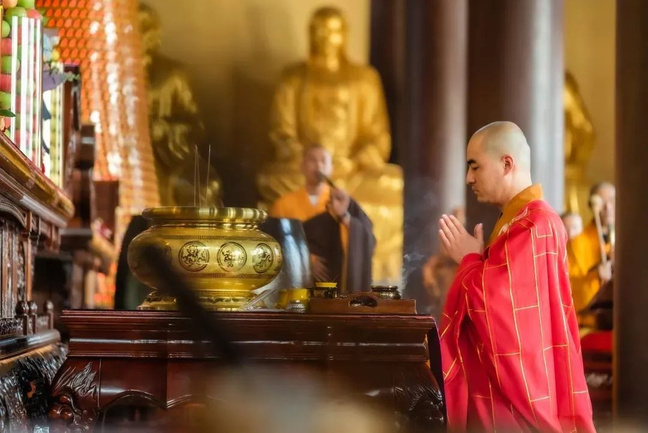
[picture p47: figure]
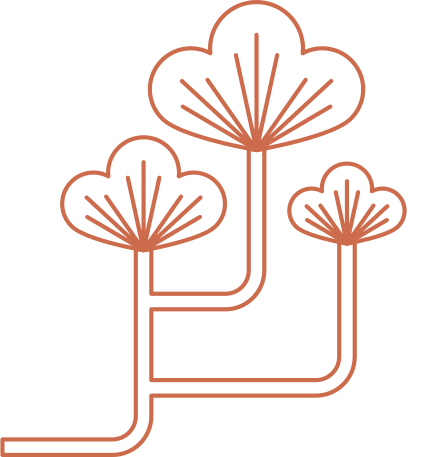
[picture p48: figure]

Notes: 而且這不是單一廟宇的問題。每年三千多件宮廟空污陳情、全台一年燒掉兩萬公噸的香;
同樣的機制,在東亞、南亞每個季風帶國家都成立。問題可複製,市場也可複製。

## Slide 5

我們不重建香爐，而是把低價模組加裝上去

  - RETROFIT｜加裝在既有香爐
  - 單機物料 < NT$4,200
  - 十年 TCO 約為碳中和金爐 1/8
  - 省約 87%

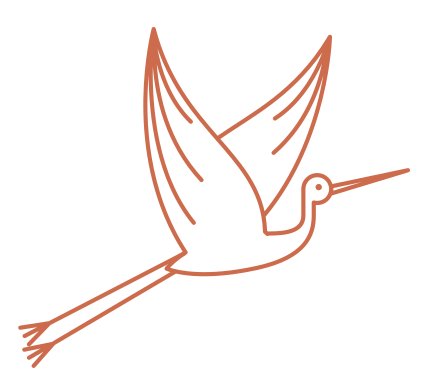
[picture p49: figure]
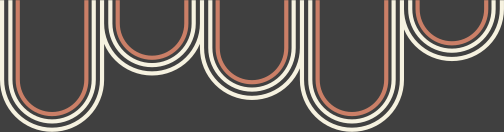
[picture p50: figure]
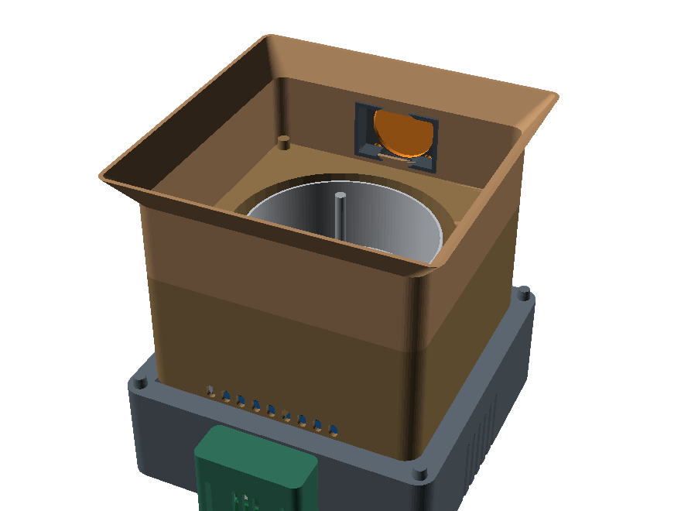
[picture p51: figure]
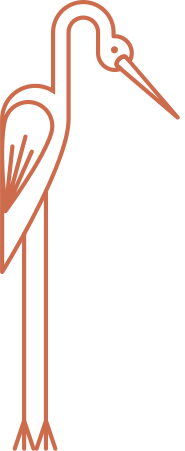
[picture p52: figure]
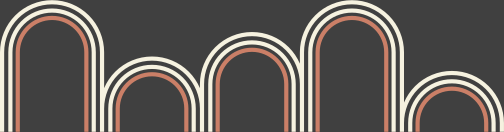
[picture p53: figure]

Notes: 那怎麼解得便宜、又推得快?關鍵是:我們不重建香爐,而是做一個低價模組,
加裝在既有香爐上——retrofit。單機物料成本不到四千二;
十年總持有成本大約是碳中和金爐的八分之一,省約 87%——這是概念估算,不是報價。
同一套技術,之後還能延伸到餐飲油煙這種更大的市場。

## Slide 6

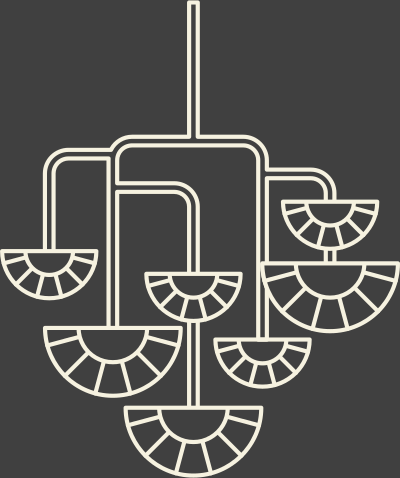
[picture p54: figure]

空污等於「產生 − 移除」，我們只放大移除端

  - 產生端：保留信仰
  - 移除端：捕集、抽排、過濾
  - 讓香爐自己學會呼吸
  - 不叫信眾停止呼吸

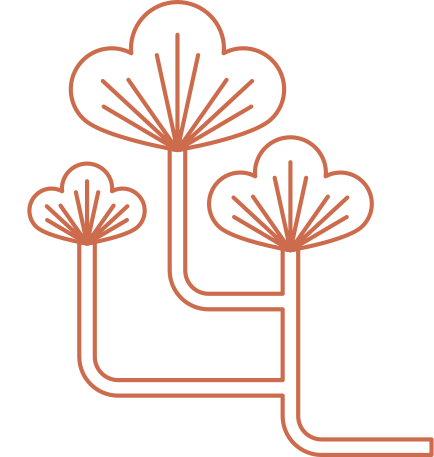
[picture p55: figure]
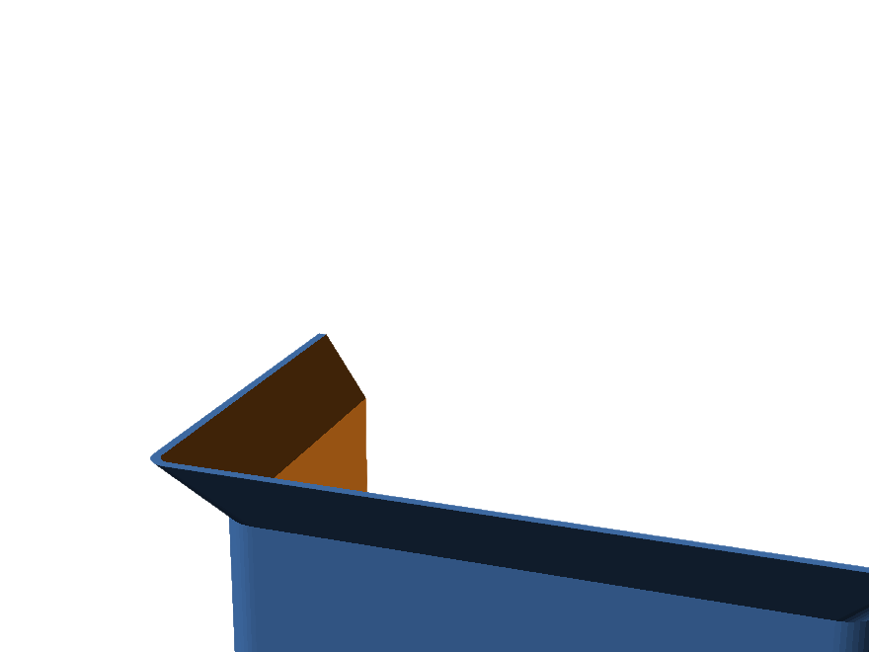
[picture p56: figure]
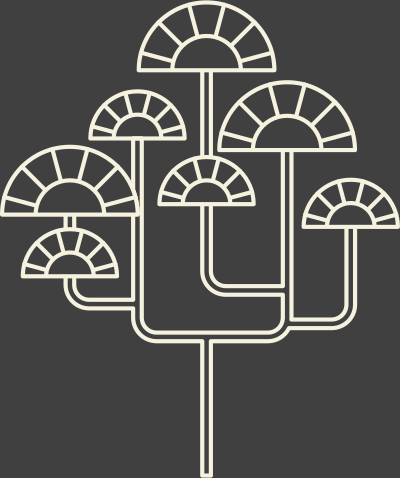
[picture p57: figure]

Notes: 原理很簡單:空污濃度等於產生減移除。產生端是信仰,我們動不得;
所以我們只放大移除端——讓香爐自己學會呼吸,而不是叫信眾停止呼吸。

## Slide 7

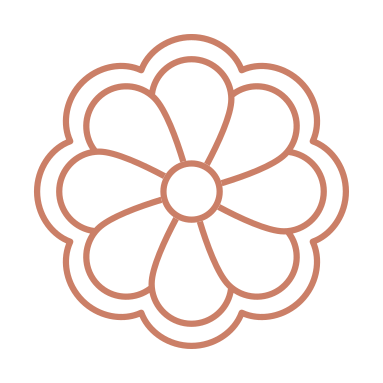
[picture p58: figure]
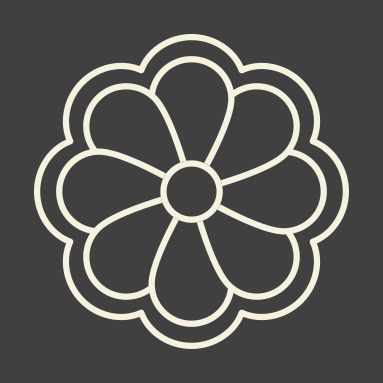
[picture p59: figure]
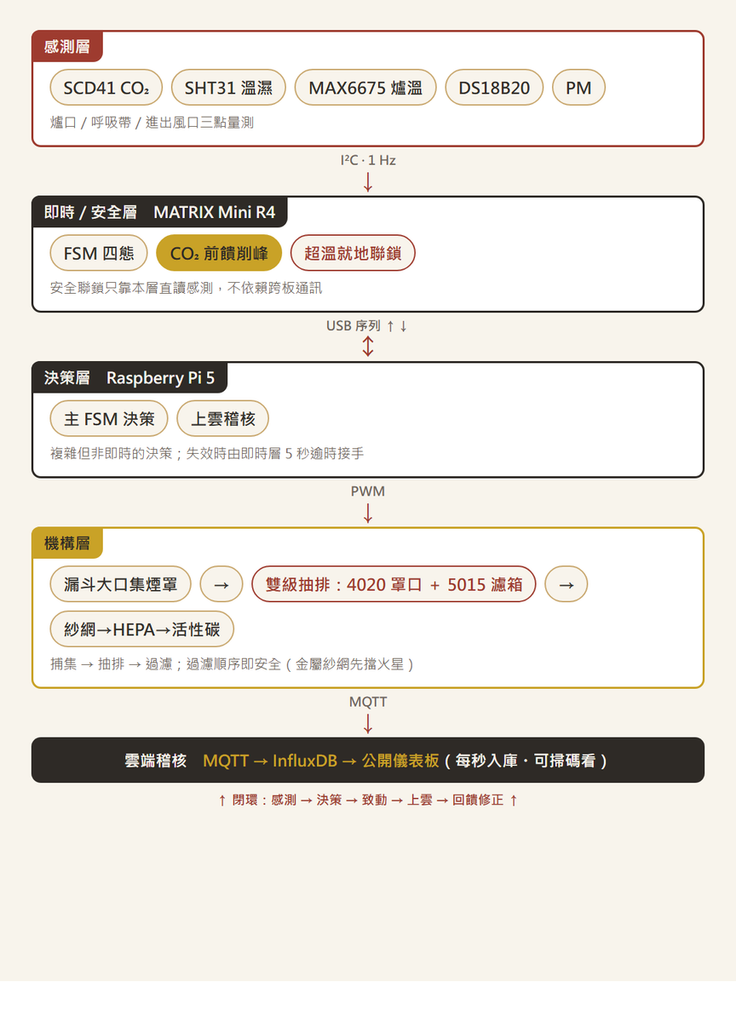
[picture p60: figure]

感測、決策、機構，讓香爐自己學會呼吸

過濾｜金屬紗網 → HEPA → 活性碳
順序即安全，核心智慧在前饋削峰。

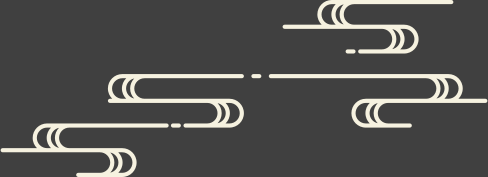
[picture p61: figure]

Notes: 那它怎麼運作?其實就三件事,很簡單。
第一,它會一直盯著空氣的狀況。
第二,它看得出人潮。人一多,大家呼出的二氧化碳會先變高;所以在大家插香之前,它就先知道「等一下煙要變多了」,提早把風扇轉起來,先把空氣清乾淨。
第三,它不會等煙飄滿整間廟才處理,而是煙一冒出來,就在爐口把它吸走、濾乾淨。

## Slide 8

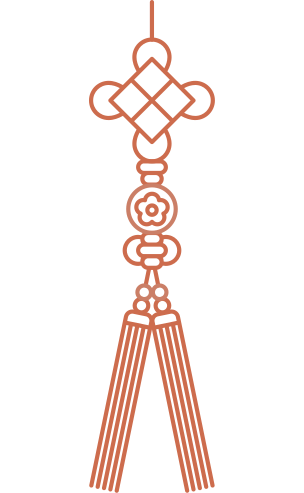
[picture p62: figure]
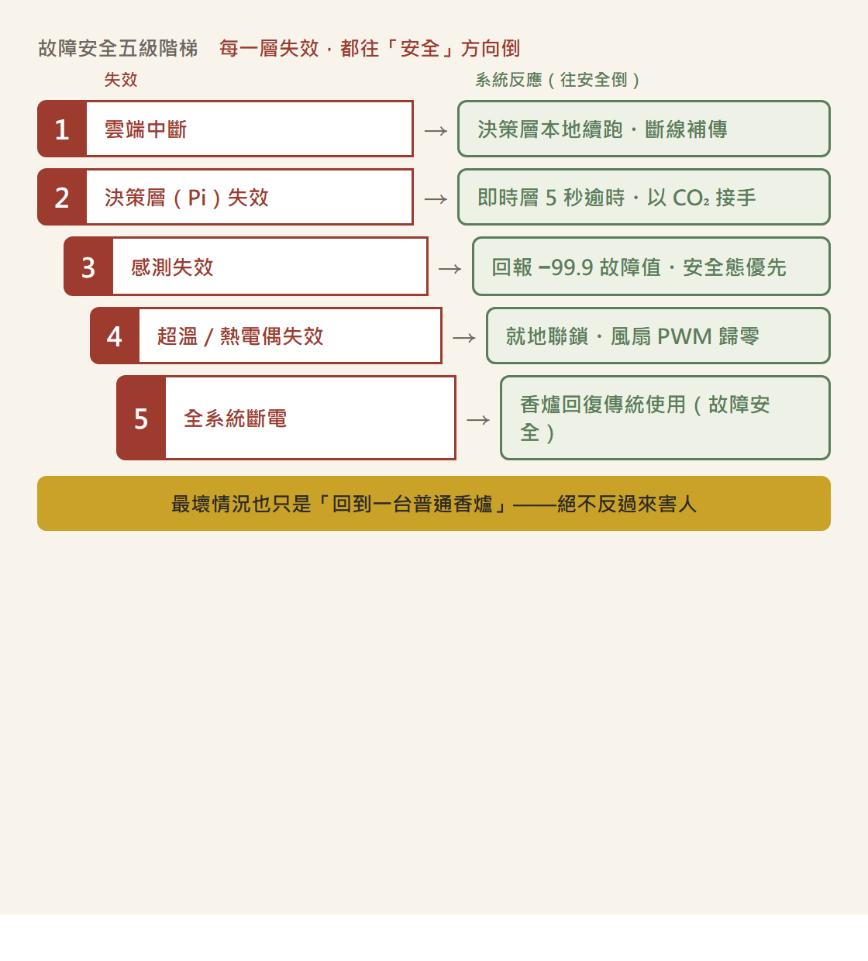
[picture p63: figure]

每一層失效，
都往安全方向收斂

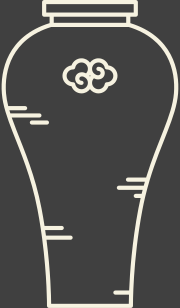
[picture p64: figure]
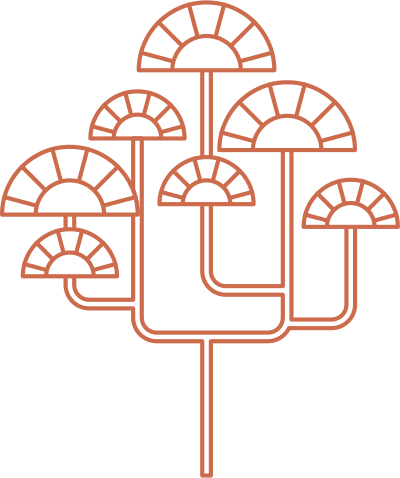
[picture p65: figure]

Notes: 那安全呢?我們的想法很單純:不管哪裡出問題——網路斷了、主機當了、感測器壞了,甚至整台沒電——它都會自動退回到最安全的狀態。最糟,也就是變回一台普通香爐;它絕對不會倒過來害人。

## Slide 9

2026 年 8 月，
智慧香爐已在真實場域跑起來

實機上線｜資料每秒入庫
12 項雲端驗收全過
3 個公開唯讀儀表板

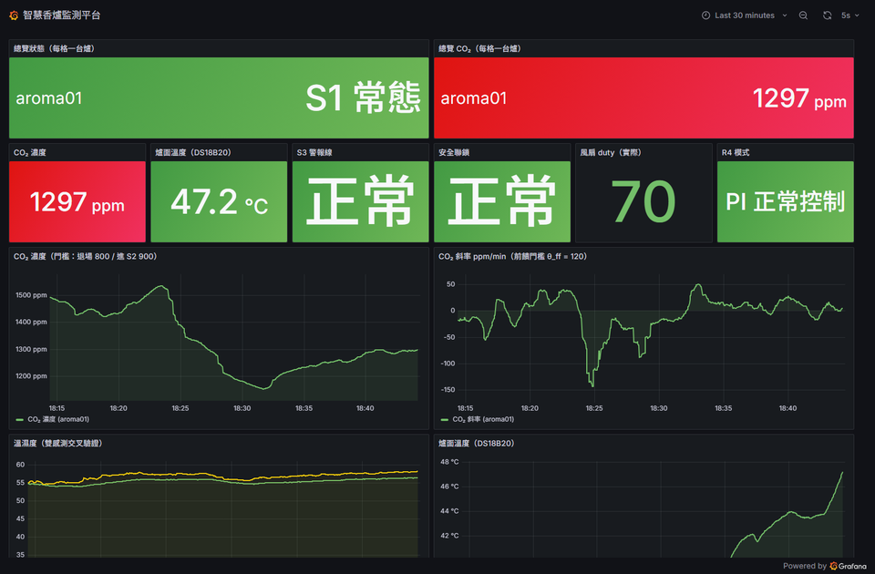
[picture p66: figure]
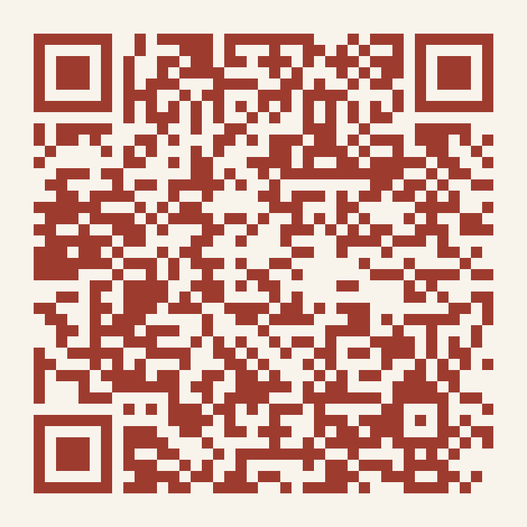
[picture p67: figure]
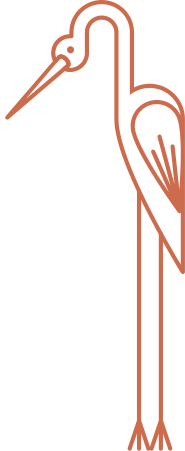
[picture p68: figure]

Notes: 最重要的是,這些不是紙上談兵。2026 年 8 月,原型已經在真實場域上線,資料每秒進雲端;
12 項雲端驗收全過,3 個公開儀表板現在就能掃碼看即時數據。（指 QR）

## Slide 10

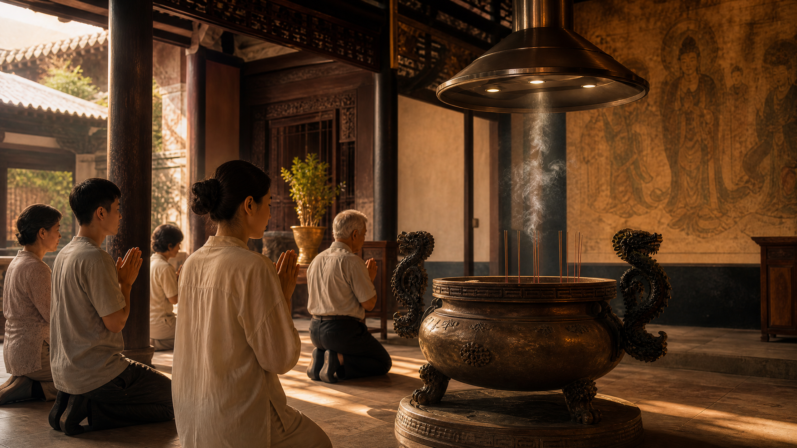
[picture p69: figure]
信眾在清爽明亮的寺廟中祈福，香爐上方煙霧被集煙罩控制

香照燒，神明照拜，煙不見了

健康跟信仰，不用二選一。

李承鴻・曾翊軒

有拜有包庇
智慧香爐
WRO 2026

Notes: 香照燒,神明照拜,煙不見了。健康跟信仰,不用二選一。謝謝評審。
