feihong9487/WRO2026/AI訓練/圖表/ACH反演.png

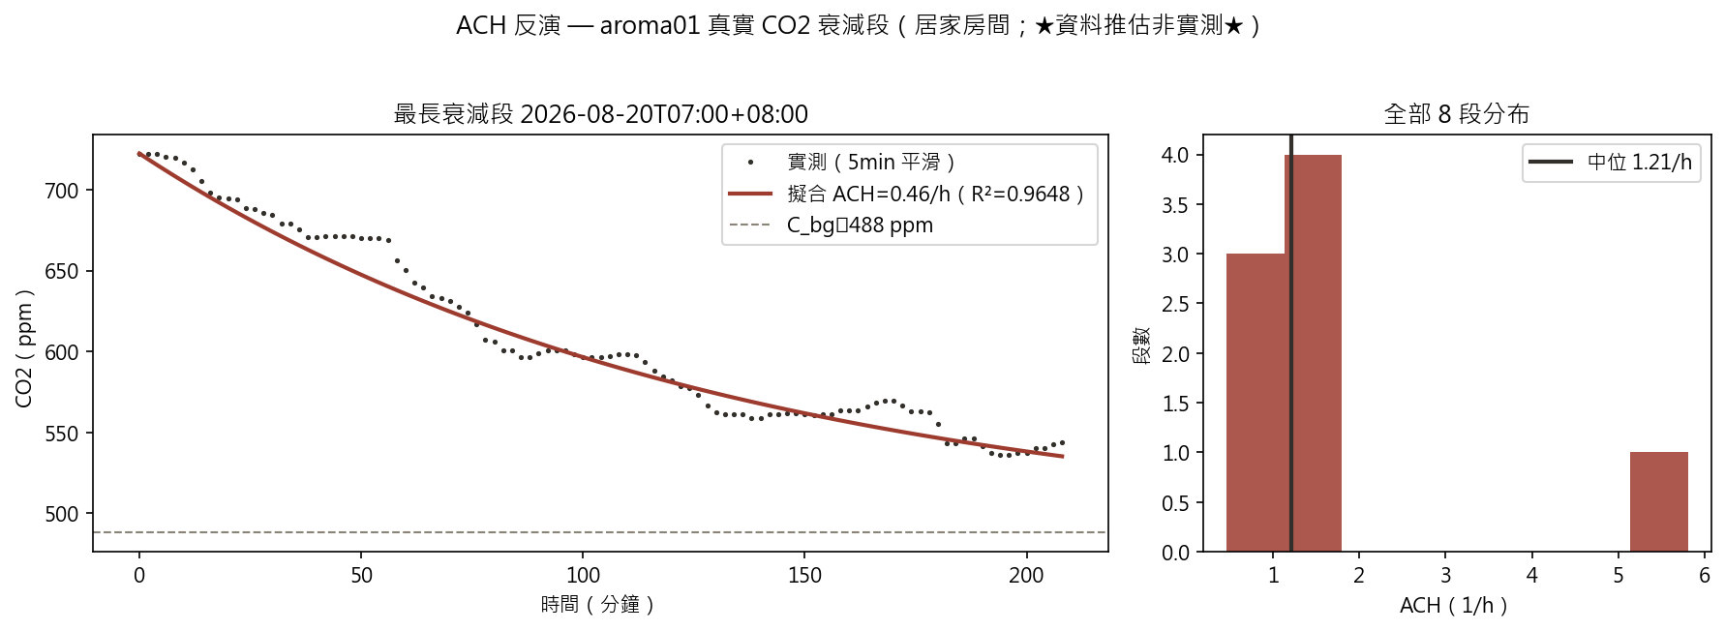
AI訓練/圖表/ACH反演.png
