feihong9487/WRO2026/AI訓練/圖表/B_混淆矩陣.png

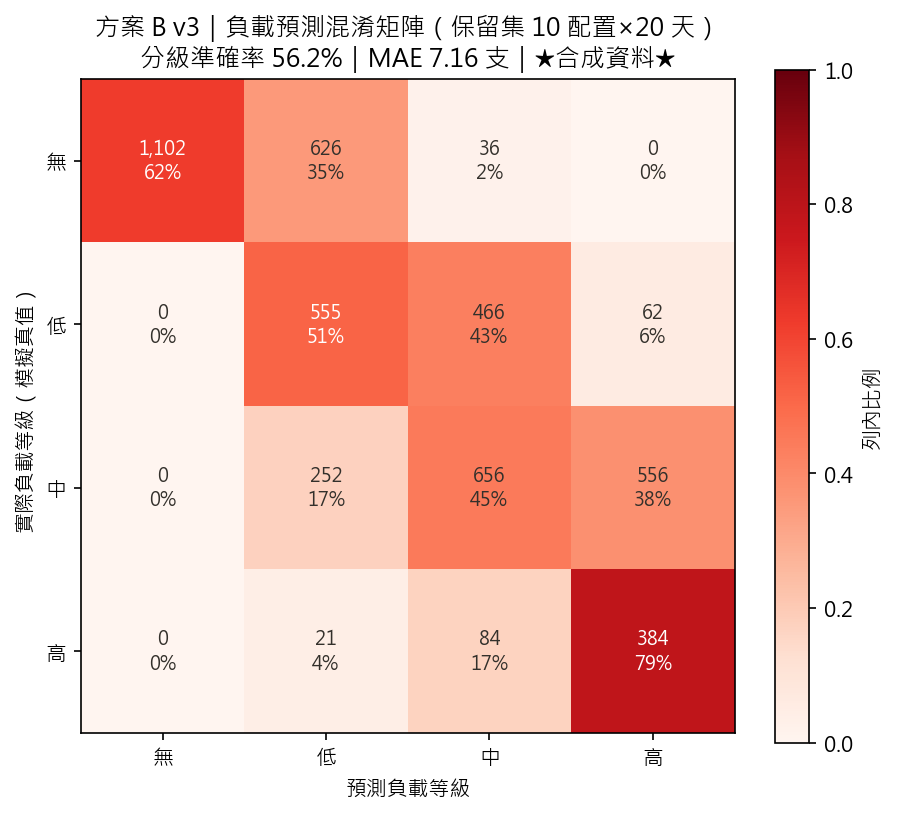
AI訓練/圖表/B_混淆矩陣.png
