feihong9487/WRO2026/AI訓練/圖表/C_損失比較圖.png

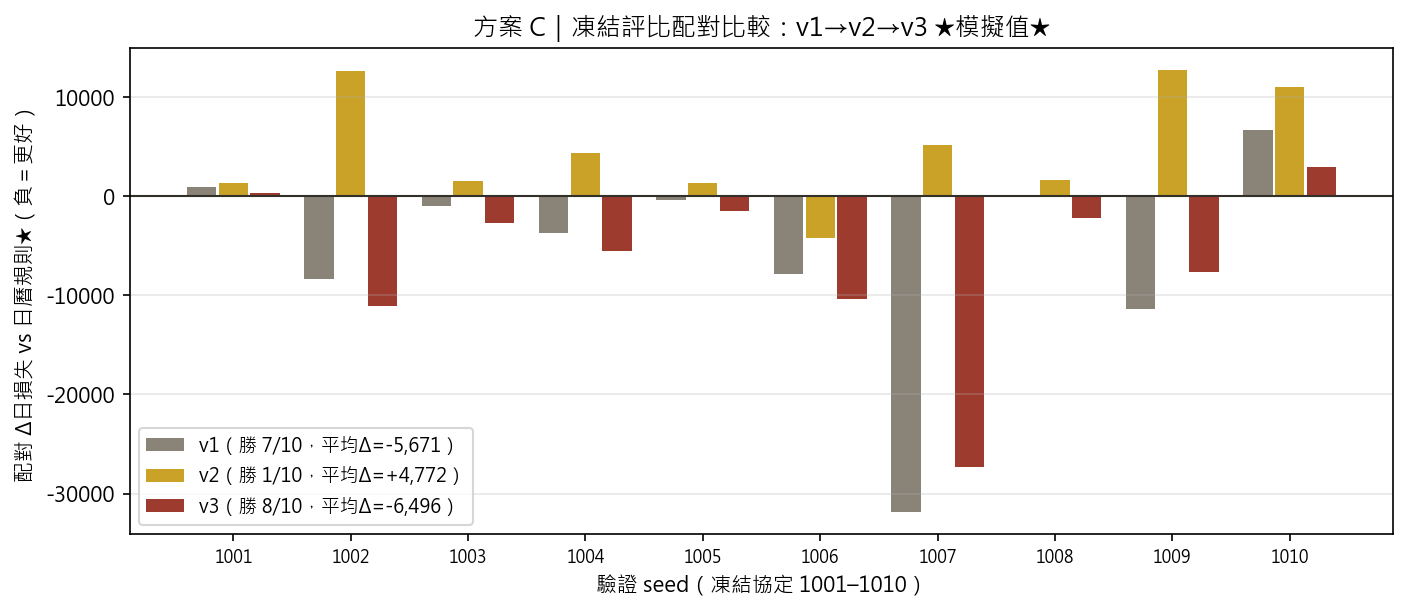
AI訓練/圖表/C_損失比較圖.png
