feihong9487/WRO2026/AI訓練/圖表/C_混淆矩陣.png

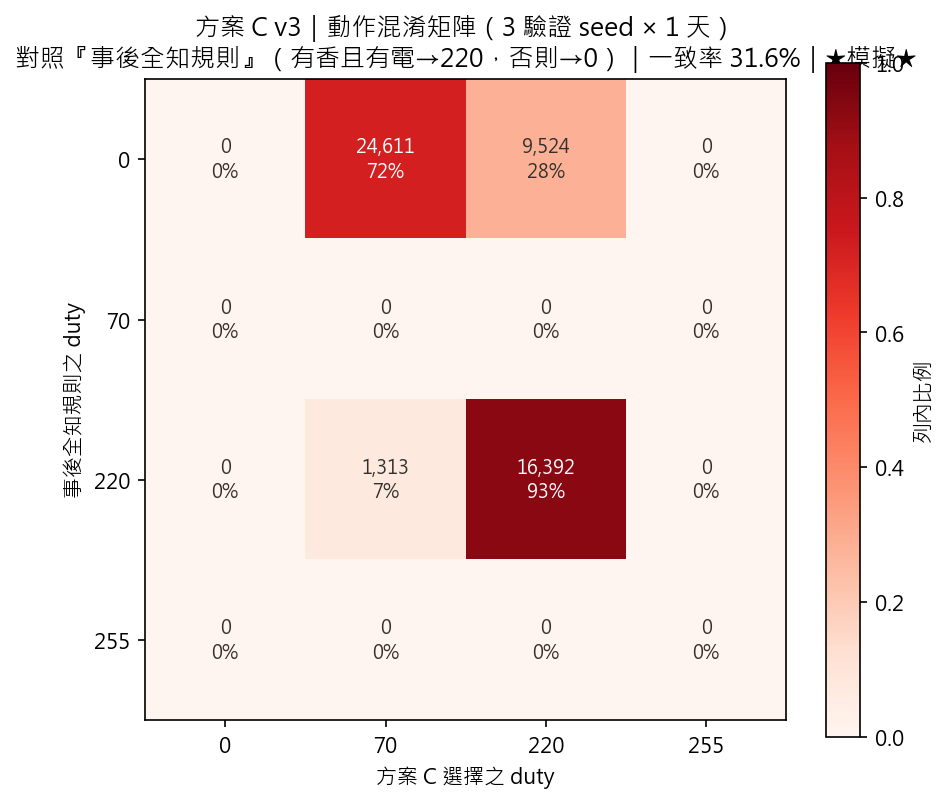
AI訓練/圖表/C_混淆矩陣.png
