feihong9487/WRO2026/AI訓練/圖表/加速實驗.png

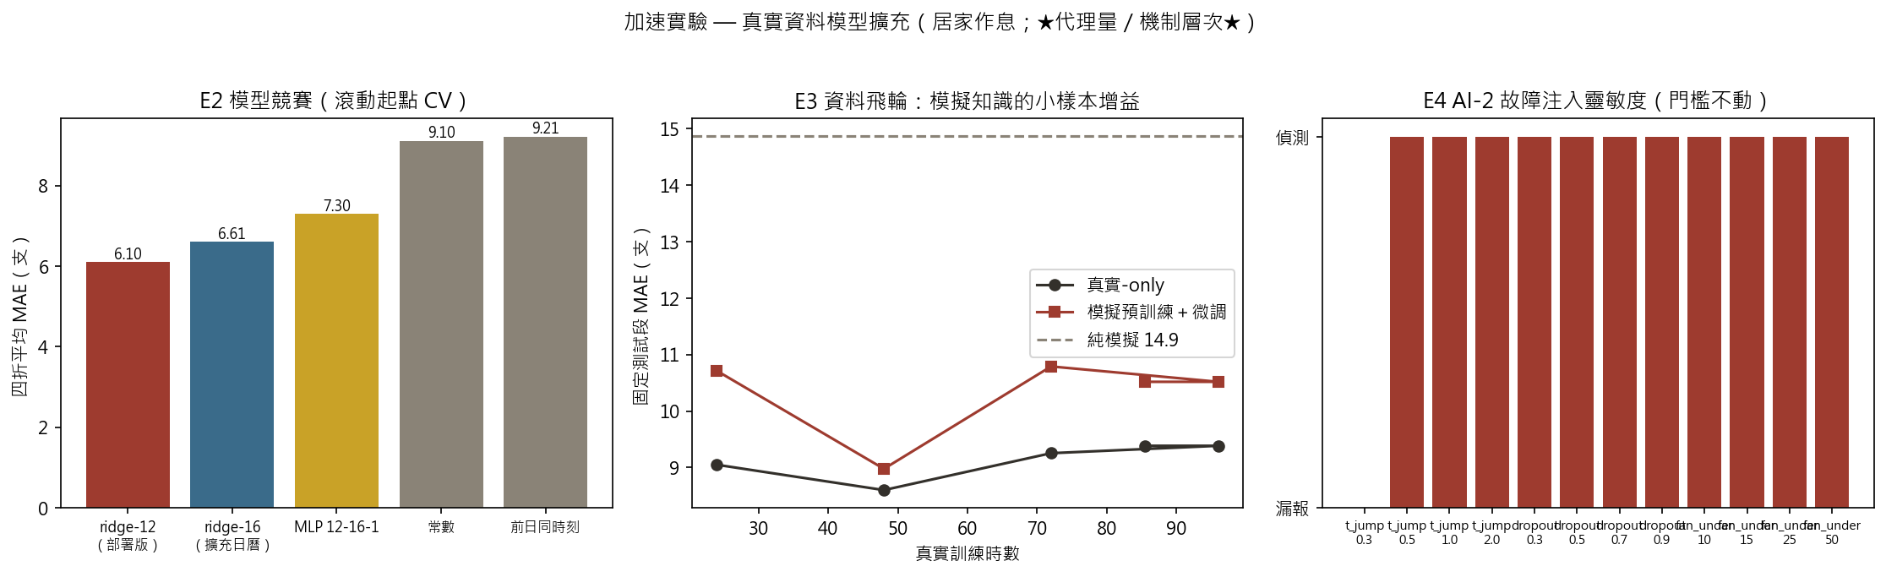
AI訓練/圖表/加速實驗.png
