feihong9487/WRO2026/AI訓練/圖表/外部資料驗證.png

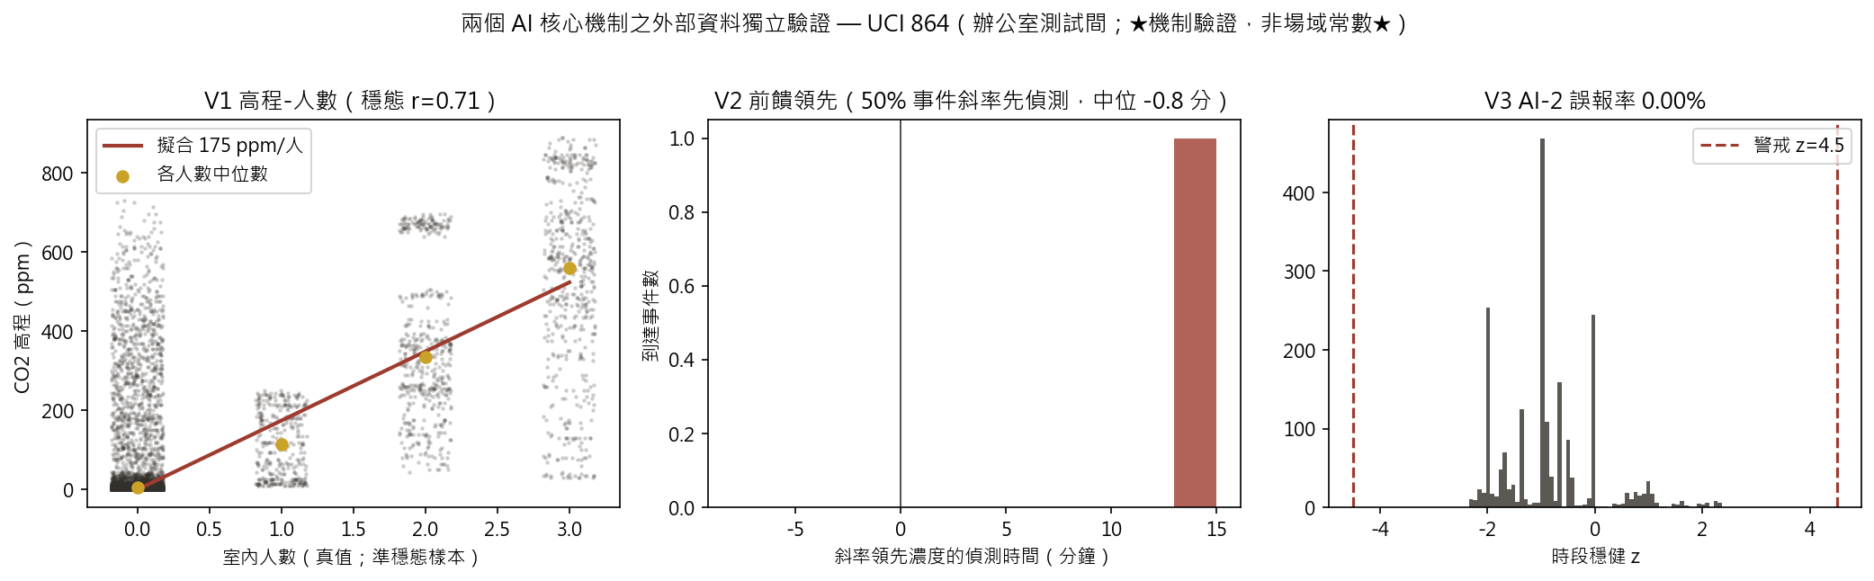
AI訓練/圖表/外部資料驗證.png
