feihong9487/WRO2026/外觀CAD/Screenshot 2026-08-18 145757.png

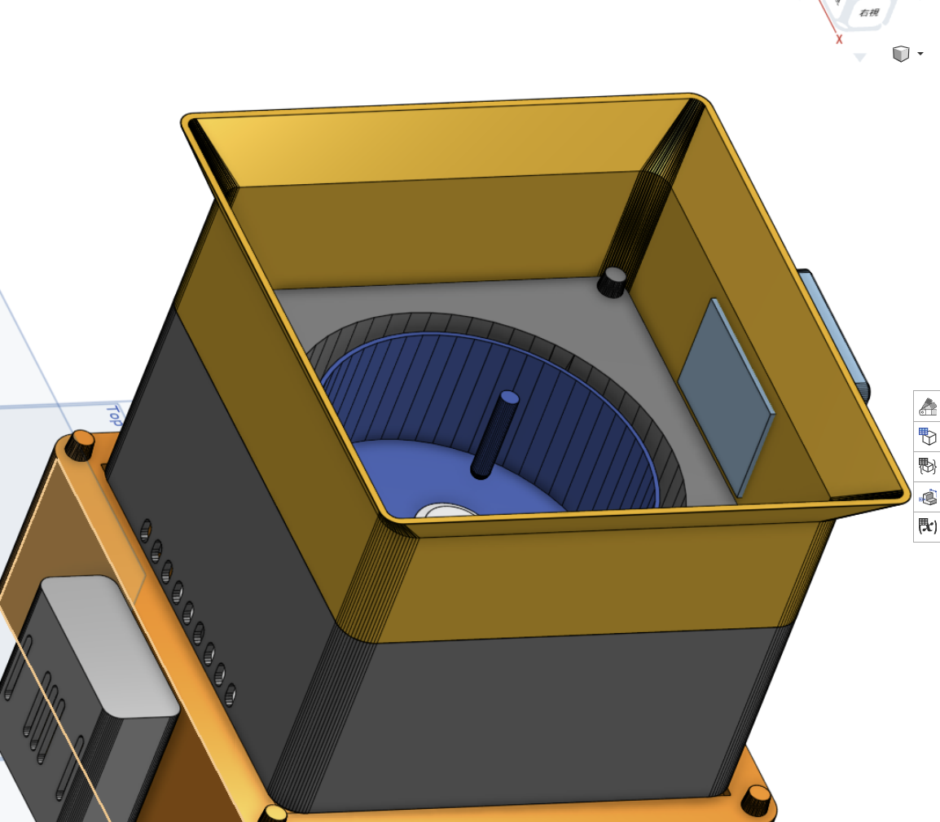
外觀CAD/Screenshot 2026-08-18 145757.png
