feihong9487/WRO2026/簡報/Manus包_三張A1海報/圖表_情境照/images.png

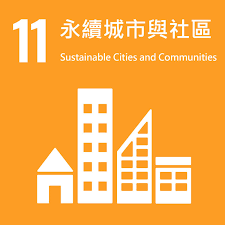
簡報/Manus包_三張A1海報/圖表_情境照/images.png
