feihong9487/WRO2026/簡報/Manus包_三張A1海報/圖表_現有/CAD_view_集煙罩剖面.png

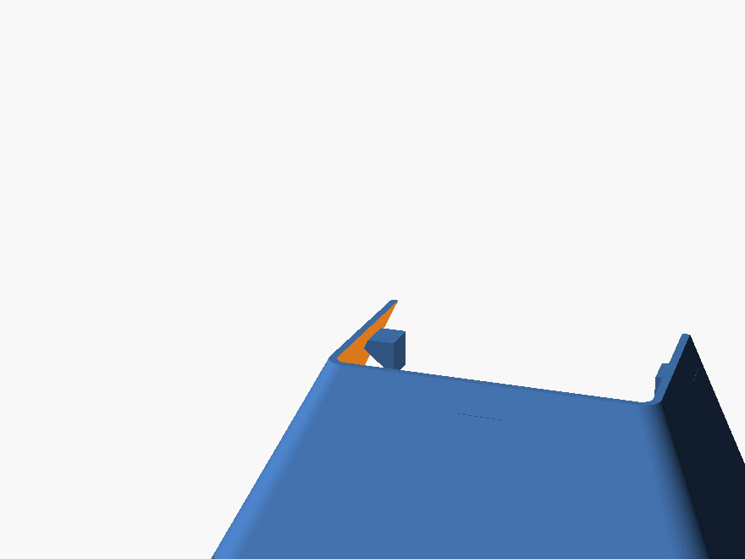
簡報/Manus包_三張A1海報/圖表_現有/CAD_view_集煙罩剖面.png
