feihong9487/WRO2026/簡報/Manus包_三張A1海報/圖表_現有/Screenshot 2026-08-19 212421.png

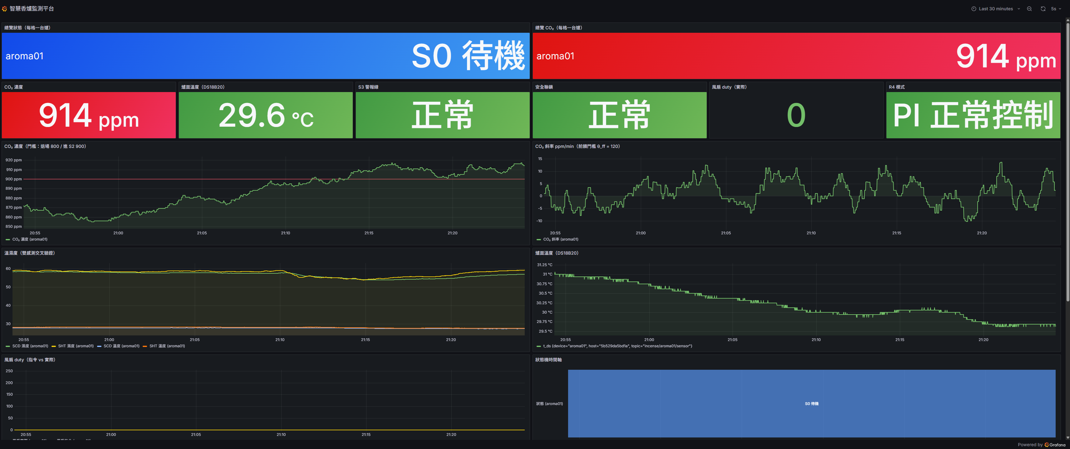
簡報/Manus包_三張A1海報/圖表_現有/Screenshot 2026-08-19 212421.png
