feihong9487/WRO2026/簡報/poster_1_預覽.png

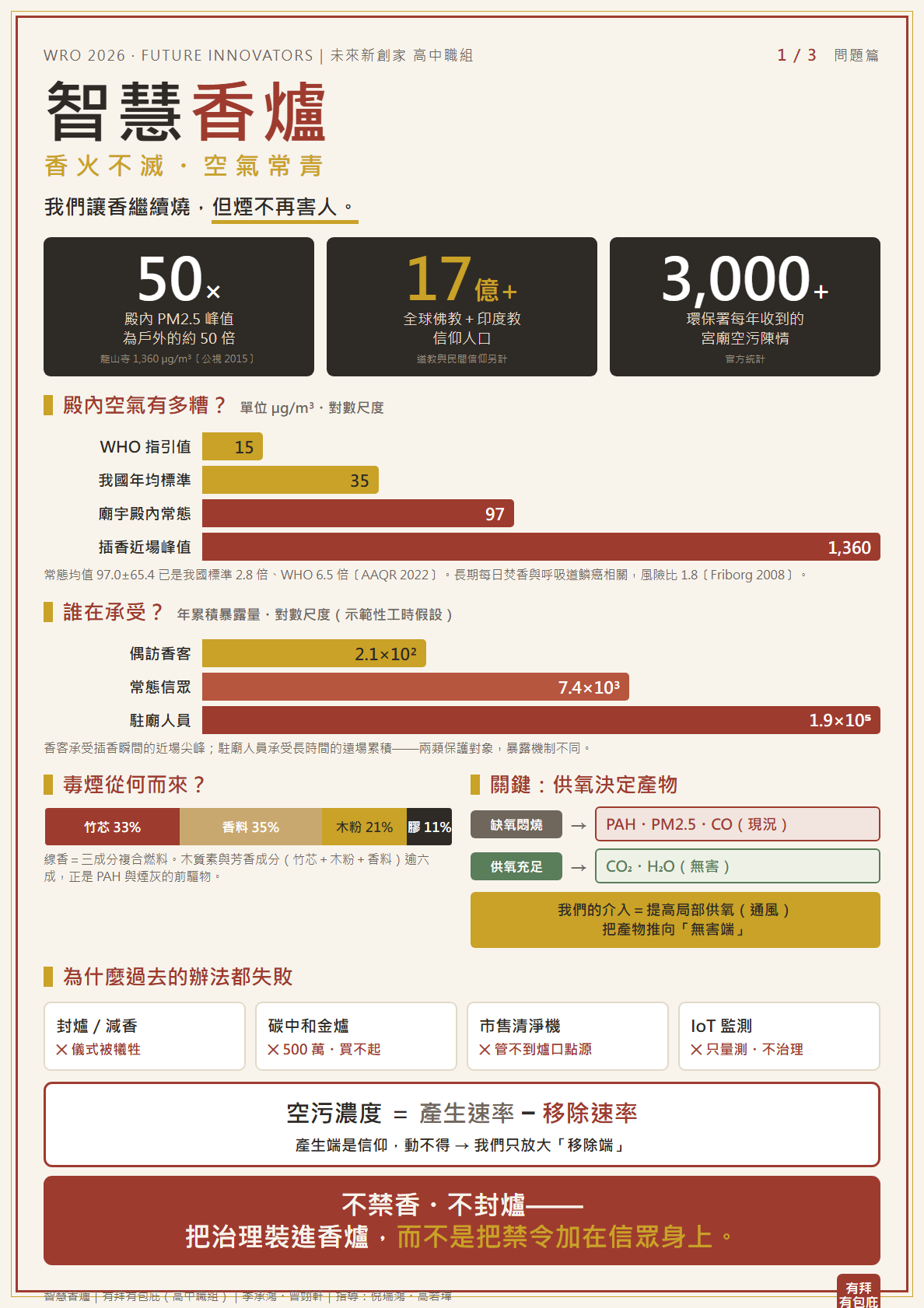
簡報/poster_1_預覽.png
