feihong9487/WRO2026/簡報/創新專案自評表/IMG_5038.jpg

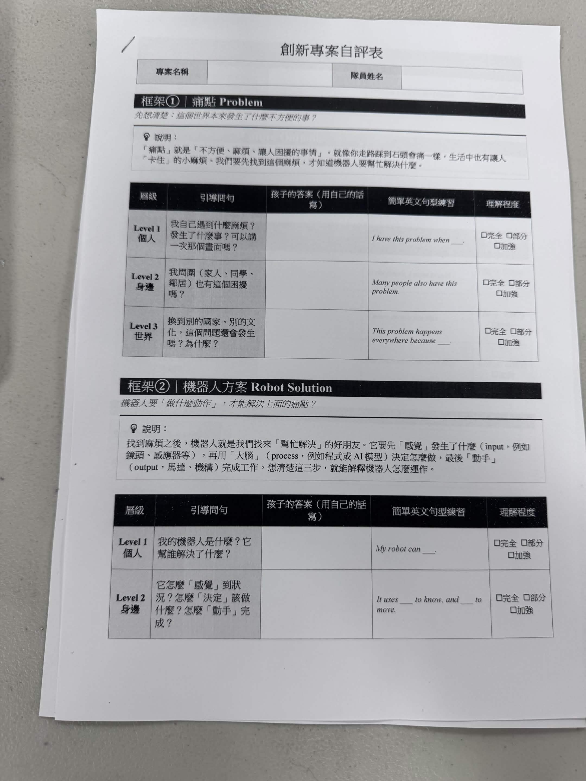
簡報/創新專案自評表/IMG_5038.jpg
