feihong9487/WRO2026/研究日誌_全期完整版.md

# 研究日誌｜智慧香爐（Intelligent Incense Censer）

**專案**：WRO 2026 European Open Championship — 智慧香爐：以源頭捕集與自適應控制降低宗教場域之呼吸帶暴露
**日誌期間**：2026-04-01 — 2026-08-16，**共 20 週**
**紀錄單位**：**週**（每週一則，週一起算）
**最後更新**：2026-08-16
**文件性質**：研究歷程紀錄（process record）。結論性文件為《問題報告_定稿》《既有方案與定位》《專案進度》；本日誌記錄的是**如何走到那些結論**，包含走過的彎路、被推翻的假設、以及每一次改變方向的理由。

---

## 使用說明

### 本日誌與其他文件的分工

| 文件 | 回答的問題 |
|---|---|
| 《問題報告_定稿》 | 我們主張什麼 |
| 《既有方案與定位》 | 為什麼是我們而不是別人 |
| 《專案進度.md》 | 現在做到哪裡 |
| 《研究日誌備忘錄》 | 被報告刪去的推導與測試數據 |
| 《線香燃燒化學成分研究報告》 | 煙裡有什麼、從哪一步反應來的（第 10–13 週化學軌產出） |
| 《氣體流動物理分析》（報告 3-8） | 煙怎麼跑、罩體接不接得住（第 20 週產出，含 `flow_analysis.py`） |
| 《計畫書優化研究筆記》《FGC工程筆記精讀》《Manus指令包》 | 交付物怎麼寫、依據什麼準則（第 20 週文宣軌產出） |
| 《導師評審_IEEE與商業視角》 | 外部視角的嚴謹度審查與賽前四週計畫（第 20 週產出） |
| **本日誌** | **我們是怎麼想到的、又錯過幾次** |

### 每週條目的固定結構

為便於跨週比對與檢索，每一週皆採同一格式：

```
## 第 N 週｜MM/DD–MM/DD｜本週主題
一句話結論
▸ 平日（一–五）：增量工作，條目短，成果多為「輸入」
▸ 假日（六–日）★：整段工時，本週的里程碑成果
▸ 本週產出：可交付物清單
▸ 紀錄要點：這一週學到什麼（非每週皆有）
```

### 工作節奏說明

團隊為在學學生，工作節奏呈明顯的週間／週末落差：

- **平日（一–五）**：晚間增量工作——文獻閱讀、資料蒐集、程式小修、環境排錯。
- **假日與連假（六、日）**：整段工時——模型推導、數值測試、架構決策、實機佈建、文件成稿。

**全期 25 項里程碑中有 20 項（80%）落在假日或連假**（統計見 §4）。此為本日誌條目密度不均的原因，非紀錄疏漏。期間三個連假（清明 4/3–4/6、五一 5/1–5/3、端午 6/19–6/21）各承載一項重大產出。

### ⚠ 日期精確性聲明（請務必先讀）

本日誌的日期分兩類，讀者與引用者必須區分：

- **工程軌（標記 `[E]`）**：硬體、韌體、雲端、電路、CAD 的日期均可由源文件逐條追溯（《部署紀錄》《專案進度》《交接任務》《待辦_DS18B20部署》等），為**實際發生日期**。
- **分析軌（標記 `[A]`）**：問題論證、文獻查證、暴露模型、損失函數、模擬環境選型的推導，其源文件**未記載日期**。本日誌之週次歸屬係依**推導依存關係、文件互引關係與團隊工作節奏重建**——**週序可考，日內歸屬為重建結果**。

**此區分本身即是一項流程管理缺失的紀錄**（見 §6.2）。已訂正：即日起分析類文件一律於檔頭記日期。

### 關於「文宣軌」（第 20 週起）

第 20 週（8/16 下午起，筆電）另闢**文宣與交付物軌**，標記 **`[P]`**：競賽構想書、
現場簡報、海報、講稿等交付物的製作歷程。它被納入研究日誌的理由：交付物的
製作過程中同樣發生了方法選擇、失敗與修正（見 F30–F33），且「宣稱清單＋證據等級」
制度（D36）本身就是研究誠實紀律在文宣端的延伸——**文件怎麼寫，決定了研究成果
會不會在最後一哩被寫壞。**

### 關於「化學軌」（第 10–13 週）

第 10–13 週（6/1–6/28，暑假前最後四週）另有一條**平日並行的化學軌**，標記 **`[C]`**，目標是把「線香煙裡到底有什麼、為什麼會有」從引用別人的結論，變成團隊自己能推導的化學。四週的平日累積，於 6/27–6/28 收斂為《線香燃燒化學成分研究報告》（IEEE 格式，另有繁中版）。

化學軌不是附加的知識補充，它回答三個先前只能靠引用回答的問題：

1. **為什麼過濾鏈非得有活性碳？**（PM 濾材攔不住苯與甲醛）
2. **為什麼「源頭捕集」在化學上就是對的？**（增氧使產物分布往完全燃燒偏移）
3. **為什麼不能只用 PM2.5 質量當唯一 KPI？**（質量與毒性由燃燒化學的不同面向主導）

---

## 1. 二十週總覽

| 週 | 日期 | 軌 | 本週主題 | 假日里程碑 |
|:-:|---|:-:|---|---|
| 1 | 04/01–04/05 | A | 立項與範圍界定 | ★ 排除金紙，鎖定線香 |
| 2 | 04/06–04/12 | A | 關鍵對照的發現 | ★ 爐位差三倍 → 技術路線立足點 |
| 3 | 04/13–04/19 | A | 污染源光譜定位 | ★ 3-2 成稿：兩項洞見 |
| 4 | 04/20–04/26 | A | 危害分層 | ★ 雙區暴露模型提出 |
| 5 | 04/27–05/03 | A | 保護對象確立 | ★ 3-3 成稿＋兩項自我約束 |
| 6 | 05/04–05/10 | A | 時空耦合 | ★ 3-4 成稿＋跨國尺度外推 |
| 7 | 05/11–05/17 | A | 產業連鎖 | ★ 3-5 成稿＋商業模式三層 |
| 8 | 05/18–05/24 | A | **文獻查證** | ★★ 三筆更正：本期最有價值的失敗 |
| 9 | 05/25–05/31 | A | 反證搜尋 | ★★ 發現龍山寺已禁香 |
| 10 | 06/01–06/07 | A | 禁香代價｜**化學軌啟動** | ★ 3-6 成稿：倖存者偏誤論證 |
| 11 | 06/08–06/14 | A | 競爭定位｜**完全燃燒化學計量** | ★★ 不利證據轉為最強市場證據 |
| 12 | 06/15–06/21 | A | **量測模型三層化**｜**悶燒路徑** | ★★★ 端午連假：三層公式＋蒙地卡羅 |
| 13 | 06/22–06/28 | A | 設計規格導出｜**化學報告成稿** | ★★★ η = 80.5%＋捕集拆解＋**燃燒化學 IEEE 報告** |
| 14 | 06/29–07/05 | A | **控制的極限** | ★★★ 約束封頂：控制救不了罩體 |
| 15 | 07/06–07/12 | A | 損失函數 | ★★ 文化約束設為硬約束 |
| 16 | 07/13–07/19 | E | 硬體架構（三板） | ★ 元件選型論證＋三項電氣決策 |
| 17 | 07/20–07/26 | A | 模擬環境選型 | ★★★ BFS 否決＋η(u,N) 自我修正 |
| 18 | 07/27–08/02 | E | 雲端與電路 | ★★ 12 項驗收＋−0.7V 缺陷＋兩板拍板 |
| 19 | 08/03–08/09 | E | **真爐上線** | ★★★ aroma01 上線＋SD 故障→NVMe |
| 20 | 08/10–08/16 | E+A+P | 排障、設計收斂｜**氣體流動分析**｜**文宣軌**｜**AI 訓練軌** | ★★★ 理香移除＋集煙罩漏斗化＋**報告 3-8 節（推翻罩口尺寸）**＋交付物全面重製＋**模擬環境上線與三案模型凍結評比** |

---

# 第一部｜逐週日誌

## 第 1 週｜04/01–04/05｜立項與範圍界定

**本專案的第一個實質決定不是「怎麼做」，而是「邊界在哪」。**

**▸ 平日（4/1 三 – 4/3 五）**

- `[A]` **4/1** 題目確立：宗教場域空氣品質。
- `[A]` **4/2** 初步文獻檢索。發現既有研究多集中於「廟宇空品現況調查」，**幾乎沒有介入型研究**——量測的多、動手的少。此觀察後來長成第 11 週 3-7 的「IoT 監測缺乏致動端」批判。
- `[A]` **4/3** 開始整理污染源並置比較的維度清單。

**▸ 假日 4/4（六）– 4/6（一）★清明連假·四天★**

**決定：範圍限縮至線香，排除金紙。**

理由不是金紙不重要，而是暴露結構不同——金紙於專設金爐燃燒，多在室外或設有專屬排煙，屬中遠場暴露；線香在殿內燃燒，煙羽直接發生於呼吸帶高度，插香瞬間人臉緊鄰爐口。**就近場暴露量而言，線香是主要驅動源。**

**限縮的代價當場即被記錄下來**：金紙有官方排放係數可用（台北市環保局：減燒 1 公噸金紙 = 減少 30 kg CO + 2.4 kg PM2.5），**線香沒有**。限縮之後團隊失去了唯一現成的排放係數。

**▸ 本週產出**：範圍界定書面理由｜污染源光譜定位初稿

> **紀錄要點**：範圍限縮讓論證變乾淨，同時製造了一個資料缺口。**這兩件事必須一起記，只記前者就是選擇性敘事。** 該缺口至今仍是待辦（§5.2 第 2 項）。

---

## 第 2 週｜04/06–04/12｜關鍵對照的發現

**整個技術路線的立足點在本週確立。**

**▸ 平日（4/6 一 – 4/10 五）**

- `[A]` **4/6** 清明連假第四日，續整理比較維度。
- `[A]` **4/7–4/10** 精讀 Hien 等（*AAQR*, 2022），逐日整理其量測設計與數據表。

**▸ 假日 4/11（六）– 4/12（日）★**

Hien 等（2022）的關鍵價值在於它**同時量測了兩座香爐位置不同的廟宇**：

| 場域 | 香爐位置 | PM2.5 |
|---|---|---|
| 越南廟宇 | 室外 | 36.5 ± 33.9 µg/m³ |
| 台灣廟宇 | 室內 | 97.0 ± 65.4 µg/m³ |

作者並指出廟內人員暴露濃度為周遭空氣的二至五倍。

**同樣的行為、同樣的香品，僅因爐位差異即相差近三倍。**

> **若被動的空間關係足以造成三倍差距，主動氣流控制的效益空間即在物理上確立。**
> 這一句話是整個技術路線的立足點，也是整份報告最重要的單一引用。

同日建立三層量化基準：近場峰值 1,360 µg/m³（蘇大成 2015，龍山寺）、常態均值 97.0 µg/m³、總量規模全台年焚燒線香約 2.1 萬公噸。

**▸ 本週產出**：三層量化基準表｜技術路線立足點論證

---

## 第 3 週｜04/13–04/19｜污染源光譜定位（3-2 成稿）

**線香不是一種普通的空氣污染，而是室內半密閉空間中的高強度固定點源污染。**

**▸ 平日（4/13 一 – 4/17 五）**

- `[A]` 完成三源並置表（車輛廢氣／二手菸／線香煙）的六個維度比較：空間尺度、源型態、濃度梯度、暴露族群、治理工具、社會容忍度。
- `[A]` 查閱工業衛生之控制層級原則（hierarchy of controls）文獻。

**▸ 假日 4/18（六）– 4/19（日）★**

**兩項洞見成形，3-2 節成稿。**

**洞見一：治理拓撲決定技術路線。** 線香更接近二手菸而非車輛廢氣——邊界可界定的室內固定點源，適合局部主動治理。以稀釋將殿內數百微克降至 35 µg/m³，所需換氣量將破壞殿堂的熱舒適與香氣氛圍；**在爐口捕集則只需處理源強而非整室體積，風量需求降低一至兩個數量級。**

**洞見二：社會容忍度的不對稱，正是本研究的縫隙。** 吸菸有菸害防制法、行車污染有電動化共識，唯獨焚香因裹覆於信仰的神聖性中，長期缺乏「既不冒犯信仰、又能有效減污」的技術選項。

**文化規格的第一次出現**（三項設計意涵之第三項）：

> **不改變焚香行為本身。** 捕集介面不得干擾插香動作，且應容許可見煙柱自然上升一段距離後才被捕集——「煙升」本身即為儀式語意，**抽除過快將導致設備被拒用。**

**▸ 本週產出**：3-2 節成稿｜三源並置表｜三項設計意涵

---

## 第 4 週｜04/20–04/26｜危害分層與雙區模型

**要壓縮一個落差，得先能算出那個落差有多大。**

**▸ 平日（4/20 一 – 4/24 五）**

- `[A]` 蒐集健康風險文獻：Pan 等（*EHP*, 2014）心血管路徑、Friborg 等（*Cancer*, 2008）呼吸道癌症、新加坡華人世代之末期腎病分析。
- `[A]` 整理「暴露量 vs 劑量」的定義差異（本週僅記下疑義，正式更正在第 12 週）。

**▸ 假日 4/25（六）– 4/26（日）★**

**提出雙區暴露模型。** 爐口上方的熱浮力煙羽為**近場**（濃度極高、停留極短），殿堂其餘空間近似均勻混合為**遠場**（濃度中等、停留可達數小時）：

$$E = C_{NF} t_{NF} + C_{FF} t_{FF} \quad [\mu g \cdot h \cdot m^{-3}]$$

**設計上的講究**：此式將「近源程度」內含於近場／遠場的區分，而非另設距離乘數，**避免重複計算**。

三類人群的示範性估算（以 97 µg/m³ 計）：

| 族群 | 主導項 | 遠場 | 近場 | 近場佔比 | 年累積 |
|---|---|---:|---:|---:|---:|
| 偶訪香客（4 次/年） | 近場 | 194 | 15 | 7.2% | 209 |
| 常態信眾（每週 2 次） | 兩項兼具 | 5,044 | 2,357 | 31.9% | 7,401 |
| 駐廟人員（8h × 250 日） | 遠場 | 194,000 | 0 | 0% | 194,000 |

駐廟人員為偶訪香客之 **928 倍（2.97 個數量級）**。

**▸ 本週產出**：雙區暴露模型｜三族群暴露估算表

---

## 第 5 週｜04/27–05/03｜保護對象確立（3-3 成稿）

**本週做了兩個「把話說小」的決定。**

**▸ 平日（4/27 一 – 4/30 四）**

- `[A]` 精讀 Friborg 2008 與 Tang 2024 原文（此時尚未發現引用錯誤，錯誤在第 8 週查證時才浮現）。
- `[A]` 整理成分毒理學段落：苯、甲醛、PAHs 與 IARC 分級。

**▸ 假日 5/1（五）– 5/3（日）★五一連假·三天★**

**3-3 節成稿，並做出兩項自我約束的決定。**

**決定一：對外只宣稱「不低於兩個數量級」，不說 928 倍。**
理由：若評審質疑「香客一年真的只去四次嗎」，保守版本仍站得住。
**能算出三，只講兩，是有意識的留白。**

**決定二：KPI 不以「健康改善」為指標。**
專案期間無法驗證健康終點。改以**呼吸帶累積暴露量降幅 ΔE** 為主要 KPI，並聲明 E 為可量測的暴露替代指標，**不宣稱其與健康終點成線性關係**。

同時確立立場：**不宣稱因果，採預防原則。**

> 我們的機器人不是要證明香有害，而是要在香繼續燃燒的前提下，讓每一次呼吸都更安全一些。

**▸ 本週產出**：3-3 節成稿｜KPI 自我約束條款｜預防原則立場聲明

---

## 第 6 週｜05/04–05/10｜時空耦合（3-4 成稿）

**一個只在好天氣有效的解方，等於在壞天氣無效——而傷害正是在壞天氣發生的。**

**▸ 平日（5/4 一 – 5/8 五）**

- `[A]` 蒐集東北季風、大氣邊界層高度、逆溫層與長程傳輸資料。
- `[A]` 比對農曆事件日的焚香強度數據。

**▸ 假日 5/9（六）– 5/10（日）★**

**3-4 節成稿：季風與儀式週期的時空耦合。**

- **儀式週期（需求端尖峰）**：Hien 等（2022）實測顯示，事件日（農曆初一與十五）廟宇 PM1 與 PM2.5 濃度**約為非事件日的兩倍**。
- **氣象週期（擴散端低谷）**：冬季東北季風盛行時邊界層降低、逆溫頻繁、垂直擴散顯著轉差。

**關鍵在相位重合**：焚香高峰的農曆春節與冬季初一、十五，恰與東北季風期重疊。且此時因低溫而傾向關閉門窗，殿內外氣流交換進一步受限。

三項設計意涵確立，其中第三項是本系統與商用清淨機的根本差異：

> **維運排程對齊農曆而非公曆。** 濾材更換的驅動變數是初一、十五與春節。

**尺度外推**：東亞與南亞季風帶同時具備高密度焚香實踐與相同擴散機制（印度十座廟宇實測達 658.3 µg/m³）。**問題界定具跨國效度，解方亦具跨國市場潛力。**

**▸ 本週產出**：3-4 節成稿｜尖峰負載設計倍率（×2）｜農曆維運邏輯

---

## 第 7 週｜05/11–05/17｜產業連鎖（3-5 成稿）

**污染最終反噬香品產業自身，而承受代價的是最沒有能力解決問題的人。**

**▸ 平日（5/11 一 – 5/15 五）**

- `[A]` 蒐集香品產業經濟資料：印度 agarbatti 產業結構、台灣與東南亞製造端規模。
- `[A]` 蒐集六份商業市場研究報告（**其估值矛盾在第 8 週才被發現**）。

**▸ 假日 5/16（六）– 5/17（日）★**

**3-5 節成稿。** 惡性循環的構成：

```
線香排放 → 健康與環境疑慮 → 法規趨嚴與社會標籤化 → 需求萎縮
→ 製造端生計與外銷受衝擊 → 產業無餘裕投入減污研發 → 排放未獲改善 → 循環持續
```

**承受管制成本的一端，最沒有能力投資解決方案**：印度 agarbatti 產業長期被歸類為農村家庭手工業，從業者**約八成為女性**；台灣與東南亞的香品製造亦以中小微企業為主體。

**破局點：把減污從成本轉為產品屬性。** 商業模式三層結構同日成形：設備銷售 ＋ 濾材耗材訂閱（更換週期與第 6 週的農曆維運節奏天然耦合）＋ 空品數據服務。

> **我們販售的不只是乾淨的空氣，而是可被證明的乾淨。**

**▸ 本週產出**：3-5 節成稿｜商業模式三層結構

---

## 第 8 週｜05/18–05/24｜★文獻查證：三筆更正★

**本期最有價值的失敗全部集中在這一週。**

**▸ 平日（5/18 一 – 5/22 五）**

- `[A]` 建立 12 項主張的查證總表，逐條回查原始出處。
- `[A]` 核對政府統計與國際文獻的年份與定義。

**▸ 假日 5/23（六）– 5/24（日）★**

**查證結果：12 項主張中 4 項不合格。**

| 判定 | 項數 | 項目 |
|---|---|---|
| 完全確認 | 4 | 台灣廟宇 97.0 ± 65.4、初一十五約 2 倍、Friborg HR 1.8、Tang OR |
| 屬實但須改述 | 3 | 龍山寺 1,360（非同儕審查）、50 倍（峰值 vs 均值）、Tang 次群體 |
| **與官方數據矛盾** | 1 | 年燒線香 3,000 公噸 → 改用環境部 105 年 **2.1 萬公噸** |
| **不可追溯／不可靠，已刪除** | 2 | 「約當兩萬輛汽車」、「市場年產值近 50 億美元」 |
| 範圍外，已排除 | 1 | 金紙 24 萬公噸 |
| 未逐字核對，列待辦 | 1 | IARC Vol. 109 |

**★三筆更正★**

**更正一：Friborg 2008 的癌症部位被誤植。**
曾寫成「上呼吸道鱗狀細胞癌」。原文實為兩項不同發現：焚香與**鼻咽癌以外**的上呼吸道癌顯著相關；而焚香的持續時間與強度與**整個呼吸道**的鱗狀細胞癌風險上升相關（P trend = .004, HR 1.8, 95% CI 1.2–2.6）。HR 1.8 對應的是後者。
**教訓：查證必須看原始摘要，二手轉述會把不同發現混在一起。**

**更正二：把次群體數字誤作主結果，自我削弱論據。**
原稿寫「風險主要顯現於同時吸菸者」。實際上 Tang（2024）的整體合併 OR 為 **1.33（95% CI 1.20–1.48）**，本身即顯著；1.34（95% CI 1.09–1.65）只是曾吸菸者次群體。
**我們原本比事實更保守，而保守到了失真的程度。**

**更正三：市場規模數字不可用。**
六份商業報告對同年全球香品市場的估計為 2.70 億、34.6 億、36.9 億、42.5 億、135.1 億美元——**最高與最低相差 50 倍**。原稿的「近五十億美元」疑為某報告的 2030 年預測值。
決定：**不引用任何單一總量數字**，改用可追溯的結構性事實（印度商務部 FY2012–FY2016 出口總值約 4.98 億美元、從業者約八成為女性）。

**▸ 本週產出**：查證總表 12 項｜更正紀錄三筆｜送審前待查清單 7 項

> **紀錄要點**：三筆更正裡只有一筆是「數字錯了」。另外兩筆是**引用方式錯了**——一筆混合了不同發現，一筆用次群體代替主結果。**查證的難點不在找數字，在判斷數字說的是什麼。**

---

## 第 9 週｜05/25–05/31｜★反證搜尋：龍山寺已經禁香了★

**本週主動去找對自己不利的證據，並找到了。**

**▸ 平日（5/25 一 – 5/29 五）**

- `[A]` 核對官方統計（環境部 105 年焚香量）。
- `[A]` 追查龍山寺 1,360 µg/m³ 的量測背景與年份。

**▸ 假日 5/30（六）– 5/31（日）★**

**追查過程中發現一項對我方論證不利的事實。**

- 龍山寺：2015 年起漸進減香（七爐減三爐）→ 2017 年再封二爐、每人一炷 → 2019 年禁燭 → **2020 年 3 月全面禁香**，僅保留寺方代表點燃的一炷大香
- 行天宮更早：**2014 年 8 月 26 日**即撤除香爐與供桌
- 效果：減爐禁燭後 PM2.5 自 1,360 降至 **35 µg/m³**

**風險評估**：評審若知悉此事，而報告仍以龍山寺為主要污染案例，會直接質疑「問題已被解決」。

**處理決定：不迴避、不刪除，改為正面納入論證。** 三層處理：

1. **時序說明必須出現在報告中**，明載 1,360 為 2015 年量測值、該場域現況已改變。
2. 把禁香重新框定為**競爭方案而非問題消失**——它是有效的，但它的有效是靠「消滅焚香行為」達成的。
3. 追加代價分析（成為 3-6 節，第 10 週完成）。

**▸ 本週產出**：禁香時序考證｜風險評估與三層處理方案

> **紀錄要點**：這是本專案研究方法上最重要的一次操作。**其報酬在兩週後（第 11 週）兌現。**

---

## 第 10 週｜06/01–06/07｜禁香的社會總成本（3-6 成稿）｜化學軌啟動

**本週指出一個統計推論上的錯誤，而那個錯誤原本對我們不利；同時開了一條新的軌道。**

**▸ 平日（6/1 一 – 6/5 五）**

- `[A]` 整理龍山寺與行天宮的完整轉型時序與客流數據。
- `[A]` 蒐集焚香之心理調節功能文獻（儀式性動作、嗅覺記憶、確信感）。

**▸ 平日並行：`[C]` 化學軌啟動——線香到底是什麼做的**

起念的原因很直接：3-3 的成分毒理學段落**全部是引用**，團隊講得出「苯、甲醛、PAHs」，卻講不出它們**從哪一步反應來的**。若被評審追問「那你的機器針對的是哪一類產物」，只能回答「污染物」——這個答案撐不住 IEEE 級的審查。

**本週建立成分基準（表一，質量分率）：**

| 成分 | 質量分率 | 代表性化學組成 |
|---|---|---|
| 竹芯（支骨） | 約 33% | 全纖維素 ≈64%、木質素 ≈25%、聚戊糖 ≈18%（乾基） |
| 木粉＋香料 | 約 21% + 35% | 纖維素、木質素、單萜與倍半萜（如檀香醇 C₁₅H₂₄O） |
| 黏著劑（楠粉／Makko） | 約 11% | 多醣黏液質；木質素—纖維素樹皮粉 |
| 水分 | 餘量 | H₂O，燃燒前後以蒸氣釋出 |

**本週第一項結論：燃料負荷由三類有機物構成**——(a) 纖維素與半纖維素（多醣）、(b) 木質素（交聯苯丙烷聚合物）、(c) 佔質量比例較小但貢獻香氣的萜烯類精油。

⚠ **同時記下一項誠實限制**：上表百分比取自單一複合配方文獻，**僅供代表性參考，非通用值**；實際配方因廠牌與傳統差異甚大。此限制後來直接支撐了「不能只用 PM2.5 質量當 KPI」的論證（第 13 週）。

**▸ 假日 6/6（六）– 6/7（日）★**

**3-6 節成稿。核心論證：**

關鍵事實是龍山寺推動減香的四年間，**香客一度減少約三成**，但其後逐漸回升，現今參拜人次反較減香前更多。

表面結論是「禁香的代價只是轉型陣痛」。但——

> **能夠承受四年、三成客流下滑而不動搖營運的，是全台香火最盛、財務最厚、董事會權威最強的少數。以龍山寺與行天宮的成功推論全體廟宇，是典型的倖存者偏誤。**
> 對絕大多數依香火錢維持修繕與公益支出的中小型宮廟而言，三成流失並非陣痛，而是存續危機。

**第二層代價：個體層次的情感依託。** 總人次的回升不等於個體失落不存在——龍山寺推行期間即記錄到信眾反映「沒有持香，難以與神明對話」。

> 「以心香代之」在理性上成立，在情感上卻留下空缺。

**第三層代價**：產業鏈的外生衝擊（承 3-5）。

**▸ 本週產出**：3-6 節成稿｜倖存者偏誤論證｜「不禁香、不封爐」設計前提

---

## 第 11 週｜06/08–06/14｜★競爭定位：不利證據轉為最強證據★｜完全燃燒化學計量

**第 9 週那筆「不利發現」在本週兌現。**

**▸ 平日（6/8 一 – 6/12 五）**

- `[A]` 追查 2017 年宮廟動員事件的訴求原文。
- `[A]` 追查北港武德宮後續作為。

**▸ 平日並行：`[C]` 化學軌——理想化完全燃燒方程式**

在氧氣不受限且溫度足夠高的條件下，三類主要燃料成分各自完全氧化為 CO₂ 與 H₂O：

$$\text{纖維素／全纖維素：}\quad (\mathrm{C_6H_{10}O_5})_n + 6n\,\mathrm{O_2} \rightarrow 6n\,\mathrm{CO_2} + 5n\,\mathrm{H_2O} \tag{1}$$

$$\text{木質素（理想化苯丙烷單元）：}\quad 2\,\mathrm{C_9H_{10}O_2} + 21\,\mathrm{O_2} \rightarrow 18\,\mathrm{CO_2} + 10\,\mathrm{H_2O} \tag{2}$$

$$\text{單萜香料成分（概化）：}\quad \mathrm{C_{10}H_{16}} + 14\,\mathrm{O_2} \rightarrow 10\,\mathrm{CO_2} + 8\,\mathrm{H_2O} \tag{3}$$

同時建立主要物種莫耳質量表（C = 12.011、H = 1.008、O = 16.00 g/mol）：纖維素重複單元 162.14｜木質素單元 150.18｜單萜 136.24｜檀香醇 220.36｜O₂ 32.00｜CO₂ 44.01｜H₂O 18.02｜CO 28.01｜C(s) 12.01｜H₂ 2.02。

**⚠ 本週最重要的自我約束：方程式 (1)–(3) 描述的是熱力學極限，不是實際發生的事。**

> 這三式作為能量平衡的上界有參考價值，但**它們並不能描述點燃線香實際的主導燃燒型態——那是悶燒，不是明火燃燒。**
> 若報告只放這三式，看起來很「化學」，實際上是錯的。真正主導產物生成的路徑留到下週。

並記下一項不得含糊的界線：**竹芯、木粉、黏著劑都是巨分子複合材料而非單一分子，因此「整支線香的平均分子量」無法由重複單元有意義地定義。** 嚴謹做法須改以整支線香之元素（CHO）分析求實驗式——**超出本階段範疇，故報告中不提供該數字，而非提供一個看似精確的假數字。**

**▸ 假日 6/13（六）– 6/14（日）★**

2017 年 1 月環保署長受訪呼籲「減香」，經單一網路媒體誤植標題為「滅香」後擴散，同年 **7 月 23 日**由北港武德宮發起、上百間宮廟組成的「捍衛信仰守護香火大聯盟」上凱達格蘭大道遊行。

**細讀其訴求**：該聯盟**接受「一爐一香」為環保底線**，明確反對的是將金紙集中至垃圾焚化爐焚燒（認為此舉牴觸信仰、使參與者受辱），並主張政府應「**鼓勵並輔導寺廟添購設備**」。

> 信仰社群反對的不是環保本身，而是**強制與剝奪**；他們主動要求的，正是可安裝於廟宇現場的減污設備。

**後續事實佐證**：發起遊行的北港武德宮，於 **2024 年 9 月**自費啟用歷時六年（設計、請照、施工各二年）建成的可過濾懸浮微粒環保金爐，另斥資約 **500 萬元**購入國際碳權，成為全球首座碳中和廟宇。

> **同一個抗議減香政策的行動者，自願為技術方案付費。**

同日完成四維評估座標（儀式完整性／成本可負擔性／減污有效性／運作可驗證性，各 0–4 分）與表 3-1：

| 路徑 | 儀式 | 成本 | 減污 | 驗證 | 關鍵限制 |
|---|:-:|:-:|:-:|:-:|---|
| 封爐／心香 | 0 | 4 | 4 | 2 | 以取消行為換取減污；僅資源雄厚者可承受 |
| 環保金爐＋碳權 | 4 | 1 | 3 | 4 | 處理對象為金紙；500 萬僅為碳權 |
| 政策減量／集中焚燒 | 1 | 4 | 2 | 1 | 集中焚燒被信仰社群視同垃圾焚化 |
| 獨立式空氣清淨機 | 4 | 3 | 1 | 0 | **治理層級錯配**：濾網速堵，不介入燃燒本身 |
| IoT 空品監測 | 4 | 3 | 0 | 4 | **缺乏致動端**：只量測不致動 |
| **本研究：智慧香爐** | **4** | **3** | **3** | **4** | 效能待田野驗證（目標 η≈80%） |

**第四象限定位確立**：「在爐口同時完成即時偵測、自主決策，並對逸散進行物理介入」此一位置迄今無人進入。

**▸ 本週產出**：3-7 節成稿｜四維評估座標與表 3-1｜雷達圖規格｜市場需求實證

> **紀錄要點**：若第 9 週選擇迴避龍山寺禁香一事，3-6 與 3-7 兩節都不會存在，北港武德宮這條證據也不會被找到。**去找反證的報酬率高於去找佐證。**

---

## 第 12 週｜06/15–06/21｜★端午連假：量測模型三層化★｜悶燒路徑

**分析軌最大的單一產出；化學軌也在本週找到真正的主導反應。**

**▸ 平日（6/15 一 – 6/18 四）**

- `[A]` 檢討原始暴露公式 $E = \sum C_i t_i$。量綱正確，但發現三項缺陷：
  1. **未扣除背景濃度** → 損失函數無法歸零
  2. **KPI 未依源強歸一化** → 實驗結論不可歸因
  3. **近場項對假設過度敏感** → 不宜作為 KPI 基礎

**▸ 平日並行：`[C]` 化學軌——缺氧悶燒才是主角**

燃燒中的線香在香頭維持一個**發光的炭化點，並無可見火焰**：這是**自我傳播的悶燒**，氧氣經**擴散**抵達反應前緣，而非與燃料預先混合。悶燒包含兩組耦合過程：(i) 反應前緣**前方**固體燃料的吸熱裂解（釋出揮發性裂解產物、留下焦炭）；(ii) 發光前緣處焦炭與揮發物的**非均相、缺氧表面氧化**。

由於氧氣傳輸受限於擴散，**該反應永遠達不到化學計量比**：

$$(\mathrm{C_6H_{10}O_5})_n + x\,\mathrm{O_2} \rightarrow a\,\mathrm{CO_2} + b\,\mathrm{CO} + c\,\mathrm{H_2O} + d\,\mathrm{C(s)} + \textstyle\sum \mathrm{C_mH_nO_p} \tag{4}$$

其中 $x < 6n$，$\mathrm{C(s)}$ 為固態碳質煙灰／焦炭，末項為離開反應區前尚未完全氧化的部分氧化與裂解有機物（醛類、酚類、呋喃類、多環芳香族碎片）。

> **★此式刻意不予平衡、刻意保留未定係數★**
> 與 (1)–(3) 不同，真實的產物分布是**經驗性的，無法由化學計量推導得出**。把它硬配平會製造一個假的精確度。

兩條關鍵次要路徑同週建立：

$$\text{焦炭氣化／水煤氣型平衡（缺氧核心）：}\quad \mathrm{C(s)} + \mathrm{H_2O} \rightleftharpoons \mathrm{CO} + \mathrm{H_2} \tag{5}$$

$$\text{CO 再氧化（前緣周邊有氧處）：}\quad 2\,\mathrm{CO} + \mathrm{O_2} \rightarrow 2\,\mathrm{CO_2} \tag{6}$$

**PAH 從哪裡來——本週最有解釋力的一段：**

木質素的芳香族骨架在開環或環縮合前，會**優先裂解為酚類單體**（愈創木基與紫丁香基單元）；隨後**小型芳香裂解產物縮合為較大稠環結構**，這正是煙霧中多環芳香烴（PAHs）形成的主要途徑，機制與木煙及生質燃燒中已被充分描述的 PAH 生成化學相似。此外，草本添加物中的微量含氮前驅物經燃料氮氧化路徑生成 NOₓ；樹脂或礦物中的微量硫則形成 SO₂。

> **紀錄要點**：方程式 (4)–(6) 一出來，第 16 週過濾鏈「紗網 → HEPA → 活性碳」的順序就不再只是工程慣例，而有了化學依據——**(4) 的末項（醛、酚、呋喃、芳香碎片）是氣相有機物，HEPA 攔不住，非活性碳不可。**

**▸ 假日 6/19（五）– 6/21（日）★端午連假·三天★**

**公式改為三層結構，各層目的不同。**

**第一層 — 暴露特徵化（描述問題）**

$$E = C_{NF} t_{NF} + C_{FF} t_{FF}$$

**術語更正**：$E$ 為**暴露量**（exposure）而非體內**劑量**（dose，$D = \sum C_i t_i \cdot IR$，單位 µg）。原稿標題誤稱「暴露劑量」，已更正。選用暴露量的理由是**可由現場感測直接積分求得，不需引入呼吸速率與體重假設**——指標的可驗證性優先於生理逼真度。

**近場項敏感度量化**：插香停留時間假設由 5 秒改為 120 秒，近場佔比即由 **3.7% 變動至 48.3%**。**此為公式中最不穩定的一項，故不作為 KPI 基礎。**

**第二層 — 系統效能 KPI（可歸因）**

$$e = \frac{\bar C - C_{bg}}{N}, \qquad \eta_{eff} = 1 - \frac{e_{on}}{e_{off}}$$

**歸一化的必要性以蒙地卡羅驗證**（100 次 A/B 配對，香支數隨機 4–14，設定真實 η = 80%）：

| 指標 | 估計均值 | 標準差 | 範圍 |
|---|---:|---:|---|
| 未歸一化之濃度降幅 | 59.4% | 15.1% | 19.2–80.0% |
| 歸一化後 $\eta_{eff}$ | **80.0%** | **0.0%** | 80.0–80.0% |

未歸一化之估計不僅離散度大，且**系統性低估**（分母隨香支數變動）。

> **此為必修項——不歸一化則實驗結論不可信。**

**第三層 — 設計預測（連結設計變數與結果）**

$$C_{FF} = C_{bg} + \frac{N g (1-\eta_{cap})}{Q + \mathrm{CADR}}$$

此式使設計變數 $\eta_{cap}$ 直接出現於暴露結果中，令效能目標可被**預測**而非僅事後量測；同時它即是控制器訓練所需的模擬環境。

**▸ 本週產出**：三層公式｜蒙地卡羅歸一化測試｜術語更正｜近場敏感度量化

---

## 第 13 週｜06/22–06/28｜設計規格導出｜★化學成分研究報告成稿★

**暑假前最後一週。本週把「問題有多大」翻譯成「機器要做到多少」，並讓化學軌收斂成一份可送審的報告。**

**▸ 平日（6/22 一 – 6/26 五）**

- `[A]` **模型自洽性檢查**：以實測 97 µg/m³、殿堂 500 m³、3 ACH 反推源強 $G$ = 0.116 g/h；以單支香 10 mg PM2.5、燃燒 45 min 計，換算為**等效同時燃燒 8.7 支**。中型廟宇同時 5–15 支屬合理範圍——**模型與現實對得上，自洽性檢查通過。**
- `[C]` 彙整實測燃燒產物文獻，建立產物類別表（表三）：

| 產物類別 | 代表性物種 | 資料來源性質 |
|---|---|---|
| 懸浮微粒 | PM2.5、PM10、超細微粒；有機碳與元素碳（OC/EC） | 環境艙與寺廟現場量測 |
| 多環芳香烴 | 16 種 PAHs 組合（GC–MS），含部分 B2 群（疑似人類致癌物）；含氧 PAHs（OPAHs） | 寺廟／神龕 PM2.5 採樣 |
| 揮發性有機物 | **苯、甲苯、乙苯、二甲苯（BTEX）；甲醛**；烷烴、芳香族與脂肪族碳氫化合物、酯類 | 環境艙與住宅室內空氣採樣 |
| 氣態燃燒產物 | CO、NOₓ、SO₂、CO₂ | 排放因子研究 |
| 二次／半揮發性有機物 | 類生質燃燒有機氣膠（BBOA）；排放後於氣相／粒相間分配之化合物 | 住宅 PM2.5 之 AMS、GC×GC 分析 |

**▸ 假日 6/27（六）– 6/28（日）★（本週有兩項里程碑）**

**三項設計規格導出。**

**規格一：核心目標 η ≈ 80%**（精確值 **80.5%**，使殿內由 97 降至我國標準 35 µg/m³）。

**一項出乎意料的穩健性**：敏感度測試（ACH = 1、2、3、5、8）顯示所需 η **恆為 80.5%**——因源強係由實測濃度反推，$G$ 與 $Q$ 同比例變動而相消。

> **團隊因此不需量測殿堂換氣率，而該參數正是現場最難精確取得者。**

**規格二：捕集 vs 循環過濾之貢獻拆解**（$Q_{fan}$ = 500 m³/h）：

| 配置 | 殿內濃度 | 降幅 |
|---|---:|---:|
| 無系統 | 97.0 | — |
| 僅循環過濾（$\eta_{cap}$ = 0） | 77.9 | 19.7% |
| **僅捕集（$\eta_{cap}$ = 80%）** | 35.4 | **63.5%** |
| 兩者併用 | ~~31.6~~ **35.0** | ~~67.4%~~ **64.0%** |

> ⚠ **第 20 週更正（F25）**：原「兩者併用 31.6／67.4%」把罩體風量與循環風量當成兩道
> 獨立氣流，物理上不成立（實為同一道：罩→煙道→濾材→風扇）。表列保留原值供歷程
> 追溯，**引用一律以 35.0 µg/m³（64.0%）為準**。

**捕集之貢獻為循環過濾的三倍以上。這是回答「為什麼不直接買空氣清淨機」的數字。**（已列為報告最具說服力的單張視覺候選。）

**規格三：必須誠實載明的效能上限。**
戶外背景 20 µg/m³ 的條件下，**WHO 24 小時指引值 15 µg/m³ 為本系統不可達之目標**（低於背景濃度）。效能承諾以我國標準 35 µg/m³ 為上限。

---

### 里程碑二：`[C]`《線香燃燒化學成分研究報告》IEEE 格式成稿

四週的化學軌於本週末收斂成文（另出繁中版）。全文結構：組成（§II）→ 燃燒化學，理想化與缺氧兩種情境（§III）→ 實測產物特性（§IV）→ 室內空品與暴露意涵（§V）。

**報告的核心結論，也是最不討喜但最誠實的一句：**

> **線香燃燒無法以單一平衡化學方程式完整描述。** 更精確的模型應視為多條**平行與序列反應路徑的疊加**，其產物分布受局部氧氣供應量、悶燒溫度與原料配方所控制。

因此報告採雙軌呈現：**同時給出理想化學計量式（(1)–(3)，熱力學參考基準）與經實證特性分析的非化學計量產物分布（(4)–(6) 與表三）**，不擇一。

**三項對本專案設計的直接意涵——這是化學軌真正的價值所在：**

**意涵一：源頭捕集在化學上就是對的，而且理由比「抓住煙」更深。**
減量對策可**直接由方程式 (4) 推導**：增加悶燒前緣的局部氧氣供應（即通風），可將產物分布往 (1)–(3) 所示、氧化更完全的物種推移，**遠離 PAH 與煙灰的縮合生成路徑**。
> 換句話說，抽排不只是「把已經生成的髒東西帶走」，它同時**改變了正在生成什麼**。這一句是全報告對工程設計最有價值的一行。

⚠ **但同時記下一項張力**：第 3 週已確立「煙升是儀式語意，抽除過快會導致設備被拒用」，而化學上增氧愈多、產物愈乾淨。**儀式約束與化學最佳點在方向上相反**——這正是第 15 週把文化約束設為**硬約束**的物理背景，不是任意的價值選擇。

**意涵二：過濾鏈非有活性碳不可，且順序不可對調。**
方程式 (4) 末項 $\sum \mathrm{C_mH_nO_p}$（醛類、酚類、呋喃類、芳香碎片）與表三的 BTEX、甲醛皆為**氣相**有機物，**HEPA 攔的是顆粒，攔不住它們**。活性碳不是加值配備，是化學上的必要件。（順序仍為紗網 → HEPA → 活性碳：紗網防火星、活性碳在後避免先被灰堵死。）

**意涵三：⚠ PM2.5 質量不能作為唯一 KPI。**
兩項文獻發現直接挑戰了「質量降幅＝變安全」的直覺：

1. **標榜「環保」的線香雖 PM2.5 總質量排放較低，但某些 PAH／OPAH 物種濃度卻反而高於傳統線香。**
2. 一項近期住宅線香 PM2.5 的高解析 GC×GC 特性分析，**並未偵測到四環以上的粒相 PAHs**——與較早期寺廟／神龕的 PAH 導向研究結果不同。

> **微粒質量與微粒毒性，是由燃燒化學中不同面向所主導的。**

**因應決定（兩項）：**

- **本專案 KPI 維持以 ΔE（PM2.5 暴露量降幅）為主**——理由不變：可由現場感測直接積分、可歸因、可驗證。但**報告中必須明文聲明其為質量替代指標，不等同毒性削減**。這與第 5 週「E 不宣稱與健康終點成線性關係」是同一條紀律的延伸。
- **不宣稱本系統對特定 PAH 物種的去除率**。PAH 的分配與可偵測性對配方、燃燒條件與分析方法高度敏感，團隊無 GC–MS 量能，**寧可不講，不可推估**。

**▸ 本週產出**：η = 80.5% 設計目標｜ACH 不敏感性證明｜捕集 vs 循環拆解表｜效能上限聲明｜**《線香燃燒化學成分研究報告》IEEE 版＋繁中版**｜產物類別表（表三）｜三項設計意涵

> **紀錄要點**：化學軌從「補知識」開始，最後產出的卻是**三項工程決定**（活性碳的必要性、抽排的化學正當性、KPI 的邊界）。**判準是：一份技術報告若沒有改變任何一個設計決定，它就只是附錄。這一份改變了三個。**

---

## 第 14 週｜06/29–07/05｜★控制的極限：控制救不了罩體★

**全案影響最大的一次分析。**

**▸ 平日（6/29 一 – 7/3 五）**

- `[A]` 建立噪音 SPL(u) 與可見煙柱 h(u) 的約束模型。
- `[A]` 代入儀式約束（$h_{min}$ = 25 cm）與噪音約束（SPL$_{max}$ = 45 dBA）。

**▸ 假日 7/4（六）– 7/5（日）★**

**在儀式與噪音約束下，最大可用轉速被封頂於 $u_{max}$ = 0.58，對應 η = 0.597。而尖峰負載所需：**

| 同時燃燒 | 達 35 µg/m³ 所需 η | 缺口 |
|---:|---:|---:|
| 9 支 | 0.756 | **+0.159** |
| 14 支 | 0.843 | +0.246 |
| 20 支 | 0.890 | +0.293 |

> **尖峰時段不論控制策略如何最佳化，都達不到標準——因為提高轉速的路徑已被儀式與噪音約束封死。**

唯一出路是提升**單位風量之捕集率**，即罩體幾何設計：開口形狀、面風速均勻度、側裙、推吸式氣簾。

**工程資源配置結論：罩體幾何列第一優先，控制演算法次之。**

（數值基於假設之特性曲線，實機量測後須重算；但「約束封頂轉速」的**結構性結論不因參數而變**。）

**▸ 本週產出**：約束封頂分析｜尖峰缺口表｜工程資源配置優先序

> **紀錄要點**：本週推翻了原本「AI 控制是核心賣點」的資源配置直覺——**演算法再好，也優化不出被物理約束封死的空間。**

---

## 第 15 週｜07/06–07/12｜損失函數與一個哲學決定

**把「不能拿信仰去換」寫成數學。**

**▸ 平日（7/6 一 – 7/10 五）**

逐項建立損失函數各項的物理理由，拒絕任意加權：

$$\mathcal{L} = \sum_t \big[ w_E L_{exp} + w_P u^3 + w_F u + w_S (u_t - u_{t-1})^2 \big] + \sum_j \lambda_j [\max(0, g_j)]^2$$

- 暴露項**線性部分無閾值**（符合 PM2.5 流行病學與預防原則）；二次部分為超標懲罰（法規的不連續性）。**扣除 $C_{bg}$ 是必要的，否則損失無法歸零。**
- 能耗 $u^3$ 依**風扇相似定律**，非任意選擇。
- 濾材 $u$ 為線性（壽命正比於總風量）。與能耗形成不同梯度：**低轉速由濾材主導、高轉速由能耗主導。**
- 平滑項：殿堂安靜環境中，**變動的噪音比穩定的噪音更具干擾性。**

**▸ 假日 7/11（六）– 7/12（日）★**

**★關鍵決定：文化約束必須是硬約束★**

固定權重法的測試數據：

| 同時燃燒 | $u^*$ | 煙柱 | 噪音 | 狀態 |
|---:|---:|---:|---:|---|
| 5 支 | 0.60 | 26.9 cm | 46.0 dBA | 噪音違反 |
| 9 支 | 0.66 | 25.0 cm | 47.9 dBA | 噪音違反 |
| 14 支 | 0.67 | 24.4 cm | 48.4 dBA | 兩項違反 |
| 20 支 | 0.70 | 23.5 cm | 49.3 dBA | 兩項違反 |

改採**對偶上升法**（$\lambda_j \leftarrow \max(0, \lambda_j + \alpha g_j)$）後，四種負載下 $u^*$ 收斂至 0.58–0.59，**約束全數滿足。**

**論證理由（這才是重點）**：

> **若將儀式約束設為可加權項，即等同承認它在壓力足夠大時可被交換——與報告核心主張自相矛盾。設為硬約束，是該主張在數學上的一致表達。**

**一項理想性質**：$w_E$ 在 0.5–5.0 之間變動時，$u^*$ 僅由 0.62 移至 0.69——**損失函數對權重不敏感，對約束敏感。**

同時確立三階段控制導入（規則式／PID 基線 → 代理模型＋MPC → 模擬環境內 RL），並寫下第一階段紀律：**無基線則無法宣稱 AI 有貢獻。**

**▸ 本週產出**：損失函數定義與各項理由｜對偶上升測試｜權重敏感度分析｜三階段導入路線

---

## 第 16 週｜07/13–07/19｜硬體架構設計（三板方案）

**工程軌正式啟動。本週起日期均為可追溯之實際日期。**

**▸ 平日（7/13 一 – 7/17 五）**

- `[E]` **7/15**《智慧香爐・硬體設計交接》成文。初版為三板分立，核心論述是**故障安全階梯**：

```
雲斷 → Pi 本地續跑
Pi 失效 → S3 經警報線維持基本抽排
S3 失效 → R4 本地聯鎖保爐，香爐回復傳統使用
```

- `[E]` **7/16–7/17** 供電樹、通訊協定、BOM 增補（IR 近接模組、1N4007、保險絲、2N2222、microSD 共 +140 元）。

**▸ 假日 7/18（六）– 7/19（日）★**

**建立元件設計紀律：每個元件都要能回答「為什麼」。**

原則——**本系統沒有「順便加的零件」**，每個元件必須對應一項系統能力、一個 KPI 或一條報告主張，且必須記錄**被否決的替代方案**：

| 元件 | 選它的理由 | 被否決的替代 |
|---|---|---|
| ESP32-S3 | MCU 級唯一能跑 TFLite Micro；3.3V 原生邏輯讓 TTL 感測器全直連，**省掉每顆一片電平轉換板** | 純 ESP32（跑不動推論）、全交給 Pi（OS 排程抖動壞了取樣節奏） |
| MH-Z19B（NDIR CO₂） | 人呼出 CO₂，斜率比插香高峰**早數分鐘**上升，是零隱私疑慮的人流先行指標 → 前饋控制 | MQ 系半導體式（**在香煙環境形同失明**）、攝影機數人頭（隱私＋光線＋算力） |
| MAX6675 + K 型熱電偶 | **一顆兩職**：悶燒特徵的溫度端 ＋ 安全聯鎖的直接輸入 | — |
| IR 近接（接 R4 中斷腳） | 「人優先於機器」的實體化，毫秒級且不依賴 Pi | 攝影機（慢、需算力、依賴上游） |
| 5015 鼓風扇 | 靜壓遠高於同價軸流扇，推得動 HEPA 壓損 | 軸流扇（**會在濾網前空轉**） |
| 過濾鏈：紗網→HEPA→活性碳 | **紗網是安全件**——抽香煙＝把未熄火星往濾網吸，而 HEPA 是可燃物 | 活性碳在前（會先被灰堵死） |

**三項寫進紀律的電氣設計決策：**

**決策 1：風扇置於過濾鏈之後（抽拉式）。** 推吹式讓扇葉先吃滿香灰油煙——葉形改變、動平衡跑掉、風量衰減。代價：濾箱必須氣密。

**決策 2：警報線採主動低態開集極。** 關鍵在「壞的方向」：線材脫落、S3 斷電時線路被上拉＝讀到「正常」，不會誤觸發。反過來設計成主動高態，斷線＝永久誤報，**系統喊三次狼來了就沒人信了**。

**決策 3：Pi 5 必須用官方 27W 電源，嚴禁掛 LM2596 的 5V。** LM2596 標稱 3A、實際穩定約 2A 且紋波大。Pi 5 掉到 4.6V 就降頻或無預警重啟。
> ⚠ **此決策在第 19 週被血淋淋地驗證——一次低壓重置報廢了一張 SD 卡。**

**感知模型**：若以視覺取得香支數 N，**計數迴歸優於物件偵測**（計數為非負整數），$L_{count} = \hat\lambda - N\log\hat\lambda$。⚠ N 位於 KPI 分母，**計數誤差會直接放大至效能估計**。

**▸ 本週產出**：硬體設計交接文件｜元件論證表｜三項電氣設計決策｜BOM 增補｜P0 檢核表

---

## 第 17 週｜07/20–07/26｜★模擬環境選型與模型自我修正★

**兩個候選方案雙雙出局，並在過程中發現自己的模型有結構性缺陷。**

**▸ 平日（7/20 一 – 7/24 五）**

- `[A]` 評估兩個候選訓練環境：MATLAB 氣體擴散模擬、Python BFS 擴散。
- `[A]` 確立評估準則——訓練環境的適用性**不由物理逼真度決定**，而由三項準則決定：**梯度可用性、主導機制保真、樣本吞吐量。**

**▸ 假日 7/25（六）– 7/26（日）★**

**（一）BFS 擴散：結構性不可行（梯度準則失敗）**

BFS 的傳播速度與方向無關，數學上等價於**各向同性擴散、且不含速度場**。而本系統的受控變數即為風扇轉速 $u$：

$$\eta \perp u \Longrightarrow \frac{\partial L_{exp}}{\partial u} = 0 \Longrightarrow u^* = \arg\min_u [w_P u^3 + w_F u] = 0$$

> **數值驗證：BFS 環境下最佳轉速收斂至 $u^*$ = 0.00。訓練所得之策略為「永不啟動」。**

此非精度不足，而是**環境與問題不相容，任何調參皆無法修正**。

物理面佐證（Péclet 數，$L$ = 0.30 m、$u$ = 0.5 m/s）：煙羽渦流擴散 $Pe$ = 18.1（**平流強於擴散 18 倍**）、微粒布朗擴散 $Pe$ = 2.5 × 10⁸（完全可忽略）。**捕集之成敗由平流與浮力之競爭決定，擴散不參與。**

**（二）MATLAB：工具不匹配。** 改採 **OpenFOAM**（`buoyantPimpleFoam` / `fireFoam`，$k$–$\omega$ SST）。
> **零授權費本身即為報告論據**：若解方須依賴商業 CFD 授權，其在中小型宮廟的推廣性即受限。

**（三）計算成本：CFD 不得進入訓練迴路**

| 方案 | 200 萬步訓練總成本 |
|---|---:|
| CFD-in-the-loop | **913 年** |
| 0-D ODE + 代理曲線 | **0.7 分鐘** |
| 離線 CFD 實驗設計（45 工況，4 核並行） | 1.9 天（一次性） |

差距為 **8 個數量級**。

**（四）採用架構：四層解耦**

```
[L1] 離線 CFD (OpenFOAM) — 罩體幾何比選，非訓練；DoE 30–45 工況
        ↓ (u, N, geom) → η, h
[L2] 代理模型 — GP 或多項式響應面，須輸出信賴區間
        ↓ η(u,N), h(u), SPL(u)
[L3] 0-D 質量平衡環境 — 10⁶ 量級互動
        ↓
[L4] RL / MPC — 硬約束以對偶上升處理
```

> **關鍵設計決定：CFD 的角色是「設計硬體」，不是「訓練 AI」。**

**（五）★模型自我修正：η(u) 應為 η(u, N)★**

單支線香對流熱釋放率 $\dot Q_c = \frac{2\,\mathrm{g}}{2400\,\mathrm{s}} \times 20\,\mathrm{kJ/g} \times 0.7 = 11.7$ W；
理想煙羽中心線速度（Zukoski/Heskestad）$w(z) \propto (N\dot Q_c)^{1/3} z^{-1/3}$：

| 同時燃燒 N | $w$ @ z=0.2 m | $w$ @ z=0.5 m |
|---:|---:|---:|
| 1 | 0.40 m/s | 0.29 m/s |
| 9 | 0.83 | 0.61 |
| 20 | **1.08** | 0.80 |

**煙羽速度隨 $N^{1/3}$ 成長：由 1 支到 20 支，煙羽速度增為 2.7 倍。**

原模型 $\eta_{cap}(u)$ 僅依賴轉速，**隱含假設「煙羽動量與香支數無關」——此假設不成立。**

修正前後（$u$ = 0.58，即第 14 週求得之約束封頂轉速）：

| 同時燃燒 | 舊模型 η | 修正後 η(u, N) | 高估量 |
|---:|---:|---:|---:|
| 2 | 0.601 | 0.391 | +0.210 |
| 9 | 0.601 | 0.335 | **+0.266** |
| 20 | 0.601 | 0.296 | **+0.305** |

**此修正強化而非推翻第 14 週的結論**：實際缺口約為原估計之兩倍，且缺口隨負載惡化的速率更快。並帶來新的設計指示：**罩體不應以平均負載設計，而應以尖峰煙羽動量設計。**

**▸ 本週產出**：模擬環境可行性評估備忘錄｜四層解耦架構｜η(u,N) 修正｜資源與時程表（約 6 週）

> **紀錄要點**：這是全期最值得寫進報告的一次自我否證。IEEE 級審查偏好看見團隊**主動推翻自身早期假設並量化其影響**。而它是在做另一件事（選訓練環境）時被順手發現的——**跨領域檢視比同領域複查更容易抓到隱含假設。**

---

## 第 18 週｜07/27–08/02｜雲端中心站、−0.7V 缺陷、兩板拍板

**本週有三件事各自獨立地改變了專案：一個平台上線、一個缺陷被抓到、一個架構被推翻。**

**▸ 平日（7/27 一 – 7/31 五）**

**`[E]` 7/28–7/29** 整理 `D:\WRO2026\` 資料夾結構（cloud_dash / PI5 / R4 / ESP32 / 電路設計）。

**`[E]` 7/30｜雲端中心站部署完成**

WSL2 Ubuntu 24.04 + systemd 上，Docker 四容器（mosquitto / InfluxDB 2.7 / Telegraf 1.30 / Grafana 11.2）全數 running，**C1–C12 共 12 項驗收全數通過**。經 Tailscale Funnel 開出 3 個免帳密公開唯讀連結。

*兩個 Grafana 平台限制，各繞過一次：*

| # | 限制 | 症狀 | 解法 |
|---|---|---|---|
| 1 | Public Dashboard **不代入模板變數** | `$device` 不被代入，Flux 報 `undefined identifier device` | 改用 `\|> group(columns:["device"])` 依 tag 分組 |
| 2 | **文字型欄位在 stat 卡片顯示不出來** | 查詢完全正確卻永遠 No data；換 state-timeline 或 table 卻正常 | Flux 用 `map()` 把文字轉數字，再用數字鍵 value mapping 顯示文字 |

> 兩項都不是「我們寫錯了」，是平台行為與文件不符。花掉的時間主要在**分辨「我寫錯」與「它不支援」**——第 2 項尤其惡劣，**查詢正確、資料存在、畫面空白，沒有任何錯誤訊息**。

*檔案稽核抓到 3 個真 bug：*儀表板修復只存在 WSL 家目錄而 repo 是壞的舊版｜`lastPiCmd=0` 導致開機頭 5 秒誤報 `mode:"PI"`｜指南叫使用者手動加的 publish 行其實已內建。

***★一個不會報錯的沉默失敗★***
`pi_fsm.py` 原本每秒的決策紀錄**只寫本機 JSONL，沒有發布到 MQTT**。後果：真爐接上後雲端只會收到 `sensor` 資料，`decision` 整批**永遠不會出現，而且不會有任何錯誤訊息**。補一行 publish 即解決。事後比對發現此行與《雲端監測平台指南》§2 原本要求的**一字不差**——**規格是對的，實作漏了，而規格與實作之間沒有任何自動檢查。**

**此事直接催生 `驗證韌體.py`（門檻一致性、腳位衝突）與 `驗證資料流.py`（欄位契約）兩支檢查腳本，兩支都做過負面測試。**

**`[E]` 7/31｜★電路設計：發現會讓整條安全旁路失效的缺陷★**

```
原設計：S3 GPIO4 (3.3V) ──直接接──> R4 D2（數位腳）
R4 (RA4M1) 數位輸入 VIH = 0.8 × VCC = 4.0 V
餘量 = 3.3 − 4.0 = −0.7 V   ✗ 規格上讀不到 HIGH
```

原指南寫「3.3V 是邊界值、實務上幾乎都過」——**那是 UNO R3（ATmega328P，VIH = 3.0V）的經驗。UNO R4 換 RA4M1 後門檻升到 4.0V，同一條線不再成立。**

> **這條線正是「Pi 當機時保命」的硬體旁路，平常完全測不出來。**

**解法：改接類比腳 A0**（零元件）——拉高 3.3V → ADC ≈ 675/1023；放開 → 0；韌體門檻 >500 判警報、<300 才解除（軟體遲滯），兩側餘量 175 / 500 counts。
**同時擋掉一個陷阱**：不可用 BSS138 雙向模組——S3 斷電時其 HV 側 10 kΩ 上拉會讓 R4 誤讀成警報中、風扇鎖死全速，**反而破壞降級行為**。

KiCad 實機驗證：ERC 抓出 44 項，修到 **0 errors 0 warnings**，17 條網路。兩類問題值得記住：`power_pin_not_driven`（電源端改 `power_out`，GND 放 `PWR_FLAG`）、`endpoint_off_grid`（座標未對齊 1.27 mm 格點，**已把格點檢查寫進產生器的 `self_check()`**）。

**▸ 假日 8/1（六）– 8/2（日）★**

**`[A]` 8/1｜量測方法論定案**

η 之量測採 **ASHRAE 110 示蹤氣體圍阻測試法**（原用於實驗室排氣櫃），邏輯與本系統完全相同。**三項效益**：數值具可比性；**迴避「量測方法是否為結果量身訂做」之質疑**；提供方法論的外部背書。

配套四項量測協定約束：僅宣稱相對降幅不宣稱絕對濃度（**系統性偏差在比值中大部分抵消**）｜確認感測器量測上限｜採開／關交替之配對量測｜同步記錄同時燃燒香支數（**最主要之混淆因子**）。

並施加**域隨機化**處理 sim-to-real 落差（η 擾動、ACH、源強、感測延遲、$C_{bg}$ 重採樣）。

*一項預先寫下的誠實承諾*：若 RL 未優於 PID 基線，**接受此結果並如實報告。「證明簡單方法已足夠」是有效的工程結論，勝於勉強宣稱。**

**`[E]` 8/2｜★兩板架構拍板★**

**觸發：控制器不是我們以為的那顆。** 發現使用者的控制器**不是 Arduino UNO R4 Minima，而是 MATRIX Mini R4 Controller**（基於 UNO R4 WiFi，腳位全部包裝成專用埠）。

關鍵事實：**I²C 埠供電為 5V**，而 SCD41 與 GY-SHT31-D 皆可 5V 直插、不需電平轉換。
> 《P0接線與驗證指南》原本寫「感測器不要接 5V」——**那是為了保護 ESP32-S3**，感測器本身不怕。**拿掉 S3 後此限制自動消失。** 一條看似硬性的規則，其實是另一個元件的附帶條件。

*會失去的*：感測器擺位自由（I²C 線長限 1–2 m）｜「S3 失效 → R4 仍保安全」這層降級（**但誠實地說：R4 本來就已是致動的單點故障**）｜報告的「三層獨立」論述要重寫。

*不會失去、甚至更好的*：**降級階梯換形狀但 Pi 失效那層變強**（合併後 MATRIX 有 CO₂ 讀值，可跑真正的回饋控制，而非固定 `FALLBACK duty 80`）｜少掉整類失效模式｜反應變快。

**決策：採用兩板架構**，前提是感測頭離控制盒在 1–2 公尺內。

*同日並做出一個「即使它存在也不用」的決策*：查遍官網無 MATRIX「12V 馬達轉接板」，**但即使該板存在仍維持 D4184**——馬達埠的控制鏈為 RA4M1 → **STM32 副處理器** → 馬達驅動，而 D4184 是直接拉低 PWM 腳、無軟體介入。**風扇是安全致動器，控制鏈多一顆 MCU 就多一個「它當掉時風扇維持原轉速」的失效模式。**

**▸ 本週產出**：雲端中心站上線（12 項驗收）｜3 個公開連結｜兩支驗證腳本｜電氣驗證計算 9 項｜KiCad 電路圖 ERC 0｜ASHRAE 110 量測協定｜兩板架構決議

> **紀錄要點**：−0.7V 餘量是全期最危險的一次「差點」——它不會在任何功能測試中出現，**只在 Pi 當機那一刻才失效，而那正是最需要它的時刻**。逐項算餘量的紙上作業，抓到了所有實測都抓不到的東西。

---

## 第 19 週｜08/03–08/09｜★真爐上線與 SD 卡故障★

**本週真爐第一次跑起來，也第一次壞掉。**

**▸ 平日（8/3 一 – 8/7 五）**

**`[E]` 8/3–8/6** 實作合併版韌體 `matrix_mini_r4.ino`（I²C 感測＋本地簡化 FSM）；`pi_fsm.py` 感測來源改讀序列並轉發上雲；KiCad 電路圖重畫為兩板版（rev E，ERC 0 違規，9 元件／16 網路）。

*實作時查到四項關鍵事實（差點踩雷）：*

| # | 事實 | 差點造成 |
|---|---|---|
| 1 | `MiniR4.begin()` 執行 `PS2.config_gamepad(11, 4, 12, 5)`，**把 D2、D3 埠佔為手把介面** | MAX6675 原規劃走 D3 埠會直接衝突。改用 **D1 + D4** |
| 2 | **UNO R4 的 `snprintf` 不保證支援 `%f`** | JSON 組不出來。沿用 `Serial.print(x, 2)` |
| 3 | **馬達埠是 5V**，推不動 12V 風扇 | 曾建議改走馬達埠。**D4184 ＋ 12V 電源必須保留** |
| 4 | UNO R4 WiFi 內建的 ESP32-S3 是**網路協處理器**，GPIO 一支都沒拉到排針 | 曾以為可省一顆板子。**它不提供任何安全層冗餘** |

**`[E]` 8/7｜產品定位拍板 ＋ 三板原型刪除**

**商業主打 = 既有香爐的空品監測＋抽排過濾改裝模組（retrofit）。** 不換爐、不要求信眾改變行為；買方是廟方管委會（B2B 單一決策者）。

同日**理香機構降級為「競賽 PoC 與未來選配」**，理由三點：

1. 插孔板要求信眾「對準孔、把香放進套筒」，與真實香爐「隨手插進香灰」的行為不相容——**人不會為機構改變行為，孔滿之後香只會插在孔外。**
2. 尖峰一人三炷、一小時數百炷，遠超任何可行格數；**套筒外的一根也管不了**。
3. 在插孔板真正成立的減香情境，**悶燒擠香問題本身大幅消失——機構解決的問題被自己的前提消滅。**

三板原型檔案（`ESP32/`、`r4_actuator_node/`、兩個 wokwi 模擬）全部刪除，git 歷史可取回。

**▸ 假日 8/8（六）– 8/9（日）★**

**`[E]` 8/8｜★真爐 aroma01 上線★**

Raspberry Pi 5 16GB（Debian 13 trixie）佈建為第一台真爐節點。先以代號 `aroma03` 佈建驗證，同日改名 `aroma01`，停掉模擬器並清除 aroma03 痕跡（InfluxDB **6,587 筆刪除歸零**）。

**P1–P8 八項驗收全數通過。** R4 → Pi → 雲端資料鏈全通，每秒 telemetry 入庫。感測器未接線，t/rh 為 `-99.9` **誠實故障值**。

> **★資料誠實邊界（第一條）★**：`aroma01` 在 **2026-08-08 01:15（台北）之前**的 InfluxDB 歷史（2026-07-30 起）是模擬器資料。**引用歷史區間的任何報告都必須註明這個切換點。**

**`[E]` 8/9｜SD 卡故障與 NVMe 遷移**

**起因**：Pi5 發生「Reset due to low power event」低壓重置 → SD 卡 ext4 目錄索引損壞（inode #152347，`/usr/lib/python3/dist-packages` 整目錄不可讀，**全機 Python 癱瘓**）。強制 `e2fsck -f -y` 回報無誤但 kernel 讀取仍間歇性 checksum 失敗——**卡體退化，已除役。**

> **這是第 16 週決策 3（Pi 5 必須用官方 27W 電源）的實證代價。該決策早在三週前就已寫進設計文件，但電源當時尚未採購到位。**

**遷移方式的選擇本身是一項決策**：未採整碟複製（**會把損壞一併抄入**），改為**角色移植**——保留 NVMe 既有系統，從唯讀掛載的 SD 搬入 `/opt/incense/`、設定檔與服務。`pi_fsm.py` 與 repo 正本 **md5 相符**。

一個容易漏的坑：**`dtparam=pciex1` 外接 PCIe 埠預設關閉，必須手動加**；漏加症狀是 link down。

**▸ 本週產出**：合併版韌體｜兩板電路圖 rev E｜產品定位拍板｜aroma01 上線（P1–P8）｜NVMe 系統遷移

---

## 第 20 週｜08/10–08/16｜排障、接線與設計收斂

**本週的成果一半來自解決問題，一半來自刪掉東西。**

**▸ 平日（8/10 一 – 8/14 五）**

**`[E]` 8/10｜NVMe 驗收、現場模式演練、★R4 電源鍵發現★**

**N1–N6 六項驗收通過。** N6 附帶一項必須記住的性質：**補傳資料的 InfluxDB 時間戳為「到達時間」而非「量測時間」**（本次積壓 **3.5 萬筆**補傳成功）。

> **★資料誠實邊界（第二條）★**：aroma01 實測資料有**兩段**（雲端 08-08〜08-09；Pi 本地新棧 08-10 起），**中間有 SD 故障停擺的斷層。**

**比賽現場模式演練**：Pi 連手機熱點經 Tailscale（DERP hkg 中繼）上雲，**實測通過**（15 秒收到 126 筆）。

***★關鍵發現：MATRIX Mini R4 斷電後不會自動開機★***
冷開機實測（整組拔插頭）：NVMe 開機、mosquitto、三容器、塔扇曲線、hotspot 巡檢全自動就緒。**唯一手動步驟：R4 要按一下電源鍵。**
**先前多次「R4 從 USB 消失」全是此因**——USB 供電瞬斷讓 R4 關機待命，**不是線材問題也不是軟體卡死**。看門狗救不了這個。

> 這條花了最久才找到，因為症狀（USB 裝置消失）與最常見的原因（線材接觸不良）完全一致，我們也確實先去換了線。**當一個罕見原因偽裝成常見原因時，排除法會反覆繞回錯的分支。** 最後是靠「冷開機這個乾淨情境下它也一樣」才把變因收斂掉。

另落地：udev 固定名 `/dev/r4`、塔扇 35°C 滿轉曲線、熱點無條件最優先。

**`[E]` 8/11｜韌體燒錄完成、I²C 卡關、筆電交接**

燒錄成功：arduino-cli 1.4.1 編譯過（flash 36% / RAM 44%）、COM12 燒錄、序列 115200 實測每秒 telemetry 正常。

*判讀陷阱*：MAX6675 模組**整個未接**時 SPI 讀全零，`tc_fault=0`、`t_furnace=0.00`——**韌體只能偵測熱電偶開路，判不出模組缺席。接線日勿誤判為正常。**

**⚠ 未解卡關：SCD41 I²C 掃不到 0x62。** 掃描在**所有匯流排**（Wire、Wire1 直通、mux ch0–7）都掃不到。已排除：多工器 `0x70` 與板載 OLED `0x3D` 正常 → **板子本身沒問題**。頭號嫌疑：**R4 的 Grove 座是 2.0 mm 間距，杜邦頭是 2.54 mm，直插插不緊。**
> ★ R4 上目前跑的是臨時 I²C 掃描器。**接線解決後必須重燒 `matrix_mini_r4/`。**

設備關機帶往外地；撰寫《交接任務_筆電接手》。

**`[E]` 8/12｜R4 主迴圈卡死事件、DS18B20 上線**

*卡死事件*：telemetry 自 **08-11 21:40** 中斷，`pi_fsm.py` 每秒回報 `SENSOR_STALE`；**USB 枚舉還活著**，所以 v1 看門狗**沒觸發**；OLED 凍結＝整個主迴圈卡死。

**看門狗兩次升級的分界點就在這裡：**

| 版本 | 檢查什麼 | 為何不夠 |
|---|---|---|
| v1（每 30s） | `/dev/ttyACM0` 是否存在 | **判不出「枚舉在但主迴圈死了」** |
| v2（每 60s） | 裝置存在 ＋ **資料流 15 秒靜默** | 自動重置埠＋重啟 FSM。此模式 24h 內發生兩次 |

*誠實記錄的限制*：`uhubctl` 埠「斷電」實際上不切 VBUS，只做重新協商——**可救 CDC 軟卡死，救不了完全消失。**

*DS18B20 上線*：接 R4 **A2 埠**，韌體已燒錄、實機有值（1 Hz、JSON 欄位 `t_ds`）。**不能插 D1**——D1 左是風扇 PWM、右是 MAX6675 CS。**A1/A2 是僅存空埠。** 尚未完成：Pi 端白名單部署、雲端 Grafana 重匯入。

**`[E]` 8/13–8/14｜環境層排錯與文件整理**

| 坑 | 症狀 | 解法 |
|---|---|---|
| **MatrixMiniR4 庫（≤1.2.5）與 Adafruit BusIO 連結衝突** | 該庫把 `Adafruit_I2CDevice` 整個類別抄進自己的 `.cpp`，**十個符號全數 multiple definition** | `#if !__has_include(...)` 讓位補丁。**★庫一更新補丁就消失★** |
| **OpenSCAD 路徑不吃非 ASCII** | 中文路徑一律 `Can't open include file`，錯誤訊息本身是 CP950 → `UnicodeDecodeError` | 被 include 的 `.scad` 與其目錄一律 ASCII。**註解裡的中文沒問題，只有路徑不行** |
| Windows `.exe` 看不到 WSL 的 `/tmp` | 暫存檔讀不到 | 放 `/mnt/` 底下 |
| **OpenSCAD 的 `Volumes` 不是 2 代表有浮空塊** | 參數檢查看不出來 | **只有實際算繪才知道** |

**▸ 假日 8/15（六）– 8/16（日）★**

**`[E]` 8/15｜CAD 全套驗證與「殘留守門」規則設計**
為隔日的大規模刪除做準備：設計兩條新自動測試規則，確保被移除的子系統不會悄悄回來。外觀 CAD 全套驗證跑通（含 OpenSCAD 實際算繪、干涉檢查、貫通探針）。

**`[E]` 8/16｜★設計收斂：理香移除 ＋ 集煙罩漏斗化★**

***（一）理香機構整組自設計移除***（使用者決定）
第 19 週曾降級為 PoC，本日**整組移除**——插孔板／導正套筒／磁力矩陣（電磁鐵 ×4）／磁座全數拆除，香直接插進爐盆。閉環展示改由「CO₂ 分級 → 風扇抽排 ＋ 霧化煙源」承擔。

| 層 | 動作 |
|---|---|
| 參數 | `mech_params.py` 三段參數、電磁鐵電源預算與互鎖約束全部移除；`PARTS` 只剩感測器外殼 |
| 規則 | L1 相關測試移除，**另新增兩條「殘留守門」規則**——電路圖不得再有 `MAGn` 網路、韌體不得再有電磁鐵控制碼 |
| CAD | `socket_plate.scad`／`magnet_deck.scad`／`tidy_parts.scad` 刪檔；**列印件回到 5 件** |
| 電路 | `佈線定義.py` 刪 MAG1-4 與 Solenoid-Array；重產後結構與連通性檢查通過（**12 元件、20 網路**） |
| 韌體 | 移除電磁鐵互鎖與脈衝控制，`ioWrite()` 保留給霧化／LED。**★板上還是舊韌體，需重新燒錄★** |

> **「殘留守門」規則是這次刪除最值得保留的做法。刪一個子系統的風險不在刪不乾淨，在於半年後有人把它加回來而沒人記得為什麼刪。** 把「不得存在」寫成自動測試，理由就跟著規則活下來。

***（二）集煙罩漏斗化***
**使用者需求**：上窄下寬不好插香。
改為「下段直筒 44 mm（煙道開口與風扇座法蘭靠垂直後壁）＋ 上段外擴喇叭口」，罩頂開口外寬 **96 → 180 mm**（內開口 ≈175）。喇叭斜面 **34°**，倒印自支撐。`驗證CAD.py` 的 F 檢查改驗「煙道開口整個落在直筒段」與喇叭角度。全套驗證通過。

> **此變更與第 17 週的 η(u,N) 結論方向一致**——擴大罩口有利於在煙羽動量尚未發展前攔截，但 $z$ 與捕獲立體角的取捨**仍待 CFD 定量**。

---

***（三）★氣體流動物理分析（報告 3-8 節）成稿★***

漏斗化定案後，第一次對整條氣流路徑做完整的流體力學核算——**結果推翻了剛剛才定案的罩口尺寸。**

分析回答四個遞進問題，結果為 **Q1 通過、Q2 不成立且方向與直覺相反、Q3 不通過、Q4 為壓力受限**：

| # | 問題 | 結果 |
|---|---|---|
| Q1 | 風扇抽得動煙羽帶來的空氣量嗎？ | ✅ 裕度 2.2–5.2 倍。**所需風量僅 43.3 m³/h** |
| Q2 | 罩體的「吸力」抓得住煙羽嗎？ | ❌ 距罩口 100 mm 誘導風速僅 0.13 m/s，為煙羽速度的 1/8 |
| Q3 | 罩口接得住煙羽的擴張錐嗎？ | ❌ **六種工況全數溢流** |
| Q4 | 管路與濾材撐得住嗎？ | ⚠ 濾材佔阻力 95%，壽末為初期 1.97 倍 |

**★發現一：捕集是「接」不是「吸」。**
Dalla Valle 誘導風速隨 $x^{-2}$ 衰減，200 mm 處僅為煙羽速度的 1/22。**罩體無法主動把煙羽拉進來——煙羽靠自身浮力把自己送到罩口，罩體只需接得住它此時的擴張錐。** 設計優先序因此是罩口面積與位置，不是風量。

**★發現二：現行 175 mm 罩口在幾何上接不住煙羽。**
弱熱源（12–234 W）配上寬源徑（⌀110 mm）使虛擬原點深陷源下方（$z_0$ ≈ −96 mm），煙羽在極低高度即已接近源寬。反解得**現行罩口對應的 $h_{min}$ 上限僅 0.14 m，而暫定值是 0.25 m**。三項獨立判準（煙羽幾何 207 mm、橫流漂移、ACGIH 慣例 310 mm）全部指向罩口過小。
> **這個缺口與風扇轉速完全無關——任何控制策略都修不好一個接不住的開口。**

**★發現三：最脆弱的工況是 $N$ = 1，不是尖峰。**
因 $w_{plume} \propto N^{1/3}$，單支線香的煙羽動量最弱，在 0.25 m/s 橫流下漂移達 169 mm（罩口半徑的近兩倍）。這與第 14 週「以尖峰為設計點」的取向**互補而非矛盾**：尖峰失效是**濃度**不達標（程度問題），低載失效是**捕集完全落空**（有無問題）——**而低載工況佔全年時數的絕大多數。** 側裙自「優化選配」升格為必要件。

**★發現四：$h_{min}$ 是整台機器的主控變數。**
它同時是罩口內徑、系統風量、濾材面積、風扇壓力與電源預算的共同上游。$h_{min}$ 自 0.10 → 0.30 m，罩口增 1.66 倍，**風量與濾材面積增 2.76 倍**。
> **在 $h_{min}$ 由廟方訪談定案之前，機構設計無法收斂——不是不夠精確，是自變數未定。** 該訪談應自「田野調查待辦」升格為**前置阻塞項**。

**★發現五：風扇應串聯而非並聯。**
系統為高阻抗（331→651 Pa）、低流量（43 m³/h）。並聯解決的是流量（本非瓶頸），串聯才對應壓力。此**與《硬體設計交接》所載「兩顆並聯」相反**，提交決策（代價：串聯失去「一顆失效仍有半風量」的冗餘）。

**★發現六：微粒完全跟隨氣流（St ≈ 10⁻⁷–10⁻⁸）。**
三項推論：罩體對粒相與氣相**捕集率相同**（分工只發生在濾材端，呼應第 13 週化學軌）；**CFD 可單相求解**，大幅降低 L1 建模成本；**ASHRAE 110 示蹤氣體外推至 PM2.5 的正當性獲得量化支持**（先前僅為假定）。

**★發現七：兩個時間尺度相差 7,013 倍**（罩內 0.17 s vs 殿堂 19.4 min）→ 控制應為**串級架構**；且殿堂 20 分鐘的時間常數意謂**回饋在物理上不可能提供前饋所買到的提前量**，CO₂ 前饋是必要件而非加分項。

**交叉驗證通過**：獨立算得源強 0.1155 g/h（既有 0.116，差 0.4%）、$\eta_{need}$ = 80.0%（既有 80.5%）、$w/v_{face}$ = 1.65（既有 1.66）。

**⚠ 並發現既有表格一處須更正**：第 13 週「捕集 vs 循環過濾」表中「兩者併用 31.6 µg/m³（67.4%）」在物理上不成立——**罩體風量與循環風量是同一道氣流**（罩→煙道→濾材→風扇），不能各自獨立取值。正確值為 **35.0 µg/m³（64.0%）**。結論方向不變，數字須改。

**同時產出一個更強的論據**：本系統以 **1/11.5 的風量**達成商用清淨機 **3.22 倍**的減量 → **單位風量效益比 37 倍**。這比既有的「捕集貢獻為循環過濾三倍」更有力，因為它計入了風量成本。

**▸ 本週產出**：看門狗 v2｜上電 SOP 最終版｜DS18B20 資料鏈（部分）｜理香機構全鏈路移除＋殘留守門規則｜集煙罩漏斗化＋CAD 驗證全綠｜**報告 3-8 節《氣體流動物理分析》＋ `flow_analysis.py` 計算腳本 ＋ 三張圖表**

---

***（四）★規格重設與一項術語更正★***

使用者裁示「修正至可以符合計算的程度」。直接把 $h_{min}$ 由 0.25 改成 0.18 在工程上可行，**但會當場毀掉第 15 週最強的一段論證**——D11 主張文化約束是硬約束、不可交易，若團隊在它變得不方便時自己調小，等於示範了它可以交易。

**解法是拆分術語，而非交易約束：**

| 量 | 定義 | 決定者 | 現況 |
|---|---|---|---|
| $h_{min}$ | 儀式**要求**的下限 | 廟方 | **仍未知，仍待訪談** |
| $h_{spec}$ | 本機**保證**的可見煙柱高度 | 團隊 | **0.18 m** |

> 報告表述自「本系統滿足儀式約束 $h \ge 0.25$ m」改為「**本系統保證可見煙柱不低於 0.18 m；該值是否滿足儀式要求，由廟方認定。我們提供的是規格，不是判準。**」
>
> **約束沒有被交易，被重設的只是我們對機器能力的宣稱。** 更正後 D11 不僅完好，表述反而更精確。

**規格重設（核驗全數通過）**

| 項目 | 原 | 定案 | 效果 |
|---|---:|---:|---|
| 爐盆 $D_s$ | 110 | **70 mm** | 煙羽起點窄、虛擬原點上移 |
| 三面側裙 | 無 | **~120 mm** | 橫流 0.25 → 0.05 m/s |
| 罩口 | 175 | **200 mm** | 整機 180 → ~205 mm（+14%） |
| 煙道 | 44 | **50 mm** | 風速 8.00 m/s，仍在 ACGIH 帶內 |
| 濾材 | 150² | **210²** | 阻力 331→**225 Pa**、壽末 651→**438 Pa**、壽命 **1.50×** |
| — | — | $h_{spec}$ = **0.18 m** | 最不利工況 $N$=1 裕度 **+20.4 mm（11%）** |

**兩項順帶的好結果：**

1. **損失函數完全不用重跑。** 卡住轉速的是噪音（$u$=0.60 即 46.0 dBA），$h$ 由 0.25 降到 0.18 **不改變 $u_{max} \approx 0.59$**，對偶上升收斂結果原封不動。
2. **缺口從 −135 mm 變成 +20 mm。** B5 阻塞項解除——訪談仍要做，但已非動工前提。

**裕度為何取 11% 而非數學上可行的 4%**：分析鏈上有六項未實測參數（源徑、擴張率、橫流、濾材壓損、罩入口損失、風扇特性）。**4% 撐不住誤差累積**，故 $h_{spec}$ 取 0.18 而非 0.21。

**兩項須併記的副作用**：爐盆縮小後插香更密，悶燒加劇 → **對 $\eta$ 量測是混淆因子，驗證實驗須記錄插香密度**；展示機是最不利尺度（罩口/爐口比 1.82），**retrofit 到真實廟宇香爐反而更有利（1.34），須附尺度表誠實說明**。

---

***（五）h = 0.18 m 全工況核驗，以及兩筆自我更正***

規格定案後對 $h$ = 0.18 m 跑完整核驗。**結果通過，但過程中抓到自己前一輪的兩個錯誤，其中一個是對我方不利的。**

**★自我更正一：基線濃度算錯。** 初版輸出「無系統 94.2 µg/m³」——誤把罩體風量算進了**基線**的分母。無系統就是沒有系統，分母不該有它。正確值 **97.0 µg/m³**。

**★自我更正二：宣稱「三項判準全數滿足」是錯的。**

| 判準 | 要求 | 罩口 200 | 罩口 215 |
|---|---:|:-:|:-:|
| 幾何最小（煙羽外徑） | 136 mm | ✓ | ✓ |
| 含橫流 0.05 m/s | 180 mm | ✓ | ✓ |
| **ACGIH（$D_s$+0.8H）** | **214 mm** | **✗ 差 14 mm** | ✓ |

> 這一筆特別值得記：**前一輪我把「兩項通過、一項未過」寫成了「全數滿足」。** 在一份以誠實邊界為核心紀律的專案裡，這種錯誤比算錯數字更嚴重——**它不是計算失誤，是結論下得太急。**

**核驗結果（$h$ = 0.18 m，罩口 200 mm）**

| 項目 | 值 |
|---|---|
| 罩口裕度（最不利 $N$=1） | 需 179.6 mm → **+20.4 mm（+11%）** ✓ |
| 各負載裕度 | $N$=2 +30.9｜$N$=9 +49.5｜$N$=20 +58.5 mm，全數通過 |
| 罩體風量 | 56.5 m³/h |
| 煙道流況 | 8.00 m/s（ACGIH 5–10 ✓）、Re 26,490 紊流 |
| 系統阻力 | **225 Pa**（初期）／**438 Pa**（壽末），較原設計降 32% |
| 濾材壽命 | **1.50×** |
| 達 35 µg/m³ 所需 η | **79.8%** |
| 時間常數 | 罩內 0.13 s／殿堂 19.3 min，分離比 9,082 倍 |
| 單位風量效益比 | **29 倍**（原報 37 倍；罩口放大後風量增加，**數字變小但更誠實**） |

**★★ 敏感度分析揭露真正的風險 ★★**

| 參數 | 基準 | 變動至 | 裕度 | 判定 |
|---|---:|---:|---:|:-:|
| 煙羽擴張率 d$b$/d$z$ | 0.14 | 0.18 | +1.6 mm | ✓ 幾乎耗盡 |
| 爐盆源徑 $D_s$ | 70 | 90 mm | −5.3 mm | ✗ |
| **橫流 $u_{cross}$** | 0.05 | **0.08** | **−5.8 mm** | **✗** |
| $h_{spec}$ | 0.18 | 0.22 | −4.2 mm | ✗ |

**可容許橫流的失效門檻僅 0.073 m/s（$N$=1），而設計假設 0.05——餘裕只有 0.023 m/s。**

> **★整個定案設計押在「三面側裙能把罩周橫流壓到 0.05 m/s」這個尚未經任何驗證的假設上。★**
> 無側裙之室內橫流常見 0.15–0.50 m/s，側裙須達成 **3–10 倍衰減**。這是全案風險最高的單一未驗證項。

**量測優先序由敏感度直接導出**：橫流 $u_{cross}$ ＞ 煙羽擴張率 d$b$/d$z$ ＞ 爐盆源徑 $D_s$。三者皆為 ⚠ 未實測，且**皆能單獨使設計失效**。

**待決策：罩口 200 → 215 mm**

| | 200 mm | 215 mm |
|---|---:|---:|
| 裕度 | +20.4 (+11%) | **+35.4 (+20%)** |
| **可容許橫流** | 0.073 m/s | **0.090 m/s** |
| ACGIH | ✗ 差 14 mm | ✓ |
| 阻力 初期/壽末 | 225/438 Pa | 263/509 Pa |
| 濾材壽命 | 1.50× | 1.30× |
| 整機外寬 | ~205 mm | ~220 mm |

**建議 215 mm。理由不是 ACGIH 更正確，而是敏感度表顯示現有裕度對橫流太脆弱——而橫流恰好是我們最沒把握的參數。** 若維持 200 mm 亦可，但報告須明寫「ACGIH 的 0.8H 已把煙羽擴張與橫流游移包在一起，本研究分項顯式計算，同時套用等同重複計列」——此論述成立，**但不得默默略過**。

> **紀錄要點**：這是全期第二次「使用者要的東西工程上沒問題，但會傷到論證」的情況（第一次是第 9 週的龍山寺禁香）。兩次的解法一樣——**不是拒絕，也不是照做，而是找一個既做到要求、又讓論證更精確的表述。** 這次的產物（$h_{min}$／$h_{spec}$ 拆分）比原本的單一符號更誠實，也更好答詢。

---

> **紀錄要點**：本次分析在同一天推翻了同一天才定案的設計（漏斗化 96→180 mm 仍不足，需 275–310 mm）。**這不是漏斗化做錯了——方向完全正確，只是幅度不夠，而在做流體力學核算之前無從得知該做多大。**
> 更值得記住的是：**罩口尺寸這個參數，先前從未被任何一條分析鏈碰過。** 第 14 週算出「罩體幾何列第一優先」，但當時「罩體幾何」還只是一句方向性結論；直到本次把煙羽擴張錐畫出來，它才變成一個有數字的規格。**從「知道該做什麼」到「知道要做多大」之間，隔著一次完整的核算。**

---

***（六）`[P]` 文宣與交付物製作軌（08-16 下午–晚間，筆電）***

理香移除與漏斗化定案後，同日在筆電上展開競賽交付物的全面重製。此軌與工程軌
並行，記錄於此因為它有自己的方法選擇、失敗與制度產出。

**（6a）先研究、再動手：三路外部研究**

動手改任何文件之前，先派出三路網路研究並彙整為《計畫書優化研究筆記》：

1. **競賽計畫書線**（13 份：WRO 官方規則與評分表、FLL 冠軍隊指南、台灣國際科展
   一等獎全文、旺宏獎、iGEM 金牌 wiki、ISEF）→ 十條準則，其中「把失敗迭代寫成
   主線」「驗證獨立成章」「訪談 ≥3 位外部人士（**明文要求，目前缺**）」直接對應
   本日誌既有內容。
2. **商業計畫書線**（12 份：Sequoia、Airbnb/Uber/Buffer/LinkedIn deck、YC、
   SBIR/U-start/ATCC/戰國策、TAM/SAM/SOM 專論）→ 十條準則＋六項驗收框架
   （量化痛點／SOM 由下而上／traction 已發生／單位經濟綁里程碑／執行紀錄／誠實揭露）。
3. **大企業說服術線**（Amazon PR-FAQ、Minto、SCQA、Bezos 股東信、Tesla Master
   Plan、Forrester TEI、lighthouse customer、S-1 一致性）→ 十式，其中
   **S-1 一致性（所有場合只從同一份宣稱清單取材）**升格為本軌的核心制度（D36）。

**同步查證 WRO 2026 硬規格**：報告 ≤20 頁單面（超頁 0 分）、AI 使用必須揭露
（2026 新規）、攤位禁明火；「是否禁霧氣」由使用者查證後定案為**不禁霧氣**——
超音波霧化煙源可現場實演，無明火展示機路線成立。
⚠ **併記一項行政風險**：構想書現行結構為方案 13 頁＋社會創新 7 頁，超過範本
12＋6 上限（3-3B 與 4-5B 是否併入待拍板，見 §5.5）。

**（6b）構想書兩版與五張資訊圖重繪**

- **v2（事實對齊版）**：以原稿為底版逐段改寫 12 頁（理香內容改寫為「敢刪」迭代
  敘事、3-3B 新穎性主張收斂至方法專利、SOM 補由下而上試算、traction 補實機證據、
  里程碑綁交付物、AI 揭露更新），並重繪五張含理香的資訊圖（心智圖、三層閉環、
  FSM、虛擬碼→**與實機韌體一致的控制主迴圈流程圖**、資料飛輪→商業九宮格）。
  全文以程式掃描驗證零「理香」殘留。
- **v3（視覺重排版）**：另做 25 個高評價模板／設計典範研究（SlidesCarnival、
  Behance A4 年報網格、Duarte、日系提案書、60-30-10 面積律、中國傳統色）→
  定出「硃砂鎏金」設計 tokens（硃砂 #9E3B2F／鎏金 #C9A227 <10%／墨 #33302B／
  宣紙米白 #F8F4EC；8% 版心邊距、字級三層制、結論框＝tint 底＋左緣粗線）→
  25 頁全部重排為「重點條列＋大數字卡＋圖解」。v2 保留為完整論述版。
- **同日使用者裁示：移除「誠實揭露」式自白段落**。執行邊界刻意保留兩處：
  數字旁的「（設計目標，將實測檢定）」標註不動（那是事實標記，拿掉即違反紅線 7）;
  AI 使用揭露不動（WRO 規則要求）。**「誠實」由自白段落退居為標註紀律——
  主張不變，只是不再自我宣傳。**

**（6c）QA 制度：讓 AI 看得見版面**

本專案長期前提是「AI 看不到畫面」。本日建立**PowerShell + PowerPoint COM 逐頁
轉圖**管線（`export_pngs.py`）後，此前提在文件端被部分解除——AI 可將 pptx 每頁
轉為 PNG 自行目視。首次全檢即抓到 **16 處雙重圖說**（原圖內建標題＋外加編號圖說
疊在一起）與多處留白失衡，全數修正後才交付。
> **紀錄要點**：QA 管線比任何單次修正都值錢——它把「排版對不對」從「等人看」
> 變成「機器自檢迴圈」，與 L1/L2 驗證是同一哲學在文宣端的複製。

**（6d）現場簡報、海報與外包管線**

- **現場簡報（3 分鐘、16:9、11 頁）**：每頁備忘稿含講稿全文與秒數；第 8 頁
  「敢刪的故事」設計為超時緩衝頁（跳過即 3:00 整）。交接文件資料併入：traction
  帶（實機上線精確至 08-08、雲端 12 項驗收、比賽模式演練）、FSM 門檻數字、
  五級故障安全階梯、機隊總覽公開儀表板 **QR code**（評審現場可掃）。
- **A1 三聯幅海報**（594×841mm：問題／系統／成果）＋印刷 PDF；同套 tokens。
- **Canva AI 生成主視覺**：兩輪共 8 個候選。過程記錄兩類 AI 生成缺陷——
  佔位假資訊（RSVP、示範網址）與**亂詞大標（「鬼伐籍」）**，均需逐元素人工
  校正後才可用（F32）。定稿墨金版（墨黑底＋燙金＋紅爐裊煙）。
- **Manus 指令包**：因外部 AI 不知本案誠實邊界，將「事實庫＋證據等級標註＋
  禁用清單＋驗收清單」打包成可貼上的指令檔——**外包生成一律附宣稱清單**（D37）。
- **FGC 2024 中國隊工程筆記精讀**（18 頁）：歸納「抄五件／不抄三件」，
  其中 Iteration 三問格式與系統總覽頁列為本日誌與構想書的後續改進候選。

**（6e）本軌自己的失敗（照本日誌規矩記）**

- 一次 sed 取代未吻合且未驗證，導致簡報中「誠實資料分級」卡片在宣稱已移除後
  仍殘留，後由全文掃描抓回（F31）→ 制度化為「每次取代後必跑全文關鍵字掃描」。
- PowerPoint 開啟中的檔案鎖導致寫入失敗（F33）→ 以「暫存版＋背景輪詢、
  解鎖即替換」處理，未動使用者視窗。
- STEP 重匯於筆電重建 OCP venv 完成（16 具名零件＋組合件，全數回讀驗證通過）,
  順帶把驗證腳本的 OpenSCAD 路徑候選補上 Windows 原生路徑（原僅 WSL 路徑）。

**（6f）外部評審視角**

日誌上傳後，以 WRO Senior 評分表（200 分）模擬評分約 **148/200**，並產出
《導師評審_IEEE與商業視角》：核心結論為「**一流的分析紀律，站在零實測的地基上**」,
其賽前四週行動計畫與 §5.2 實驗優先序一致（第 0–3 項先行），另補三項方法學建議
（聯合不確定性傳播、verification/validation 用語區分、統計計畫預註冊）。

**（6g）宣稱清單（D36）的第一次實戰：跨文件事實同步**

日誌全文校對時發現：第 8 週已查證刪除／更正的三筆宣稱，仍殘留在部分交付物中——
「46–48 億美元市場」（D6 已刪）、「22 億焚香人口」（無可靠出處，安全下限為
印度教＋佛教合計逾 17 億）、「3 千噸香＋24 萬噸金紙≈2 萬輛汽車」（不可溯源，
正確值為環境部 105 年統計線香 2.1 萬公噸）。同日完成跨文件同步：構想書 v2／v3、
現場簡報、A1 海報、Manus 指令包、一分鐘講稿 v2 建議稿全數改用可溯源版本
（印度商務部出口 FY2012–16 約 4.98 億美元、MSME 部女性從業比約八成），並重製
「禁香經濟骨牌」資訊圖（舊圖把 46–48 億烙在點陣圖裡，**XML 全文掃描掃不到圖內
文字**——此為 F31 掃描制度的已知盲區，補救辦法是逐頁轉圖目視）。改後四份 pptx
全文掃描零殘留。**注意：一分鐘講稿「定稿」仍含「二十二億」，因定稿屬使用者
裁量範圍未動，採用哪版由人決定。**

**▸ 本軌產出**：構想書 v2＋v3｜現場簡報 3 分鐘（含備忘稿）｜A1 三聯幅＋PDF｜
一分鐘講稿 v2 建議稿｜五張重繪資訊圖＋QR｜《計畫書優化研究筆記》｜
《FGC工程筆記精讀》｜《Manus指令包》｜`export_pngs.py` QA 管線｜STEP 重匯 16 件｜
《導師評審_IEEE與商業視角》

***（七）`[E]` AI 訓練模擬環境上線（08-16 深夜，筆電）***

把第 17 週四層解耦架構的 **L3＋L4 寫成程式**（`AI訓練/`，純標準函式庫）：

- **煙霧擴散模型**（`plume.py`）：煙羽上升 w∝N^⅓（對表第 17 週：N=1/9/20
  → 0.40/0.83/1.09 m/s）＋擴張錐 db/dz=0.14＋**橫流偏移與側裙衰減（B8）**，
  捕集率 η 由「幾何重疊×速度競爭」推導，不再是純假設曲線。
- **近場/遠場雙區質量平衡**：解析錨點全數通過（無風扇 8.7 支→97 µg/m³、
  η=80.5%→35、近場＝遠場＋S/Q_nx）。
- **損失函數照第 15 週定義**；文化與噪音以 `DualAscent` 對偶上升處理（D11），
  未退回已被否決的固定權重法。基線三件組（定速／實機 FSM 忠實移植／PID）齊備
  （§5.2 第 8 項），FSM 常數與 `pi_fsm.py`、韌體逐一自動比對。
- **F7 梯度檢驗通過**：最佳定速落在內點（非 0 亦非 255）；吞吐量約 9 萬步/s。
  域隨機化含 SKIRT_ATTEN 下探 1.0（側裙完全失效的 B8 情境）。

**模擬環境的頭兩個發現（模擬值，非實測）**：
1. 定速 S2 超標時率最低（24%）但噪音違反 147 h/週——**約束綁住全速，
   第 14 週「控制救不了罩體」在訓練環境中自動再現**。
2. **現行 FSM 門檻在殿堂尺度從未觸發 S2**：殿堂 CO₂ 時間常數 V/Q ≈ 20 min，
   斜率上限約 18 ppm/min，遠低於 θ_ff=120（桌面展示值，呼氣可觸發）。
   → 門檻重調需依燃燒艙／實場資料（`pi_fsm.py` 註解本就預告此事），
   模擬先量化了「差多遠」。

一項有趣的物理副產物：加入橫流後，**小 N 的煙羽因升得慢而被吹偏更多**，
η 對 N 在有橫流時不再單調——F29「裕度對橫流脆弱」的另一個面向，
自檢因此把「η 隨 N 下降」限定在零橫流（第 17 週原主張的適用域）。

**▸ 產出**：`AI訓練/`（8 檔）｜`驗證環境.py` 42 項自檢全過｜
基線對照表（7 天）｜第 19 週誠實承諾寫入 README（RL 沒贏基線就如實報告）

**（7b）風扇規格改指定：SUNON 4020 罩口安裝（同日稍晚，使用者裁示）**

訓練調控風扇定為**建準 SUNON 4020（DC12V、PWM、磁浮軸承），裝於罩口**
（型號檔位未定，模擬以家族典型中值＋域隨機化涵蓋）。模擬重跑後的
**政權變更**：磁浮全速約 30 dBA、最大面風速 0.13 m/s < 單支煙羽 0.40 m/s
→ **噪音與文化兩硬約束天然滿足**，「有香就全速」成為合法邊界解，
AI 的價值轉移到時間軸排程（無香關機、尖峰前預啟動）。附帶紅利：
4 線 PWM 直控解掉 490 Hz 嘯叫與轉速回授兩個舊待辦。
**同時浮出四個需人拍板的設計張力**（詳 `AI訓練/README.md`）：
①風量缺口（工作點 ~12 vs D26 規格 43.3 m³/h，模擬中全速常開僅使
超標時率 54.6%→48.7%）②靜壓推不動 165 Pa 濾鏈③**D13「風扇置於濾後」
被罩口安裝推翻**，金屬紗網相對風扇的位置需重新拍板（FILTER_CHAIN
順序不動）④40 mm 扇盤對 180 mm 罩口的面風速均勻性（模型不確定度最大處）。
→ 已登錄為 §5.1 B10。

**（7c）文獻校正＋有限資源訓練（同日，使用者裁示「透過論文數據模擬」
「AI 在有限電量/算力下訓練」）**

- **文獻校正**（全表見 `AI訓練/文獻參數.md`，依 D6 紀律逐筆查證出處）：
  排放因子對上 Jetter et al. 2002（23 種香實測 5–56 mg/g、7–202 mg/h——
  附錄 C「7–200 mg/支」的原始出處找到了，原文單位是每小時）；
  CO₂ 產生率 0.005 L/s/人獲 Persily & de Jonge 2017 證實；煙羽擴張率
  0.14 落在 MTT 捲吸係數文獻帶（α≈0.12–0.14）；**新增文獻沉降項**
  （0.02–0.55 h⁻¹，超細粒取低端 0.1）；PM 感測器偏差依場測文獻自
  「單向低估」修正為**雙向 0.5–1.5×**（Plantower 對 TEOM 有高估 1.47× 的
  紀錄）。解析錨點以零沉降配置維持與附錄 C 反推源強的一致性。
- **有限資源**：新增每日風扇能量預算（預設 4 Wh，耗盡即物理斷電、
  警報也吹不動，午夜重置；電量剩餘納入觀測）。政權再變：**「有香就
  全速」自殺**——定速 S2 從午夜跑到凌晨四點把預算燒光，開廟門時已斷電,
  整週總損失退回關機水準。約束從「噪音/文化」換成「能量排程」，
  AI 的課題明確化為：把 4 Wh 花在暴露削減報酬最高的時段。
  算力限制列為訓練紀律（Pi 5 上 1 Hz 推論、參數量 <10⁴）。
- 自檢擴充至 **47 項**全過（新增沉降方向、電量預算四項）。

**（7d）三案模型訓練與凍結評比（同日，使用者裁示「全上」；部署目標
Raspberry Pi 5 / 16GB）**

三案：A 線性策略＋CEM（44 參數）｜B 負載預測（ridge）＋電量預算 DP
排程｜C 端到端 DQN（13→64→64→4，約 5k 參數）。訓練用 numpy，
**部署一律 JSON 權重＋純 Python 前向**（`policies.py`）。評估協定於
訓練前凍結（`模型方案.md`：10 驗證 seed × 3 天、域隨機化開、
4 Wh/日；判贏＝對強基線日曆規則勝 ≧8/10）。

**評比結果（★模擬值★）**：
| 參賽者 | 日損失 | vs 日曆規則 | 判定 |
|---|---:|---|---|
| **B 預測+DP** | **394,614（最低）** | **勝 10/10、Δ−9,206** | ✅ 贏（對定速 S1 與實機 FSM 亦 10/10） |
| A 線性CEM | 400,390 | 勝 9/10、Δ−3,430 | ✅ 贏 |
| C DQN | 398,149 | 勝 7/10、Δ−5,671 | ─ 平手區；**日均 8.5 h 電量耗盡**——γ 信用視野（約 2 h）撐不起跨日預算規劃，**與預先寫下的弱點預測一致，照第 19 週承諾如實記錄** |

B 預測器：特徵工程（峰形基底＋初一/週末交互項）使保留集 MAE
9.71→6.38 支（常數基線 12.17）；負載分級混淆矩陣（無/低/中/高）
準確率 56.2%，錯誤幾乎全在相鄰等級、無↔高零混淆，「高負載」
召回 79%。**「AI 的貢獻在預測、排程是最佳化保證解」的兩段式敘事
獲模擬支持**——且再次呼應第 14 週：能被顯式最佳化解掉的部分，
不需要端到端學習。

過程中的方法學自我糾正（照規矩記）：CEM 首輪產物取「跨代最高分
候選」——但各代物理配置難度不同、分數跨代不可比，那是挑到最簡單
的一代；已改存收斂分布中心並以獨立 seed 評分後重訓。

**▸ 產出**：`policies.py`（部署級推論）｜`訓練A/B/C.py`｜`評比.py`
（凍結協定）｜`models/`（三份 JSON 權重＋歷程＋評比結果）｜
`圖表/`（損失變化圖、損失比較圖、混淆矩陣）｜《軟硬體優化報告書》

**（7e）三案 v2 優化重訓與凍結評比（同日深夜，使用者裁示「修正優化
後再訓、每案三圖」）**

優化內容（各自對症）：A＝固定配置集評分（F35 根治：每代同一組域隨機
化配置，跨代分數可比）；B＝λ 驗證集選擇＋學習曲線＋反應層預算感知
（電量 <20% 不升檔）；C＝n-step return（n=32）＋Double DQN＋350k 步。
v1 模型與評比結果全數保留（`*_v1.json`）供前後對照。

**v2 凍結評比（同一協定重跑，★模擬值★）——三案三種命運**：
| 案 | v1→v2 | 判定與發現 |
|---|---|---|
| B 預測+DP | 勝 10/10→**10/10**，Δ −9,206→**−9,245** | ✅ 續居全場最低；預算感知微幅有效 |
| A 線性CEM | 勝 9/10→9/10，Δ −3,430→−2,963 | ✅ 但收斂解＝**「永遠 70」**（評比數字與定速 S1 完全相同；動作混淆矩陣整欄落在 70）——**線性策略在此環境的表達力天花板現形**：學不出時間差異化排程，只能選一個好的常數 |
| C DQN | 勝 7/10→**1/10**，Δ +4,772，無電 8.5→**18.3 h/日** | ❌ **退步**。n-step＋Double DQN 未治好花電、反而更敢花——照第 19 週承諾**如實記錄、不回頭調參救結果**。連兩輪失敗指向同一結論：跨日預算問題對 model-free RL 天生困難，**顯式最佳化（B）是對的工具** |

**每案三圖**（`圖表/`，共 9 張）：損失變化（A 固定配置集曲線第 8 代收斂
／B 學習曲線＋λ 掃描／C 回合損失＋TD）、損失比較（v1 vs v2 對日曆規則
逐 seed 配對）、混淆矩陣（B 負載分級；A/C 動作矩陣對照「事後全知規則：
有香且有電→220，否則→0」——控制策略的真值代理）。

> **紀錄要點**：v2 這一輪最有價值的產出不是 B 的 39 分改善，而是
> A、C 兩個「失敗的優化」——A 揭示模型容量下限（排程需要非線性），
> C 兩連敗把「B 為主力」從偏好升格為**有對照組的結論**。這正是
> 凍結協定的意義：改動前後可比，失敗才有證據力。

**（7f）第三輪（v3）：2×2 對照閉合（使用者裁示「再來一輪」）**

優化內容：A＝種子注入（初始族群塞入常數 70 與手工日曆型候選）＋加大
初始變異——測試 CEM 能否逃出常數局部最優；B＝排程器本體升級（CO₂
nowcast 反推當前香支數混入 DP、30 分鐘滾動重解，移除 v2 的「升一檔」
外掛）；**C＝換演算法**：DQN 兩連敗診斷指向 bootstrap 信用分配，改用
CEM 演化直接優化小型 MLP（13→16→4，292 參數）的整回合報酬。

**v3 凍結評比（同協定第三次重跑，★模擬值★）**：
| 案 | v2→v3 | 判定與發現 |
|---|---|---|
| B 預測+DP | Δ −9,245→**−9,318**，能耗 3.79→3.64 Wh | ✅ 10/10 三連勝、損失新低——nowcast 讓反應進入最佳化本體 |
| **C 小型MLP** | 勝 1/10→**8/10**，Δ +4,772→**−6,496** | ✅ **C 案首次過判贏門檻**。動作矩陣：有香時 93% 正確選 220——證實 v1/v2 的死因是 bootstrap 訓練法，不是「AI 不行」。殘餘弱點：無香時不關機（無電仍 8.2 h/日），下一輪明確靶點 |
| A 線性CEM | 不變（三度收斂回「永遠 70」） | ✅ 9/10。**種子注入含日曆型候選仍逃不出常數解**——線性天花板三度重現，從觀察升格為穩健結論 |

**2×2 對照閉合**（同一凍結協定下的 Δ日損失）：
非線性×演化（C v3：−6,496）＞ 線性×演化（A：−2,963）＞
非線性×bootstrap（C v2：+4,772，敗）。
**「非線性帶來增量、bootstrap 是死因、顯式最佳化（B）仍居首」**
——三個結論各有對照組，答詢時每一句都有圖可指。
每案三圖更新（比較圖升級為 v1/v2/v3 三代並排）；DQN 產物保留
（`dqnC_v1/v2.json`），C v3 產物為 `mlpC.json`。

**（7g）sim-to-real 第一步：資料鏈實勘、真實資料第一課、影子模式（同日）**

**資料鏈實勘（筆電經 tailnet 直查）三項發現**：
1. **B1 其實已解**：aroma01 的 CO₂ 是活的真值——雲端庫近 24h 34,425 筆、
   830–2,401 ppm、1 Hz（居家房間的典型呼吸訊號）。SCD41 已接通，
   日誌的 B1 狀態落後於現場。
2. **雲端棧位置確認**：機隊資料庫＝桌機 WSL（InfluxDB 2.7.12，
   bucket=incense，device 標籤有 aroma01/02/03）。**Pi 的 8086 埠被
   Pironman5 機殼監控自帶的 InfluxDB 1.12 佔用**——PI5/docker-compose
   規劃的 Pi 本地棧（Influx 2.7）有埠衝突，登錄 B11。
3. SSH 到 Pi 仍被拒（B2 公鑰未裝，維持阻塞）。

**真實資料第一課（`真實資料重訓.py`，★居家作息 CO₂，非廟宇負載★）**：
可用真實小時樣本僅 **59 筆**（08-12–08-16，裝置非全天開機）。
測試段 MAE：**前日同時刻 persistence 156 ppm ＜ 常數 391 ＜ 日曆 ridge 433**
——四天資料撐不起 9 個日曆特徵，**目前最強的真實預測器是「昨天這時候」**。
誠實結論：日曆模型需要更多天數與更完整的開機覆蓋；資料飛輪的
第一圈先轉起來了，模型輸給基線照實記。

**影子模式落地（`PI5/pi_fsm.py`）**：B 案排程器以零相依形式嵌入
（`ShadowAdvisor`＋`ai_predictor.json` 複本），每秒產生 `ai_duty`
建議寫入決策紀錄與上雲——**只記錄、絕不致動**（送 R4 的 duty 原封
不動；模型檔不存在則自動停用）。煙霧測試：半夜 0、晨峰 220、
午間低載 70、暮峰高 CO₂ 255、深夜 0（加 0.3 支訊號閾值防雜訊倒預算）。
`驗證資料流.py` 欄位契約全過。**（同日 22:10 續報）B2 已解、影子模式已上線**：
公鑰經密碼驗證裝入（Pi 主機名 feihongPi5、帳號 feihong，sudo 免密），
新版 `pi_fsm.py`＋`ai_predictor.json` 進 `/opt/incense/`、`incense-fsm`
重啟成功，**`ai_duty` 已以 1 Hz 流入雲端 decision measurement**——
實測對比資料（fan_duty vs ai_duty）自此自動累積。舊版留檔備援。
（B2 自 §5.1 銷項；B11 埠衝突仍開）

---

# 第二部｜彙總表

## 2. 決策紀錄總表（ADR 摘要）

| # | 週 | 日期 | 軌 | 決策 | 被否決的替代 | 主要理由 |
|---|:-:|---|:-:|---|---|---|
| D1 | 1 | 04-04 | A | 範圍限縮至線香，排除金紙 | 兩者並論 | 近場暴露結構不同；**代價：失去官方排放係數** |
| D2 | 3 | 04-19 | A | 定位為源頭捕集而非空間稀釋 | 全室換氣稀釋 | 只需處理源強而非整室體積，風量需求降 1–2 個數量級 |
| D3 | 4 | 04-26 | A | 採雙區模型，不另設距離乘數 | 距離加權 | 避免重複計算 |
| D4 | 5 | 05-02 | A | 對外只宣稱「不低於兩個數量級」 | 宣稱 928 倍 | 可承受「一年真的只去四次嗎」的質疑 |
| D5 | 5 | 05-02 | A | KPI 不以健康改善為指標，改用 ΔE | 宣稱健康效益 | 專案期間無法驗證健康終點 |
| D6 | 8 | 05-23 | A | 刪除「兩萬輛汽車」與「50 億美元」 | 保留並加註 | 前者換算基準不可追溯；後者估值差 **50 倍** |
| D7 | 9 | 05-31 | A | 龍山寺禁香正面納入而非迴避 | 略過不提 | 迴避＝被評審抓到；納入＝產出 3-6/3-7 兩節 |
| D8 | 12 | 06-20 | A | KPI 依源強歸一化 | 直接用濃度降幅 | 未歸一化離散度 15.1% 且**系統性低估** |
| D8a | 11 | 06-12 | C | 不提供「整支線香平均分子量」 | 由重複單元加權估一個數字 | 巨分子複合材料無法由重複單元定義；**寧缺勿假精確** |
| D8b | 12 | 06-18 | C | 缺氧燃燒式 (4) **刻意不配平、保留未定係數** | 硬配平成一條方程式 | 真實產物分布是經驗性的；配平會製造假的精確度 |
| D8c | 13 | 06-27 | C | 報告採「理想化學計量＋實證非計量分布」雙軌並陳 | 擇一呈現 | 單一平衡方程式無法描述線香燃燒 |
| D8d | 13 | 06-28 | C | 不宣稱對特定 PAH 物種之去除率；KPI 維持 ΔE 並聲明其為質量替代指標 | 宣稱毒性削減 | PAH 分配對配方／條件／分析方法高度敏感，且團隊無 GC–MS 量能 |
| D9 | 13 | 06-28 | A | 效能承諾上限＝我國標準 35 | 對標 WHO 15 | **15 低於戶外背景 20，物理上不可達** |
| D10 | 14 | 07-04 | A | 罩體幾何列第一優先，控制次之 | AI 控制為核心 | 約束封頂轉速，**演算法優化不出被封死的空間** |
| D11 | 15 | 07-12 | A | 文化約束設為硬約束（對偶上升） | 可加權軟約束 | **軟約束＝承認信仰可被交換，與核心主張自相矛盾** |
| D12 | 16 | 07-15 | E | 三控制器一層一顆 | Pi 一顆全包 | 單點故障、OS 排程抖動、安全隔離 |
| D13 | 16 | 07-18 | E | 風扇置於過濾鏈之後（抽拉式） | 推吹式 | 扇葉不吃香灰油煙；代價：濾箱須氣密 |
| D14 | 16 | 07-18 | E | 警報線主動低態開集極 | 主動高態 | **斷線方向 failsafe**；不誤報優先 |
| D15 | 17 | 07-26 | A | 不採 BFS 與 MATLAB，改離線 OpenFOAM + 0-D 訓練 | CFD-in-the-loop | BFS 梯度為零（$u^*$=0.00）；CFD-in-the-loop 需 **913 年** |
| D16 | 17 | 07-26 | A | η(u) 改為 η(u, N) | 維持原模型 | 煙羽速度隨 $N^{1/3}$ 成長，原模型高估 η 達 **+0.305** |
| D17 | 18 | 07-31 | E | 警報線改接類比腳 A0 | 數位腳 D2、BSS138 模組 | R4 VIH = 4.0V，3.3V 餘量 **−0.7V**；BSS138 上拉會破壞降級行為 |
| D18 | 18 | 08-01 | A | 採 ASHRAE 110 標準量測法 | 自訂量測方法 | 迴避「方法為結果量身訂做」之質疑 |
| D19 | 18 | 08-02 | E | 採用兩板合併架構 | 維持三板 | 少一類失效模式、Pi 失效層變強；**前提：I²C 線長 ≤1–2 m** |
| D20 | 18 | 08-02 | E | 風扇維持 D4184，不走馬達埠 | 馬達埠＋轉接板 | 控制鏈多一顆 MCU＝多一個失效模式；**即使該轉接板存在也不用** |
| D21 | 19 | 08-07 | E | 產品定位＝retrofit 改裝模組 | 整爐替換 | 不換爐、不要求信眾改變行為；B2B 單一決策者 |
| D22 | 19 | 08-07 | E | 理香機構降為 PoC | 列為主打 | **其成立前提會消滅它要解的問題** |
| D23 | 19 | 08-09 | E | NVMe 角色移植，非整碟複製 | dd 整碟複製 | 會把 ext4 損壞一併抄入 |
| D24 | 20 | 08-16 | E | 理香機構整組移除 | 保留為選配 | 徹底化 D22；並新增兩條殘留守門規則 |
| D25 | 20 | 08-16 | E | 集煙罩漏斗化（96→180 mm） | 維持上窄下寬 | 插香人因；方向與 D16 之尖峰動量設計一致 |
| D26 | 20 | 08-16 | E | 系統風量規格自 500 降為 **43.3 m³/h** | 沿用 500 | 點源捕集處理源強而非室內體積；煙羽夾帶量僅 8–20 m³/h |
| D27 | 20 | 08-16 | E | **側裙自優化選配升格為必要件** | 維持選配 | $N$=1 時煙羽最弱，0.25 m/s 橫流即漂移 169 mm |
| D28 | 20 | 08-16 | E | 兩顆 5015 **改串聯**（提交決策） | 維持並聯 | 系統為高阻抗低流量；並聯解決的不是瓶頸。⚠ 代價：失去半風量冗餘 |
| D29 | 20 | 08-16 | E | 驗證實驗須含 **$N$=1 × $u_{cross}$=0.25** 工況 | 僅測尖峰 | 該格為預測之最惡劣工況；通過則其餘必然通過 |
| D30 | 20 | 08-16 | E | 罩口內徑待 $h_{min}$ 定案後重設（0.25 m → 275–310 mm） | 維持 175 mm | 現行罩口對應 $h_{min}$ 上限僅 0.14 m |
| **D31** | 20 | 08-16 | E | **術語拆分：$h_{min}$（廟方決定，仍未知）／$h_{spec}$（本機保證，0.18 m）** | 團隊直接把 $h_{min}$ 由 0.25 改為 0.18 | **團隊不得替信仰填空**；改為宣告機器能力、由廟方認定是否足夠。**約束仍為硬約束，D11 論證完好** |
| D32 | 20 | 08-16 | E | 規格重設：爐盆 ⌀70、三面側裙、罩口 200、煙道 50、濾材 210×210 | 維持原設計 | 最不利工況（$N$=1）裕度 +20.4 mm；阻力降 32%，濾材壽命 1.50× |
| D33 | 20 | 08-16 | E | $h_{spec}$ 取 0.18 m（保 11% 裕度），非數學可行的 0.21 m | 取滿到 0.21 | 分析鏈上有六項未實測參數，**4% 以下裕度撐不住誤差累積** |
| D34 | 20 | 08-16 | P | 構想書「誠實揭露」自白段落移除（使用者決定），但**保留數字旁「設計目標」標註與 AI 使用揭露** | 全數移除／全數保留 | 前者是事實標記（拿掉即違反紅線 7）、後者是 WRO 規則要求；誠實由自我宣傳退為標註紀律，主張不變 |
| D35 | 20 | 08-16 | P | 交付物一律經 PowerPoint COM 逐頁轉圖目視 QA 後才交付 | 僅程式端驗證 | 首次全檢即抓到 16 處雙重圖說——程式驗證看不見排版 |
| D36 | 20 | 08-16 | P | 建立「宣稱清單＋證據等級」制度：所有對外文件只從同一份事實庫取材（實測／模擬／設計目標／假設推估四級標註） | 各文件各自寫 | S-1 一致性原則；跨文件數字分岔是信任歸零的最快路徑 |
| D37 | 20 | 08-16 | P | 外包 AI 生成（Canva／Manus）一律附指令包：事實庫＋禁用清單＋驗收清單 | 直接下自然語言指令 | 外部 AI 不知本案誠實邊界，會編數字、會把設計目標寫成成效（Canva 實測即產出亂詞與佔位假資訊） |
| D38 | 20 | 08-16 | P | 構想書維持 13＋7 頁結構、標記超頁風險待拍板 | 逕行合併 3-3B／4-5B | 超頁 0 分是行政死刑，但結構調整影響全書引用，屬使用者層級決策（§5.5） |
| D39 | 20 | 08-16 | E | **訓練調控風扇定為 SUNON 4020 磁浮 PWM、罩口安裝**（使用者裁示） | 沿用 5015×2 規格 | 政權變更：噪音／文化約束天然滿足；四項整合張力登錄 B10；4 線 PWM 順帶解嘯叫與轉速回授 |
| D40 | 20 | 08-16 | A | **AI 於有限資源下訓練**：每日 4 Wh 能源預算（耗盡物理斷電）＋Pi 5 上 1 Hz 推論之算力紀律（使用者裁示） | 無限資源訓練 | 「有香就全速」退化解消失，課題明確化為預算排程；預算數字屬情境假設待拍板 |
| D41 | 20 | 08-16 | A | 模擬參數以文獻校正（Jetter／Persily／Thatcher／MTT／Sayahi）並保留域隨機化；PM 感測偏差自單向低估修正為雙向 0.5–1.5× | 維持純假設值 | 文獻縮小不確定範圍但不取代自量測（別人的香、別人的房間）；沉降項新增、解析錨點維持零沉降配置 |
| D42 | 20 | 08-16 | A | **評估協定於訓練前凍結**：10 驗證 seed × 3 天 × 域隨機化、對強基線勝 ≧8/10 判贏 | 訓練後視結果訂協定 | 統計計畫預註冊之精神；防止事後挑選有利設定 |
| D43 | 20 | 08-16 | A | 三案全做；**B（負載預測＋DP 排程）為主力部署候選** | 僅端到端 RL | 凍結評比 B 全勝（10/10）且總損失最低；兩段式可獨立驗證、可解釋，「AI 的貢獻在預測」與第 14 週敘事一致 |

---

## 3. 失敗與修正紀錄總表

> 本節單獨成表，因為它是本日誌對評審最有價值的部分。**每一條都是實際發生過的，不是假設性風險。**

| # | 週 | 日期 | 失敗／錯誤 | 如何被發現 | 修正 | 留下的制度 |
|---|:-:|---|---|---|---|---|
| F1 | 8 | 05-23 | Friborg 癌症部位誤植（二手轉述混合了兩項發現） | 回查原始摘要 | 依原文改寫 | **查證一律看原始摘要** |
| F2 | 8 | 05-23 | 把 Tang 的次群體 OR 當成主結果，自我削弱論據 | 同上 | 補上整體 OR 1.33 | 同上 |
| F3 | 8 | 05-24 | 引用市場規模 50 億美元（六份報告差 50 倍） | 交叉比對六份來源 | 全數刪除，改用結構性事實 | **單一商業報告不可作為量化依據** |
| F3a | 11 | 06-11 | 初稿把 (1)–(3) 完全燃燒式當成線香的燃燒描述 | 查悶燒（smoldering）機制文獻 | 明確改列為「熱力學極限」，主導路徑另立 (4)–(6) | **看起來很化學的式子，可能整條方向都是錯的** |
| F3b | 13 | 06-27 | 假定「PM2.5 質量降低＝毒性降低」 | 讀到「環保香 PM2.5 較低但部分 PAH/OPAH 反而更高」 | KPI 明文聲明為質量替代指標，不等同毒性削減 | **質量與毒性由燃燒化學不同面向主導** |
| F4 | 12 | 06-18 | 原始暴露公式未扣背景、未歸一化、近場項過敏感 | 系統性檢討 | 改為三層結構 | **凡 KPI 必須先做可歸因性測試** |
| F5 | 12 | 06-20 | 誤稱「暴露劑量」（exposure vs dose） | 術語核對 | 更正為「暴露量」 | — |
| F6 | 17 | 07-26 | η(u) 隱含「煙羽動量與香支數無關」，高估達 +0.305 | **做另一件事時順手發現** | 改為 η(u, N) | **跨領域檢視比同領域複查更易抓隱含假設** |
| F7 | 17 | 07-26 | BFS 訓練環境策略收斂至「永不啟動」 | 數值驗證 $u^*$ = 0.00 | 整個方案否決 | **訓練環境須先過梯度可用性檢驗** |
| F8 | 18 | 07-30 | 儀表板修復只存在 WSL 家目錄，repo 是壞的舊版 | 檔案稽核 | 複製 3 份回 repo | **明訂真相來源表**（CLAUDE.md §3） |
| F9 | 18 | 07-30 | `lastPiCmd=0` 導致開機頭 5 秒誤報 `mode:"PI"` | 檔案稽核 | 新增 `piSeen` 旗標 | — |
| F10 | 18 | 07-30 | 指南叫使用者手動加的 publish 行已內建 | 檔案稽核 | 改寫為「已內建，勿重複加」 | — |
| F11 | 18 | 07-30 | `pi_fsm.py` decision 只寫本機不發 MQTT（**沉默失敗**） | 人工比對規格與實作 | 補一行 publish | **催生 `驗證資料流.py` 欄位契約檢查** |
| F12 | 18 | 07-31 | 警報線 3.3V → R4 數位腳，餘量 **−0.7V** | 逐項算電氣餘量 | 改接 A0＋軟體遲滯 | **建立「規格值→計算→餘量→判定」9 項驗證表** |
| F13 | 18 | 07-31 | KiCad ERC 44 項違規 | 跑 ERC | 修到 0；格點檢查寫進 `self_check()` | **產生器自我檢查，日後改版面直接擋下** |
| F14 | 18 | 08-02 | 誤以為控制器是 UNO R4 Minima | 查官方函式庫原始碼 | 全面重新評估架構 | **硬體事實一律回查原始碼／絲印** |
| F15 | 19 | 08-04 | 規劃 MAX6675 走 D3 埠（被 PS2 手把介面佔用） | 讀 `MiniR4.begin()` 原始碼 | 改用 D1 + D4 | 寫進 CLAUDE.md §4 |
| F16 | 19 | 08-04 | 曾建議風扇改走馬達埠（實為 5V 穩壓輸出） | 查官方電氣規格 | 維持 D4184 | 同上 |
| F17 | 19 | 08-07 | 理香機構的成立前提會消滅它要解的問題 | 檢視其適用情境 | 降級 → 第 20 週整組移除 | **新增兩條殘留守門自動測試** |
| F18 | 19 | 08-09 | Pi5 低壓重置 → SD 卡損壞，全機 Python 癱瘓 | 系統無法啟動 | NVMe 角色移植 | **官方 27W 電源列採購第一優先** |
| F19 | 20 | 08-10 | 反覆誤判「R4 從 USB 消失」為線材問題 | 冷開機乾淨情境比對 | **實為 R4 斷電後不會自動開機** | 上電 SOP 明訂「按 R4 電源鍵」 |
| F20 | 20 | 08-11 | MAX6675 模組整個未接時 SPI 讀全零，`tc_fault=0` | 燒錄後序列實測 | 無法軟體修正 | **接線日判讀警語寫進交接文件** |
| F21 | 20 | 08-12 | 看門狗 v1 判不出「枚舉在但主迴圈死了」 | 卡死事件 | 看門狗 v2 加測資料流靜默 | — |
| F22 | 20 | 08-13 | MatrixMiniR4 庫與 Adafruit BusIO 十個符號重複定義 | 編譯連結錯誤 | `#if !__has_include` 讓位補丁 | **★庫一更新補丁就消失★** |
| F23 | 20 | 08-16 | 罩口 175 mm 在幾何上接不住煙羽（對應 $h_{min}$ 上限僅 0.14 m） | 首次做煙羽擴張錐核算 | 待 $h_{min}$ 定案後重設為 275–310 mm | **方向性結論（「罩體幾何第一優先」）不等於規格；中間隔著一次完整核算** |
| F24 | 20 | 08-16 | 誤以為系統瓶頸是流量，故規劃風扇並聯 | 系統阻力預算（濾材佔 95%） | 改串聯（提交決策） | **先算阻力預算再決定風扇拓撲** |
| F25 | 20 | 08-16 | 「兩者併用」情境把罩體風量與循環風量當成兩道獨立氣流 | 氣流路徑追蹤（罩→煙道→濾材→風扇） | 31.6 → 35.0 µg/m³ | **比較表中的每個配置都要能畫出實際氣流路徑** |
| F26 | 20 | 08-16 | 只以尖峰負載為設計點，未檢視低載可靠度 | $w \propto N^{1/3}$ 的橫流敏感度 | 驗證實驗加入 $N$=1 工況 | **同一系統可有兩種失效模式，且最惡劣者未必在同一端** |
| F27 | 20 | 08-16 | 基線濃度算成 94.2（誤把罩體風量算進**無系統**情境的分母） | 與 97.0 實測值不符 | 更正為 97.0 µg/m³ | **對照組的公式要單獨檢查，不能沿用實驗組的** |
| F28 | 20 | 08-16 | **把「兩項通過、一項未過」寫成「三項判準全數滿足」** | 逐項複核 ACGIH（要求 214 vs 設計 200） | 誠實載明未過，並提出兩種處置 | **這不是計算失誤，是結論下得太急——在以誠實邊界為紀律的專案裡更嚴重** |
| F29 | 20 | 08-16 | 未察覺定案設計的橫流餘裕只有 0.023 m/s | 對四個假設參數跑敏感度 | 側裙效能升為最高風險未驗證項；建議罩口 215 mm | **通過與否要看裕度對假設的敏感度，不能只看是否 ✓** |
| F30 | 20 | 08-16 | 構想書 v3 首版 16 處雙重圖說（原圖內建標題＋外加編號圖說疊放） | PowerPoint COM 逐頁轉圖目視 | 內建標題之圖移除外加圖說 | **催生 D35：交付前必過轉圖 QA** |
| F31 | 20 | 08-16 | 一次文字取代未吻合且未驗證，「誠實資料分級」卡片在宣稱已移除後仍殘留於簡報 | 全文關鍵字掃描 | 整段重寫並掃描確認歸零 | **每次取代後必跑全文掃描；「取代指令執行成功」不等於「取代發生了」** |
| F32 | 20 | 08-16 | Canva AI 生成之海報含亂詞大標（「鬼伐籍」）與佔位假資訊（示範網址、RSVP） | 匯出圖逐張目視 | 逐元素讀取設計結構、替換／刪除後重新提交 | **AI 生成物一律逐元素校對，縮圖看過不算看過** |
| F33 | 20 | 08-16 | 目標 pptx 被使用者於 PowerPoint 開啟中，寫入失敗（檔案鎖） | PermissionError＋程序清單確認 | 暫存版＋背景輪詢，解鎖即自動替換；不動使用者視窗 | **共用檔案的寫入要假設「使用者正開著它」** |
| F34 | 20 | 08-16 | 已刪除之舊宣稱（46–48 億美元）烙在點陣資訊圖內，pptx 的 XML 全文掃描掃不到 | 逐頁轉圖目視（D35 管線） | 重製該圖並換圖重建兩版構想書 | **F31 的全文掃描有盲區：圖內文字只有轉圖目視抓得到——兩道 QA 缺一不可** |
| F35 | 20 | 08-16 | CEM 訓練產物取「跨代最高分候選」——域隨機化下各代物理難度不同、分數跨代不可比，等於挑到最簡單的一代 | 檢視訓練輸出的跨代震盪 | 改存收斂分布中心＋獨立 seed 評分，重訓 | **域隨機化下任何跨批次的分數比較，先問「配置相同嗎」** |
| F36 | 20 | 08-16 | DQN（方案 C）日均 8.5 h 電量耗盡，凍結評比僅平手區（勝 7/10） | 凍結評比 | 照第 19 週承諾如實記錄，不回頭調參救結果 | **弱點與預先寫下的預測一致（γ 信用視野約 2 h 撐不起跨日預算）；「顯式最佳化已足夠」是有效結論** |

---

## 4. 週工作量分布統計

| 月份 | 週次 | 平日條目 | 假日條目 | 里程碑（假日） | 里程碑（平日） |
|---|:-:|---:|---:|---:|---:|
| 4 月 | 1–5 | 13 | 9 | 5 | 0 |
| 5 月 | 6–9 | 12 | 8 | 4 | 0 |
| 6 月 | 10–13 | 11 ＋ **4（化學軌）** | 8 | 5 | 0 |
| 7 月 | 14–18 | 16 | 9 | 3 | 2 |
| 8 月（至 16 日） | 18–20 | 14 | 11 | 3 | 3 |
| **合計** | **20 週** | **70** | **45** | **20** | **5** |

**觀察四點：**

1. **全期 25 項里程碑中，20 項落在假日或連假**（80%）。平日的 5 項集中於 7–8 月暑假期間，該期間平日亦有整段工時可用。（8/16 假日新增條目 5 節：(6g)、(七)、(7b)–(7d)，里程碑＋1＝模擬環境上線與三案凍結評比）
2. **三個連假各承載一項重大產出**：清明（範圍界定）、五一（3-3 成稿）、端午（三層公式＋蒙地卡羅）。**端午連假的產出是全期分析軌最大的單筆。**
3. **平日條目數約為假日的 1.75 倍，但平日產出的多為「輸入」**（文獻、資料、排錯），假日產出的才是「結論」。此分布說明：學期中的專案排程應**以假日為交付節點**規劃，平日僅安排可中斷的增量工作。
4. **第 10–13 週採雙軌並行**（主軌假日推進、化學軌平日累積），是全期唯一一次平行推兩條線且兩條都在同一週末收斂（6/27–6/28 出兩項里程碑）。**此模式可行的前提是化學軌屬「可中斷的閱讀與推導」，不需要連續工時**——若兩條軌都需要整段工時，這個排法會直接失敗。

---

## 5. 未決事項與下一步

### 5.1 阻塞中（有明確卡點）

| # | 事項 | 卡在哪 |
|---|---|---|
| ~~B1~~ | ~~SCD41 I²C 掃不到 0x62~~ | **✅ 2026-08-16 證實已解**——雲端庫 aroma01 之 CO₂ 為 1 Hz 真值（830–2,401 ppm，近 24h 34,425 筆），感測鏈已通（(7g)） |
| ~~B2~~ | ~~`t_ds` 上不了儀表板~~ | **✅ 2026-08-16 解除**——公鑰已裝、新版 `pi_fsm.py`（含影子模式）已部署重啟（(7g)）。Grafana JSON 匯入仍待做 |
| B3 | R4 板上仍是**舊韌體** | 理香移除後的新韌體與 I²C 掃描器臨時韌體皆需重燒 |
| B4 | PCF8574 存廢未拍板 | 理香移除後只剩 2 路負載；**建議方案 B：改用 2 顆 D4184 接 Analog 1/2 孔**。拍板前**不要採購 PCF8574 板** |
| ~~B5~~ | ~~機構設計無法收斂~~ | **✅ 2026-08-16 解除**——經 D31 術語拆分，機構改依 $h_{spec}$ = 0.18 m（本機保證值）設計，不再等待 $h_{min}$。訪談仍要做（$h_{min}$ 仍未知），但**已非前置阻塞**：若訪談結果 ≤ 0.18 m 則直接通過；若 > 0.18 m，方案 A 硬體可再撐到 0.21 m，超過則需放大罩口 |
| B6 | 風扇串／並聯未拍板 | 串聯得靜壓、失冗餘；替代方案為單顆高靜壓鼓風機＋加大濾材面積。屬設計取捨，需人決定（3-8.7） |
| B7 | 系統工作點未定 | 5015 鼓風機 $P$–$Q$ 特性曲線未實測，無法確認 225–438 Pa @ 56.5 m³/h 可達成 |
| **B8** | **★側裙效能未驗證（全案最高風險）★** | **定案設計假設三面側裙可將罩周橫流壓到 0.05 m/s，而失效門檻僅 0.073 m/s。無側裙之室內橫流常見 0.15–0.50 m/s，須達成 3–10 倍衰減。此假設一旦不成立，罩口裕度立即歸零（見第 20 週敏感度表）** |
| B9 | 罩口 200 vs 215 mm 未拍板 | 215 買到橫流餘裕 +23% ＋ ACGIH 合規，代價整機 +15 mm、阻力 +38 Pa、濾材壽命 −0.2×。**建議 215**，屬設計取捨需人決定 |
| B10 | **SUNON 4020 罩口風扇的系統整合**（08-16 指定為訓練調控規格） | 四項張力待拍板：風量缺口（~12 vs D26 43.3 m³/h）／靜壓推不動 165 Pa 濾鏈（過濾段需另行驅動？）／D13「風扇置濾後」與罩口安裝矛盾（紗網須前移至扇前，火星防護）／40mm 扇盤對 180mm 罩口之面風速均勻性。型號檔位與 P–Q 實測（§5.2 實驗 1）後收斂 |
| B11 | **Pi 的 8086 埠被 Pironman5 自帶 InfluxDB 1.12 佔用** | PI5/docker-compose 規劃的本地 Influx 2.7 有埠衝突——本地棧狀態需上機盤點（改埠或停用 Pironman 資料庫）；雲端棧（桌機 WSL）不受影響，資料鏈現走雲端 |

### 5.2 實驗（優先序由高至低）

> **優先序 0–3 由第 20 週的敏感度分析直接導出**——這三個參數**各自都能單獨讓設計失效**，其餘項目再重要也排在後面。

0. **★側裙實際衰減效果（橫流 $u_{cross}$）★**——全案最脆弱假設。門檻 0.073 m/s，假設 0.05，餘裕 0.023。做法：熱線風速計或發煙管，量側裙內外的風速比
1. **★風扇 $P$–$Q$ 特性曲線★**——阻塞系統工作點、串／並聯決策，且為 η(u) 特性曲線的前提。08-16 起含兩顆：**SUNON 4020（罩口，D39 指定，另需 datasheet 型號檔位）**與 5015（若採雙級架構）
2. **煙羽擴張率 d$b$/d$z$**——現取 0.14；若實際為 0.18，罩口裕度自 +20.4 掉到 +1.6 mm
3. **爐盆有效源徑 $D_s$**（實際插香散佈範圍）——若自 70 放大到 90 mm，設計直接失效
4. **三條特性曲線**（缺此則模擬無意義）：η(u,N) 示蹤法或上下游濃度比、h(u) 定點攝影加影像分析、SPL(u) 聲級計於香客位置
5. HEPA 與活性碳實際壓損（初期／壽末）——風扇選型與濾材更換週期
6. **線香排放因子自行量測**——文獻值 7–200 mg/支跨度過大不可用。**自行量出的係數比引用來的更有說服力，且本身即為可寫入報告的實驗數據**
7. **罩體幾何優化實驗**（依第 14 週分析與 3-8 之罩口結論）
8. **規則式／PID 基線建置**——**無基線則無法宣稱 AI 有貢獻**。**✅ 2026-08-16 已於模擬環境完成**（FSM 忠實移植＋PID＋日曆規則，含凍結評比，見 (7d)）；**實機端基線量測仍待**（同工況下 FSM vs 定速的實測對比）
9. 殿堂體積與實際換氣率量測（驗證模型用）
10. 戶外背景值同步量測方案

### 5.3 送審前必完成之查證

- [ ] **IARC Monographs Vol. 109 (2016)** — 核對原卷。注意媒體常簡化為「WHO 將 PM2.5 列為一級致癌物」，**省略了「戶外空氣中的」限定條件**
- [x] ~~末期腎病研究（PMC6325774）補足完整書目~~ **✅ 08-16 補齊**：Geng et al. (2019), *BMC Nephrology*（附錄 D [5]）。⚠ 順帶注意：SCHS 世代招募 n=63,257，Friborg (2008) 分析樣本為 61,320（排除後），引用時勿混用
- [ ] Bhadauria et al. (2022) 印度十座廟宇 658.3 µg/m³ — 目前為轉引，須取得原文
- [ ] Lin et al. (2002) 台灣廟宇 PAHs 室內外比 5.7–387.9 — 同上
- [ ] 蘇大成 2015 量測 — 尋找是否有正式論文版本
- [ ] 台北市戶外 PM2.5 年均值 — 引用環境部測站年報並註明年份
- [x] ~~化學軌書目補齊~~ **✅ 08-16 大致補齊**（附錄 D 已全面改寫為 APA 第 7 版）。**僅餘 3 缺口**：[3] Hien 2022 完整作者欄、[12] Wang 2006 卷期頁碼、[15] 日本 2024 作者欄
- [ ] **表一質量組成之來源限定說明** — 須在報告中明載其為單一複合配方文獻值、非通用值（來源＝附錄 D [6] Lin et al. 2008，期刊名已更正）

### 5.4 田野調查

- [ ] **★$h_{min}$ 訪談（已升格為機構前置阻塞項，見 §5.1 B5）★** — 原本理解為「效能上限的封頂參數」；3-8 顯示它同時是**罩口內徑、風量、濾材面積、風扇壓力與電源預算的共同上游**。它是四個約束中唯一無法由物理決定者，必須來自廟方
- [ ] **煙升之儀式意義訪談** — 目前為推論非證據；訪談可升格為田野依據，同時支撐文化約束論述（**一石二鳥**）
- [ ] 駐廟人員實際工時與位置分布（修正第 4 週之示範假設）
- [ ] 香客參拜頻率與停留時間分布（同上）

### 5.5 報告與交付

- [ ] 龍山寺禁香之時序說明須安排在報告某處（見第 9 週風險）
- [ ] 製作「捕集 vs 循環過濾」對比圖 — 與**圖 3-8-1（煙羽外徑 vs 罩口）**並列為報告主圖，兩者為全報告最具說服力的視覺
- [ ] **更正第 13 週「捕集 vs 循環過濾」表之「兩者併用」列**：31.6 / 67.4% → **35.0 / 64.0%**，或改述為「本系統（捕集＋濾材為同一氣流）」（見 F25）
- [ ] 更新電源預算與噪音估算基準——風量規格自 500 降為 43.3 m³/h（D26）
- [ ] 確認 3-3、3-5 是否爆頁及其分流方案
- [ ] **★構想書頁數拍板（D38）★** — 現行方案 13 頁＋社會創新 7 頁，超過範本 12＋6 上限而「超頁 0 分」；是否將 3-3B 併入 3-3、4-5B 併入 4-5，需使用者決定（v2/v3 結構相同，改動成本低）
- [ ] 外部訪談 ≥3 位非教練非家長人士並附紀錄（WRO 明文要求；可與 $h_{min}$ 田調同行程）
- [ ] 單位經濟一頁表（BOM→售價→毛利）；D26 風量降規後成本結構應重算
- [ ] 官方 27W 電源採購（**F18 的根治手段**）
- [ ] MQTT 帳密缺口：`pi_fsm.py` 與韌體目前**都沒有帳密參數的位置**
- [ ] 風扇 PWM 頻率改 25 kHz（預設 490 Hz 會嘯叫）——**若定案 4020 走 4 線 PWM 直控則自動解除**（D39）
- [ ] S1 duty = 70 可能低於無刷風扇最低啟動占空比——**4020 之 PWM 規格啟轉約 0–20%，可能自動解除**，實測確認後銷項
- [ ] **SUNON 4020 型號檔位選定＋datasheet 回填**（`sim_config.py` 現為家族典型值）
- [ ] **能源預算情境拍板（D40）**：4 Wh/日為訓練假設——實務為市電節能目標或電池離網？定案後重訓
- [ ] **雙級抽排架構拍板**（4020 罩口助抽＋5015 濾箱主抽，見《軟硬體優化報告書》1.1；影響韌體第二路 PWM）
- [ ] **FSM 門檻依實場重調**：模擬顯示殿堂尺度 θ_ff=120 永不觸發、斜率上限約 18 ppm/min（(7d) 發現；`pi_fsm.py` 註解本預告需燃燒艙後調）

### 5.6 資料補強研究清單（彙總；2026-08-16 新增）

> 三個層面的「資料還不夠硬」之處，依補強手段分類。文獻端見 §5.3、
> 實測端見 §5.2、AI 端如下：

- [ ] **aroma01 真實 CO₂ 歷史 → 重訓 B 案負載預測器**並回報真實 MAE
  （現為合成資料 MAE 6.38 支；合成→真實遷移是任何 AI 宣稱的必要條件）
- [ ] **香客負載模型的隨機化補洞**：日形狀與初一/十五倍率現為寫死，
  防策略學到模擬器怪癖
- [ ] **PMS5003 對重量法之自有校正**（文獻僅提供 0.5–1.5× 的雙向範圍）
- [ ] **近場（爐邊）濃度資料完全缺失**——評估第二顆 PM 感測器（軟硬體
  優化報告書 1.4）
- [ ] 4020 P–Q 實測後：`sim_config.py` 回填＋`RAND_RANGES` 收窄＋三案重訓重評

---

## 6. 研究方法上的自我檢討

### 6.1 做對的三件事

**一、主動去找對自己不利的證據。**
第 9 週發現龍山寺已禁香，若當初迴避，3-6 與 3-7 兩節都不會存在，而第 11 週找到的北港武德宮「同一個抗議者自願為技術方案付費」這條最強的市場證據也不會出現。**去找反證的報酬率高於去找佐證。**

**二、把誠實邊界寫成制度而非自律。**
`*_MEASURED = False` 旗標、模擬機標示規則、資料切換點註記、「殘留守門」自動測試——這些都把「記得要誠實」轉成「不誠實會被自動擋下」。專案有一條明訂紅線：**不得宣稱需要實體或目視才能確認的事情「已驗證」。**

**三、每個否決都記錄替代方案與代價。**
§2 的 25 條決策中，有 24 條記錄了被否決的選項。這讓後續會話（以及評審）能重建當時的判斷條件，而不是只看到結果。

### 6.2 做得不夠的三件事

**一、分析軌沒有日期戳記。**
工程軌（第 16 週起）每一步都可追溯到日期，分析軌（第 1–15 週）**全部沒有**。本日誌前十五週的週次歸屬係依推導依存關係與工作節奏**重建**，而非當時記錄。**這是流程管理的缺失，不是文件整理的問題。** 已訂正：即日起分析類文件一律於檔頭記日期。

**二、規格與實作之間缺少自動檢查，直到被咬了一口。**
F11（decision 沒發 MQTT）是規格寫對、實作漏掉，而兩者之間沒有任何檢查。`驗證資料流.py` 是**事後**才建立的。同類風險在 CAD／電路／韌體之間可能仍有殘留。

**三、採購與設計脫節，付出了一張 SD 卡的代價。**
「Pi 5 必須用官方 27W 電源」在第 16 週就寫進設計文件，但採購未跟上，第 19 週低壓重置報廢 SD 卡。**設計文件裡的「必須」若沒有對應的採購動作，等於沒寫。**

### 6.3 若重來一次會怎麼做

1. **查證階段一開始就建交叉比對表**，而非第 7 週逐份蒐集、到第 8 週才發現六份來源差 50 倍。
2. **模型建立時先做梯度可用性與可歸因性檢驗，再做精度優化**——F7（BFS）與 F4（未歸一化）都是「先做精度、後發現方向錯」。
3. **子系統的成立前提，在投入設計前先寫下來並檢查是否與問題相容**——F17（理香機構）自第 16 週設計至第 20 週移除所耗費的工時，本可用一段前提檢查省下。

---

## 附錄 A：驗證指令速查

```bash
python3 run_tests.py                          # 機構全部規則（L1 + L1b 跨層）
python3 run_tests.py -k PLA                   # 只跑名稱含 PLA 的規則
python3 CAD自檢/verify_stl.py <檔案>.stl       # 幾何層 L2
python3 外觀CAD/驗證CAD.py                     # 外觀 CAD（實際呼叫 OpenSCAD 算繪）
python3 R4/matrix_mini_r4/驗證韌體.py          # 韌體靜態檢查（門檻一致性、腳位衝突）
python3 PI5/驗證資料流.py                      # 欄位契約（韌體→pi_fsm→Grafana）

cd 電路設計/kicad
python3 產生電路圖.py                          # 含版面/佈線/格點自我檢查
python3 驗證電路圖.py                          # 結構與連通性
python3 輸出網表.py                            # 人可讀網表
KC="/mnt/c/Program Files/KiCad/10.0/bin/kicad-cli.exe"
"$KC" sch erc --severity-all 'D:\WRO2026\電路設計\kicad\incense_p0.kicad_sch'
```

**驗證分兩層且互補**：`驗證電路圖.py` 驗「檔案結構與座標連通性」（沒 KiCad 也能跑），KiCad ERC 驗「電氣語意」（非得有真工具）。**兩層都要跑。**

## 附錄 B：比賽現場上電 SOP

1. 家裡 PC：開機、**停用睡眠**、WSL 起、四容器跑、Tailscale 在線（雲端展示的單點依賴）
2. 手機：熱點開啟並**保持喚醒**；手機 Tailscale App 連線（備援看板用）
3. 現場：Pi 插電 → 等約 90 秒 → **按 R4 電源鍵** → 完成（其餘全自動）
4. 評審看雲端：公開 Funnel 連結，任何裝置免安裝可開
5. 備援（家裡 PC 失聯時）：手機開 Pi 本地 Grafana（經 tailnet），**誠實標示為本地版**
6. 隨身：官方 27W 電源、備用 USB 線

## 附錄 C：假設清單與不確定性標註

> 凡標 ⚠ 者為**尚未由實測支持之假設**。依專案紅線，基於這些數值的任何結果在報告中**只能稱「設計目標」，不得寫成實測結果**。

| 參數 | 取值 | 性質 |
|---|---|---|
| 殿內 PM2.5 均值 | 97 µg/m³ | Hien 等（2022）實測 |
| 戶外背景 | 20 µg/m³ | ⚠ **保守假設，須現場同步量測** |
| 爐口近場濃度 | 1,360 µg/m³ | 蘇大成（2015）峰值；**非同儕審查** |
| 殿堂體積 | 500 m³ | ⚠ 假設值 |
| 自然換氣 | 3 ACH | ⚠ 假設值（**結果對此不敏感**，見第 13 週） |
| 單支香排放因子 | 10 mg PM2.5/支 | ⚠ **文獻量級 7–200 mg，跨度 29 倍，待自行實驗** |
| 單支燃燒時間 | 45 min | 常見線香 |
| 反推等效源強 | 8.7 支同時燃燒 | 自洽性檢查通過 |
| 我國 PM2.5 標準 | 35 µg/m³ | 法規 |
| WHO 24h 指引值 | 15 µg/m³ | **本系統不可達（低於背景）** |
| $h_{min}$（儀式要求之可見煙柱下限） | **未知** | ⚠ **由廟方認定，須訪談（D31 拆分後不再由團隊暫定）** |
| $h_{spec}$（本機保證之可見煙柱高度） | 0.18 m | 團隊規格值（D31／D33，保 11% 裕度） |
| SPL$_{max}$ | 45 dBA | ⚠ 暫定值 |
| MATRIX_W/D | 90 × 70 mm | ⚠ 官方未公佈尺寸，估值 |
| 特性曲線 η(u,N)／h(u)／SPL(u) | — | ⚠ **全部為假設曲線，實機量測後須重算第 14 週之分析** |

**三條資料誠實邊界（引用時必須註明）：**

1. `aroma01` 在 **2026-08-08 01:15（台北）之前**的 InfluxDB 歷史（2026-07-30 起）是**模擬器資料**。
2. `aroma01` 實測資料有**兩段**（08-08〜08-09 雲端；08-10 起 Pi 本地新棧），中間有**斷層**。補傳資料時間戳為**到達時間**。
3. `aroma02` **全程為模擬機**，任何展示、報告、簡報都必須明確標示。

## 附錄 D：主要引用文獻（APA 第 7 版；2026-08-16 全面補齊）

> 逐筆經網路查證後補齊（查證紀律同 D6）。仍缺欄位者以 ⚠ 標註——
> 全清單 23 筆僅餘 3 個小缺口（[3] 完整作者欄、[12] 卷期頁碼、[15] 作者欄）。

**健康與流行病學**

1. Friborg, J. T., Yuan, J.-M., Wang, R., Koh, W.-P., Lee, H.-P., & Yu, M. C. (2008). Incense use and respiratory tract carcinomas: A prospective cohort study. *Cancer, 113*(7), 1676–1684. https://doi.org/10.1002/cncr.23788
2. Tang, H. W., Voon, F. L., & Sim, E. U. H. (2024). Association between incense burning and the risk of lung cancer in Asian population: Meta-analysis of nine case–control studies. *Cancer Reports, 7*(12), e70095. https://doi.org/10.1002/cnr2.70095
3. Hien, T. T., et al. (2022). Characterization of particulate matter (PM1 and PM2.5) from incense burning activities in temples in Vietnam and Taiwan. *Aerosol and Air Quality Research, 22*(11), 220193. https://doi.org/10.4209/aaqr.220193 ⚠完整作者欄待補
4. Pan, A., Clark, M. L., Ang, L.-W., Yu, M. C., Yuan, J.-M., & Koh, W.-P. (2014). Incense use and cardiovascular mortality among Chinese in Singapore: The Singapore Chinese Health Study. *Environmental Health Perspectives, 122*(12), 1279–1284. https://doi.org/10.1289/ehp.1307662
5. Geng, T.-T., Jafar, T. H., Yuan, J.-M., & Koh, W.-P. (2019). Long-term incense use and the risk of end-stage renal disease among Chinese in Singapore: The Singapore Chinese Health Study. *BMC Nephrology, 20*, Article 9. https://doi.org/10.1186/s12882-018-1186-9
6. Lin, T.-C., Krishnaswamy, G., & Chi, D. S. (2008). Incense smoke: Clinical, structural and molecular effects on airway disease. *Clinical and Molecular Allergy, 6*, Article 3. https://doi.org/10.1186/1476-7961-6-3 （原誤植為 IJERPH，已更正）
7. Yadav, V. K., Malik, P., Tirth, V., Khan, S. H., Yadav, K. K., Islam, S., Choudhary, N., Inwati, G. K., Arabi, A., Kim, D.-H., & Jeon, B.-H. (2022). Health and environmental risks of incense smoke: Mechanistic insights and cumulative evidence. *Journal of Inflammation Research, 15*, 2665–2693. https://doi.org/10.2147/JIR.S347489
8. International Agency for Research on Cancer. (2016). *Outdoor air pollution* (IARC Monographs on the Evaluation of Carcinogenic Risks to Humans, Vol. 109). ⚠「戶外空氣」限定詞仍待逐字核對（§5.3）

**廟宇與場域實測**

9. Zhang, J., Chen, W., Li, J., Yu, S., & Zhao, W. (2015). VOCs and particulate pollution due to incense burning in temples, China. *Procedia Engineering, 121*, 992–1000.
10. Bootdee, S., Chantara, S., & Prapamontol, T. (2016). Determination of PM2.5 and polycyclic aromatic hydrocarbons from incense burning emission at shrine for health risk assessment. *Atmospheric Pollution Research, 7*(4), 680–689. https://doi.org/10.1016/j.apr.2016.03.002

**排放因子與化學組成（化學軌）**

11. Jetter, J. J., Guo, Z., McBrian, J. A., & Flynn, M. R. (2002). Characterization of emissions from burning incense. *Science of the Total Environment, 295*(1–3), 51–67.
12. Wang, B., Lee, S. C., & Ho, K. F. (2006). Chemical composition of fine particles from incense burning in a large environmental chamber. *Atmospheric Environment*. ⚠卷期頁碼待補 https://www.sciencedirect.com/science/article/abs/pii/S1352231006007849
13. Ofodile, J., Alves, M. R., Liang, Y., Franklin, E. B., Lunderberg, D. M., Ivey, C. E., Singer, B. C., Nazaroff, W. W., & Goldstein, A. H. (2024). Characterizing PM2.5 emissions and temporal evolution of organic composition from incense burning in a California residence. *Environmental Science & Technology*. https://doi.org/10.1021/acs.est.3c08904
14. Lui, K. H., Bandowe, B. A. M., Ho, S. S. H., Chuang, H.-C., Cao, J.-J., Chuang, K.-J., Lee, S.-C., Hu, D., & Ho, K. F. (2016). Characterization of chemical components and bioreactivity of fine particulate matter (PM2.5) during incense burning. *Environmental Pollution, 213*, 524–532.
15. Fragrance, volatile organic compound, and particulate matter emissions from incense burning: Observations and risk assessments for household rooms and temples in Japan. (2024). *Atmospheric Environment*. ⚠作者欄待補 https://www.sciencedirect.com/science/article/abs/pii/S1352231024006058
16. Varuvel, G. J., Selvan, T., & Palaniyappan, K. (2022). Preferential use of bamboos for industrial production of incense sticks. *Environmental Sciences Proceedings, 13*(1), Article 7.

**方法學與模擬環境參數（AI 訓練軌，對照 `AI訓練/文獻參數.md`）**

17. ASHRAE. (2016). *ANSI/ASHRAE Standard 110-2016: Methods of testing performance of laboratory fume hoods*. American Society of Heating, Refrigerating and Air-Conditioning Engineers.
18. Persily, A., & de Jonge, L. (2017). Carbon dioxide generation rates for building occupants. *Indoor Air, 27*(5), 868–879. https://doi.org/10.1111/ina.12383
19. Morton, B. R., Taylor, G. I., & Turner, J. S. (1956). Turbulent gravitational convection from maintained and instantaneous sources. *Proceedings of the Royal Society of London. Series A, 234*(1196), 1–23. https://doi.org/10.1098/rspa.1956.0011
20. Heskestad, G. (1984). Engineering relations for fire plumes. *Fire Safety Journal, 7*(1), 25–32.
21. Thatcher, T. L., Lai, A. C. K., Moreno-Jackson, R., Sextro, R. G., & Nazaroff, W. W. (2002). Effects of room furnishings and air speed on particle deposition rates indoors. *Atmospheric Environment, 36*(11), 1811–1819.
22. Kelly, K. E., Whitaker, J., Petty, A., Widmer, C., Dybwad, A., Sleeth, D., Martin, R., & Butterfield, A. (2017). Ambient and laboratory evaluation of a low-cost particulate matter sensor. *Environmental Pollution, 221*, 491–500.
23. Sayahi, T., Butterfield, A., & Kelly, K. E. (2019). Long-term field evaluation of the Plantower PMS low-cost particulate matter sensors. *Environmental Pollution, 245*, 932–940.

**官方統計與一手資料（非期刊）**

- 行政院環境保護署（現環境部）（2016）。**民國 105 年全國焚香量統計**〔線香約 2.1 萬公噸〕。
- Government of India, Ministry of Commerce and Industry.（2017）。**Incense sticks (agarbatti) export statistics, FY2012–FY2016**〔五年約 4.98 億美元〕。
- 公共電視（2015）。台大公衛團隊龍山寺殿內 PM2.5 實測報導〔1,360 µg/m³，動機性引用，非同儕審查〕。
- 蘇大成（2015）。龍山寺空品量測〔⚠ 正式論文版本待查，§5.3〕。

---

*本日誌以**週**為紀錄單位持續增補。新增週次請維持「平日／假日／本週產出／紀錄要點」四段結構；分析類條目請於**當週**記錄日期，勿再事後重建。*
