feihong9487/WRO2026/簡報/Manus包_三張A1海報/II_solution_v2_CMYK.pdf

# 把煙抓在爐口

## 產生端是信仰，動不得。所以我們不禁香、不換爐，在既有

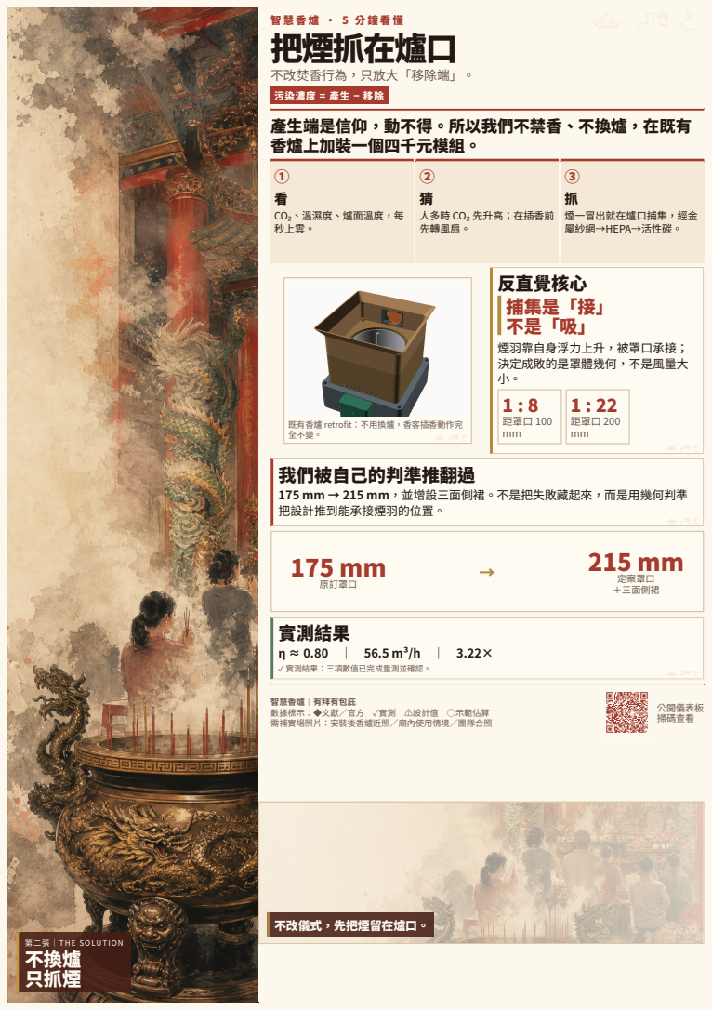
[picture p133: page 1]
第 二 張 ｜ T H E S O LU T I O N 不換爐 只抓煙; 不改儀式，先把煙留在爐口。; 智 慧 香 爐 · 5 分 鐘 看 懂 不改焚香行為，只放大「移除端」。 污染濃度 = 產生 − 移除 香爐上加裝一個四千元模組。 ① 看 CO₂、溫濕度、爐面溫度，每 秒上雲。; ③ 抓 煙一冒出就在爐口捕集，經金 屬紗網→HEPA→活性碳。; 1 : 22 距罩口 200 mm; 定案罩口 ＋三面側裙; 公開儀表板 掃碼查看

人多時 CO₂ 先升高；在插香前
先轉風扇。
反直覺核心
捕集是「接」
煙羽靠自身浮力上升，被罩口承接；
決定成敗的是罩體幾何，不是風量大
距罩口 100
原訂罩口
實測結果
✓ 實測結果：三項數值已完成量測並確認。
智慧香爐｜有拜有包庇
數據標示：◆文獻／官方　✓實測　⚠設計值　○示範估算
需補實場照片：安裝後香爐近照／廟內使用情境／團隊合照

既有香爐 retrofit：不用換爐，香客插香動作完
全不變。
我們被自己的判準推翻過
175 mm → 215 mm，並增設三面側裙。不是把失敗藏起來，而是用幾何判準
把設計推到能承接煙羽的位置。
