feihong9487/WRO2026/簡報/Manus包_三張A1海報/III_impact_v2_CMYK.pdf

# 四千元，讓中小廟也做得到

### 問題可複製，解法就可複製；而且原型已經在跑。

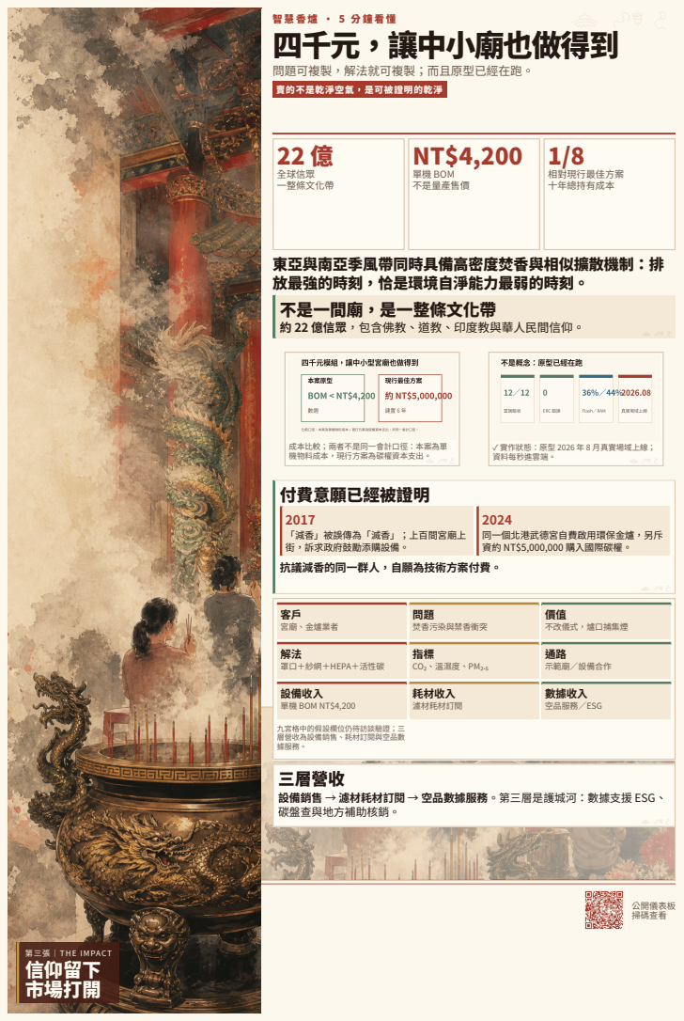
[picture p134: page 1]
第 三 張 ｜ T H E I M PACT 信仰留下 市場打開; 賣的不是乾淨空氣，是可被證明的乾淨 22 億 全球信眾 一整條文化帶; NT$4,200 單機 BOM 不是量產售價; 1/8 相對現行最佳方案 十年總持有成本; 東亞與南亞季風帶同時具備高密度焚香與相似擴散機制：排 放最強的時刻，恰是環境自淨能力最弱的時刻。 不是一間廟，是一整條文化帶 約 22 億信眾，包含佛教、道教、印度教與華人民間信仰。; 問題 焚香污染與禁香衝突; 價值 不改儀式，爐口捕集煙; 指標 CO₂、溫濕度、PM₂.₅; 通路 示範廟／設備合作; 耗材收入 濾材耗材訂閱; 數據收入 空品服務／ESG; 公開儀表板 掃碼查看

成本比較；兩者不是同一會計口徑：本案為單
機物料成本，現行方案為碳權資本支出。
付費意願已經被證明
「減香」被誤傳為「滅香」；上百間宮廟上
街，訴求政府鼓勵添購設備。
抗議減香的同一群人，自願為技術方案付費。
宮廟、金爐業者
罩口＋紗網＋HEPA＋活性碳
設備收入
單機 BOM NT$4,200
九宮格中的假設欄位仍待訪談驗證；三
層營收為設備銷售、耗材訂閱與空品數
據服務。
三層營收
設備銷售 → 濾材耗材訂閱 → 空品數據服務。第三層是護城河：數據支援 ESG、
碳盤查與地方補助核銷。

✓ 實作狀態：原型 2026 年 8 月真實場域上線；
資料每秒進雲端。
同一個北港武德宮自費啟用環保金爐，另斥
資約 NT$5,000,000 購入國際碳權。
