feihong9487/WRO2026/簡報/Manus包_三張A1海報/I_problem_v2_CMYK.pdf

# 廟裡空氣超標近 3 倍

## 不是要人別拜，而是把煙留在爐口解決。

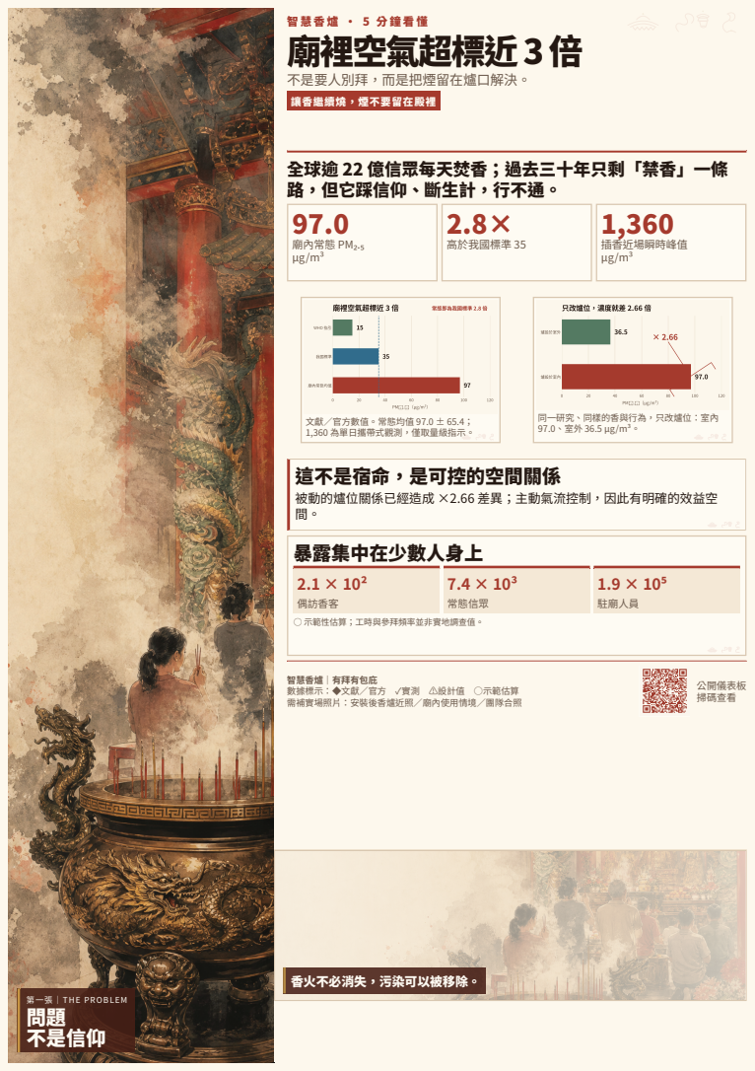
[picture p136: page 1]
第 一 張 ｜ T H E P R O B L E M 問題 不是信仰; 香火不必消失，污染可以被移除。; 2.8× 高於我國標準 35; 1,360 插香近場瞬時峰值 µg/m³; 7.4 × 10³ 常態信眾; 1.9 × 10⁵ 駐廟人員; 公開儀表板 掃碼查看

讓香繼續燒，煙不要留在殿裡
全球逾 22 億信眾每天焚香；過去三十年只剩「禁香」一條
路，但它踩信仰、斷生計，行不通。
廟內常態 PM₂.₅

同一研究、同樣的香與行為，只改爐位：室內

文獻／官方數值。常態均值 97.0 ± 65.4；
1,360 為單日攜帶式觀測，僅取量級指示。
這不是宿命，是可控的空間關係
被動的爐位關係已經造成 ×2.66 差異；主動氣流控制，因此有明確的效益空
暴露集中在少數人身上
偶訪香客
○ 示範性估算；工時與參拜頻率並非實地調查值。

智慧香爐｜有拜有包庇
數據標示：◆文獻／官方　✓實測　⚠設計值　○示範估算
需補實場照片：安裝後香爐近照／廟內使用情境／團隊合照
