feihong9487/WRO2026/簡報/Manus包_三張A1海報/II_solution_v2_CMYK (1).pdf

# 把煙抓在爐口

## 產生端是信仰，動不得。所以我們不禁香、不換爐，

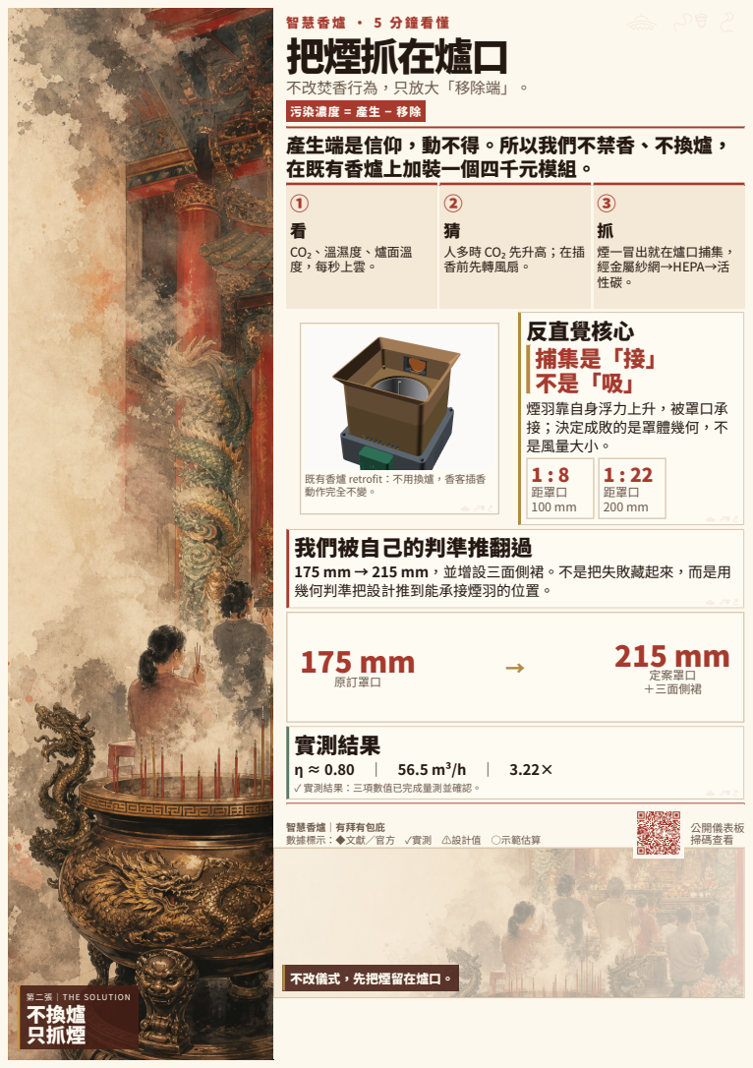
[picture p137: page 1]
第 二 張 ｜ T H E S O LU T I O N 不換爐 只抓煙; 不改儀式，先把煙留在爐口。; 智 慧 香 爐 · 5 分 鐘 看 懂 不改焚香行為，只放大「移除端」。 污染濃度 = 產生 − 移除 在既有香爐上加裝一個四千元模組。 ① 看 CO₂、溫濕度、爐面溫 度，每秒上雲。; ② 猜 人多時 CO₂ 先升高；在插 香前先轉風扇。; ③ 抓 煙一冒出就在爐口捕集， 經金屬紗網→HEPA→活 性碳。 反直覺核心 捕集是「接」 不是「吸」 煙羽靠自身浮力上升，被罩口承 接；決定成敗的是罩體幾何，不 是風量大小。 1 : 8 距罩口 100 mm; 1 : 22 距罩口 200 mm; 175 mm 原訂罩口; 定案罩口 ＋三面側裙; 實測結果 η ≈ 0.80 ｜ 56.5 m³/h ｜ 3.22× ✓ 實測結果：三項數值已完成量測並確認。 智慧香爐｜有拜有包庇 數據標示：◆文獻／官方 ✓實測 ⚠設計值 ○示範估算; 公開儀表板 掃碼查看

既有香爐 retrofit：不用換爐，香客插香
動作完全不變。
我們被自己的判準推翻過
175 mm → 215 mm，並增設三面側裙。不是把失敗藏起來，而是用
幾何判準把設計推到能承接煙羽的位置。
