feihong9487/WRO2026/電路設計/kicad/incense_p0.kicad_sch

## KiCad design 電路設計/kicad/incense_p0.kicad_sch (2026-08-16)

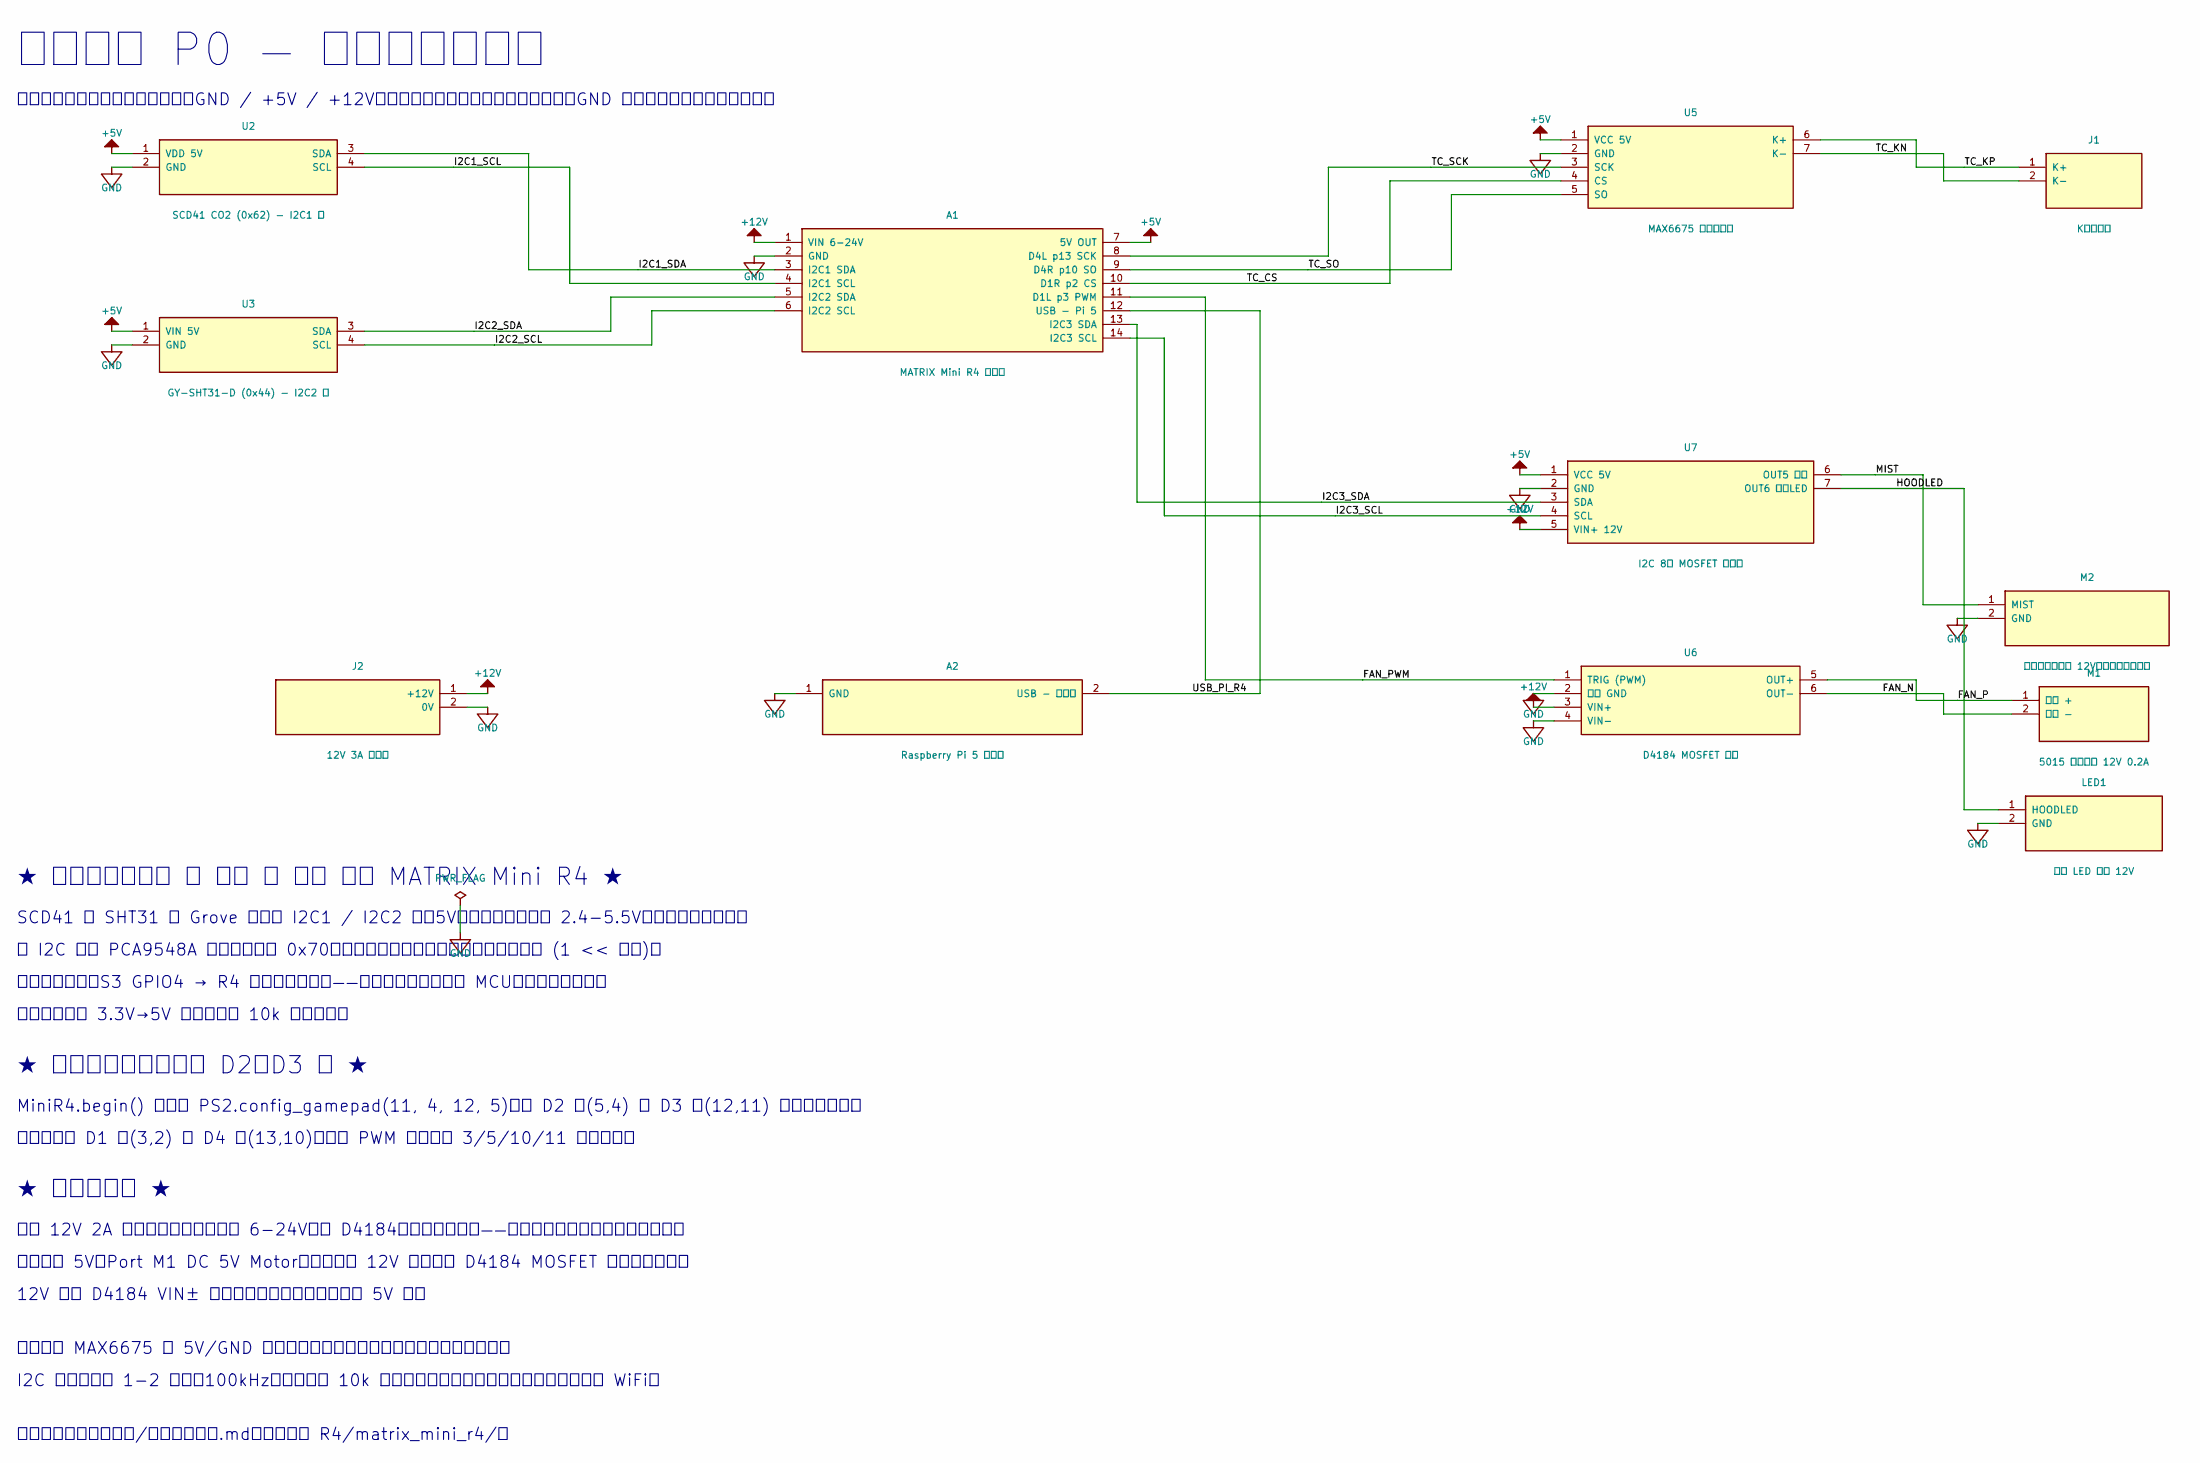
[picture p139: schematic incense_p0.kicad_sch]

Parts:
A1: MATRIX Mini R4 控制器
A2: Raspberry Pi 5 決策層
J1: K型熱電偶
J2: 12V 3A 變壓器
LED1: 罩內 LED 側光 12V
M1: 5015 渦輪風扇 12V 0.2A
M2: 超音波霧化模組 12V（冷霧，無明火）
U2: SCD41 CO2 (0x62) - I2C1 埠
U3: GY-SHT31-D (0x44) - I2C2 埠
U5: MAX6675 熱電偶介面
U6: D4184 MOSFET 模組
U7: I2C 8路 MOSFET 驅動板

Connections:
+5V: A1.7 (5V OUT), U2.1 (VDD 5V), U3.1 (VIN 5V), U5.1 (VCC 5V), U7.1 (VCC 5V)
+12V: A1.1 (VIN 6-24V), J2.1 (+12V), U6.3 (VIN+), U7.5 (VIN+ 12V)
FAN_N: M1.2 (黑線 -), U6.6 (OUT-)
FAN_P: M1.1 (紅線 +), U6.5 (OUT+)
FAN_PWM: A1.11 (D1L p3 PWM), U6.1 (TRIG (PWM))
GND: A1.2 (GND), A2.1 (GND), J2.2 (0V), LED1.2 (GND), M2.2 (GND), U2.2 (GND), U3.2 (GND), U5.2 (GND), U6.2 (訊號 GND), U6.4 (VIN-), U7.2 (GND)
HOODLED: LED1.1 (HOODLED), U7.7 (OUT6 罩內LED)
I2C1_SCL: A1.4 (I2C1 SCL), U2.4 (SCL)
I2C1_SDA: A1.3 (I2C1 SDA), U2.3 (SDA)
I2C2_SCL: A1.6 (I2C2 SCL), U3.4 (SCL)
I2C2_SDA: A1.5 (I2C2 SDA), U3.3 (SDA)
I2C3_SCL: A1.14 (I2C3 SCL), U7.4 (SCL)
I2C3_SDA: A1.13 (I2C3 SDA), U7.3 (SDA)
MIST: M2.1 (MIST), U7.6 (OUT5 霧化)
TC_CS: A1.10 (D1R p2 CS), U5.4 (CS)
TC_KN: J1.2 (K-), U5.7 (K-)
TC_KP: J1.1 (K+), U5.6 (K+)
TC_SCK: A1.8 (D4L p13 SCK), U5.3 (SCK)
TC_SO: A1.9 (D4R p10 SO), U5.5 (SO)
USB_PI_R4: A1.12 (USB - Pi 5), A2.2 (USB - 控制器)

Notes on the sheet:
智慧香爐 P0 — 兩板系統電路圖
訊號以導線直接連接；電源網路（GND / +5V / +12V）採電源符號，同名符號即同一網路（GND 接點多，拉線會過於雜亂）。
★ 合併架構：感測 ＋ 安全 ＋ 致動 同在 MATRIX Mini R4 ★
SCD41 與 SHT31 以 Grove 線直插 I2C1 / I2C2 埠（5V，兩顆晶片皆支援 2.4-5.5V，不需電平轉換）。
各 I2C 埠經 PCA9548A 多工器（位址 0x70）彼此獨立，韌體存取前需切通道：寫入 (1 << 通道)。
原三板架構的「S3 GPIO4 → R4 警報線」已取消——感測與安全同在一顆 MCU，不需跨板訊號，
連帶不再需要 3.3V→5V 電平轉換與 10k 下拉電阻。
★ 腳位限制：不可使用 D2、D3 埠 ★
MiniR4.begin() 內執行 PS2.config_gamepad(11, 4, 12, 5)，把 D2 埠(5,4) 與 D3 埠(12,11) 佔為手把介面。
本設計僅用 D1 埠(3,2) 與 D4 埠(13,10)；風扇 PWM 必須落在 3/5/10/11 其中之一。
★ 電源與共地 ★
一顆 12V 2A 同時餵控制器（板子吃 6-24V）與 D4184，共地自動成立——省去原設計最易翻車的地線母排。
馬達埠是 5V（Port M1 DC 5V Motor），推不動 12V 風扇，故 D4184 MOSFET 模組必須保留。
12V 僅進 D4184 VIN± 與控制器電源輸入，不可碰到 5V 排。
感測器與 MAX6675 的 5V/GND 實體上隨埠線一同供給，圖上以電源符號表示。
I2C 線長上限約 1-2 公尺（100kHz、模組內建 10k 上拉）；感測頭若需更遠，改回三板架構走 WiFi。
完整驗算見《電路設計/電氣驗證計算.md》；韌體見 R4/matrix_mini_r4/。
