feihong9487/WRO2026/(commit log)

2026-08-01 初始版控：智慧香爐專案基線
    涵蓋雲端監測（已上線）、電控韌體（待燒錄）、機構與外觀設計三個子系統。
    本次同時修復自檢框架的 6 個斷點：
    - 還原遺失的 CAD自檢 四支程式（mech_params / test_mech_design /
    verify_stl / test_integration）
    - verify_stl.py 改為純標準函式庫實作，不再依賴裝不了的 trimesh
    - 新增 CLAUDE.md（auto_loop.sh 與 stop_gate.sh 引用的 §5.2 紅線、§9 卡關格式）
    - 新增 run_tests.py 取代裝不了的 pytest
    - 修 stop_gate.sh：原本把關不存在的 test_fsm_core.py，閘門形同虛設
    - 修 settings.json 的 PostToolUse 指令
    已知 4 項測試失敗，皆為需人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
2026-08-01 納入硬體設計交接文件，並依核心範圍分級驗證
    - 讀入《智慧香爐_硬體設計交接》（完整設計，暫不實作）
    - 更正 TC_MOUNT_LOCATION：依交接文件 §7 為「爐面上方 2-3cm 懸空」，
    先前誤填「爐盆外壁」為我自行假設
    - mech_params.py 宣告 MILESTONE 與 SCOPE_CORE / SCOPE_LATER
    - run_tests.py 支援 --scope（預設仍跑全部，非略過測試）
    核心範圍（P0/P1）：12 條規則、11 過 1 敗
    完整範圍：36 條規則、32 過 4 敗
2026-08-01 決策 B：聯鎖門檻由 80/60 提高為 150/130（臨時值）
    背景：交接文件 §7 把熱電偶懸於爐面上方 2-3cm，該處預估 120°C（未實測）。
    原 80°C 門檻低於正常工作溫度，一點香就會持續觸發聯鎖、風扇鎖死在 0
    （聯鎖優先權高於一切）。依使用者決策採方案 B。
    取值：T_LOCK 150 = 預估常態 120 + 30°C 餘裕
    T_RELEASE 130 = 高於常態，聯鎖後回到常態即可解除
    同步範圍：正式韌體、Wokwi 模擬、舊三板韌體、mech_params、
    P0 指南、外觀 CAD、設計說明、專案進度
    防遺忘機制（新增 2 條測試）：
    - test_韌體聯鎖門檻需與參數檔同步：防止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
2026-08-01 修正集煙罩投香口被封死的 bug；驗證器加入算繪出圖
    ★ 這個 bug 是「看得到模型」才發現的 ★
    hood() 的內腔切除面停在 HOOD_H，與外殼頂面共平面，
    結果不是切穿而是留下退化頂蓋——投香口封死，香插不進去。
    參數檢查與 Volumes=2 都判定通過，因為封起來的罩子
    仍是合法的單一 manifold 實體。
    修法：內腔沿同一錐度上下各延伸 2mm，確實切穿。
    同時新增：
    - incense_burner.scad 加入 SECTION 剖半檢視（part="none" 供 include）
    - 驗證CAD.py 每次執行自動產出 4 張算繪圖（組裝/剖面/集煙罩剖面/列印排版）
    - 檢查器補上 OpenSCAD functi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
2026-08-01 優化 CAD 自檢 LOOP：補上組裝層級的檢查，並修正兩個真 bug
    ★ 使用者指出風扇破圖，查出根因：自檢只驗單件、從不驗組裝 ★
    新增三類檢查（都是單件檢查抓不到的）：
    F 煙道對齊 各零件開口在全域 z 是否重疊（純參數，零成本）
    H 組裝干涉 兩兩求交集量體積 → 抓「不該碰卻碰了」
    H 落座檢查 用包圍盒查間隙 → 抓「該貼合卻浮空」
    兩者方向相反：零件浮空時交集也是 0，只查干涉會誤判正常
    修正的 bug：
    1. 風扇座 30.8mm 整個埋在燃燒艙內（rotate 後 y 少推一個深度）
    2. 燃燒艙與集煙罩的煙道開口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
2026-08-02 自檢 LOOP 再優化：補上列印性、開口遮擋、回歸基準三類檢查
    新增：
    I 列印性 從 STL 法向量算懸空（不需額外算繪）
    ★套用列印方位★——集煙罩是倒著印的，用設計方位分析毫無意義
    ★區分斜向懸空與近水平橋接★——處理方式完全不同，
    混在一起會把可印的設計誤判為不可印（第一版就犯了）
    ★跨距用最大內接圓（距離變換）★——包圍盒會把 11mm 寬的
    環狀台階誤算成 175mm，內接圓才是橋接真正要跨的距離
    J 開口遮擋 功能性開口外側 12mm 淨空
    這不是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
2026-08-02 外觀CAD：鎖固改 M4、修好感測器艙、新增開口貫通檢查 L
    螺絲（依指定「鎖固一律 M4」）
    · 新增 M4_PILOT/M4_CLEAR/M4_HEAD_D/M4_ENGAGE 規格區
    · 風扇座鎖孔 3.2 → 4.5（M4 通孔）
    · 感測器艙掛耳改 M4×2，底座前壁對應加 8mm 深自攻螺柱
    · 板卡（Pi 5 ⌀2.7 / MATRIX ⌀3.2 / D4184 ⌀3.0）維持 M2.5/M3
    ——M4 桿徑 4.0mm 穿不過去，例外由板孔徑決定而非偏好
    · 新增 test_鎖固一律使用M4且例外必須有物理理由（已負向測試）
    感測器艙：三個特徵其實不存在
    掛耳與模組卡槽都寫在 difference() 的 union() 裡，被背面全開的
    內部挖空整個吃掉。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
2026-08-06 外觀CAD：拆成一零件一檔、加入外購元件模型、補上檢查 M
    檔案結構
    params.scad 所有尺寸（唯一真相來源）
    common.scad 共用輔助模組
    parts/*.scad 5 個列印件，各自可單獨開
    components/*.scad 7 個外購件模型（爐盆／R4／Pi5／D4184／5015／感測器／MAX6675）
    incense_burner.scad 組裝定位、驗證用模組、輸出分派
    零件檔用 use<> 引入（只帶模組、不執行對方頂層），所以可以自帶預覽呼叫
    ★檔名一律 ASCII★
    Windows 版 OpenSCAD 的 include/use 路徑不吃非 ASCII：中文檔名與中文目錄
    一律 "Can't open include file"，錯誤訊息本身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
2026-08-06 外觀CAD：新增 STEP 匯出器（供 Onshape）與檔案結構說明
    OpenSCAD 匯不出 STEP（網格/CSG，不是 B-rep），所以走 OCCT：
    STL → 用共用頂點／共用邊直接建拓樸 → ShapeFix → 合併共面 → AP214
    ★不用「逐三角形建面再縫合」★
    那條路要猜縫合容差：太緊則該共用的邊沒接起來（殼有破洞 → BRepCheck 判無效），
    太鬆則會併掉不該併的頂點。base 就是這樣壞的——OpenSCAD 那邊 Volumes=2、
    Simple=yes 全過，OCCT 卻說 invalid，兩套工具對「有效」的定義不同。
    改成由共用拓樸建構後，「相鄰面共用同一條邊」是建構出來的事實，沒有容差可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
2026-08-06 STEP 匯出：修好元件分派、爐盆細分、與 ISO 10303-21 字串編碼
    ★dispatch 的預設分支會靜默算錯東西★
    part="bowl" 之類的元件名稱在 dispatch() 沒有分支，掉進 else assembly(0)
    ——每個元件都在算整台組合件，一個爐盆跑了十幾分鐘還沒完，而且真的會
    「算得出東西，只是算的是別的東西」。
    修法：新增 part="solo"（未定位單件），匯出一律走 solo/placed ＋ PAIR_A；
    未知的 part 名稱改成 assert 失敗，不再退回組合件。
    爐盆細分參數化（BOWL_FN）
    預覽要 160 段（Ø110 用 48 段看得出稜線，是「爐面條紋」的成因之一），
    匯出時傳 -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
2026-08-06 電源預算：把「現行建置」與「完整設計」分開，並補上現行配置的規則
    ★原本的問題★
    12V 電流檢查算的是完整廟宇爐（2 電磁鐵＋2 風扇＝1.90A），但那是 P3；
    桌上型展示機實際掛在 12V 上的只有 MATRIX R4 ＋ 1 顆風扇 ＝ 0.70A。
    用未來的負載去判現在的電源夠不夠，結論方向還是相反的——現況其實很寬裕。
    更要緊的是：★在此之前沒有任何規則在看「現在這台夠不夠」★，
    而電源不足的症狀是開風扇就重啟，屬實機階段最難查的一類故障。
    新增
    · FAN_COUNT_NOW / MAGNET_COUNT_NOW：現行實際配置（佐證見佈線定義.py）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
2026-08-06 電源：採用 3A ＋ 電磁鐵互鎖，並把「預算依賴的約束」變成可驗證的東西
    決定（2026-08-07）：12V 3A ＋ 一次只吸一顆電磁鐵
    現行建置 穩態 0.70A / 峰值 1.00A
    完整 P3 穩態 1.40A / 峰值 2.00A 可用 3.0A×80% = 2.40A ✓
    ★3A 是「搭配互鎖」才夠★ 沒有互鎖峰值 2.50A > 2.40A，那時要換 4A。
    ★把相依關係做成規則，而不是寫在註解裡★
    3A 夠用的前提是互鎖，而互鎖屬 P3 韌體、還沒實作。這種「帳面漂亮、
    實體在最壞情況失效」的相依最容易被遺忘，失效時又像隨機當機。
    · MAGNET_SIMULTANEOUS_MAX / MAGNET_INTERLOCK_IMPLEMENTED
    · pending_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
2026-08-06 套筒：壁厚改 1.5mm，並採 A 案把外購件換成對的可製造性尺規
    ★壁厚 1.0 → 1.5mm（外徑 10 / 內徑 7）★（2026-08-07 決定）
    外徑不變 → PLATE_HOLE_DIA、孔距、板面佈局完全不用動
    內徑 7.0 對最粗香枝 3.5mm 仍餘 3.5mm，功能零影響
    理由★不是★「讓列印規則過關」：1.0mm 壁的薄鋁管插拔時容易壓成橢圓，
    而它要在 0.4mm 間隙的孔裡滑動——橢圓化就會卡死。
    OD10×1.5 與 OD10×1.0 同為標準庫存尺寸。
    套筒質量改由幾何推導（原本 12.0g 是沒有推導過程的估值，壁厚一改就失準）：
    管身 = π/4 × (OD² − ID²) × 長度 × 鋁密度 1.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
2026-08-06 理香機構：展示尺度的插孔板與電磁鐵座（無明火展示的核心實體）
    ★為什麼先做這個★ 大會禁明火，但理香機構完全不需要火——插未點燃的香
    就能演示「歪香 → 電磁鐵吸套筒底部鐵墊圈 → 回正」。它直接對應作品最硬的
    技術論述（歪香擠成一團 → 悶燒 → CO 暴增而 CO2 持平），而且是自製件，
    比買一台霧化機有說服力。
    新增兩個列印件（分開比做成單一複雜件好印，且符合 M4 鎖固要求）
    parts/socket_plate.scad 插孔板 ⌀84×6，2×2 孔 ⌀10.8
    parts/magnet_deck.scad 電磁鐵座，凹槽朝上，電磁鐵由上放入再鎖上板子
    compone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
2026-08-06 CO2 分級：門檻改為相對背景基線（絕對門檻在展場會讓分級完全失效）
    ★問題★ FSM 門檻全是絕對值，但背景 CO2 差異很大：
    安靜的廟宇清晨 ~450ppm ｜ 人多的展場大廳 1000–2000ppm
    在會場的後果：
    CO2_IDLE=600 → 背景就超過，★S0 永遠到不了★
    T1=900 → 背景就超過，★永遠卡在 S2★
    分級響應會完全看不出來——而分級正是這個作品要展示的東西。
    （廟宇實裝也一樣：季節、通風、時段都會讓背景漂移。）
    ★修法★ S0/S1/S2 門檻改為「基線 ＋ delta」，R4 與 Pi 兩層同步：
    基線 ＝ 過去 10 分鐘內「每分鐘最小值」的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
2026-08-07 無明火展示機：組態化、I²C 致動、霧化模組（三項決策一次落地）
    ★決策 1：電磁鐵驅動 → I²C 四通道 MOSFET 板（PCF8574）★
    比較過所有可行方案：R4 可用腳（D1/D4 共 4 支）已全滿，D2/D3 被
    MiniR4.begin() 的 PS2 佔走；不呼叫 begin() 會失去 OLED（韌體正在用）；
    改由 Pi 5 驅動會讓致動離開 R4，破壞逐級降級的分層；74HC595 仍需 3 支腳。
    關鍵：0.5A 電磁鐵本來就不能由 MCU 腳直驅，MOSFET 板無論如何都要買——
    選 I²C 版增量成本趨近於零，卻同時解掉腳位。
    ★結構性好處★：互鎖變成「送出的位元組至多一個 bit 為 1」，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
2026-08-07 文件：補上理香機構、霧化模組與無明火展示機的說明
2026-08-07 STEP 匯出：加入理香機構與霧化，並修好三個「驗證本身出錯」
    匯出內容（21 檔、58MB，全部通過獨立複驗）
    7 個列印件：底座／燃燒艙／集煙罩／風扇座／感測器艙／★插孔板／電磁鐵座★
    13 個外購件：爐盆／R4／Pi5／D4184／5015／SCD41／SHT31／MAX6675／熱電偶探頭
    ★導正套筒x4／電磁鐵x4／超音波霧化模組／罩內LED側光★
    1 個組合件：26 個實體、1,372,672mm³、AP214、單位 mm、中文名稱可還原
    ★這輪修的三個都是「檢查本身錯」，不是設計錯★
    1. 驗證假設「一個具名零件＝一個實體」——導正套筒與電磁鐵各是 4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
2026-08-07 插孔板改版：梅花五孔＋孔口導引喇叭，STEP 全套重匯
    回應觀感問題「4 孔 2×2 像插頭不像香爐」：
    - 四個主動格中央加一個★被動★導引孔（無電磁鐵）——中心是 ⌀84 板上
    唯一塞得下第 5 孔的位置（離四顆 ⌀25 磁鐵邊 6.1mm；外圈任何角度
    都會撞 M4 螺柱或擦到磁鐵，只差 0.2mm）
    - 每個孔口加淺錐導引喇叭（徑向 1.5、深 2.0，錐面 36.9° 免支撐）——
    插香不必對準孔軸，把「亂插是必然」的行為門檻降到硬體層
    - 套筒 4 → 5 支（同一料號，不增 BOM 品項）
    配套：
    - 驗證CAD.py 參數解析器補 true/false（TIDY_CENTER_HOLE 是首個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
2026-08-07 兩項定案落地：產品定位（retrofit 主打）＋兩板架構（刪三板殘留）
    定位（2026-08-07 拍板，交接文件新增 §0）：
    - 商業主打＝既有香爐的空品監測＋抽排過濾改裝模組——不換爐、
    不改信眾行為；理香機構降為競賽 PoC 展示與未來選配
    - 理由：插孔板與「隨手插進香灰」的真實行為不相容、尖峰香量遠超
    任何格數；而在插孔板成立的減香情境裡，悶燒擠香問題本身大幅消失
    - 競賽展示不受影響：理香仍是「偵測→分類→主動致動」閉環的主秀
    兩板定案（使用者確認不留三板退路）：
    - 刪除 ESP32/s3_sensor_node、R4/r4_actuator_no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
2026-08-07 真爐上線：R4 燒錄完成、Pi5 佈建為 aroma01，資料鏈全通
    韌體側（2026-08-08）：
    - 編譯卡在 MatrixMiniR4 ≤1.2.5 與 Adafruit BusIO 的連結衝突
    （該庫把 Adafruit_I2CDevice 整類抄進自家，10 個符號重複定義）——
    已在使用者函式庫以 __has_include 讓位補丁修復，坑記入 CLAUDE.md §4
    - 燒錄 UNO R4 WiFi 成功，實機序列輸出 17 欄位 telemetry 驗證通過
    部署側（詳見部署紀錄.md 附錄）：
    - Pi5 經 Tailscale SSH 佈建（provision.sh 六步驟），先以 aroma03
    驗證端到端，再依使用者決定改名 aroma01：停 aroma01 模擬器、
    清除 aroma03（InfluxDB 6,587 筆歸零＋MQTT 帳號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
2026-08-09 設計說明全面重寫：對齊無明火展示機現況，補理香機構完整原理
    取代 2026-08-06 版。舊版有三處已不是事實：沒有理香機構與霧化、
    列印件寫 5 件、還寫著「幾何尚未算繪確認」（現在算繪驗證全綠）。
    新版內容：
    - 定位聲明開篇：無明火展示機、理香＝競賽 PoC、商業＝retrofit（§0）；
    「展示不點火，但機器不是道具」——結構仍按真火情境設計
    - 剖面圖更新：理香機構落座、霧化模組與水位、冷霧抽吸路徑；
    修正集煙罩畫反的形狀（實際是下寬上收）
    - 理香機構三節：梅花五孔俯視圖（依實際尺寸等比）、側視三步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
2026-08-11 NVMe 遷移+比賽現場模式落地:SD 卡除役、致動段三處真 bug 修復
    - Pi5:SD 卡讀取層退化除役,aroma01 角色移植到 NVMe(Pironman 5);
    冷開機全自動就緒實測通過,唯一手動步驟=R4 電源鍵(內建電池設計)
    - 比賽模式:手機熱點無條件最優先(60s 巡檢跳槽)、熱點上雲演練通過、
    看門狗 v2(查資料流非只查裝置)、udev 固定名 /dev/r4
    - 韌體:ioWrite() 補多工器通道切換(原碼致動指令會落到錯誤通道)、
    PCF8574 改 I2C3 獨佔埠(CH_PCF=2,免分接線)★待重燒錄★
    - KiCad:理香致動段 08-07 起從未成功生成——補齊 PCF/K1/M2/LED1 佈線、
    修 U6 撞名(PCF→U7)、修 K1/M2 超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
2026-08-13 筆電接手工作：DS18B20 上線韌體、pi_fsm 更新、fleet 儀表板、一分鐘講稿定稿
    自 8/11 zip 交接以來在筆電上的全部改動，
    含 .gitattributes（shell script 強制 LF，桌機 WSL 用）。
2026-08-16 AI三案訓練與凍結評比落地：B(預測+DP)全勝、圖表三件組、軟硬體優化報告書、附錄D改寫APA並補齊書目
    - AI訓練/: 三案模型(linearA/predictorB/dqnC)+訓練歷程+凍結評比結果JSON
    - 圖表/: 損失變化圖、損失比較圖(含配對差值面板)、B預測混淆矩陣
    - 軟硬體優化報告書.md: 雙級抽排等硬體8項+韌體/Pi/AI堆疊軟體優化+優先序表
    - 研究日誌: (7d)三案評比記錄、D39-D43、F34-F36、§4統計、§5.2/5.3狀態更新、
    §5.5新增待辦、§5.6資料補強清單、附錄D全面改寫為APA第7版(23筆僅餘3缺口)
2026-08-16 AI三案v2優化重訓＋每案三圖：B續全勝(10/10)、A現線性天花板、C退步如實記錄
    - 訓練A v2: 固定配置集評分(F35根治)——收斂解=永遠70，表達力天花板現形
    - 訓練B v2: λ驗證集選擇+學習曲線+反應層預算感知——Δ改善至-9,245、仍10/10
    - 訓練C v2: n-step32+DoubleDQN——勝1/10、無電18.3h/日，退步照承諾如實記錄
    - 圖表/: 每案三圖共9張(損失變化/損失比較v1vs v2配對/混淆矩陣)
    - models/: v1全數保留(*_v1.json)供對照；日誌新增(7e)節
2026-08-16 AI三案v3：2×2對照閉合——C換CEM-MLP首次過門檻(8/10)、B三連勝新低、A線性天花板三度確認
    - 訓練C v3: DQN→CEM演化小型MLP(292參數)，勝1/10→8/10、Δ-6,496——證實死因是bootstrap
    - policies.py B v3: CO2 nowcast反推香支數入DP+30分滾動重解，Δ-9,318、能耗降至3.64Wh
    - 訓練A v3: 種子注入(含日曆型候選)仍收斂回常數70——線性天花板三度重現
    - 圖表/: 9張更新，比較圖升級v1/v2/v3三代並排；models/: v2全數備份
    - 日誌(7f): 2×2對照結論（非線性有增量、bootstrap是死因、顯式最佳化居首）
2026-08-16 sim-to-real第一步：資料鏈實勘(B1已解/B11埠衝突)、真實CO2第一課、pi_fsm影子模式
    - 實勘：aroma01 CO2為1Hz真值(B1解除)；雲端棧=桌機WSL Influx 2.7.12；
    Pi 8086被Pironman5 Influx 1.12佔用(新增B11)；SSH仍拒(B2維持)
    - 真實資料重訓.py: 59小時真實樣本首驗——persistence 156 < 常數 391 < ridge 433 ppm，
    日曆模型資料量不足照實記(居家作息CO2，非廟宇負載)
    - PI5/pi_fsm.py: ShadowAdvisor影子模式(ai_duty只記錄不致動、無模型自動停用、
    0.3支訊號閾值)；ai_predictor.json部署複本；驗證資料流全過
    - 日誌(7g)+B1/B11狀態更新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
2026-08-16 影子模式實機上線：SSH金鑰打通(B2解除)、pi_fsm部署重啟、ai_duty以1Hz上雲
    - Pi(feihongPi5)公鑰安裝＋免密sudo確認；/opt/incense/ 換裝新版pi_fsm.py+ai_predictor.json
    - incense-fsm重啟成功，雲端decision measurement已見ai_duty(影子建議，未致動)
    - 日誌(7g)續報+B2銷項；fan_duty vs ai_duty實測對比資料開始自動累積
2026-08-19 簡報：插入 5–9 頁圖片（系統架構/故障安全階梯/儀表板+QR）
2026-08-20 AI線上學習:兩AI服務+守門條款+異常偵測+Grafana儀表板+外部資料驗證
2026-08-20 任務書:桌機 Claude Code 部署 ai-online 服務的執行指令
2026-08-20 部署紀錄:AI 線上學習服務上線(ai-online 容器+AI狀態儀表板)
    - ai-online 第五容器啟動,AI-1 負載預測/AI-2 異常偵測常駐自學
    - 首輪 v2 重訓通過守門條款,ai_status 落庫
    - 修正:datasource uid 實際為 dftmtpkivyadcb(任務書舊值 incense-influx 會失敗)
    - 加 PYTHONUNBUFFERED=1 解決 docker logs 空白
2026-08-20 AI儀表板:decision面板加降採樣+匯入陷阱說明
    - 「AI影子建議 vs FSM實際duty」面板查 decision(秒級),6h 資料超過公開看板
    點數上限報 too many datapoints;兩個 target 加 aggregateWindow(v.windowPeriod)
    - AI線上學習指南補匯入陷阱:API import 回報成功但佔位符不落地,公開看板全No data;
    對策=UI匯入或匯入後驗證DB無殘留;現行uid為dftmtpkivyadcb
2026-08-20 簡報:三張A1海報 Manus 生成成果與素材包、圖表腳本、修正文件
    - Manus包_三張A1海報/:指令包、現有素材、情境照、Manus 產出三張海報
    (I_problem/II_solution/III_impact_v2_CMYK.pdf)
    - 圖表腳本與 SVG:商業模式九宮格、思維發散、資料鏈實測 CO2
    - 海報修正清單_v2、減字方案、Manus指令包
    - 現場簡報插入發散圖頁、海報規劃書狀態標註
2026-08-20 回寫桌機部署經驗:PYTHONUNBUFFERED 進 compose 真相來源、任務書標記已完成+修 datasource uid
2026-08-20 部署紀錄:AI 狀態儀表板公開連結開通,16 面板公開 API 驗證有資料
2026-08-20 加速實驗:四實驗凍結協定+30分鐘粒度升級(MAE-7.7%)+文件回寫
    E2 部署版 ridge-12 勝擴充特徵與 MLP(簡單方法已足夠)
    E3 模擬先驗在居家場域幫倒忙(domain gap 實證)
    E4 故障注入靈敏度矩陣全過(門檻不動)
    服務升級 AGG_EVERY=30m,同構驗證 14 項通過
2026-08-20 AI-1優化實驗:嚴格CV證明短期資料改進是漂移伪影,不換模型
    三條路徑同一誠實結論:
    - 前瞻預測:naive持平最強,學習模型贏不過(簡單方法已足夠)
    - 當下nowcast:加lag只重複已有實測,零新資訊
    - 日曆輪廓:農曆特征看似降27%,但純線性趨勢1維即複現→證明是拟合8天
    下降漂移(CO2基線-73ppm/day)的伪影,非可泛化農曆效應
    決策:維持現役CAL-12(換=過擬合上線,違反守門條款);改進須等資料跨越
    完整農曆周期(約2月)。腳本凍結可復現。
2026-08-20 服務v5:ACH換氣率追蹤+爐溫偏差偵測+農曆自動檢驗+節奏自適應缺料率
    ACH反演:8段真實衰減中位1.21/h(居家推估,落文獻範圍)
    儀表板追加v5列8面板;驗證擴至20項全過
    訓練C_v4(算力×24)背景訓練中,評比待跑
2026-08-20 AI儀表板:圖例去除tag標籤外露(16查詢補keep)
2026-08-20 C案算力實驗終局:x24算力塌縮(v4)+熱啟動修正未過判優(v4b)→維持v3,B仍冠軍
    凍結評比恢復:B 394502 / C_v3 397323(勝日曆8/10)
    守門條款兩度擋下:塌縮版與雜訊級改善皆不上線
2026-08-21 影子AI修正:nowcast改用FSM滾動基線+部署真實資料預測器v4
    對照矩陣:凌晨背景漂移 220→70(修正目標)、真實突升不受影響
    晚間255=日曆先驗的預算排程策略,屬真實決策差異非量尺錯誤
    py_compile+同構驗證20項+煙霧測試通過;致動零影響(影子only)
2026-08-21 現場簡報:新增捕集頁+AI自我學習頁(含流程圖)+5分鐘講稿
    - 兩頁 16:9 投影片(SVG純stdlib生成):
    捕集是「接」不是「吸」(1:8/1:22+自我否證175→215)
    AI自我學習(資料飛輪流程圖+守門條款三卡)
    - 插入現場簡報第6/8頁(SYSTEM後/INTELLIGENCE後),滿版無變形
    - 講稿_5分鐘:14頁逐頁+時間分配(約5分5秒)+預期提問備答
2026-09-29 新增廟公機器人軟體：R4 合併韌體、筆電中繼、監控網站
    - R4/KEEPER_ROBOT：一塊 MATRIX Mini R4 控制循線路線表、空氣感測與熱電偶安全聯鎖、
    集煙風扇、M-Vision 與 HuskyLens，WiFi 送資料到筆電中繼；接受遠端 RUN/GO/END/CLEAR/STOP
    並回覆 A{} 結果（待命且電池 ≥ 6 V 才開始任務）
    - RELAY：筆電中繼，接替原 Pi 5：UDP 廣播讓 R4 自動找到筆電、跑 pi_fsm 的風扇決策、
    用 MQTT 經 Tailscale 上傳到桌機，並把監控網站的指令（白名單、30 秒過期）轉給 R4
    - KEEPER_WEB：廟宇風監控網站，公開展示頁免登入、團隊台要登入可操控；部署說明見 DEPLOY.md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
2026-09-29 新增 M-Vision 拍照回傳與 AI 影子建議，修正 MQTT 用戶端代號衝突
    - M-Vision 拍照：R4 靜止時每 2 秒要一張 160×120 JPEG（上限 2.9 KB），切成 base64 小段
    經 WiFi 送到筆電中繼，拼回後上傳 incense/<裝置>/photo，監控網站拿來當相機畫面底圖、疊上即時框框
    - MVISION_OFFERING/main.py：收到 'S' 就在畫框框前拍照回傳（0xAB 0x4A 格式）
    - 韌體照片緩衝區 3000 B（RAM 69%），行進中不拍照；0xAA 封包加座標範圍檢查避免誤判
    - 網站 PUBLIC_PHOTO=0 可讓公開頁不顯示照片
    - AI 影子建議：把 PI5/pi_fsm.py 的 ShadowAdvisor 搬進筆電中繼，決策紀錄恢復 ai_duty（只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
2026-09-29 加入手臂與夾爪控制、拿掉 DS18B20、背景改成裊裊煙絲
    - 手臂：RC1 夾爪上下（110/15）、RC2 抹平香灰（0/60）、RC3 灰盤（10/45）、RC4 抽風（0/60），
    DC1/DC2 夾爪馬達（2026-09-29 實測方向）；新增 ARM <動作> 指令與選單 ARM TEST，
    只在靜止時執行、STOP 可中止；RC4 抽風跟著風扇轉、行進中收回
    - 拿掉 DS18B20：韌體、中繼、網站都不再讀取或顯示 t_ds，A2 埠空出來
    - 監控網站：背景香煙改成一縷縷往上飄的煙絲；團隊帳號密碼不再限制字數
2026-09-30 HuskyLens on I2C4, measure ash from the box top edge with a trimmed mean
    - HUSKY_I2C_PORT 3 -> 4: on 2026-09-30 the HuskyLens (Protocol Type I2C)
    never acked on I2C3 but acks at 0x32 on I2C4.
    - ASH_MEASURE selects what the ash level is computed from:
    0 = box height (colour strip, as in ASH_LEVEL), 1 = box centre y,
    2 = box top edge (default). With the ash colour learned directly and the
    camera looking from above at an angle, the box barely changes height
    but moves and grows, so the top edge gives the widest empty/full span.
    - EEPROM magic is 0xA51E + ASH_MEASURE, so switching measure invalidates
    the old calibration instead of mixing units.
    - ashAvg10(): trimmed mean (drop a quart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
